llhtimlam/Probton/Media/Presentation/B18 Probton Proposal_1.pptx

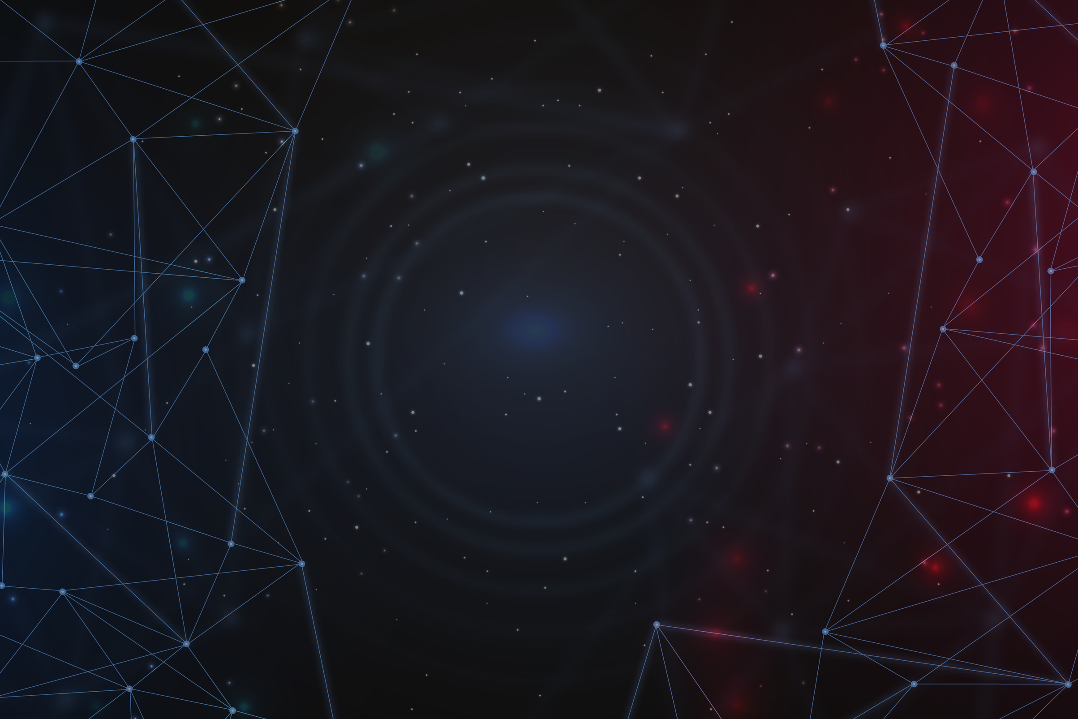
[picture p47: figure]

CHIPATON 2026 TRACK B : CIRCUITS FOR SENSOR

B18: PROBTON

ASIC Solution for Optical Probe Station for Photonic Integrated Circuits Packaging and Testing

- TEAM MEMBERS -

TIM LAM • VICTORIA TJHIN • ABRAAR ALAM
BELKACEM BENADDA • NITIN INDUKURI • REZA SETIABEKTI • ASHMITA SAHA

## Slide 2

INDUSTRY CHALLENGES

70-80% of photonics costs are from packaging, requiring costly proprietary alignment systems

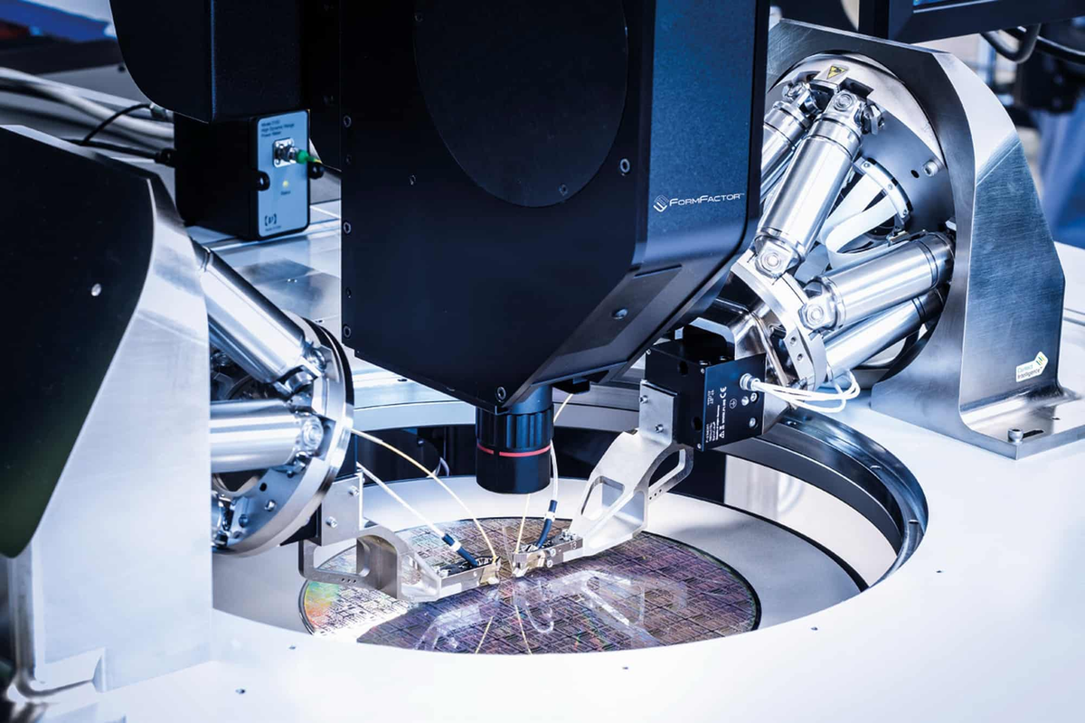
[picture p48: figure]
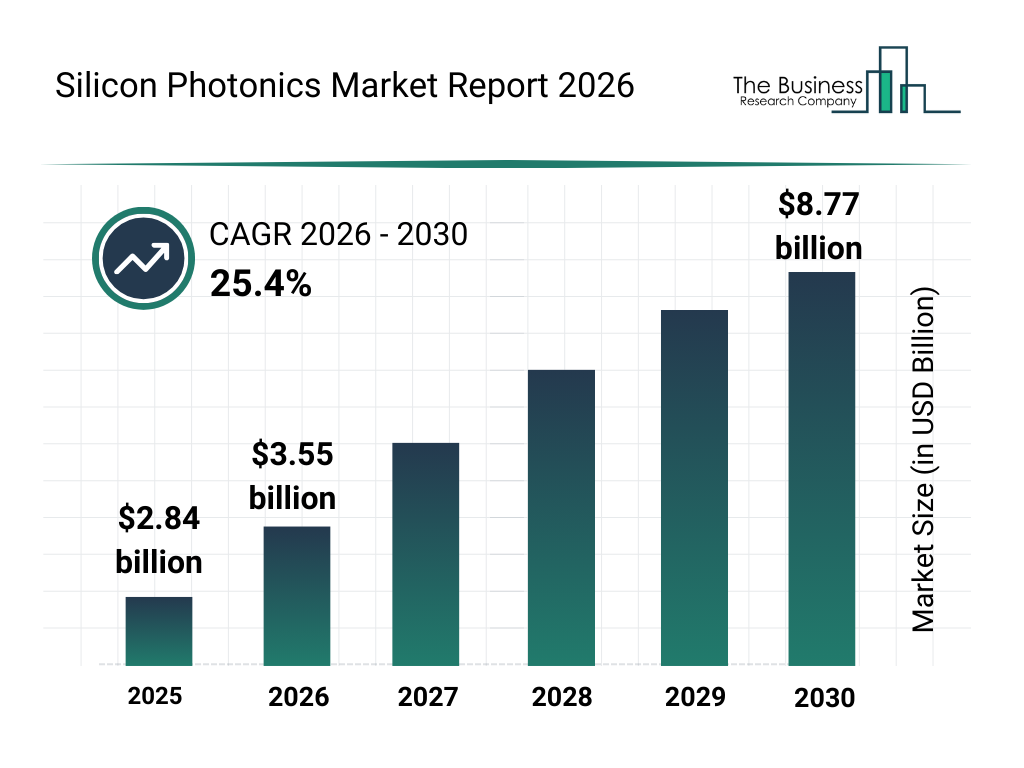
[picture p49: figure]

[2]

[1] L. Ranno et al., “Integrated Photonics Packaging: Challenges and Opportunities,” ACS photonics, vol. 9, no. 11, pp. 3467–3485, Oct. 2022, doi: https://doi.org/10.1021/acsphotonics.2c00891.
[2] The Business Research Company, “Silicon Photonics Market Report 2026,” Jan. 2026. Available: https://www.thebusinessresearchcompany.com/report/silicon-photonics-global-market-report

[1]

Page 2

## Slide 3

VALUE PROPOSITION

Budget build

<$5k

2

Open
source

Custom setup

4

Democratize
proprietary alignment
feedback
systems

1

5.7

<μm

steps to align

precision

3

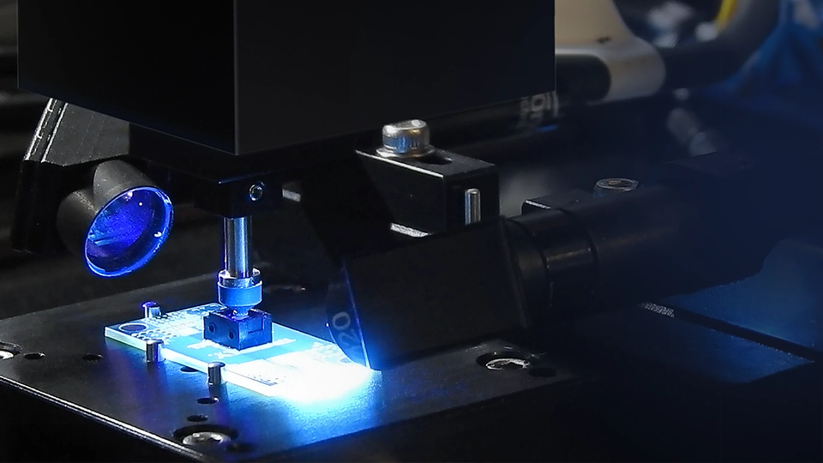
[picture p50: figure]
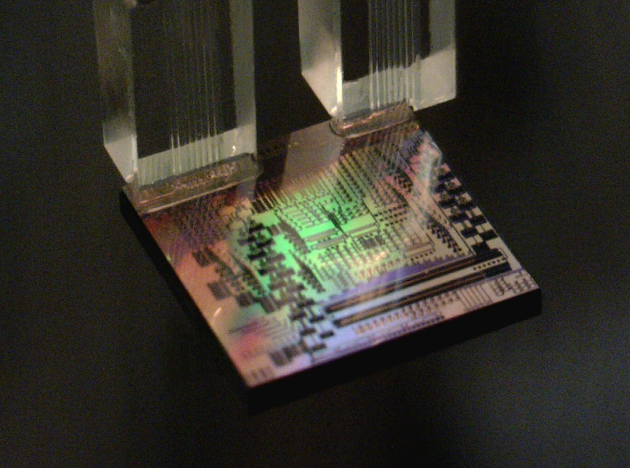
[picture p51: figure]

## Slide 4

SETUP

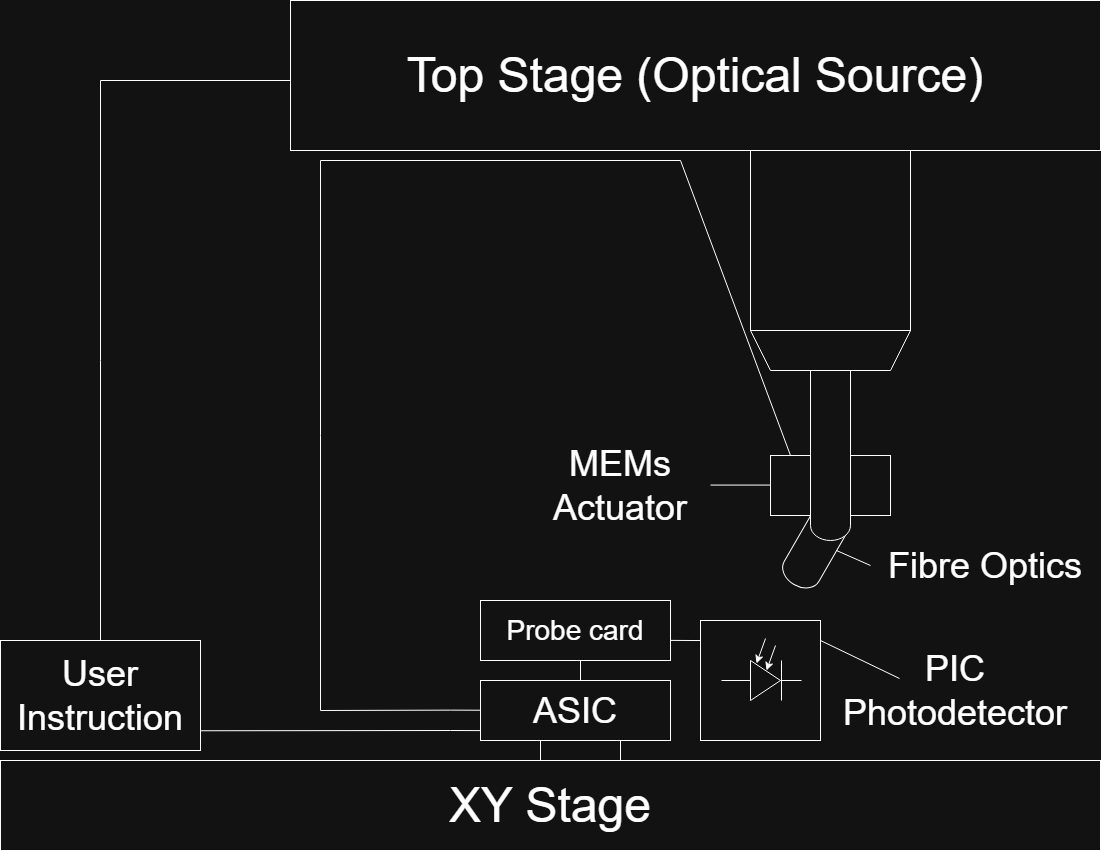
[picture p52: figure]

## Slide 5

TEST SETUP

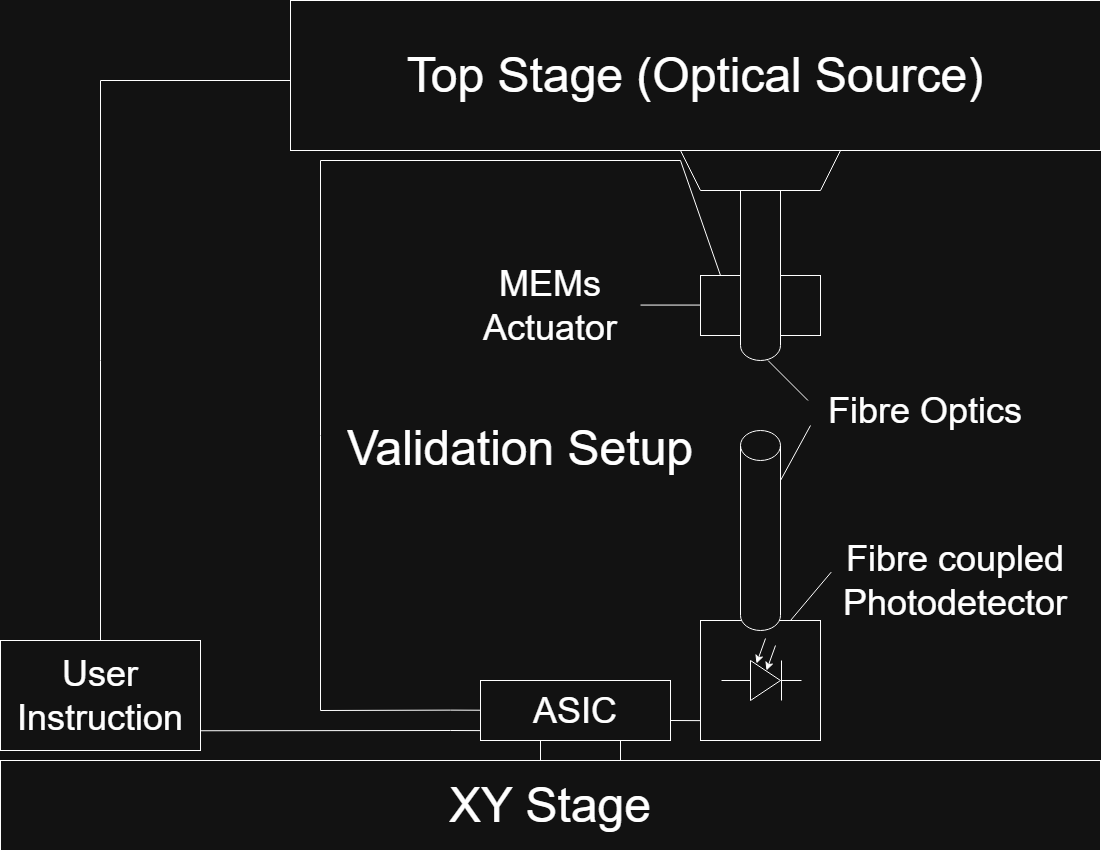
[picture p53: figure]

## Slide 6

INTERFACES

XY-Stage [1]


Link: https://doi.org/10.1016/j.ohx.2022.e00317
Estimated Price: less than $883
Key Specifications:
  - Sensitivity: 25.0 nm/V
  - Resolution:
  - Backlash: 160 – 195 nm
  - Step error: ~ 7%

[3] H.-S. Liao et al., HardwareX, vol. 11, p. e00317, 2022.
[4] W.-M. Wang et al., Nanotechnology, vol. 24, p. 455503, 2013.

Photodetector

Thorlabs FDSP625 Pigtailed Si Photodiode

MEMS
Actuator [2]

Buzzer-Scanner (Wang et al. 2013)


Link:
https://doi.org/10.1088/0957-4484/24/45/455503
Estimated Price: less than $125 (without DAQ)
Key Specifications:
  - XY Range: 5 µm
  - Nonlinearity: 2.11% X / 2.73% Y
  - Noise / Resolution: ~0.06 nm
  - Resonance: ~360 Hz (X/Y)


Link: https://www.thorlabs.com/thorproduct.cfm?partnumber=FDSP625
Estimated Price: $178.32
Key Specifications:
  - Spectral Band: 320 nm to 1000 nm
  - Response Speed: 700 ps rise/fall time
  - Noise: 0.01 nA dark current

## Slide 7

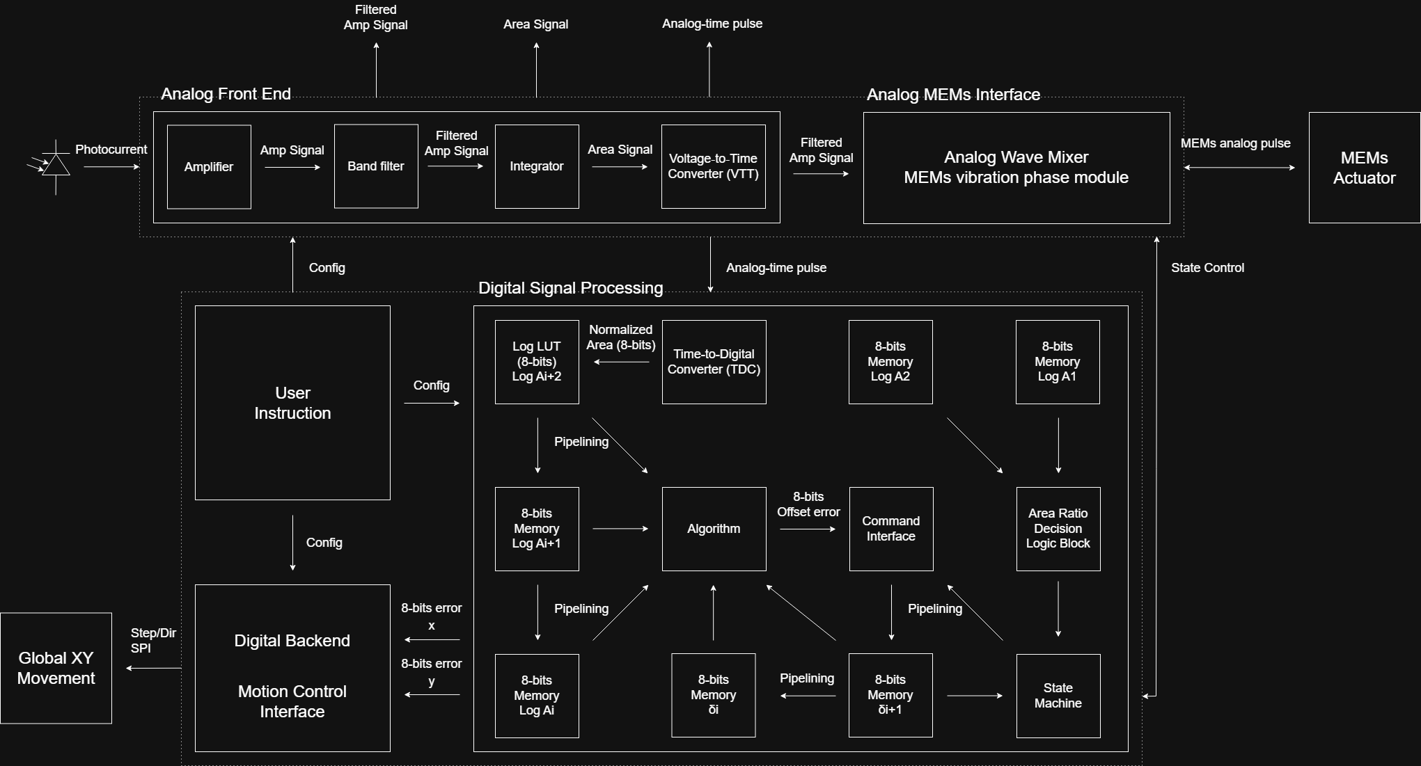
[picture p54: figure]

Pin allocation:
Power:
1. Analog
2. Digital
Input:
1. Photocurrent (analog)
2. User instruction config (digital)
Output:
1. Filtered Amp Signal (analog)
2. Area Signal (analog)
3. Analog-time pulse (analog)
4. Offset direction (digital)
5. Normalized Area (digital)
6. Error x (digital)
7. Error y (digital)
8. Global motion x control (digital)
9. Global motion y control (digital)
10. MEMs control (analog)
11. Analog Wave Mixer (analog)
Total pin count: 15

## Slide 8

ANALOG DOMAIN

AFE & MEMS WAVE MIXER

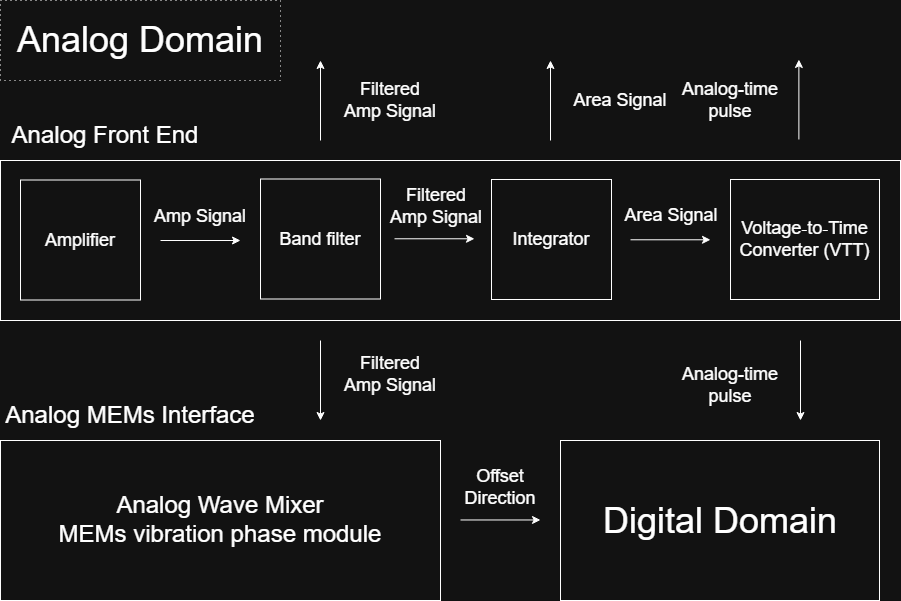
[picture p55: figure]

## Slide 9

DIGITAL
DOMAIN

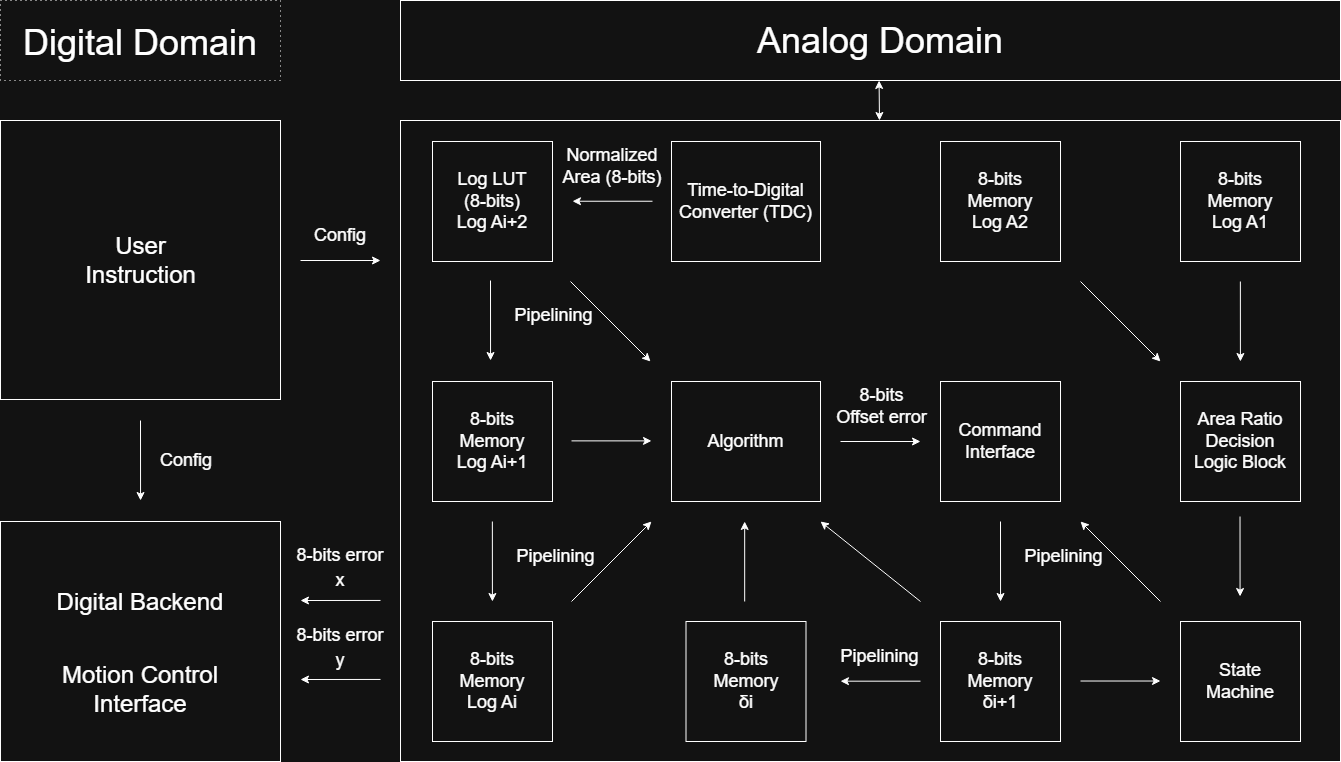
[picture p56: figure]

## Slide 10

SIGNAL PROCESSING ALGORITHM

Three-Point Gaussian Area Method

3-Point Sampling Workflow :
  1. Readout – Boot and sweep
  2. User config movement and sweep
  3. Smart movement and sweep
  4. Iterate until alignment and stop

[5] J. Li, J. D. Valentine, and A. E. Rana, Nucl. Instrum. Methods Phys. Res. A, vol. 422, no. 1–3, pp. 438–443, 1999.


## Slide 11

SIGNAL PROCESSING ALGORITHM

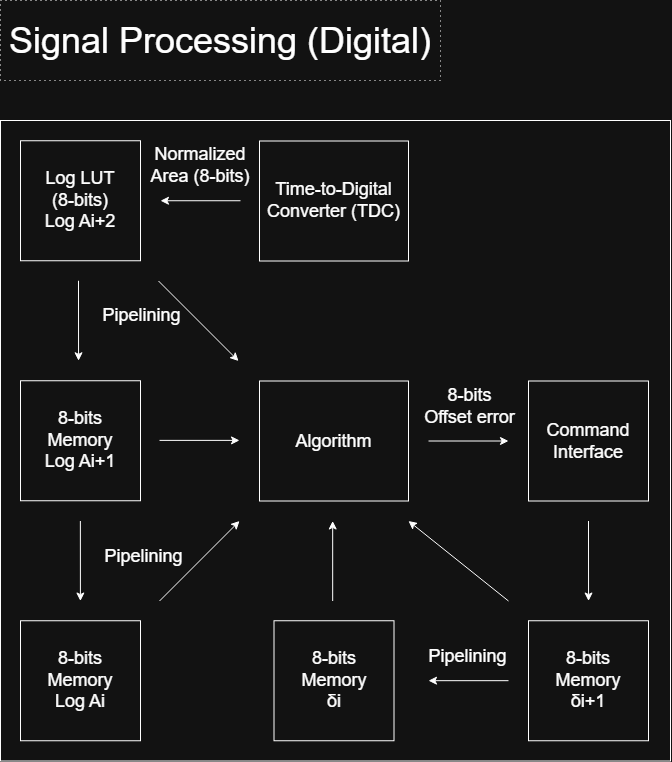
[picture p57: figure]

20K+

## Slide 12

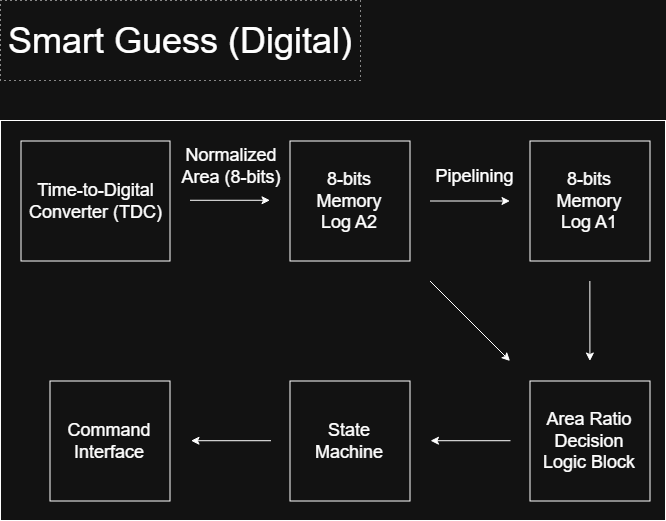
[picture p58: figure]

3-POINT SAMPLING WORKFLOW

  1. Readout – Boot and sweep
  2. User config movement and sweep
  3. Smart movement and sweep
  4. Iterate until alignment and stop

20K+

## Slide 13

SIMULATION RESULTS

Active alignment Tracking for Gaussian Peak. (WIth Errors)

Monte Carlo Simulation

Average Convergence Steps to 1% Transmission loss 5.7 ± 1.1

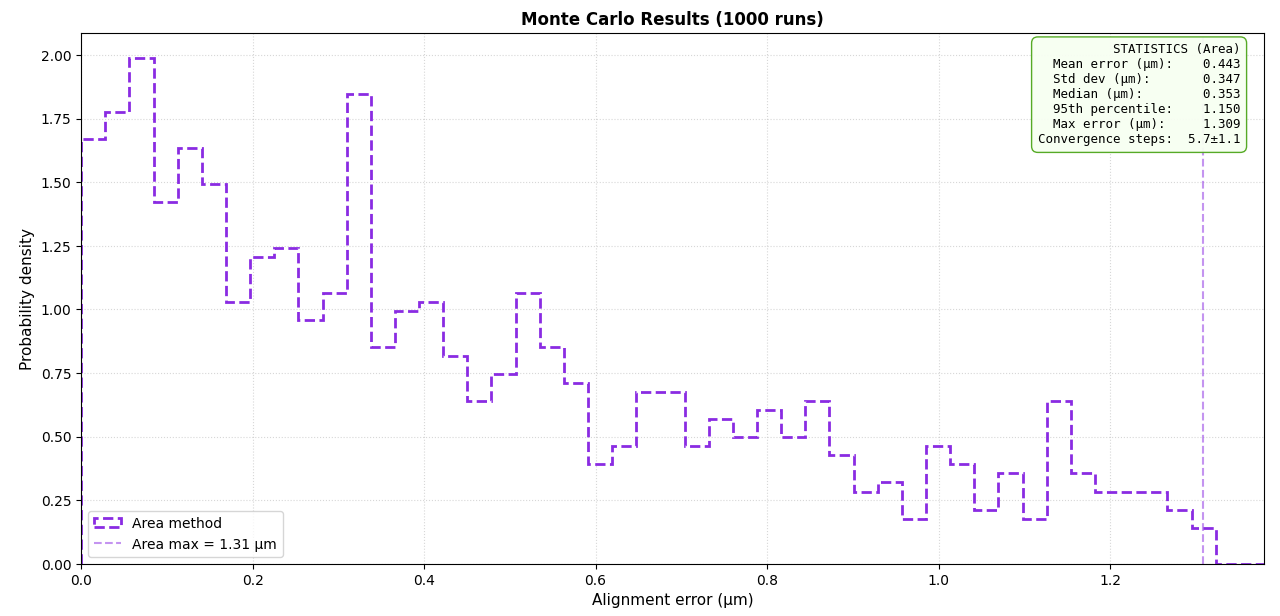
[picture p59: figure]

## Slide 14

OUR TEAM

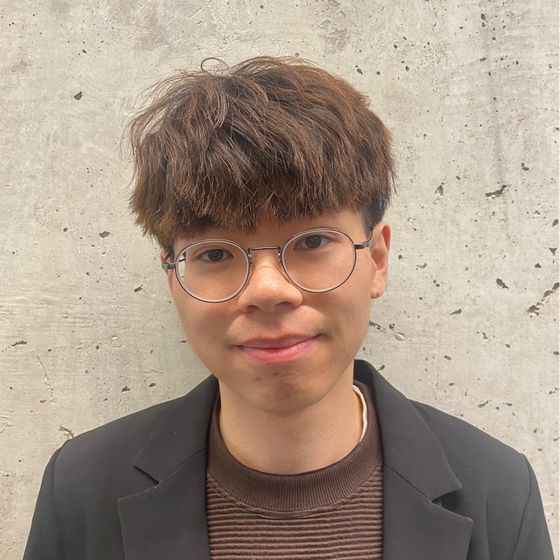
[picture p60: figure]

TIM (TEAM LEAD)
HKUST CHEM (UG)
UW HACKERFAB UWASIC

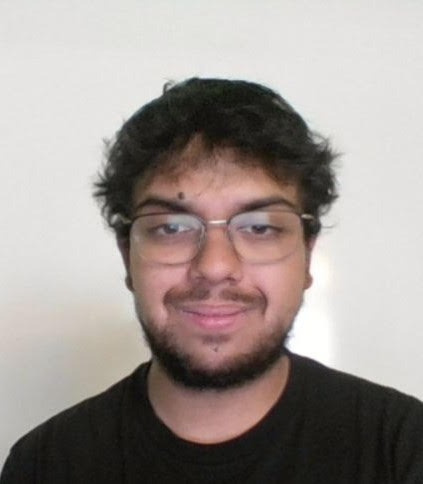
[picture p61: figure]

ABRAAR
TMU CE (UG)
LCRAIN

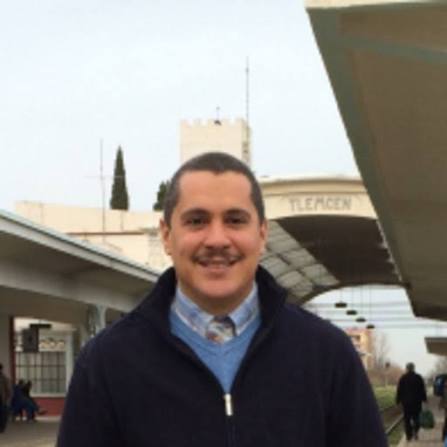
[picture p62: figure]

BELKACEM
UT EE (PHD)
AUTOMATION LAB

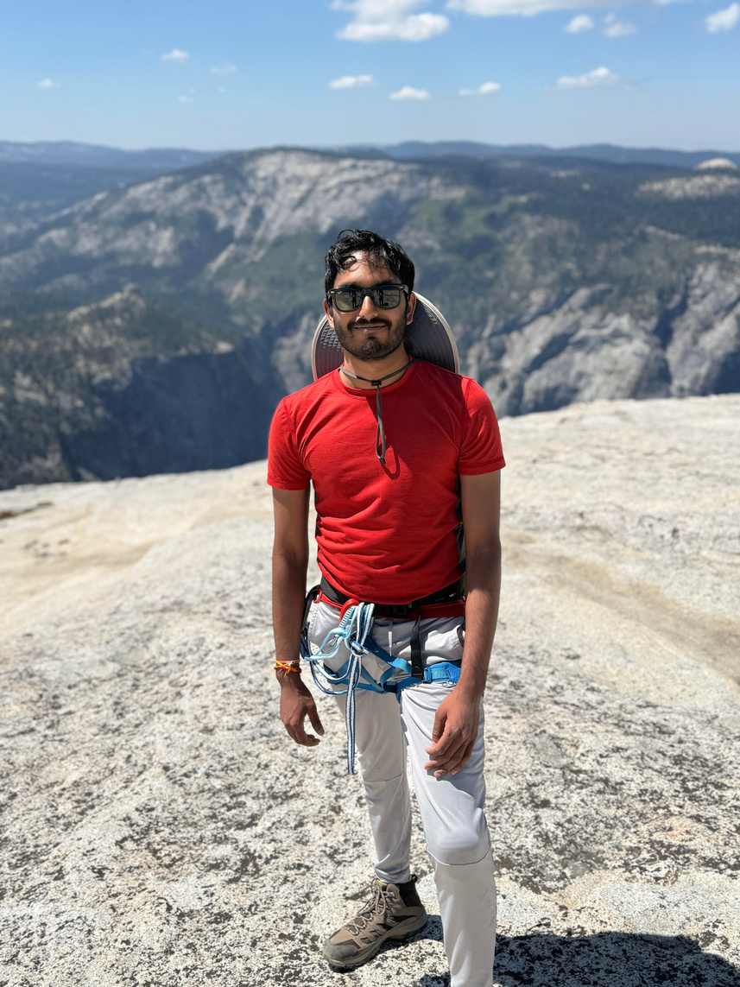
[picture p63: figure]

NITIN
UCSB EE (PG)
MEDIATEK
AMS DESIGN ENGINEER

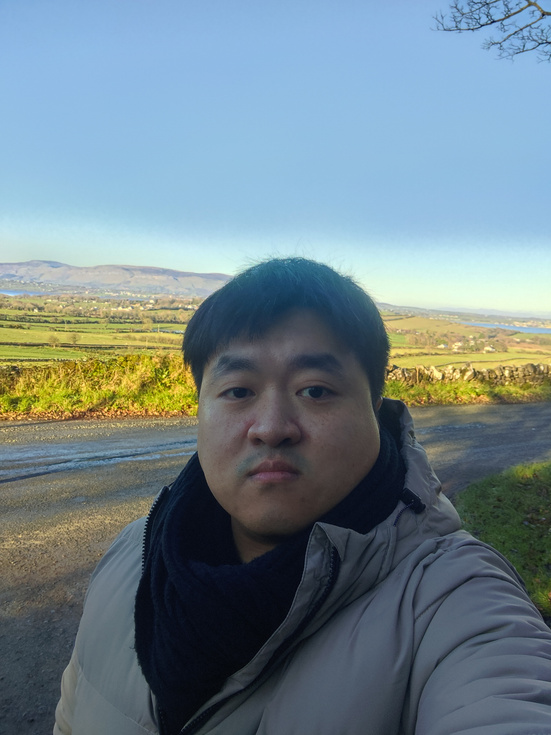
[picture p64: figure]

REZA
UCD ECE
(PG)

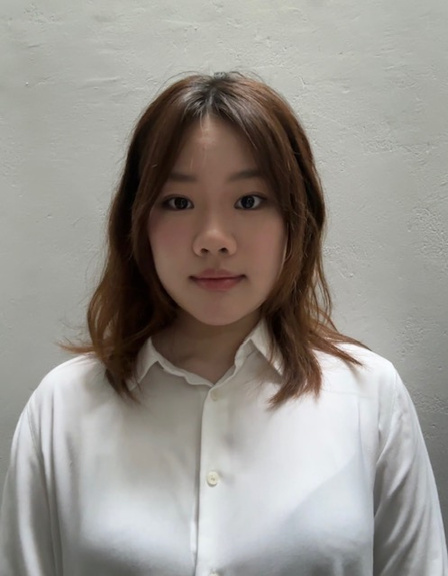
[picture p65: figure]

VICTORIA
UW NE (UG)
IQC URA
UWASIC

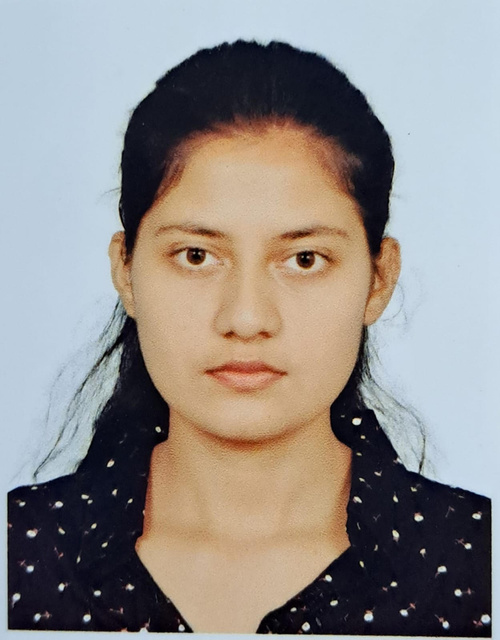
[picture p66: figure]

ASHMITA
UCD ECE
(PG)

PROJECT INFO

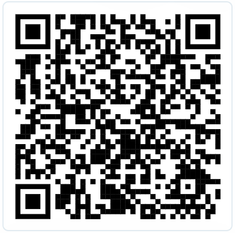
[picture p67: figure]

THANK
YOU
