llhtimlam/Probton/Media/Presentation/B18 Probton Simulation Review_3.pptx

## B18 Probton

Review Date:
July 4, 2024
Review Version:
Schematic Review
Video (not updated): https://youtu.be/nWU8KJn_Hf8

ASIC Solution for Optical Probe Station

Discord name | Affiliation | Experience | Role
timlam0531 | HKUST, Hong Kong | Hobbyist | Team lead
abraaaar | Toronto Metropolitan University, Toronto | Undergraduate student | Team member
belkacem | University of Tlemcen, Algeria | PhD | Team member
nitin_i | University of California, Santa Barbara | AMS Design Engineer | Team member
rezasetiabekti8375 | University College Dublin, Ireland | Master student | Team member
ashmita1509 | University College Dublin, Ireland | Master student | Team member
vik_lyn_ | University of Waterloo | Undergraduate student | Team member
anna_b75_06065 | None | Hobbyist | Team member
CadMiuM#9906 | HKUST, Hong Kong | Undergraduate student | Team member
Looking for members | | | Mixed Signal

## Slide 2

Design Objective:

Extract alignment direction using voting filter while automatically isolating and discarding corrupt signal data.

Intended use:
Deliver low-latency direction indicators and signal intensity data to drive motorized alignment hardware.

XY-Stage [1]


Photodetector

Thorlabs FDSP625 Pigtailed Si Photodiode

Photodetector

Thorlabs FDSP625 Pigtailed Si Photodiode

Link: https://www.thorlabs.com/thorproduct.cfm?partnumber=FDSP625
Key Specifications:
  - Spectral Band: 320 nm to 1000 nm
  - Response Speed: 700 ps rise/fall time
  - Noise: 0.01 nA dark current

MEMS
Actuator [2]

Buzzer-Scanner (Wang et al. 2013)


Link: https://doi.org/10.1016/j.ohx.2022.e00317
Key Specifications:
  - Sensitivity: 25.0 nm/V
  - Resolution:
  - Backlash: 160 – 195 nm
  - Step error: ~ 7%

Link:
https://doi.org/10.1088/0957-4484/24/45/455503
Key Specifications:
  - XY Range: 5 µm
  - Nonlinearity: 2.11% X / 2.73% Y
  - Noise / Resolution: ~0.06 nm
  - Resonance: ~360 Hz (X/Y)

## Slide 3

Design Specification

1. 5MHz clock speed
2. Raw readout: 700ps rise fall time, 1 μA - 40 μA, 3.5pF
3. Allowed MEMS frequency : 2.38 Hz ~ 156.24761 kHz 16 bit Frequency Control Word 21 bit Phase Accumulator
4. Low Frequency Filter ~160 kHz
5. Mems_drv compatible to control External MEMS DAC Driver (±10V Triangular Wave)
6. Wave mixer and comparator able to operate at 1.65V midrail to isolate sign of dc_offset for directional identification
7. System is able to identify real signal from noise and jittering is minimize during idle and calibration

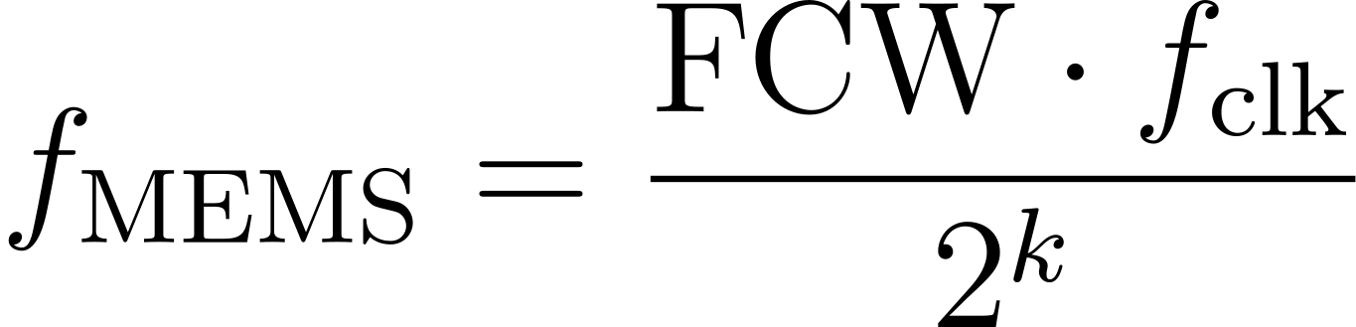
[picture p68: figure]
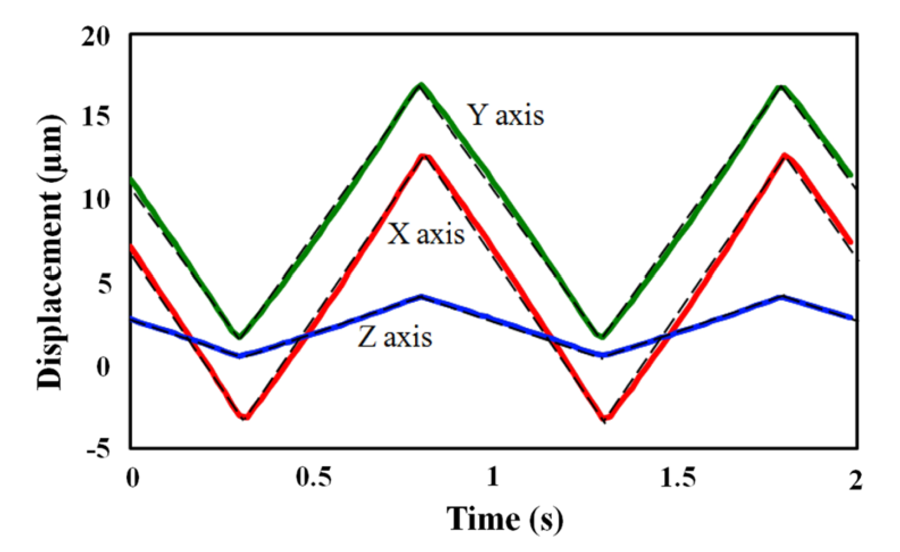
[picture p69: figure]

## Slide 4

Decision - Simplify and Reduce to core function

Based on Proposal Review Feedback
1. Skip unnecessary signal processing component that enhance accuracy of prediction Removed: Integrator, Voltage to Time Converter, Time to Digital Converter
2. Report Wave Mixer Error as raw analog output for user reading
3. Remove XY Motion Control Interface
4. Extract and report low latency direction information as compass to alignment center based on dither motion
5. Simplify Digital Signal Processing to simple voting filter to discard false signal and remove 3-point Gaussian Area Algorithm

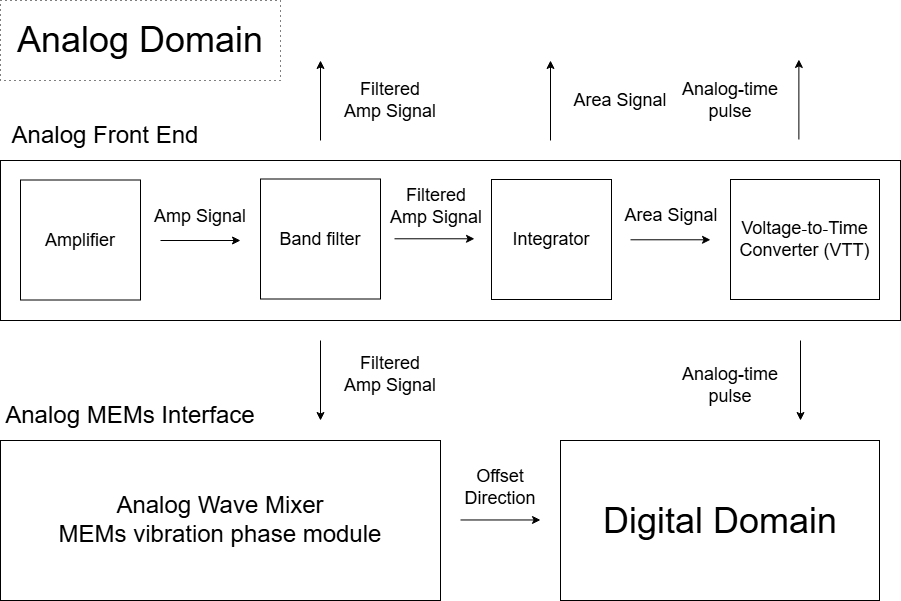
[picture p70: figure]
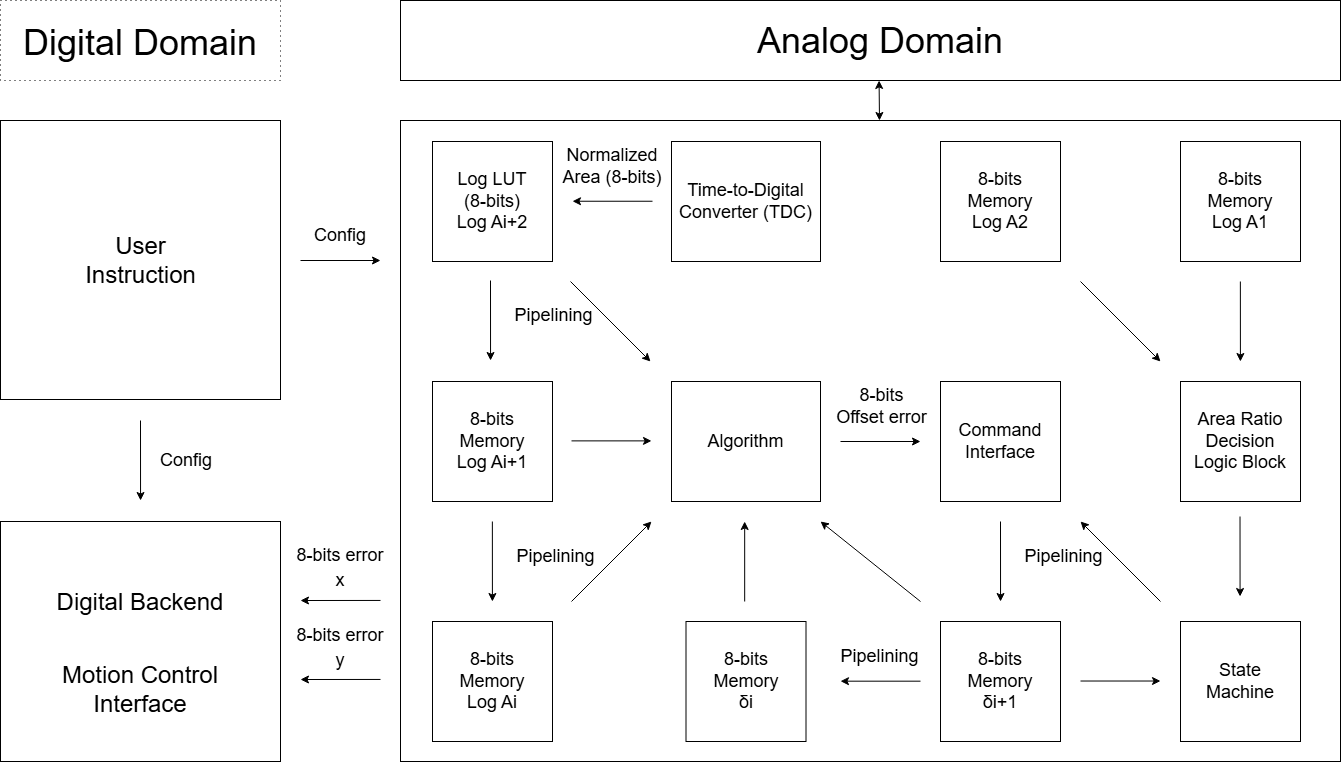
[picture p71: figure]

## Slide 5

System Overview - Block Diagram and Pin count

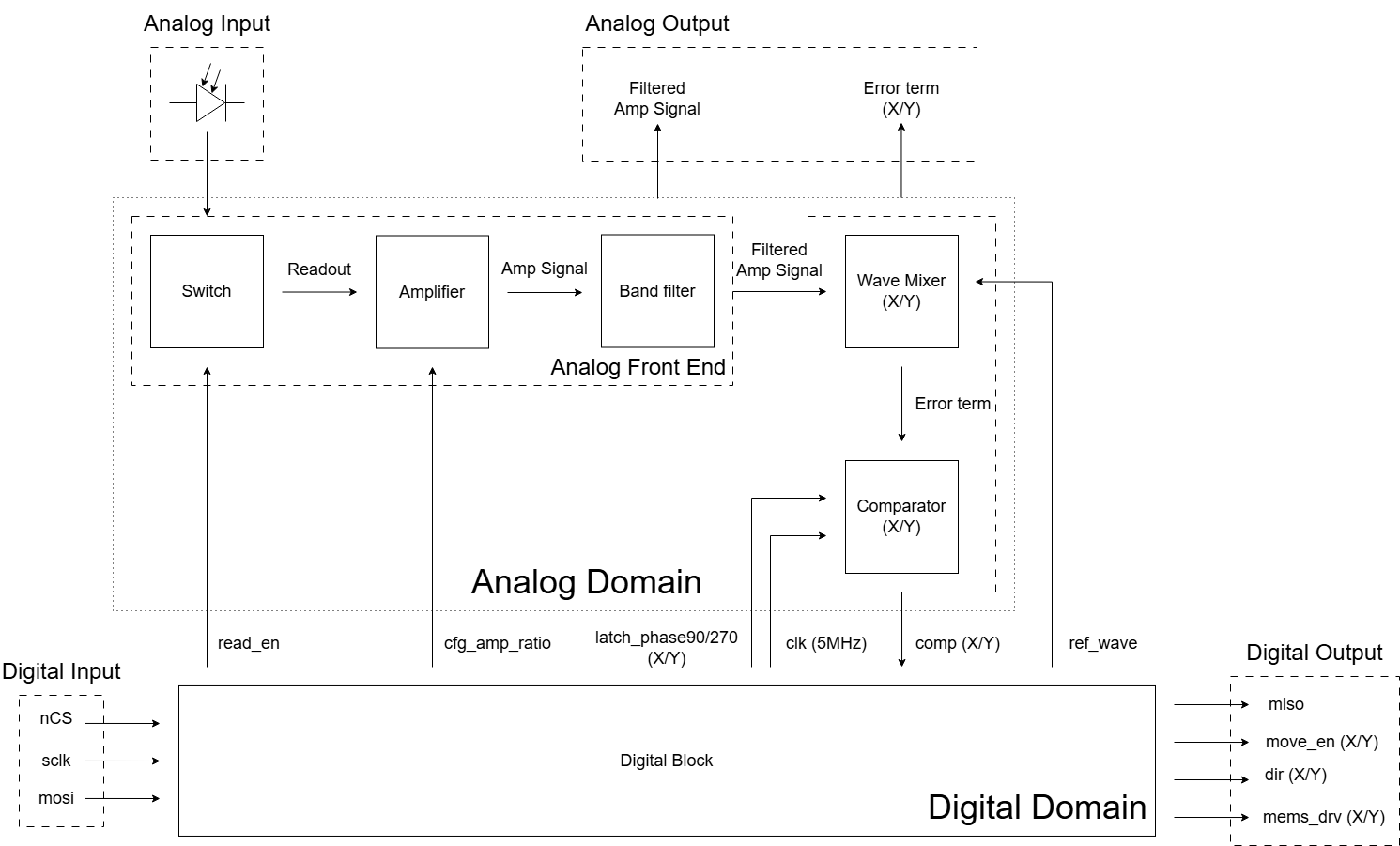
[picture p72: figure]

State Control Mixed Signal System
Pin count (14)
Analog pin for readout (4)

SPI (4)
Custom Config,
User Command,
Status Report

Low latency feedback (4)
move_en
dir

ΔΣ Modulated Digital Wave (2)
mems_drv

## Slide 6

System Overview - State Machine

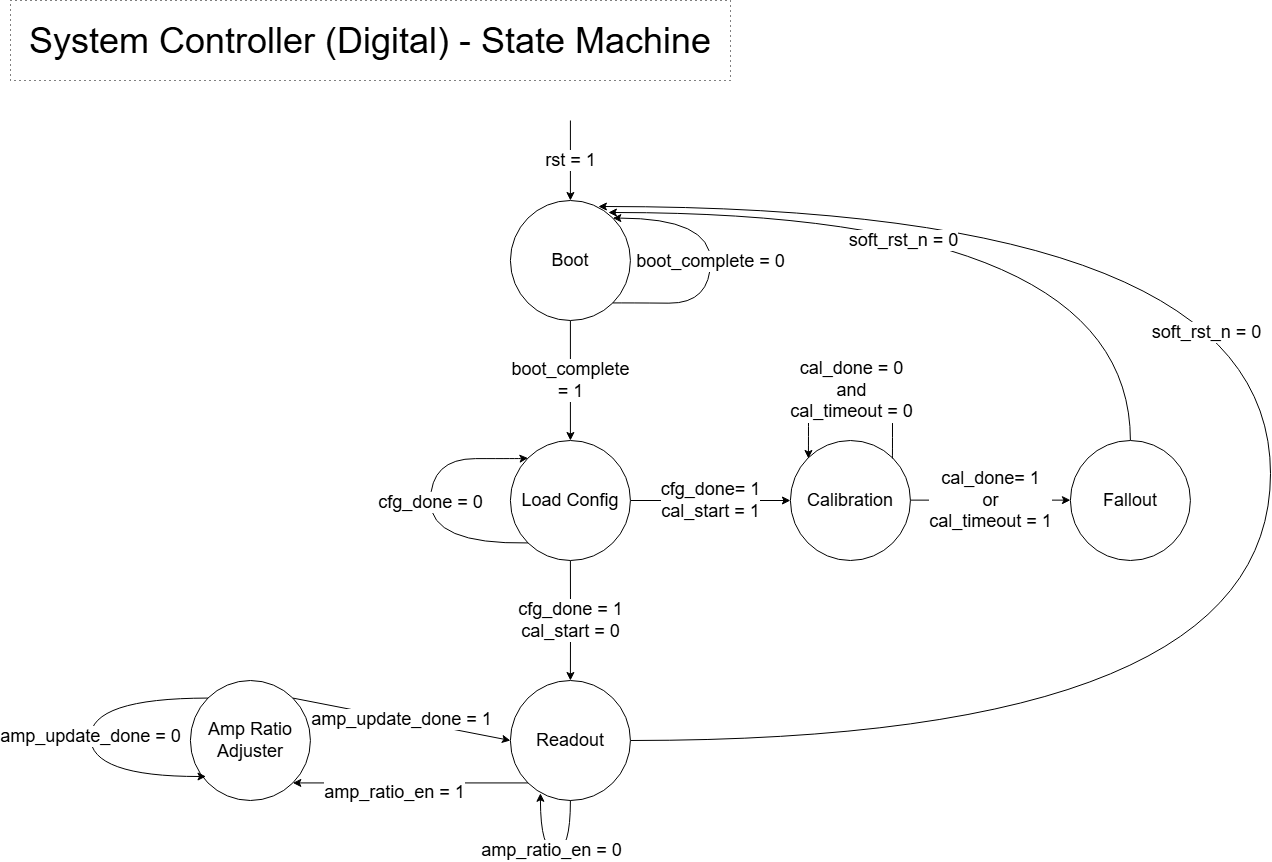
[picture p73: figure]

1. Boot
2. Load Config
3. Calibration (Optional)
4. Fallout (Optional)
5. Readout
6. Change Amp Ratio

After Load Config
Split to
1. Calibration
(missing phase_offset from SPI import)
Enter Fallout after calibration
Reboot system and load phase_offset data
2. Readout

## Slide 7

System Overview - RTL Traffic

1. Readout
2. Dynamic Comparator
3. Wave controller 1. Wave generation (Driver/Reference Wave) - Sigma Delta Modulated 2. Calibration (Optional) 3. Latch pulse (90°/270°)
4. Signal processor Output move_en, dir

Intermediate RTL for SPI and handshake
High: 3.3V Low: 0V
Minimize Digital-Analog Crossing to avoid switching noise and complexity

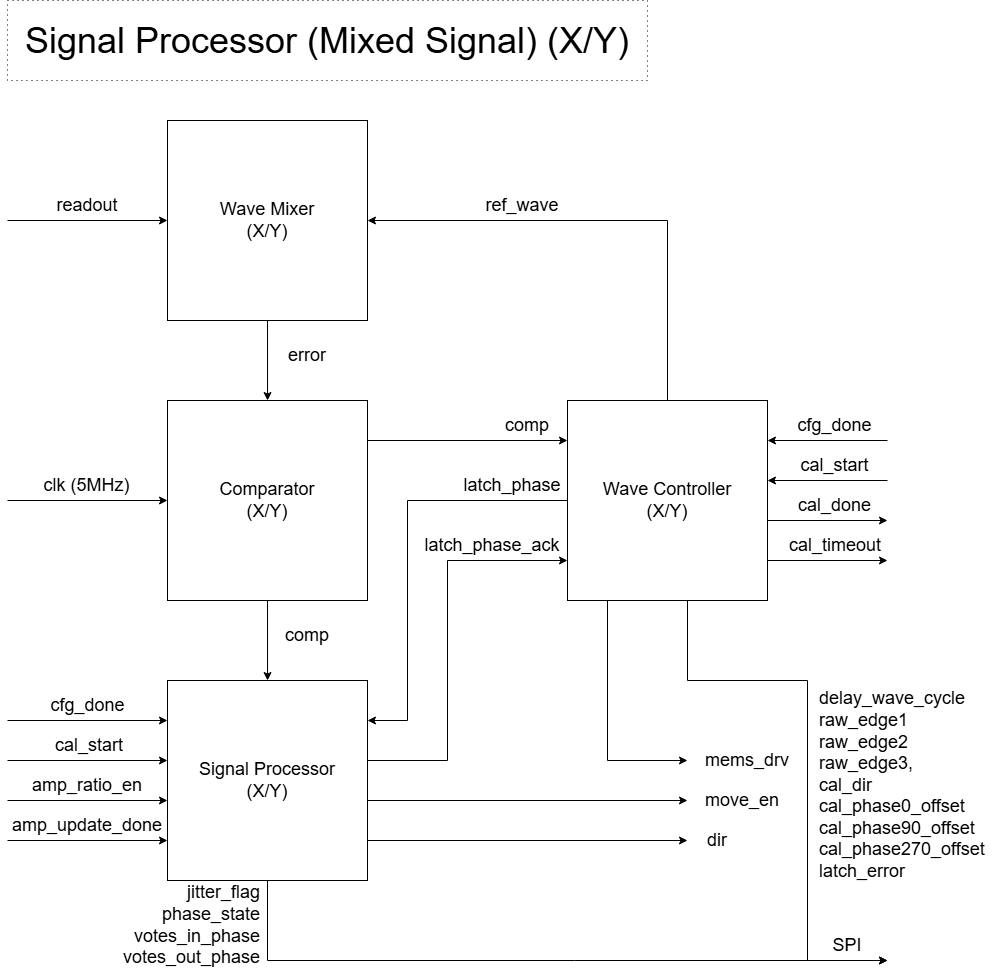
[picture p74: figure]

## Slide 8

System Overview - Signal Processor

1. Comparator set to baseline 1.65V midrail as dc_offset = 0 from wave mixer error output.
2. Comparator goes through rs latch and inverter to store its value, ready for digital domain to retrieve.
3. Data is accessed and latch every 90°/270° calibrated phase delay.
4. Data is filtered through 16 sample voting to reject noise and jitter, latch for low latency output

In-phase: High on 0° - 180°, Low on 180° - 360°
Out-of-phase: Low on 0° - 180°, High on 180° - 360°
90° and 270° are the most stable point for latching and parsing comparator output

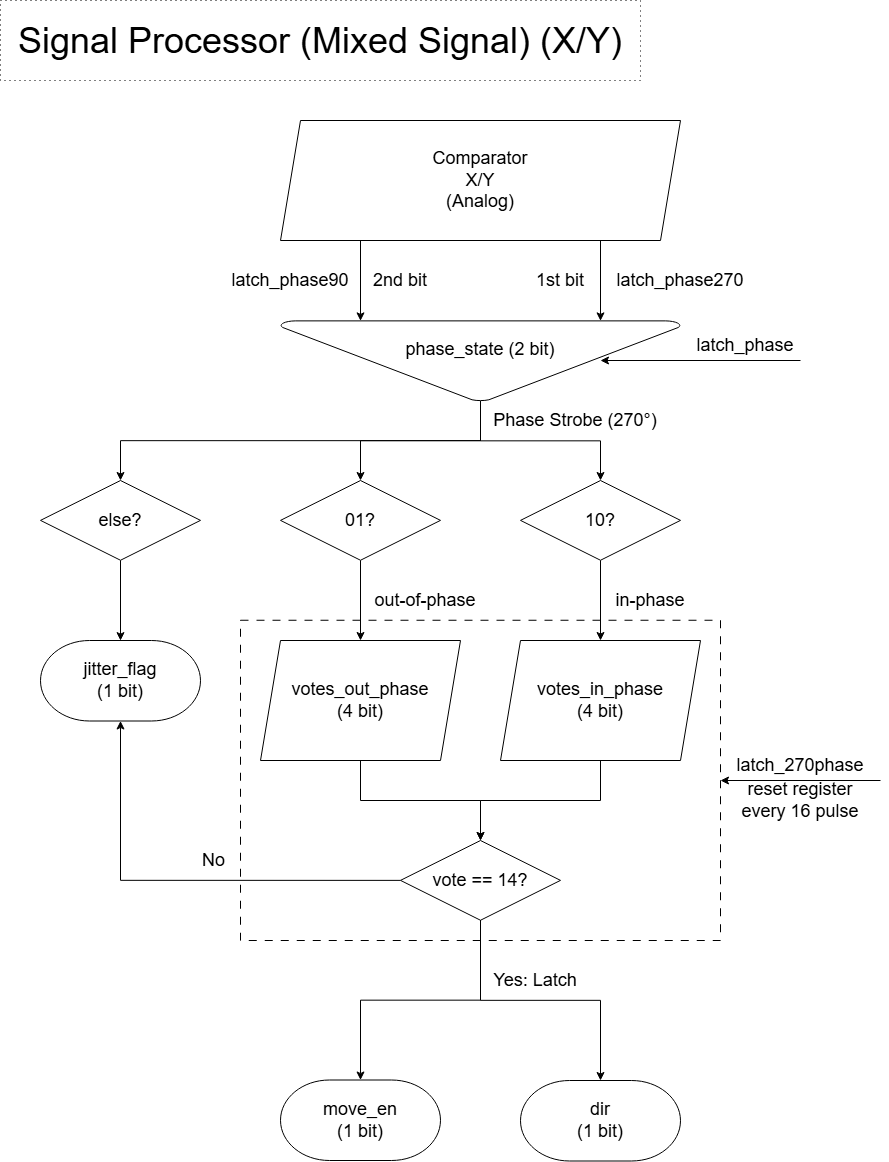
[picture p75: figure]

## Slide 9

RTL Traffic - Analog Domain

1. Readout
(180μm x 100μm)

2. Wave Mixer (X/Y)
(39.30μm x 55.99μm)

3. Comparator (X/Y)
(67.39μm x 53.38μm)

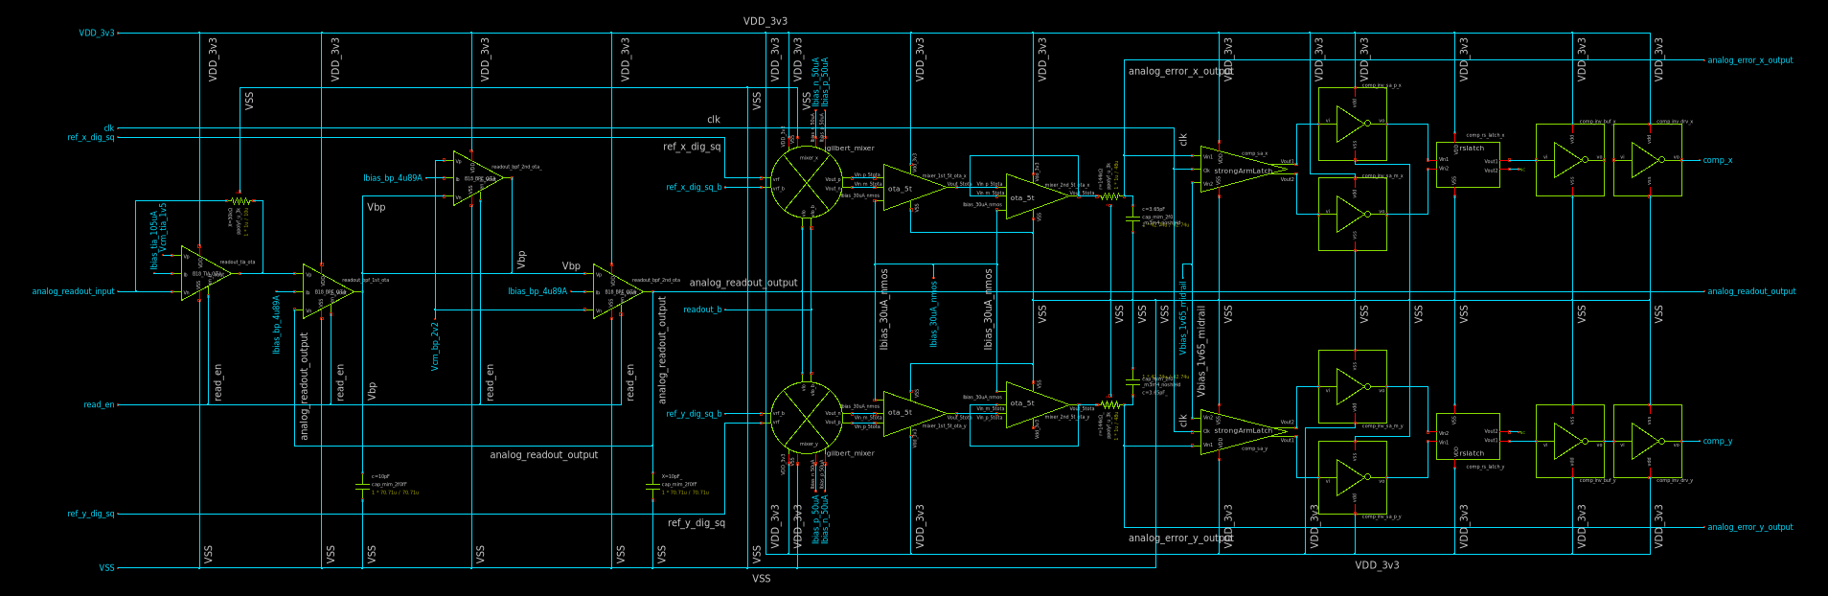
[picture p76: figure]

## Slide 10

RTL Traffic - Analog Front End

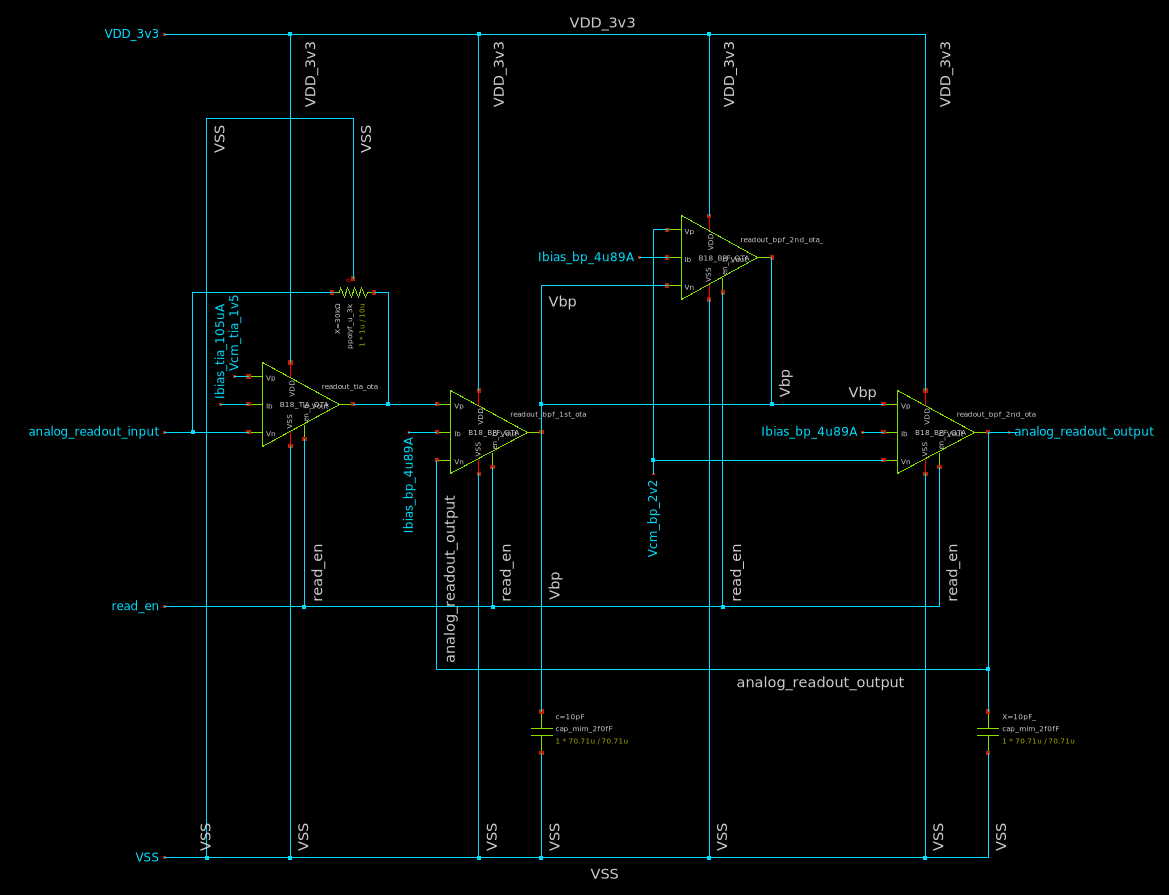
[picture p77: figure]

Schematic Completed
Layout still WiP
Reserved Area
(180μm x 100μm)
1. Readout input (South Center)
2. Transimpedance Amplifier
3. Band Pass Filter
4. Readout output (South Center)
Split to Wave Mixer (X/Y)
In symmetry

## Analog Front End - Transimpedance Amplifier

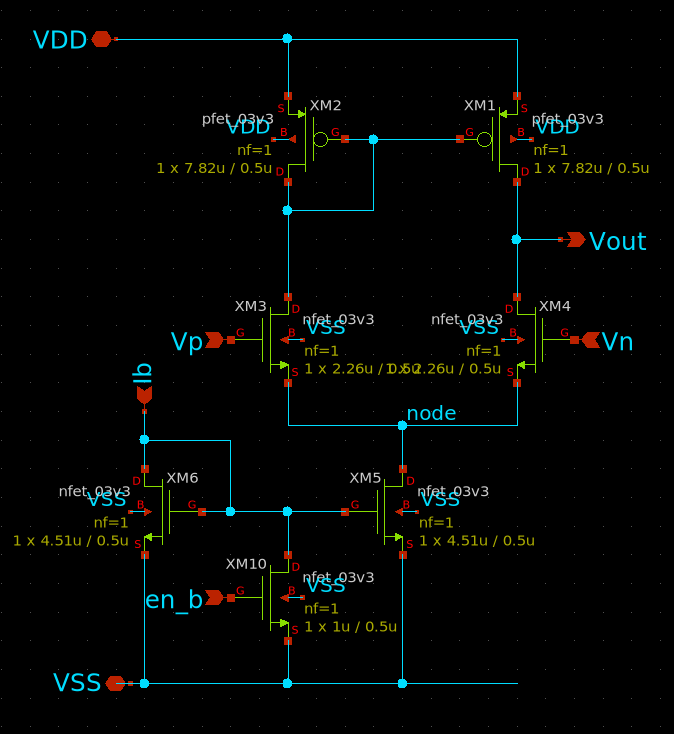
[picture p78: figure]

Active Low Enable signal disables current mirror and rest of amplifier, to be controlled by digital signal until config is complete,

## Analog Front End - Transimpedance Amplifier

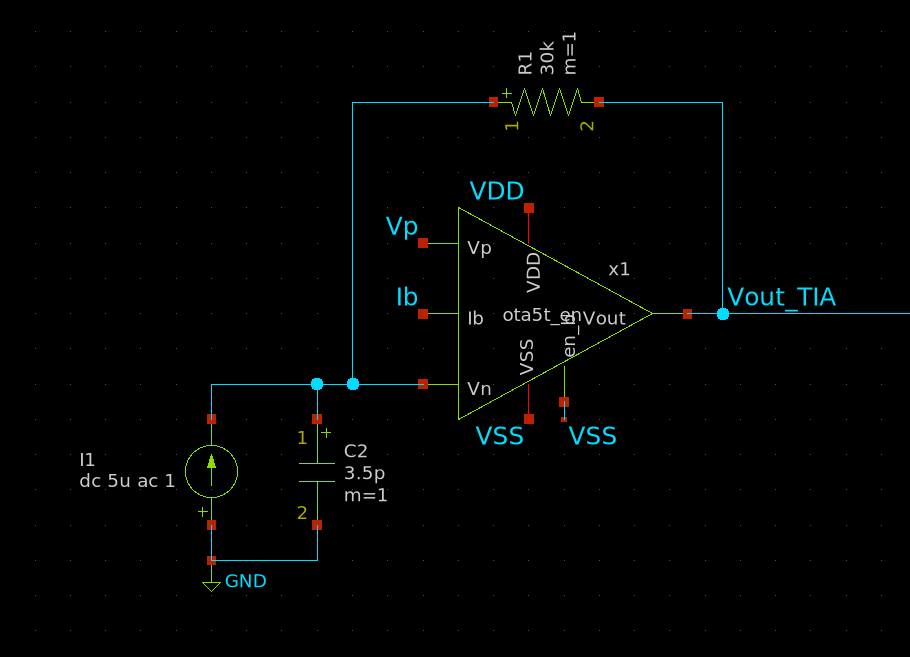
[picture p79: figure]

Transient Simulation @156kHz
IIN: 40uA DC, 4uA amplitude
VOUT = 1.47V DC, 0.11V Vpp

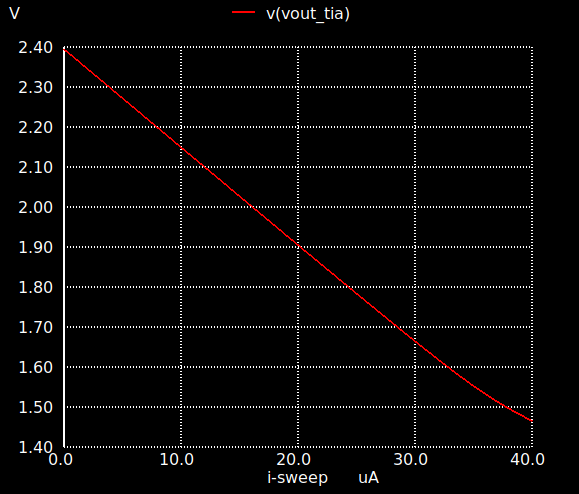
[picture p80: figure]

DC photodetector current sweep
1uA-40uA linear response

Gain

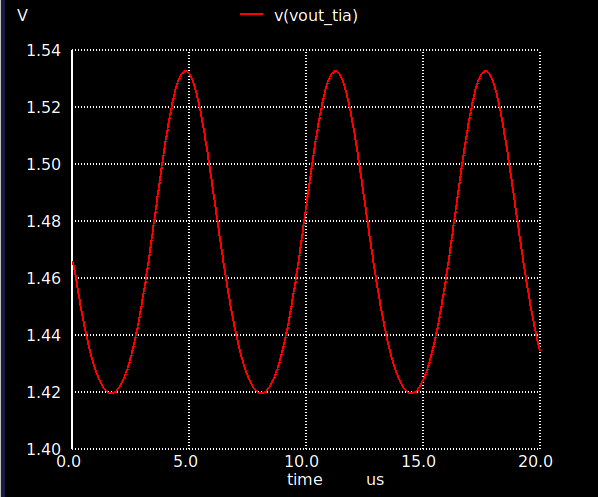
[picture p81: figure]
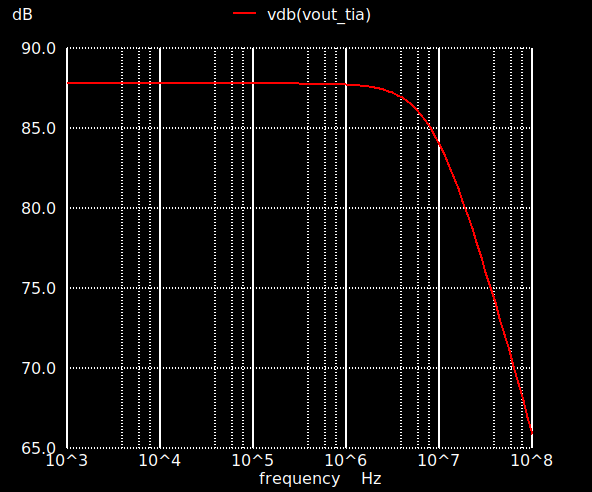
[picture p82: figure]

Open Loop
1 Hz ~ 10MHz
Well covering target specs

## Analog Front End - Two Integrator Loop Gm-C BP + LP Filter

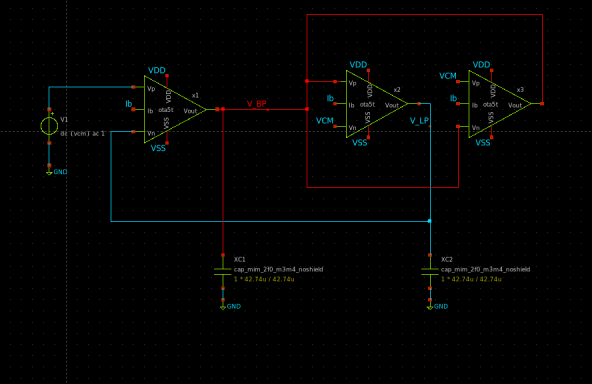
[picture p83: figure]
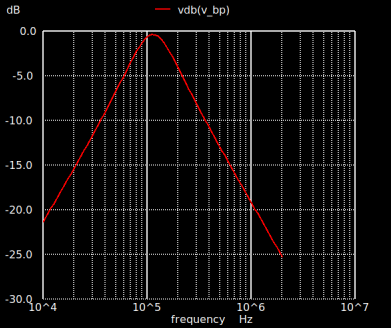
[picture p84: figure]

Designed for 156 kHz
Tunable for each allowed MEMS frequency
2 Hz ~ 156kHz

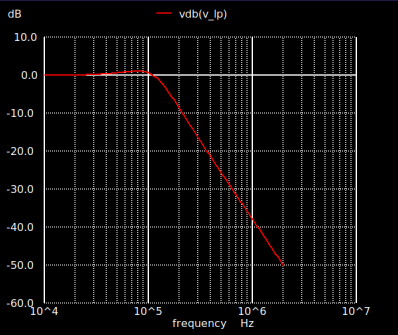
[picture p85: figure]

## Analog Front End - Testbench of TIA + Bandpass Filter

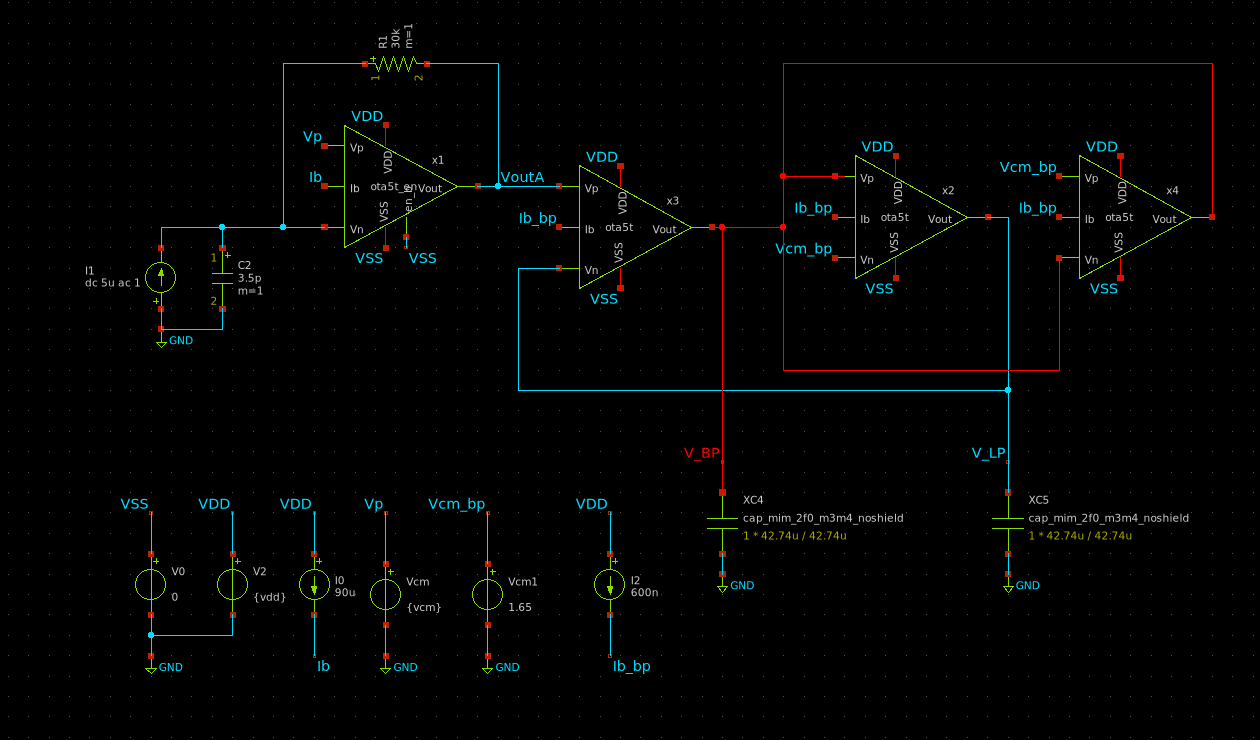
[picture p86: figure]

## Analog Front End - TIA + Bandpass Testbench

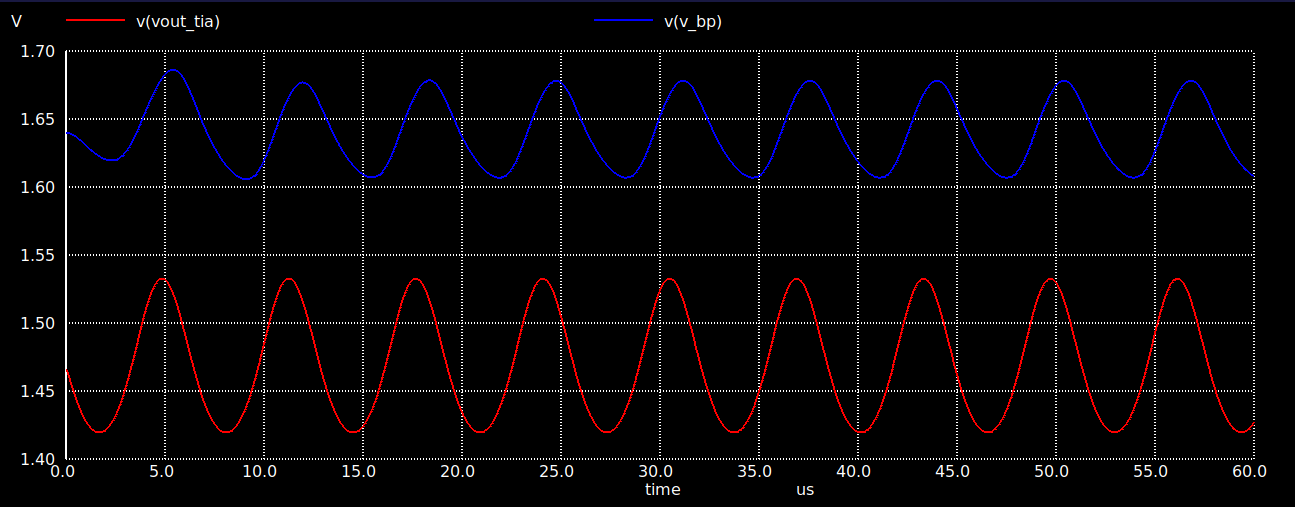
[picture p87: figure]

Photodetector Sample Input:
- 40uA DC
- 4u amplitude
156kHz frequency vs 1MHz shows filtering, though output swing could be improved

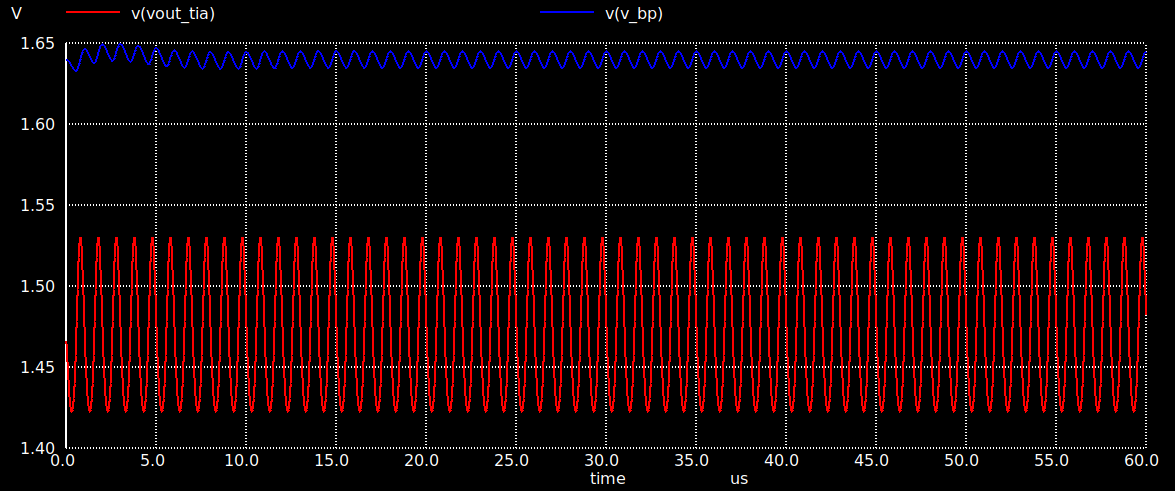
[picture p88: figure]

## Slide 16

Readout
Oscillation

X: 300Hz
Y: 400Hz

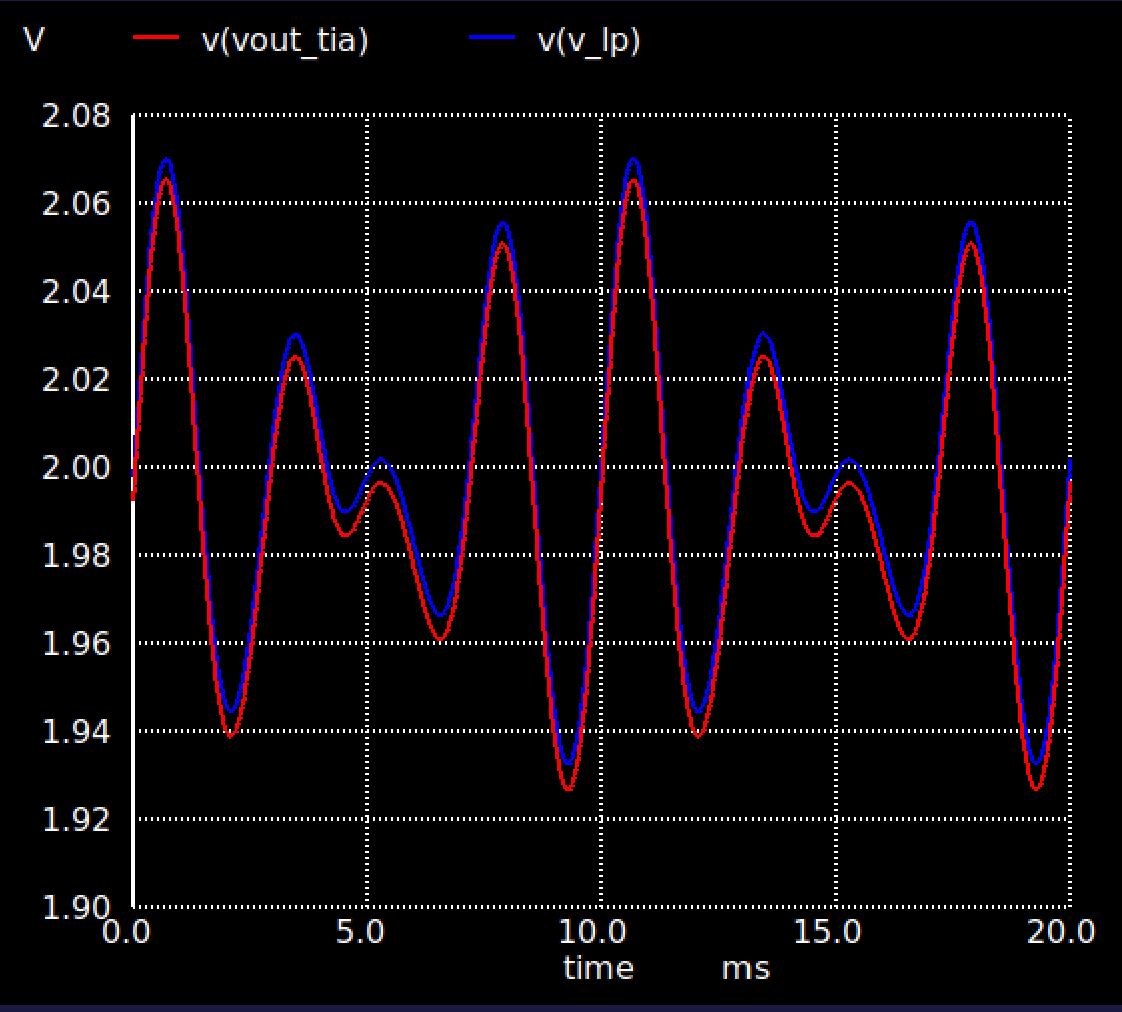
[picture p89: figure]

Analog Front End - Full Simulation

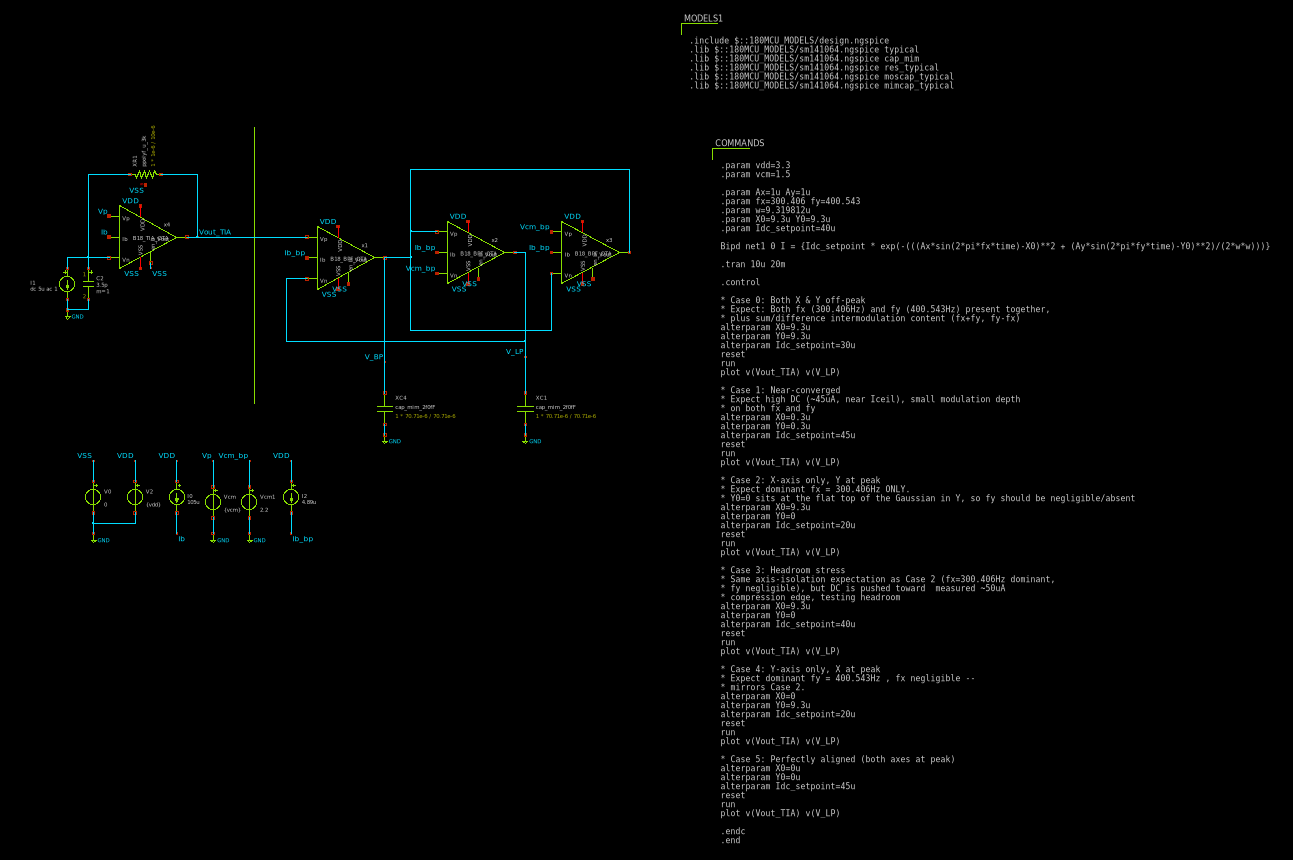
[picture p90: figure]

TIA

Band Pass Filter

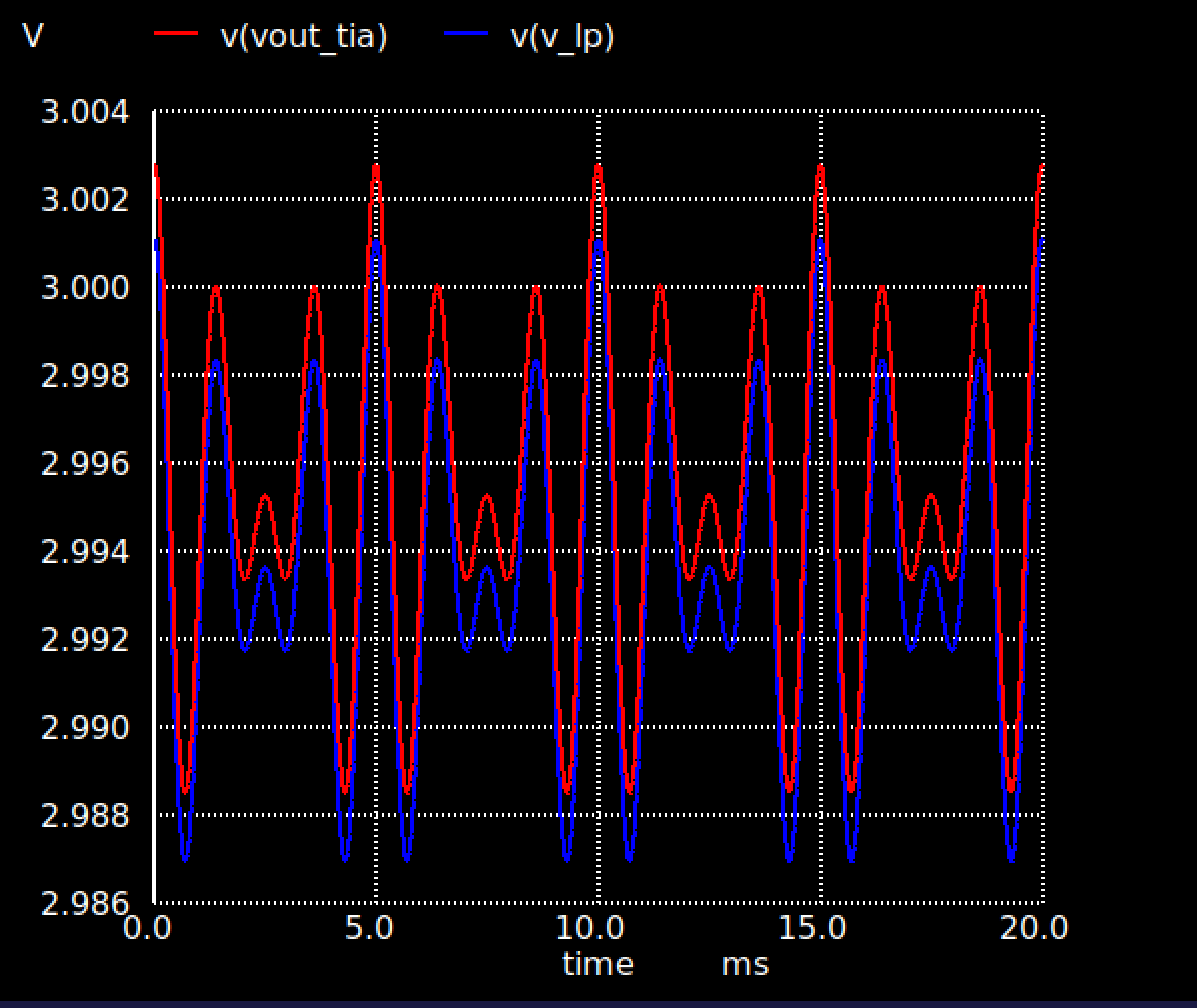
[picture p91: figure]

Band Pass
Filter

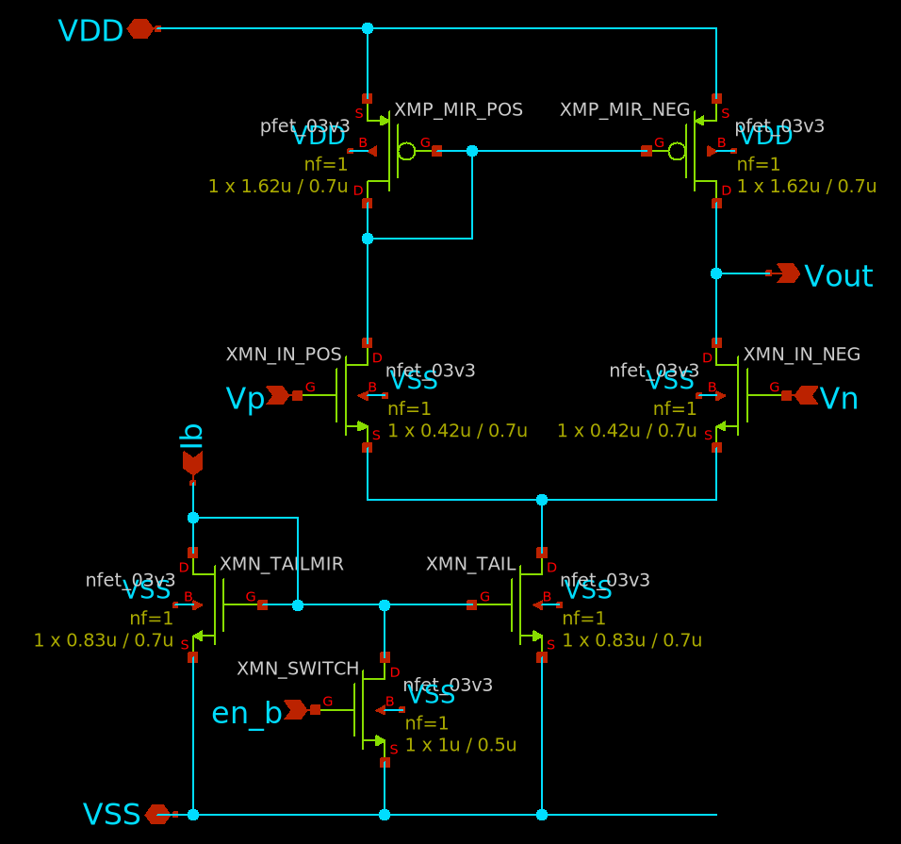
[picture p92: figure]
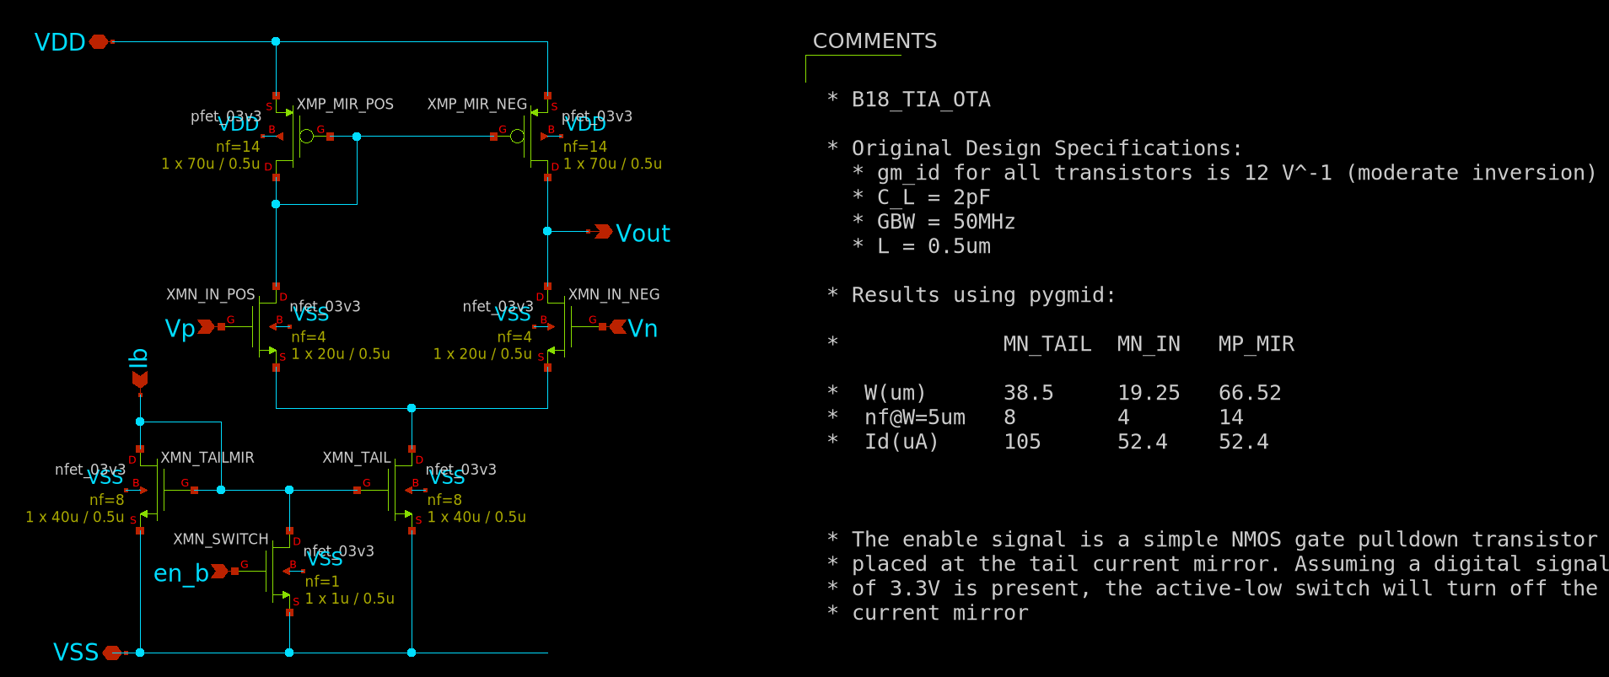
[picture p93: figure]
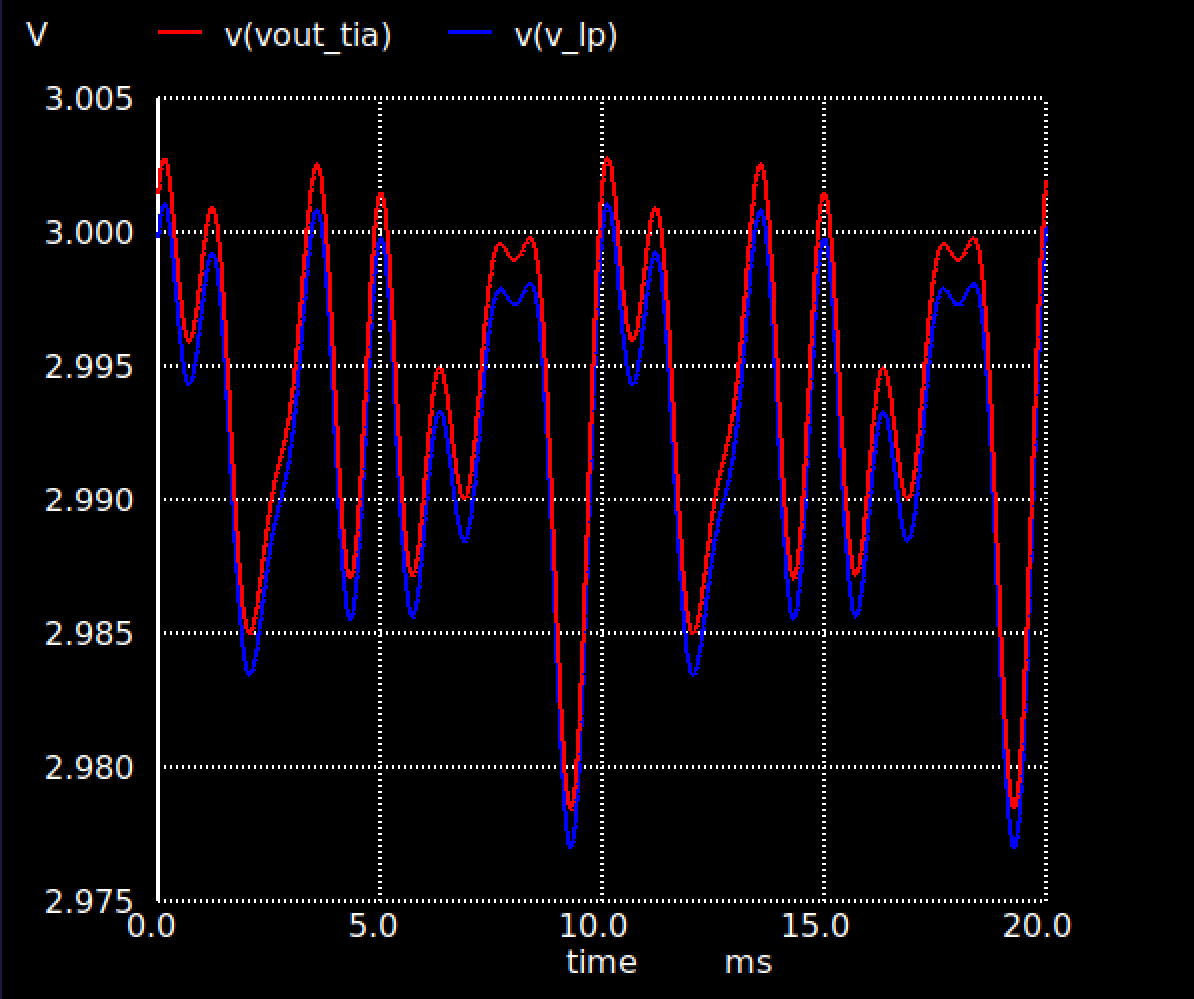
[picture p94: figure]

## Slide 17

RTL Traffic - Wave Mixer & Comparator

Gilbert Cell → 2x 5T OTA → RC Filter → StrongArm Comparator → Inverter x2 → RS Latch → 2x Inverter

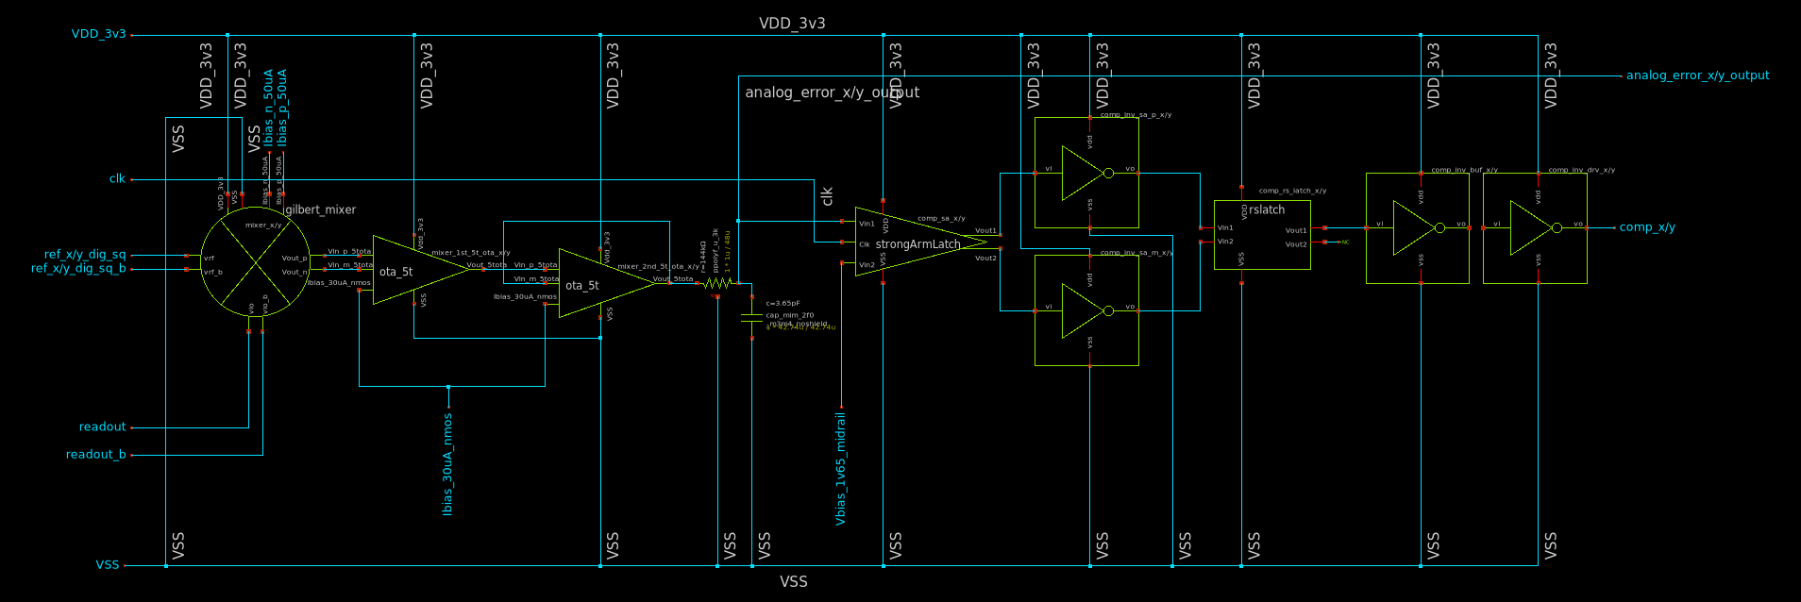
[picture p95: figure]

## Slide 18


## Mixer Schematic

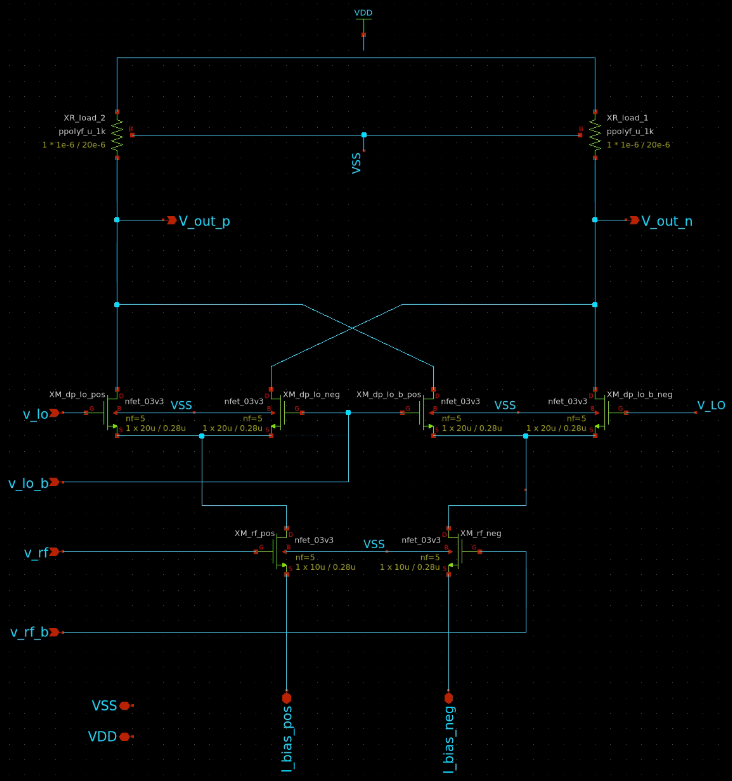
[picture p96: figure]

- Standard gilbert cell mixer to the left and 5t ota to the bottom
- 5t ota buffer is needed to convert to single ended and add some gain

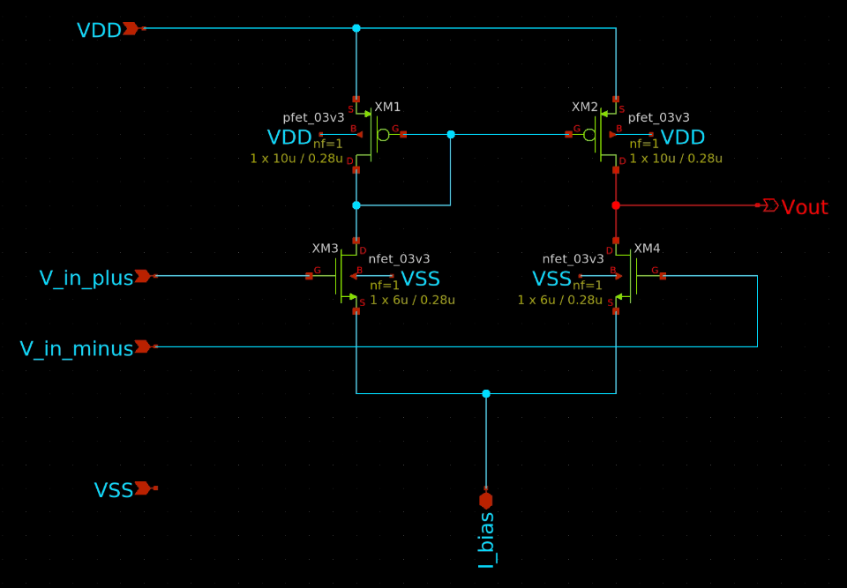
[picture p97: figure]

5t OTA, current mirror attached to i_bias

## Mixer Testbench

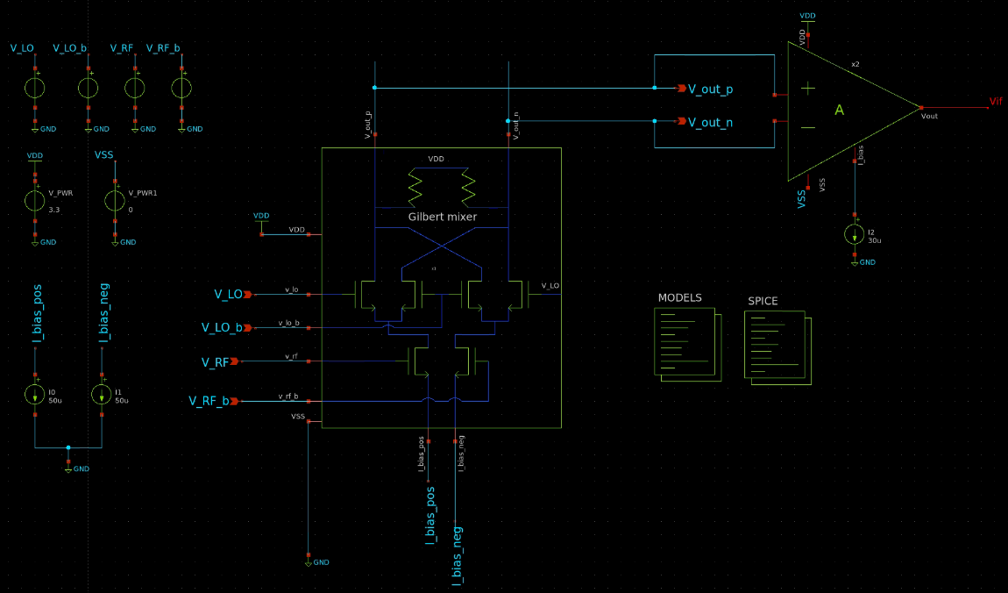
[picture p98: figure]

Resulting DC Output to Comparator for algorithm

DC

156kHz

312kHz

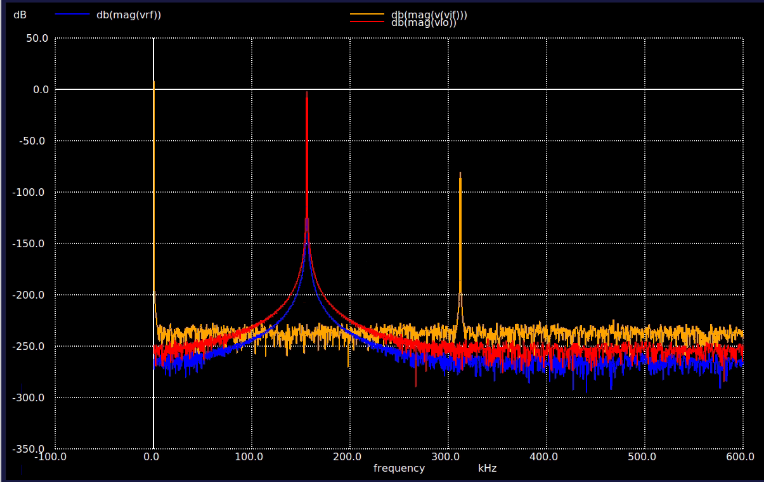
[picture p99: figure]

## Slide 21

Mixer Testbench with low pass filter (fc = 302.80kHz)

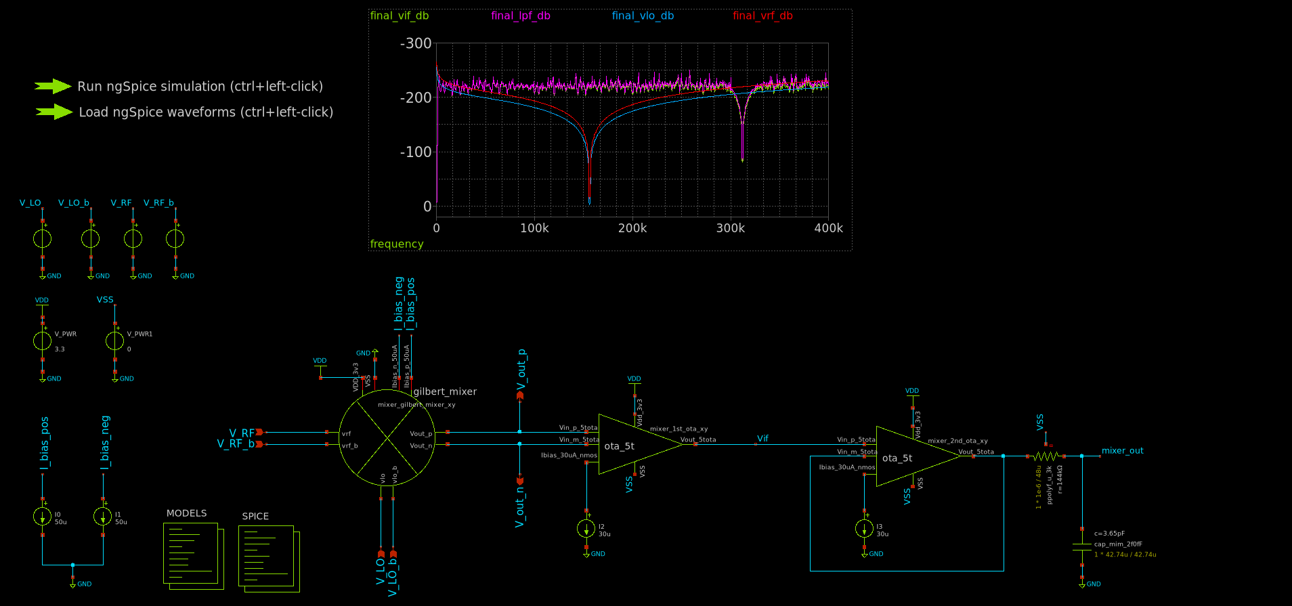
[picture p100: figure]

## Comparator Schematic

- Simple Strong Arm Latch Comparator

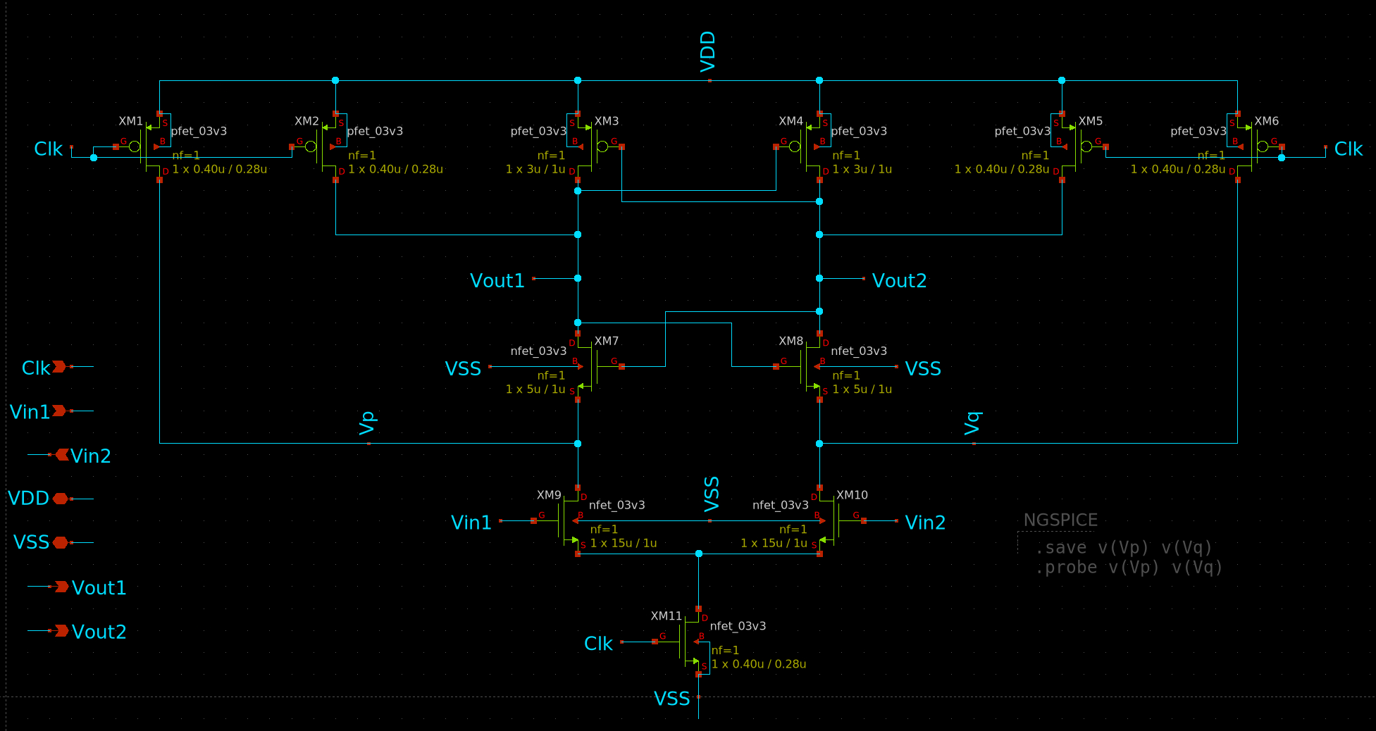
[picture p101: figure]

- Simple RS Latch for memory

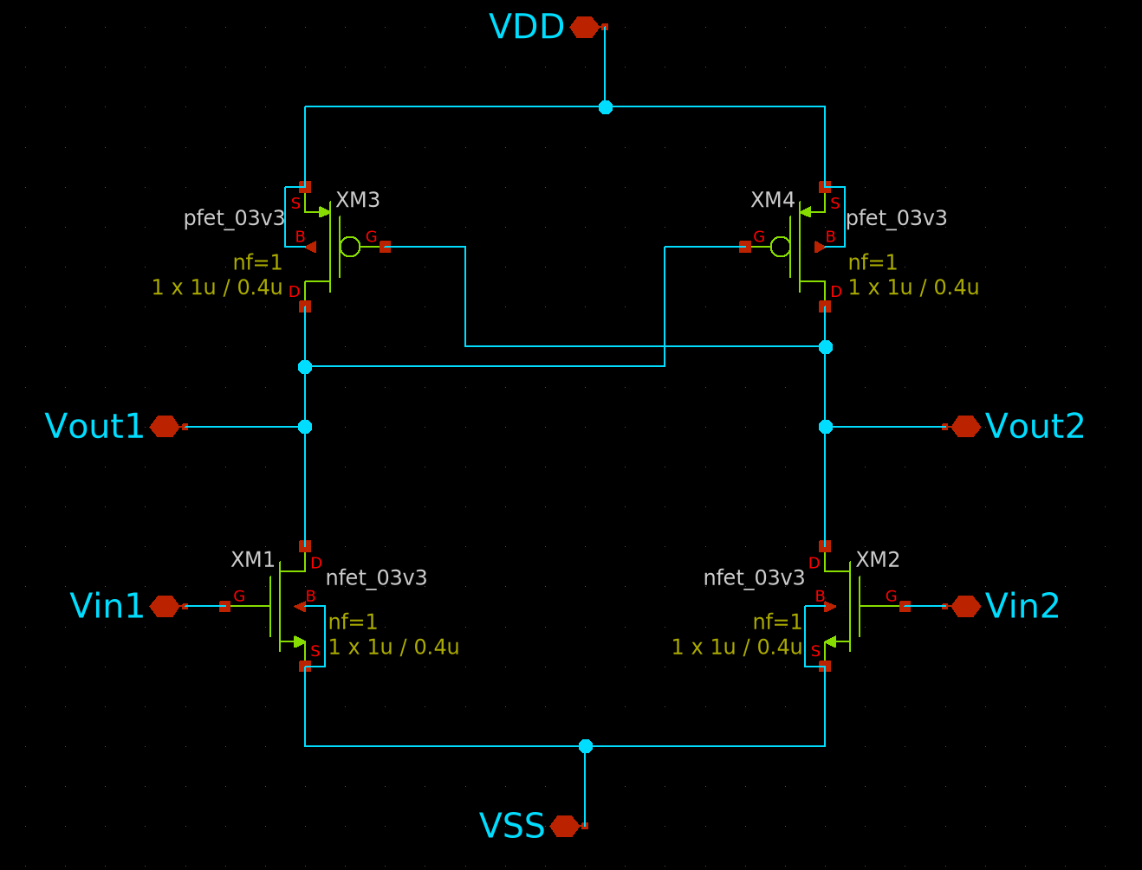
[picture p102: figure]

## Comparator Testbench

In_p: wave mixer output
In_n: dc offset (V mid rail)
Comp_out: digital interface

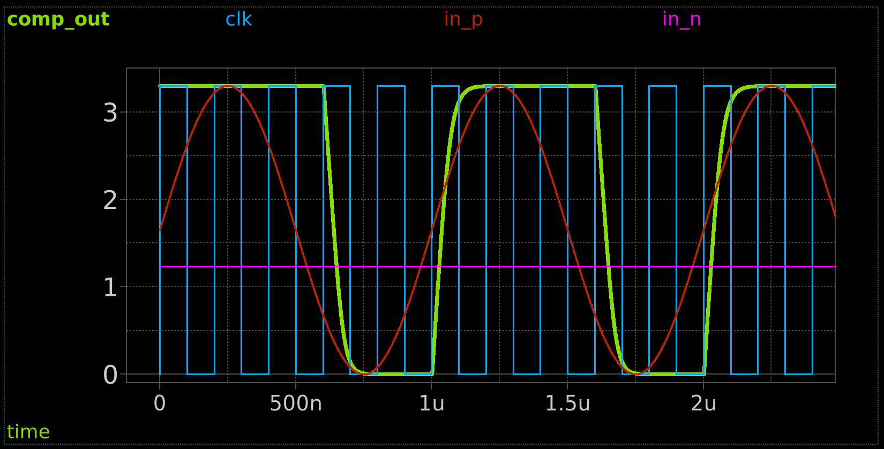
[picture p103: figure]
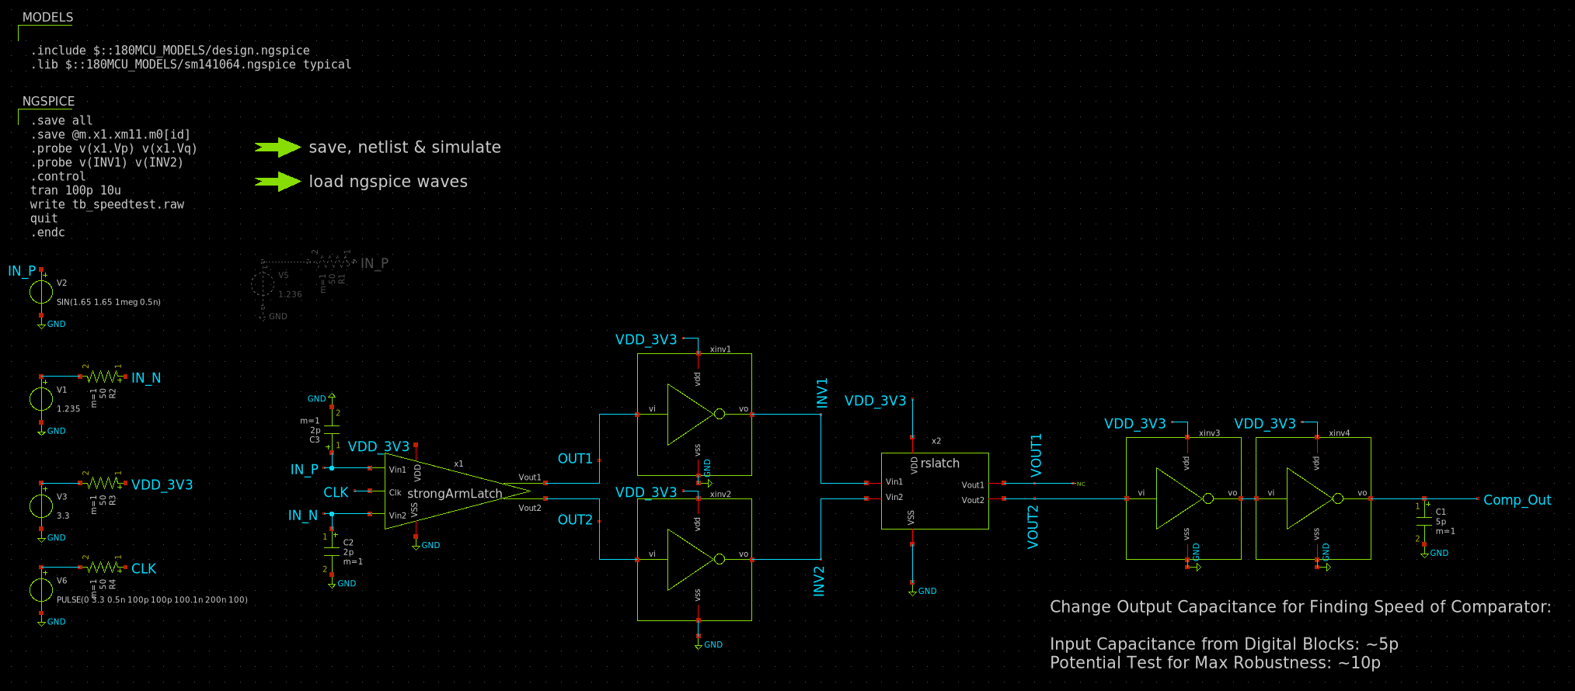
[picture p104: figure]

## Comparator Layout DRC

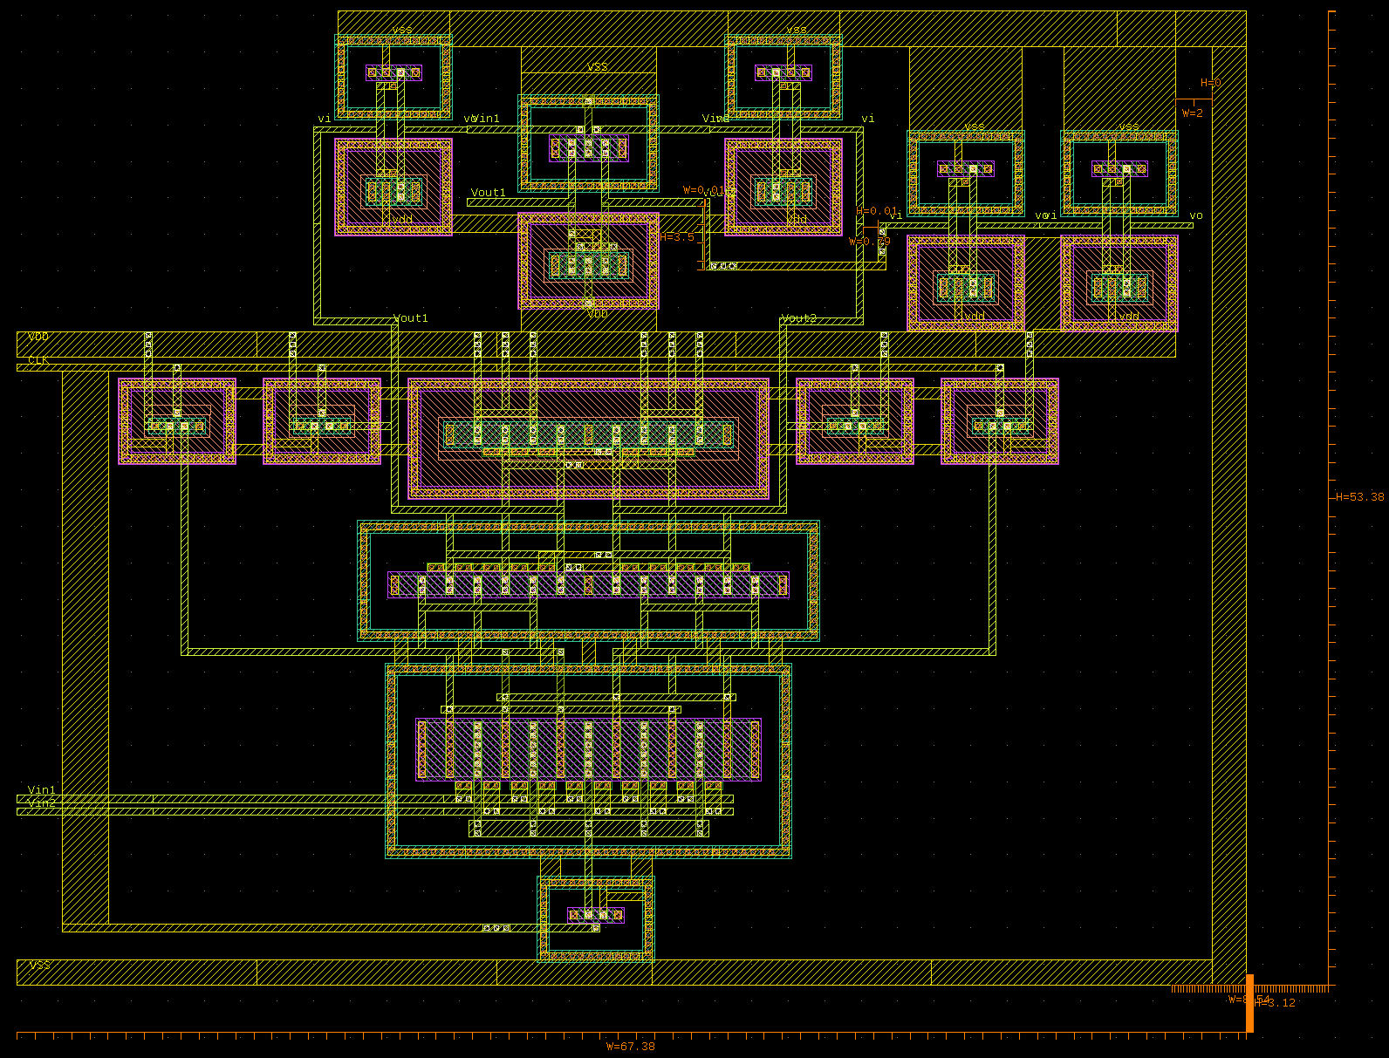
[picture p105: figure]

Can ignore density rules for all metals and poly and active layers for DRC

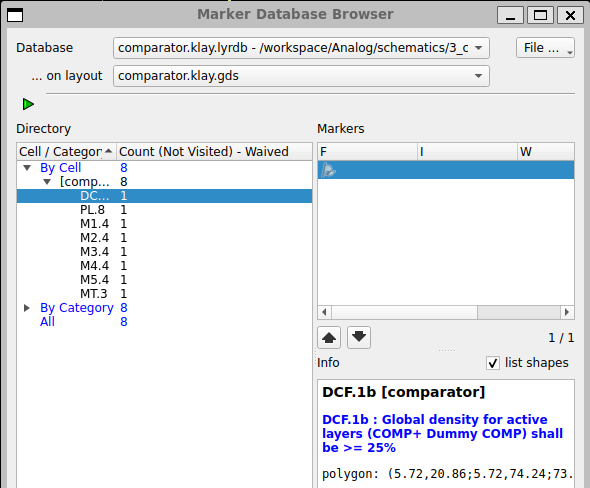
[picture p106: figure]

## Mixer Layout DRC

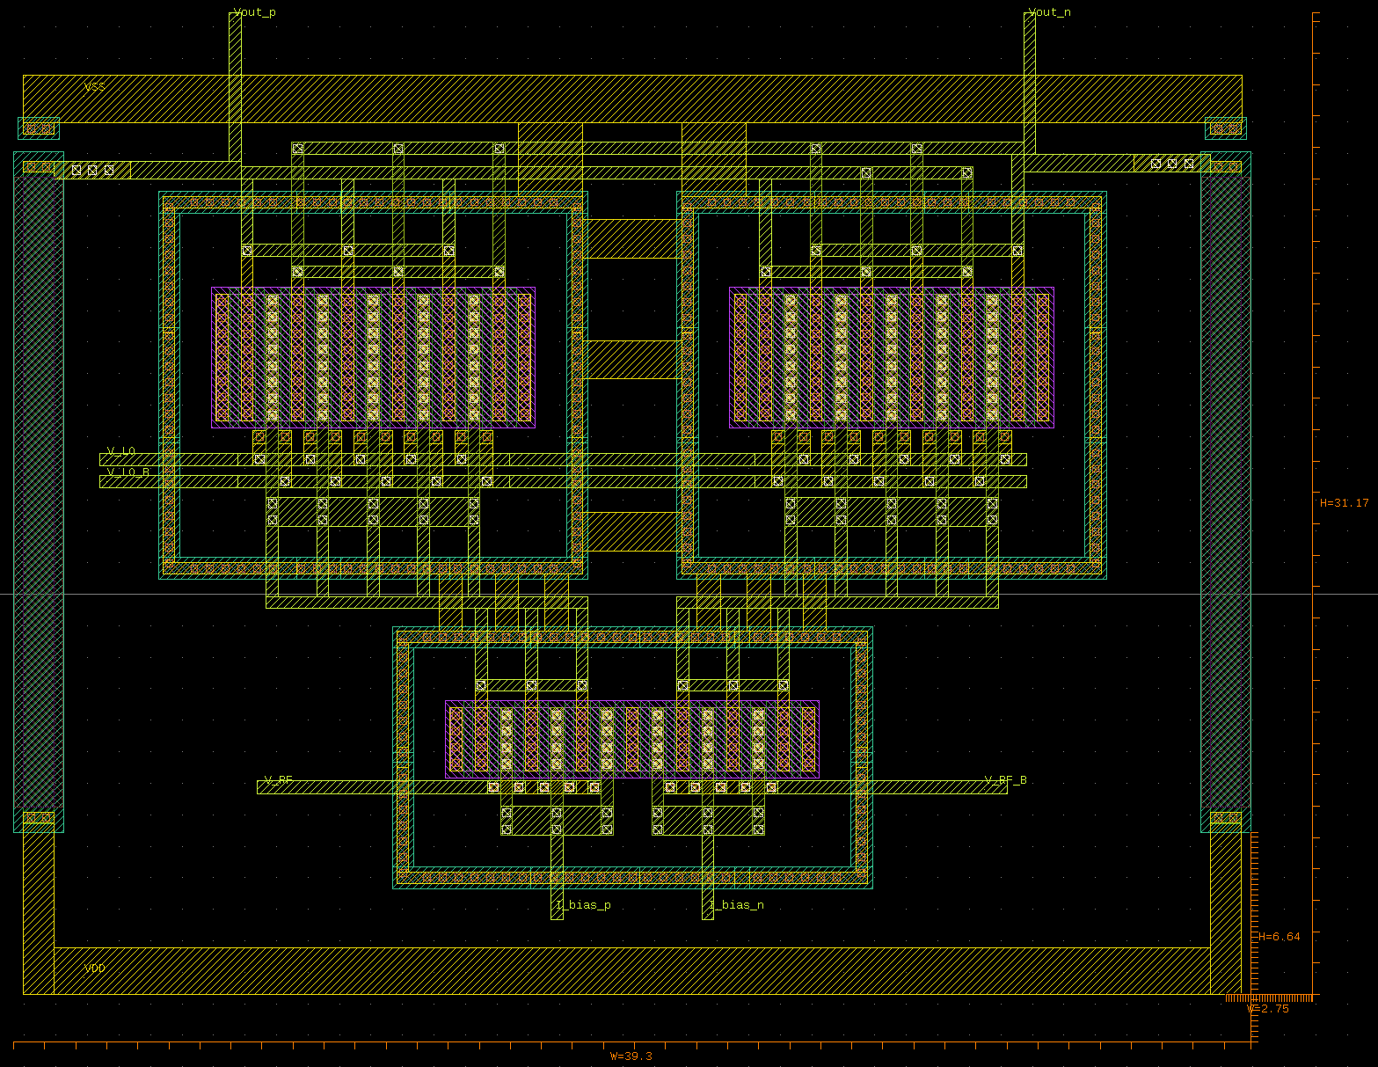
[picture p107: figure]

Can ignore density rules for all metals and poly and active layers for DRC

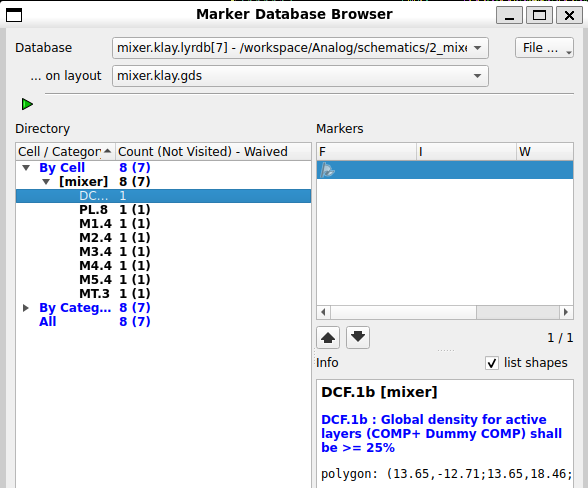
[picture p108: figure]

## Digital - Summary

1. System Verlog Completed: SPI (100%) State Machine (100%) Wave Controller (100%) Signal Processor (100%)
2. Cocotb Tested: SPI (90%) State Machine (100%) Wave Controller (100%) Signal Processor (100%)
3. Gtkwave Timing Visualization: SPI (100%) State Machine (100%) Wave Controller (100%) Signal Processor (100%)
4. Underdevelopment: Amp Ratio Adjuster

Links:
1. System Verilog HDL
Probton\src
https://github.com/llhtimlam/Probton/tree/main/src
2. Cocotb Simulation
Probton\cocotb
https://github.com/llhtimlam/Probton/tree/main/cocotb
3. Gtkwave
Probton\cocotb\sim_build
https://github.com/llhtimlam/Probton/tree/main/cocotb/sim_build

## Digital - State Machine Simulation

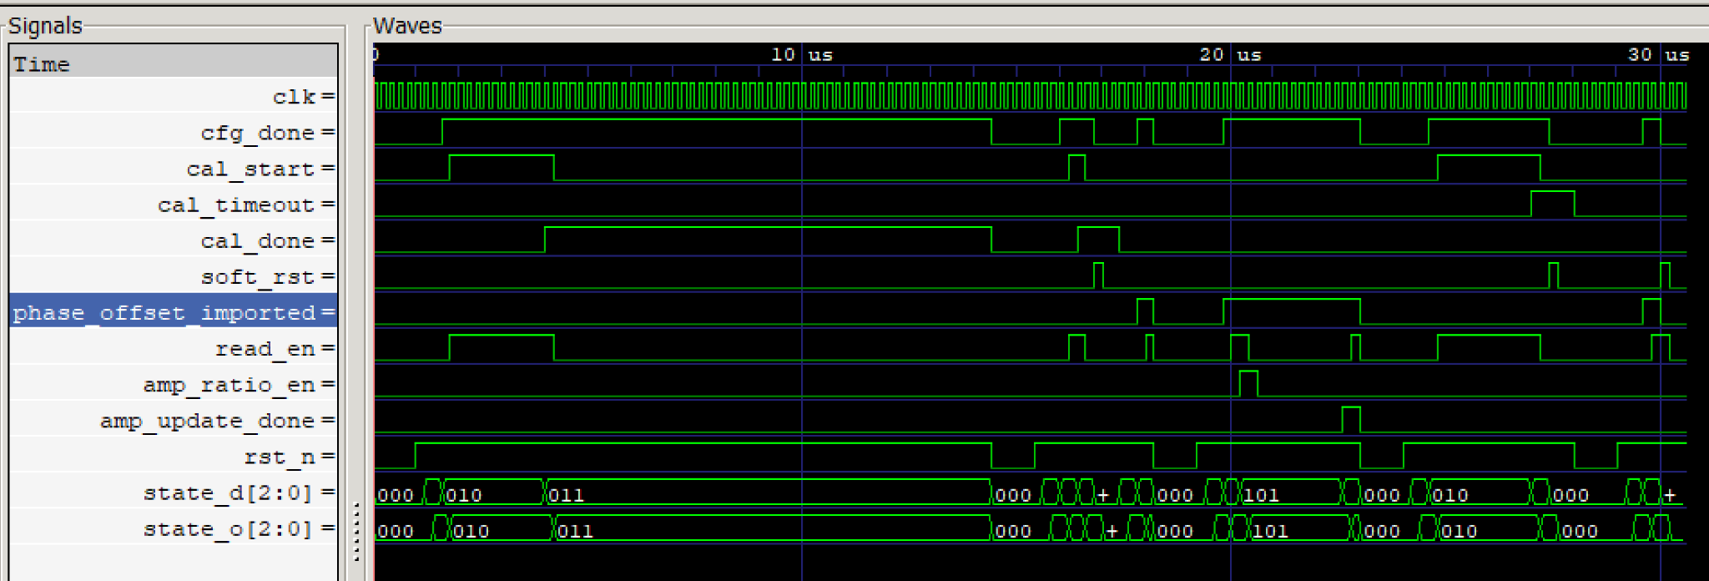
[picture p109: figure]

Boot -> Load Config -> Calibration -> Fallout (cal_done or cal_timeout)
Boot -> Load Config -> Readout -> Change Amp Ratio -> Readout
Passed test on all transition

## Digital - Wave Controller

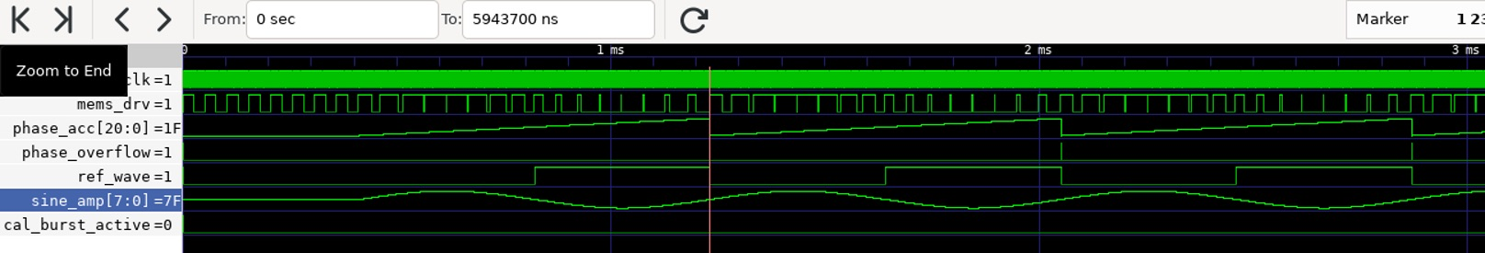
[picture p110: figure]

Sin wave is generated for memes driver (expecting triangular wave but use sin wave due to third odd harmonic)
Square wave is generated for wave mixer reference wave
Utilized Sigma Delta Modulator for pwm wave generation

## Slide 29

Calibration: Phase-Lag Capture with Jitter Rejection

Jitter guard active

- Early/invalid edges rejected (wave_is_valid=0)
- Capture re-arms, no offset committed

Valid Calibration

- All three edges captured (wave_is_valid=1)
- 90°/270° offsets computed: ~523k / ~1573k in phase-accumulator units

## Slide 30

Readout: Phase-Sampling Strobes with Ack Handshake

90° strobe

- Fires at phase_acc = 524288 (2²¹/4), held until ack, then cleared

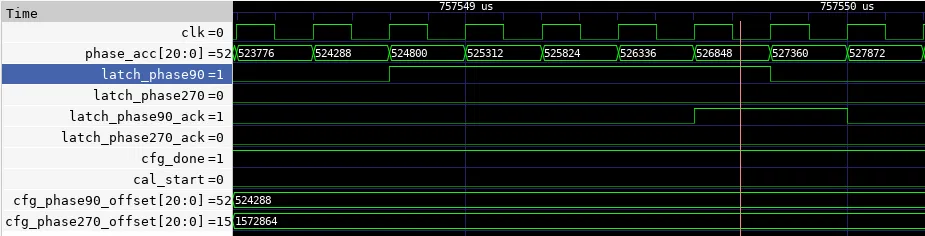
[picture p111: figure]

270° strobe

- Fires at phase_acc = 1572864 (3·2²¹/4), held until ack, then cleared

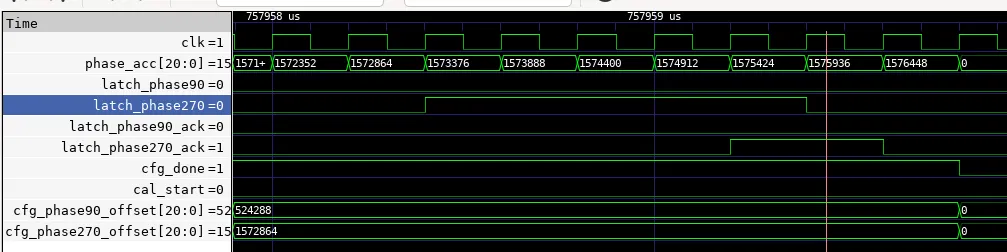
[picture p112: figure]

## Slide 31

Improvement could be made by voting filter and adjusting amp ratio for better resolution

Simulation Result


Just using the direction bit retrieved from the wave mixer, it is able to locate the center but converge too early.

## Slide 32

Improvement could be made by voting filter and adjusting amp ratio for better resolution

Simulation Result


Shows concentrated convergence result due to early converges and not able to identify the direction near peak

## Slide 33

Project Planning and Tracker

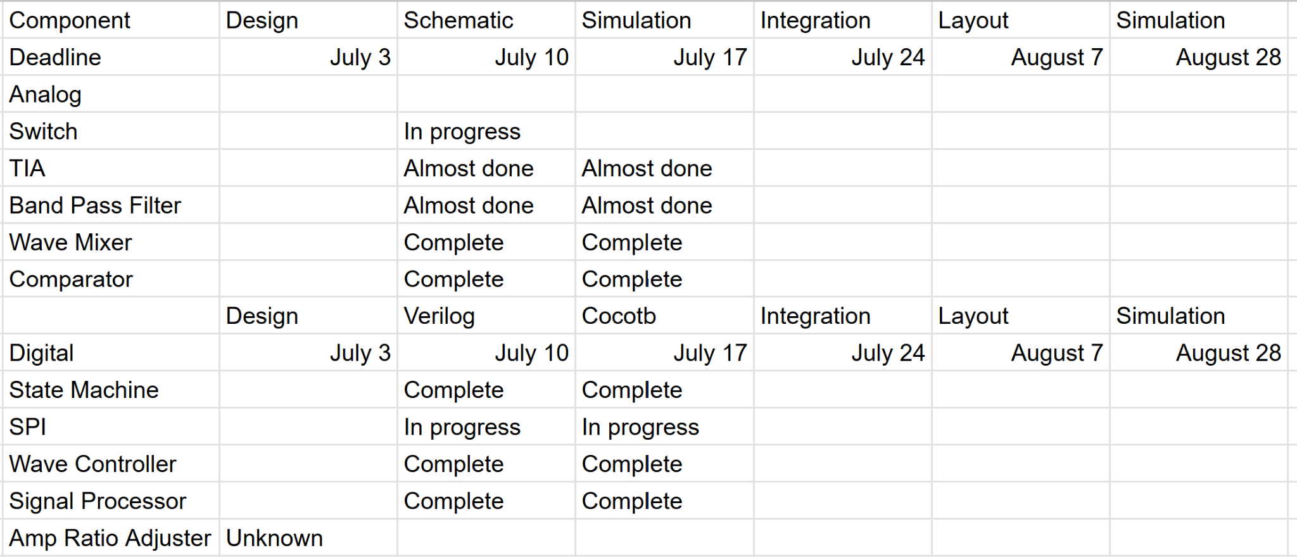
[picture p113: figure]

## Slide 34

Question

1. Should we bundle readout intensity with wave mixer error for synchronous digital reporting, or maintain isolated asynchronous paths in analog?
2. How should we change the amp ratio? Should we use a switch to disable the readout and then change the analog setting?
3. Feedback on the chip architect and whole system?

Risk (Looking for advice)

1. Since we decided to skip PLL and use sigma delta modulated for digital wave generation using 8-bit sin LUT, there will be some issue with harmonic. Design solution with eternal RC or alternative wave mixer component that compatible with digital reference wave are considering.
2. Amp Ratio Adjuster might be tricky as it need a lot of wires from digital side for switching resistor feedback.
2. Since we only consider 1 comparator park at 1.65V midrail, it might suffer jittering during idle at 0 offset, which might skew the result from calibration. Hystereis design might be required.

## Slide 35

References

[1]. H.-S. Liao *et al.*, "Low-cost, open-source XYZ nanopositioner for high-precision analytical applications," *HardwareX*, vol. 11, p. e00317, 2022. doi: [10.1016/j.ohx.2022.e00317](https://doi.org/10.1016/j.ohx.2022.e00317)
[2]. W.-M. Wang *et al.*, "Low-voltage and high-performance buzzer-scanner based streamlined atomic force microscope system," *Nanotechnology*, vol. 24, no. 45, p. 455503, Nov. 2013. doi: [10.1088/0957-4484/24/45/455503](https://doi.org/10.1088/0957-4484/24/45/455503)
[3]. Rout, Shasanka Sekhar, et al. "Design of 2.4 GHz Improved Current Reuse Gilbert Mixer with Source Degeneration Technique." Wireless Personal Communications, vol. 122, 2022, pp. 3875–3887, https://doi.org/10.1007/s11277-021-09115-6.
[4]. Altuner, Emre, et al. "High-Linearity Gilbert-Cell Mixer Design for Cryogenic Applications." Analog Integrated Circuits and Signal Processing, vol. 113, 2022, pp. 249–256, https://doi.org/10.1007/s10470-022-02098-9.

## Team

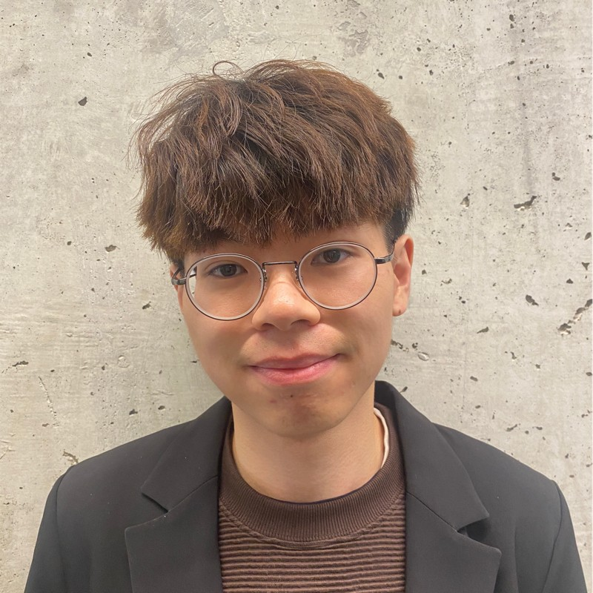
[picture p114: figure]

Tim (Team Lead)
HKUST Chem (UG)
UW HackerFab UWASIC

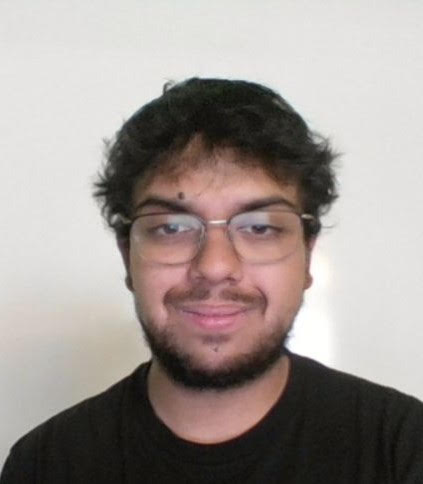
[picture p115: figure]

Abraar
TMU CE (UG)
LCRAIN

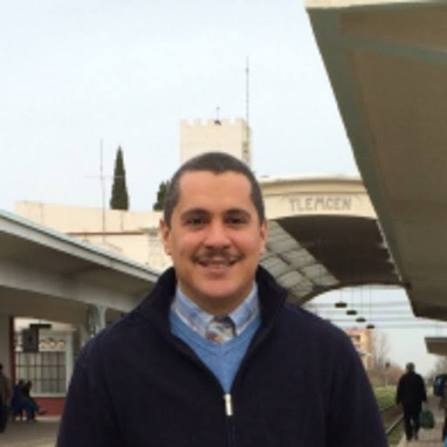
[picture p116: figure]

Belkacem
UT EE (PhD)
Automation Lab

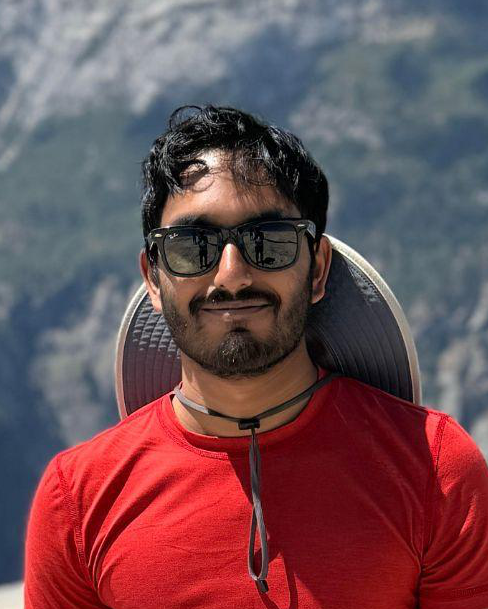
[picture p117: figure]

Nitin
UCSB EE (PG)
Mediatek
AMS Design engineer

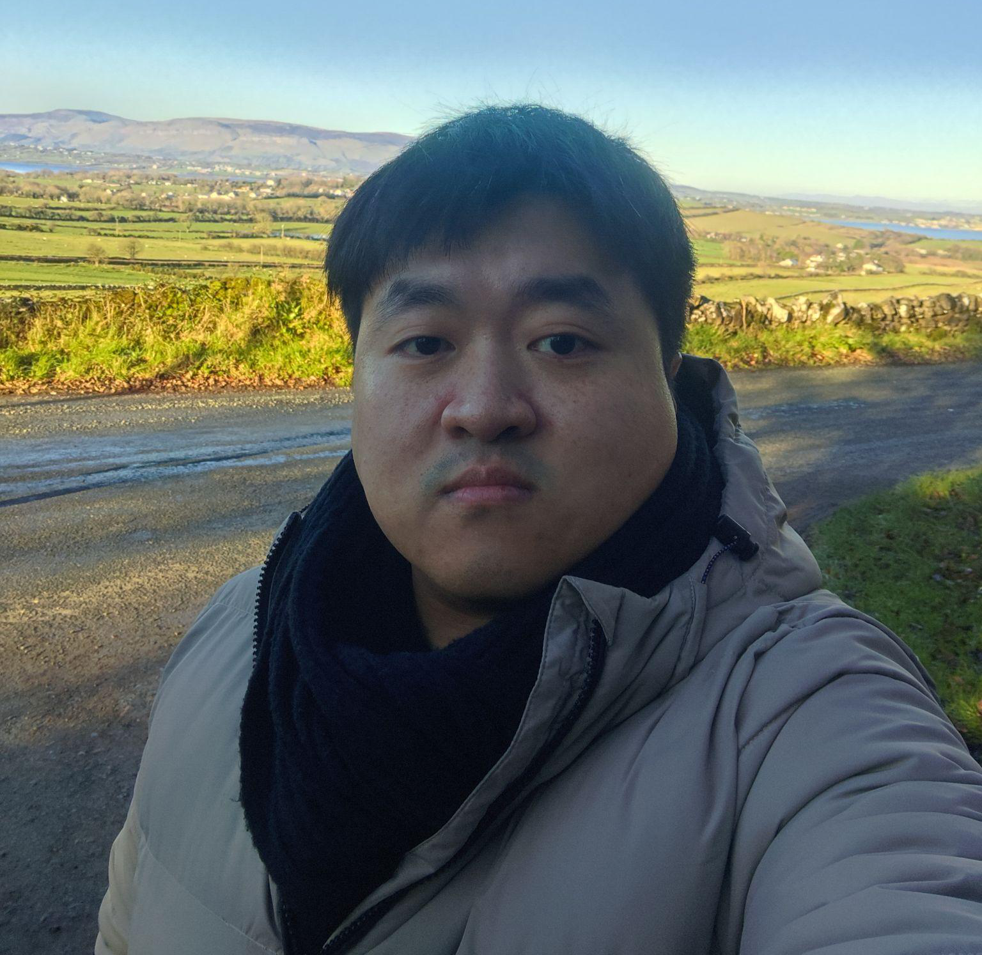
[picture p118: figure]

Reza
UCD ECE
(PG)

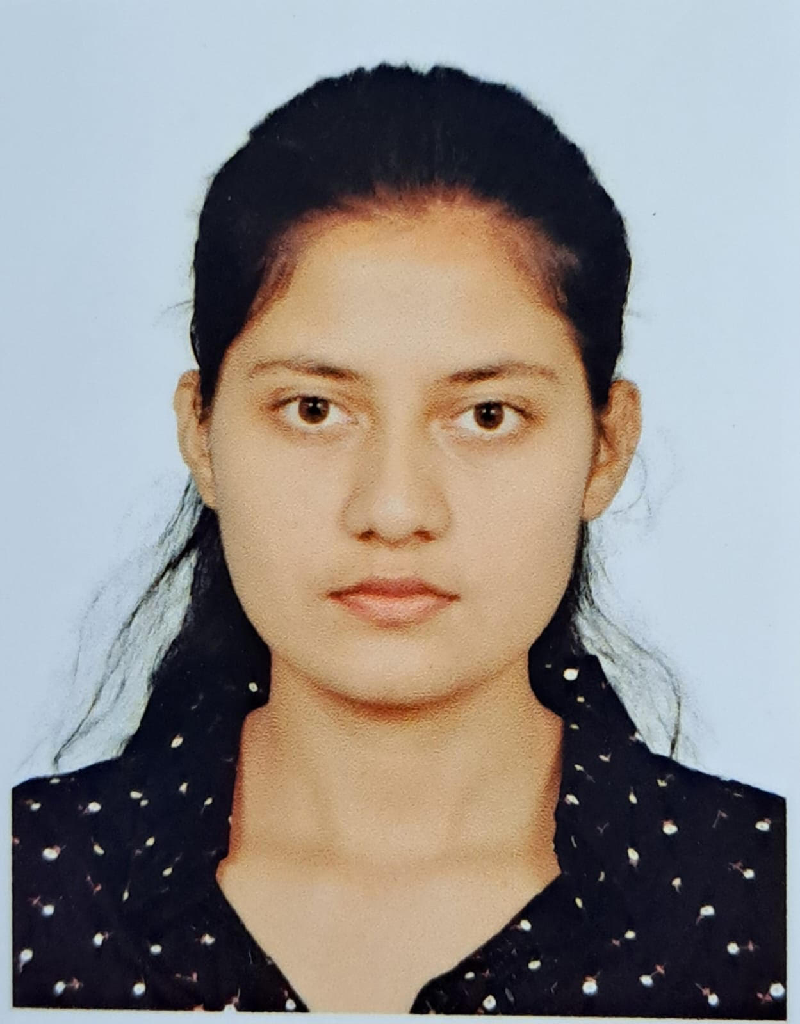
[picture p119: figure]

Ashmita
UCD ECE
(PG)

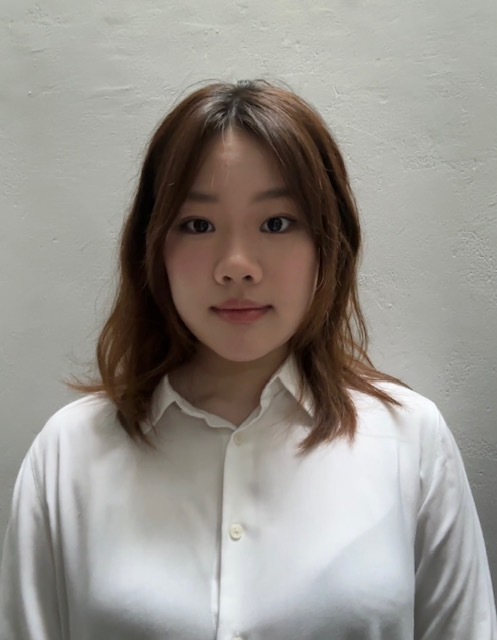
[picture p120: figure]

Victoria
UW NE (UG)
UWASIC
IQC UG RA

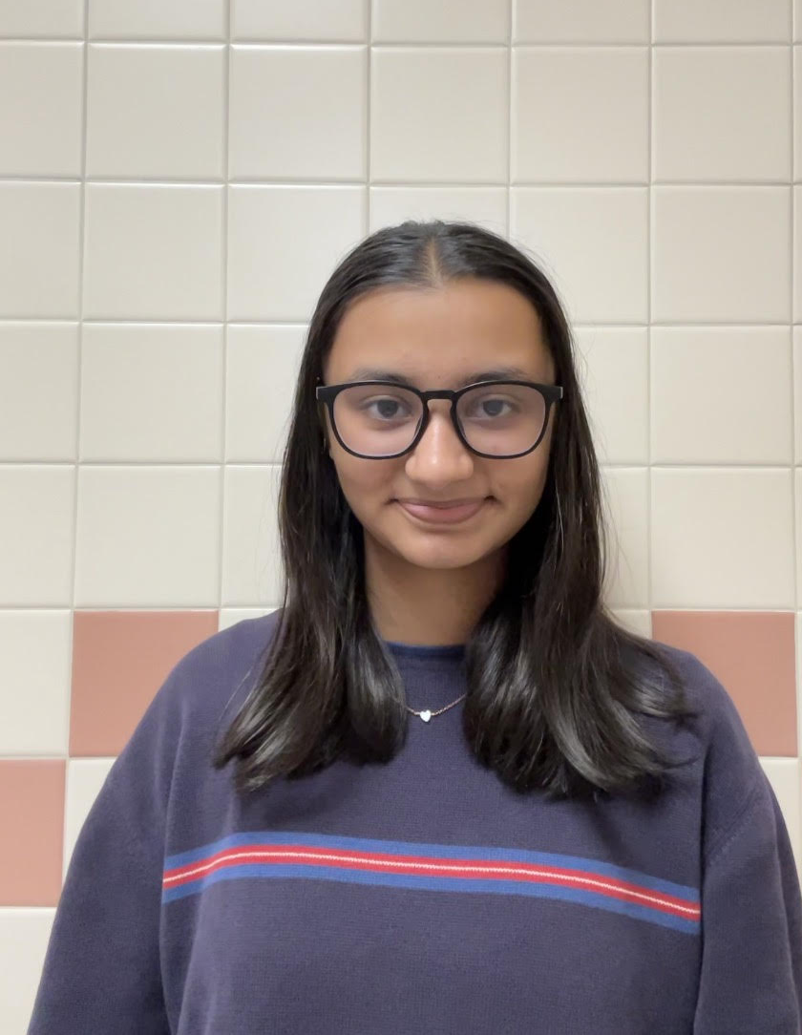
[picture p121: figure]

Annika

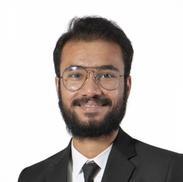
[picture p122: figure]

Kalam
HKUST EE (PG)
