llhtimlam/Probton/librelane/Digital_Domain_Padframe/49-odb-reportdisconnectedpins/full_disconnected_pins_table.txt

┏━━━━━━━━━━━━━━━━┳━━━━━━━━━━━━┳━━━━━━━━━━━━━━┳━━━━━━━━━━━━━━━━━━┳━━━━━━━━━━━━━━━┓
┃ Macro/Instance ┃ Power Pins ┃ Disconnected ┃ Signal Pins      ┃ Disconnected  ┃
┡━━━━━━━━━━━━━━━━╇━━━━━━━━━━━━╇━━━━━━━━━━━━━━╇━━━━━━━━━━━━━━━━━━╇━━━━━━━━━━━━━━━┩
│ B18_Probton    │ VDD        │              │ clk              │ dir_x_IN      │
│                │ VSS        │              │ clk_PD           │ dir_y_IN      │
│                │            │              │ clk_PU           │ mems_drv_x_IN │
│                │            │              │ comp_x           │ mems_drv_y_IN │
│                │            │              │ comp_x_PD        │ move_en_x_IN  │
│                │            │              │ comp_x_PU        │ move_en_y_IN  │
│                │            │              │ comp_y           │ read_en_IN    │
│                │            │              │ comp_y_PD        │ ref_wave_x_IN │
│                │            │              │ comp_y_PU        │ ref_wave_y_IN │
│                │            │              │ dir_x_CS         │ spi_miso_IN   │
│                │            │              │ dir_x_IE         │               │
│                │            │              │ dir_x_OE         │               │
│                │            │              │ dir_x_OUT        │               │
│                │            │              │ dir_x_PD         │               │
│                │            │              │ dir_x_PDRV0      │               │
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
│                │            │              │ spi_miso_PU      │               │
│                │            │              │ spi_miso_SL      │               │
│                │            │              │ spi_miso_oe      │               │
│                │            │              │ spi_mosi         │               │
│                │            │              │ spi_mosi_PD      │               │
│                │            │              │ spi_mosi_PU      │               │
│                │            │              │ spi_sclk         │               │
│                │            │              │ spi_sclk_PD      │               │
│                │            │              │ spi_sclk_PU      │               │
└────────────────┴────────────┴──────────────┴──────────────────┴───────────────┘
