llhtimlam/Probton/librelane/MACRO_disable_IO_PIN_ORDER_CFG/48-odb-reportdisconnectedpins/full_disconnected_pins_table.txt

┏━━━━━━━━━━━━━━━━┳━━━━━━━━━━━━┳━━━━━━━━━━━━━━┳━━━━━━━━━━━━━━┳━━━━━━━━━━━━━━┓
┃ Macro/Instance ┃ Power Pins ┃ Disconnected ┃ Signal Pins  ┃ Disconnected ┃
┡━━━━━━━━━━━━━━━━╇━━━━━━━━━━━━╇━━━━━━━━━━━━━━╇━━━━━━━━━━━━━━╇━━━━━━━━━━━━━━┩
│ chip_core      │ VDD        │              │ analog[0]    │ bidir_in[3]  │
│                │ VSS        │              │ analog[1]    │ bidir_in[4]  │
│                │            │              │ analog[2]    │ bidir_in[5]  │
│                │            │              │ analog[3]    │ bidir_in[6]  │
│                │            │              │ bidir_cs[0]  │ bidir_in[7]  │
│                │            │              │ bidir_cs[1]  │ bidir_in[8]  │
│                │            │              │ bidir_cs[2]  │ bidir_in[9]  │
│                │            │              │ bidir_cs[3]  │              │
│                │            │              │ bidir_cs[4]  │              │
│                │            │              │ bidir_cs[5]  │              │
│                │            │              │ bidir_cs[6]  │              │
│                │            │              │ bidir_cs[7]  │              │
│                │            │              │ bidir_cs[8]  │              │
│                │            │              │ bidir_cs[9]  │              │
│                │            │              │ bidir_ie[0]  │              │
│                │            │              │ bidir_ie[1]  │              │
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
│                │            │              │ bidir_sl[3]  │              │
│                │            │              │ bidir_sl[4]  │              │
│                │            │              │ bidir_sl[5]  │              │
│                │            │              │ bidir_sl[6]  │              │
│                │            │              │ bidir_sl[7]  │              │
│                │            │              │ bidir_sl[8]  │              │
│                │            │              │ bidir_sl[9]  │              │
│                │            │              │ clk          │              │
│                │            │              │ input_in     │              │
│                │            │              │ input_pd     │              │
│                │            │              │ input_pu     │              │
│                │            │              │ rst_n        │              │
└────────────────┴────────────┴──────────────┴──────────────┴──────────────┘
