llhtimlam/Probton/Media/Presentation/Proposal Script.docx

Hi everyone, we are Probton. We are leading a revolution for photonic packaging with an open-source ASIC.

Photonics is high-margin, but 80% of costs are trapped in expensive, proprietary alignment machinery. This massive barrier makes scaling difficult.

Probton breaks this bottleneck. We are delivering a transparent, customizable auto-aligner for under $5,000 by moving high-precision, closed-loop control onto open silicon.

Here is our setup. In real active alignment, it looks like this where light got injected into a PIC.

In chipathon, we are going to build a proof-of-concept prototype, where we use two optical fibre to mimic the tight tolerance of optical coupling during the alignment process.

Here is the exact hardware we have sourced for this project.

For our mixed signal architect, it pairs an AFE DAQ with an 8 bit digital processing, parsing data directly to the feedback control module.

Here is the detail of the analog domain. We use a TIA for amplification, filters high-frequency noise, tags direction with a wave mixer, and integrates the signal based on the vibration profile, digitalize the readout through VTT and TDC for further processing.

The digital domain processes the normalized 8-bit readout through log lookup tables, pipelining data into the algorithm to output an offset error to the control unit.

Our algorithm executes a three-point Gaussian area method, calculating the log area of three sweeping points across a known offset distance, delta, normalized in an 8-bit register.

Here is our simulation result, showing an average of 5.7 steps to converge.

This is our team profile, thank you!
