llhtimlam/Probton/Media/Schematic/analog_schematic_readout.pdf

# Analog/schematics/B18_Probton_readout.sch

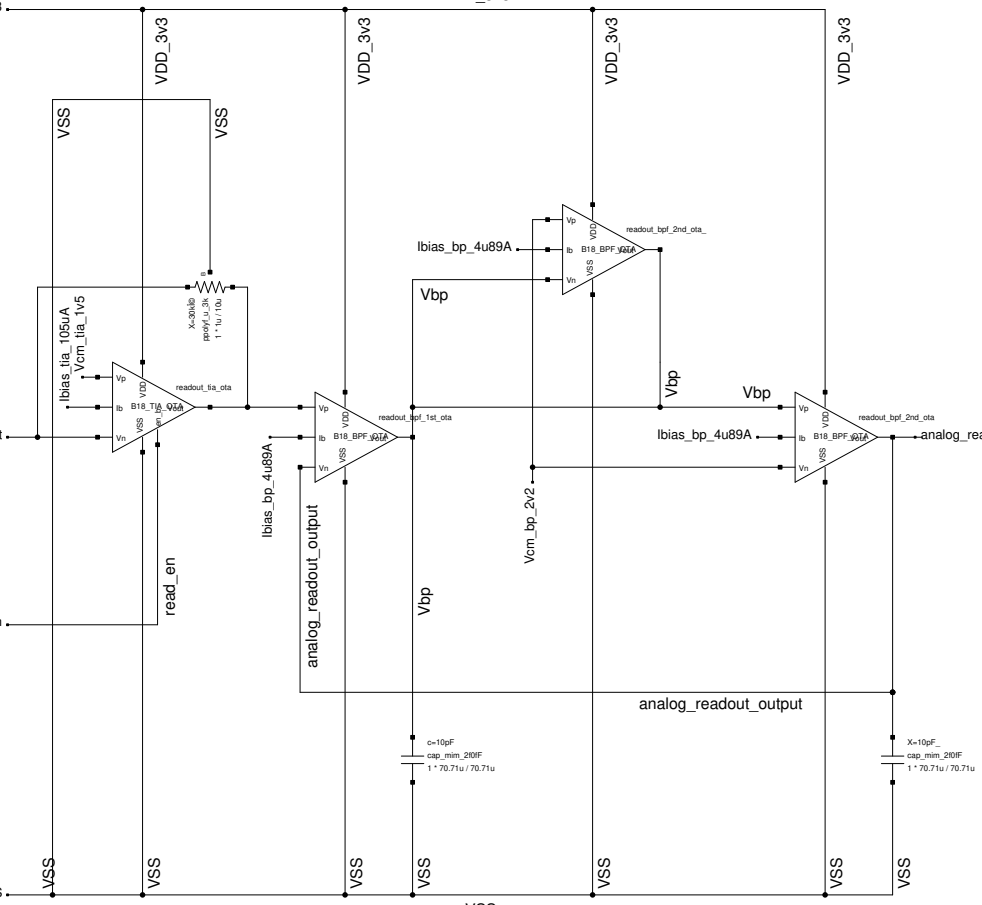
[picture p123: figure]
B18_TIA_OTA; readout_tia_ota; VDD; Vout; VSS; B18_BPF_OTA; readout_bpf_1st_ota; readout_bpf_2nd_ota; cap_mim_2f0fF; ppolyf_u_3k; Ibias_bp_4u89A; Vcm_bp_2v2; Vcm_tia_1v5 Ibias_tia_105uA; readout_bpf_2nd_ota_; VDD_3v3; Vbp; read_en; analog_readout_output

# VSS

# analog_readout_input

# VDD_3v3

# analog_readout_output

# read_en

# VSS

# VDD_3v3
