llhtimlam/Probton/Media/Layout/B18_Probton_integration.pdf

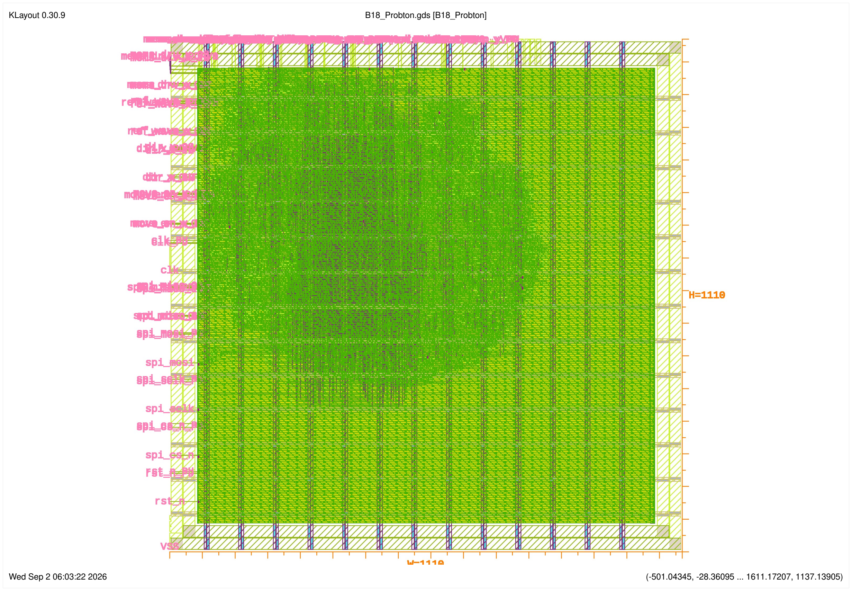
[picture p124: page 1]

KLayout 0.30.9 | B18_Probton.gds [B18_Probton]
Wed Sep 2 06:03:22 2026 | (-501.04345, -28.36095 ... 1611.17207, 1137.13905)
