llhtimlam/Probton/Media/Layout/B18_Probton_MPW_no_label.pdf

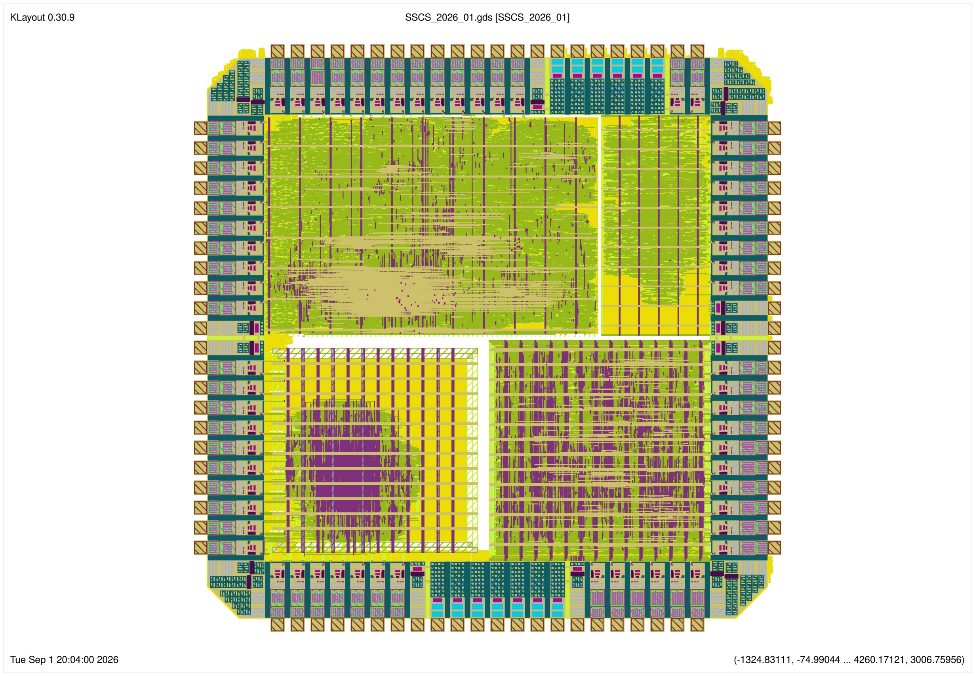
[picture p125: page 1]

KLayout 0.30.9 | SSCS_2026_01.gds [SSCS_2026_01]
Tue Sep 1 20:04:00 2026 | (-1324.83111, -74.99044 ... 4260.17121, 3006.75956)
