llhtimlam/Probton/Media/Layout/B18_Probton_integration_no_label.pdf

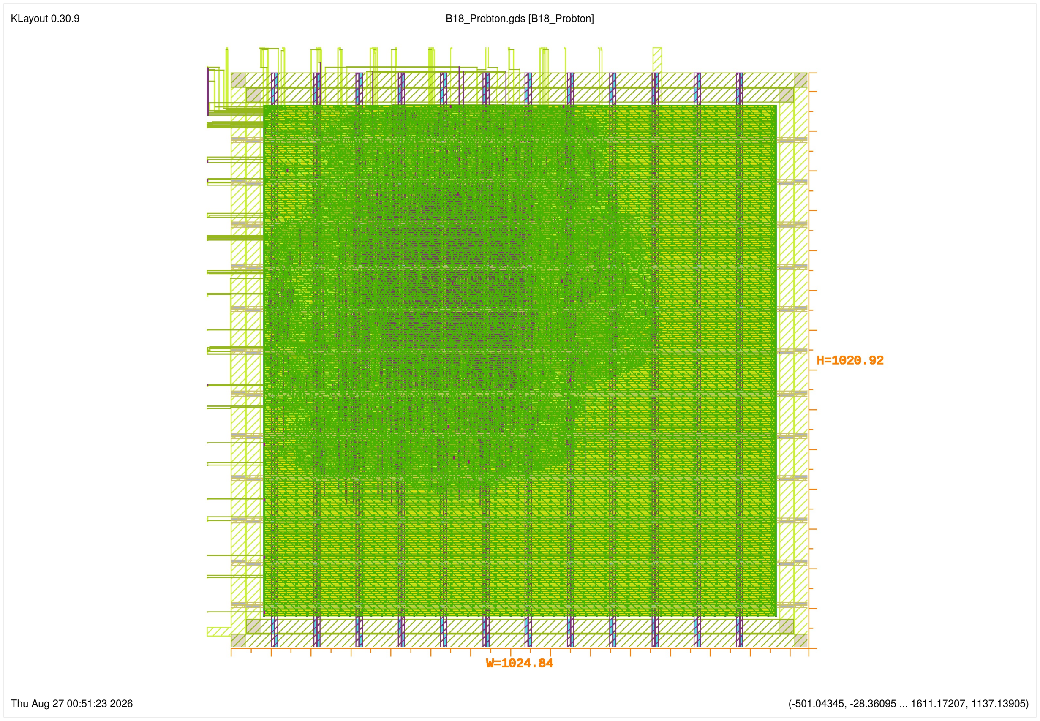
[picture p126: page 1]

KLayout 0.30.9 | B18_Probton.gds [B18_Probton]
Thu Aug 27 00:51:23 2026 | (-501.04345, -28.36095 ... 1611.17207, 1137.13905)
