llhtimlam/Probton/Media/Layout/digital_domain.pdf

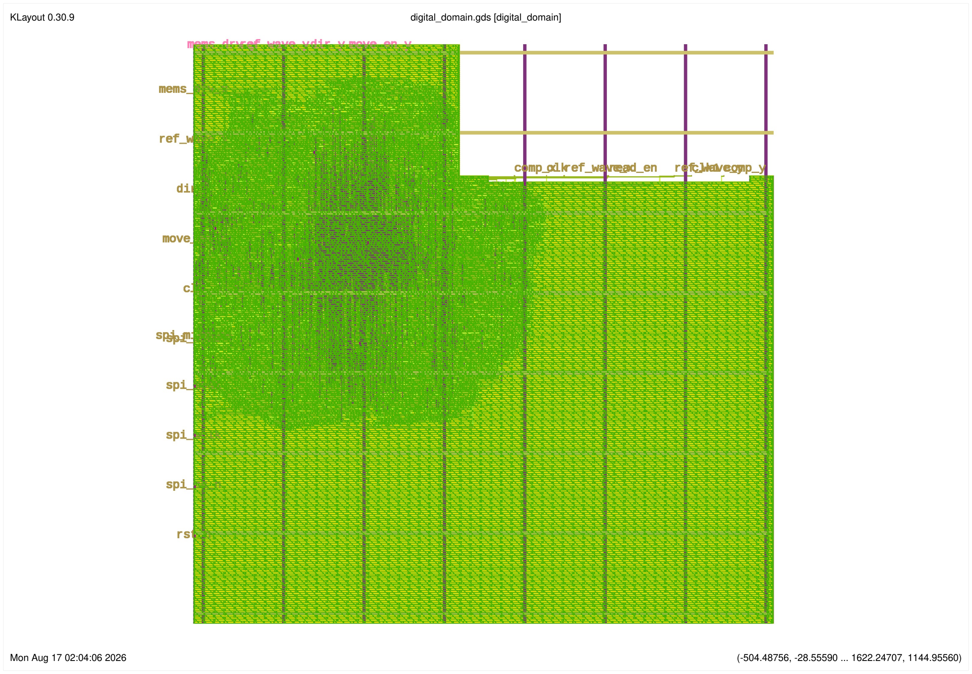
[picture p127: page 1]

KLayout 0.30.9 | digital_domain.gds [digital_domain]
Mon Aug 17 02:04:06 2026 | (-504.48756, -28.55590 ... 1622.24707, 1144.95560)
