llhtimlam/Probton/Media/Layout/pre-integration.pdf

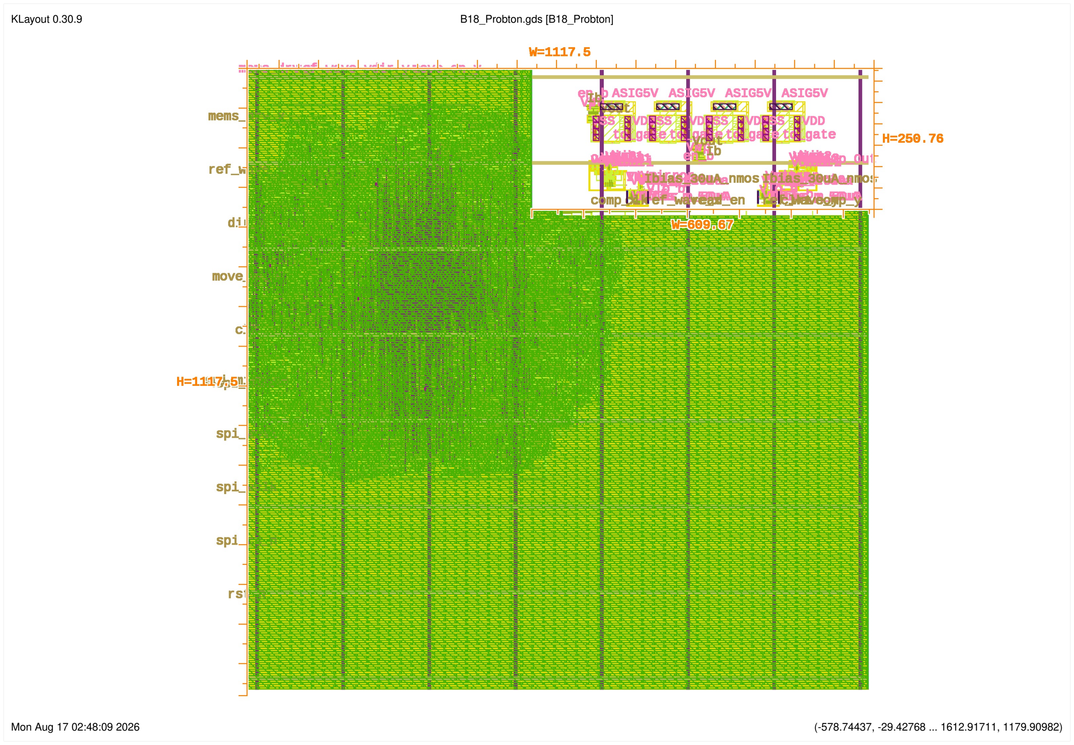
[picture p128: page 1]

KLayout 0.30.9 | B18_Probton.gds [B18_Probton]
Mon Aug 17 02:48:09 2026 | (-578.74437, -29.42768 ... 1612.91711, 1179.90982)
