llhtimlam/Probton/Media/Layout/analog_domain_esd_protection.pdf

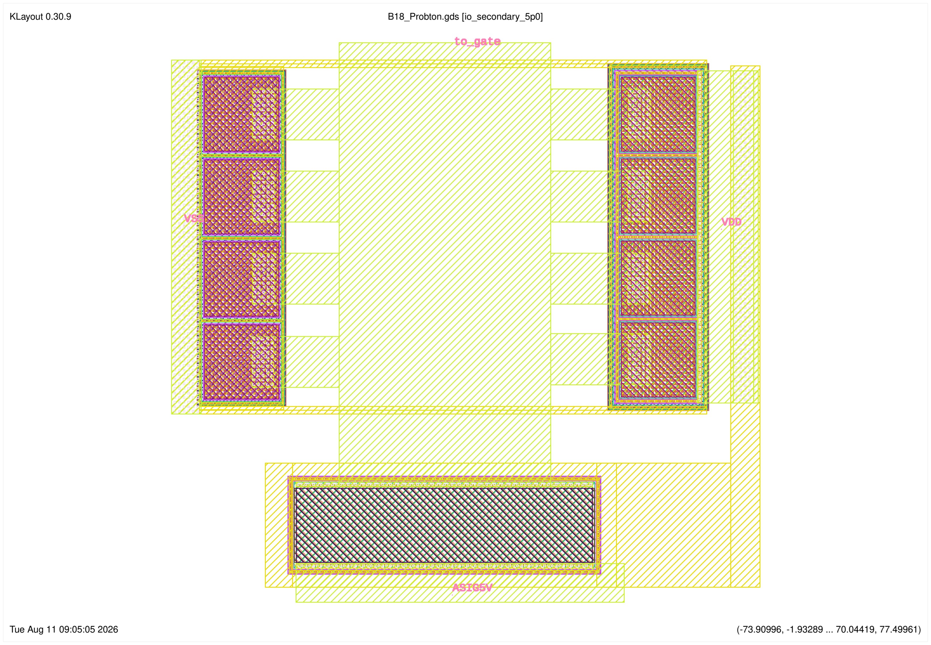
[picture p133: page 1]

KLayout 0.30.9 | B18_Probton.gds [io_secondary_5p0]
Tue Aug 11 09:05:05 2026 | (-73.90996, -1.93289 ... 70.04419, 77.49961)
