llhtimlam/Probton/Media/Layout/digital_domain_sub_module/digital_domain_signal_processor.pdf

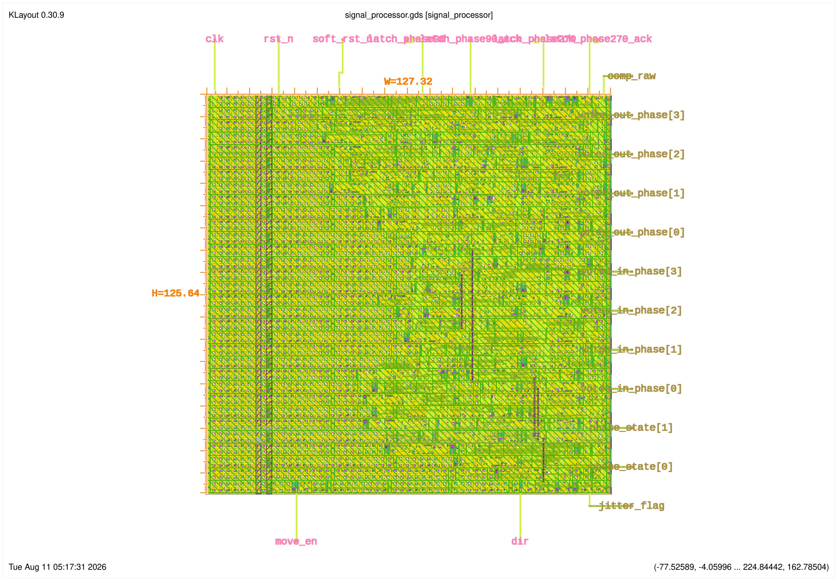
[picture p134: page 1]

KLayout 0.30.9 | signal_processor.gds [signal_processor]
Tue Aug 11 05:17:31 2026 | (-77.52589, -4.05996 ... 224.84442, 162.78504)
