llhtimlam/Probton/Media/Layout/digital_domain_sub_module/digital_domain_spi.pdf

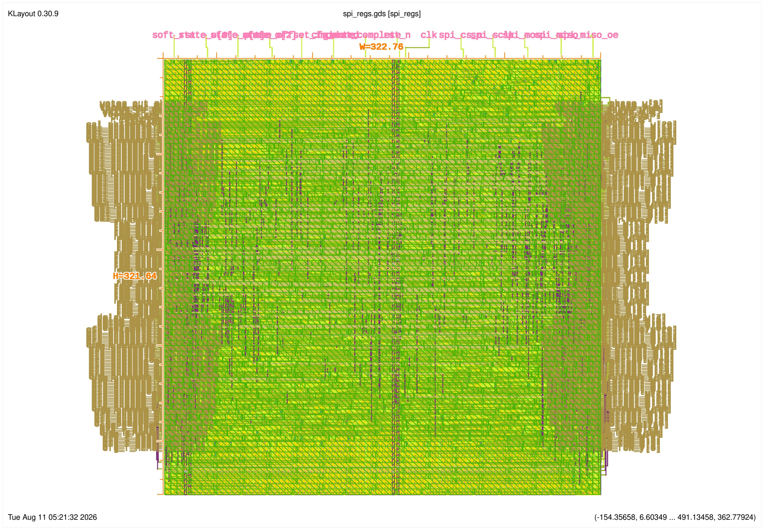
[picture p135: page 1]

KLayout 0.30.9 | spi_regs.gds [spi_regs]
Tue Aug 11 05:21:32 2026 | (-154.35658, 6.60349 ... 491.13458, 362.77924)
