llhtimlam/Probton/Media/Layout/digital_domain_sub_module/digital_domain_state_machine.pdf

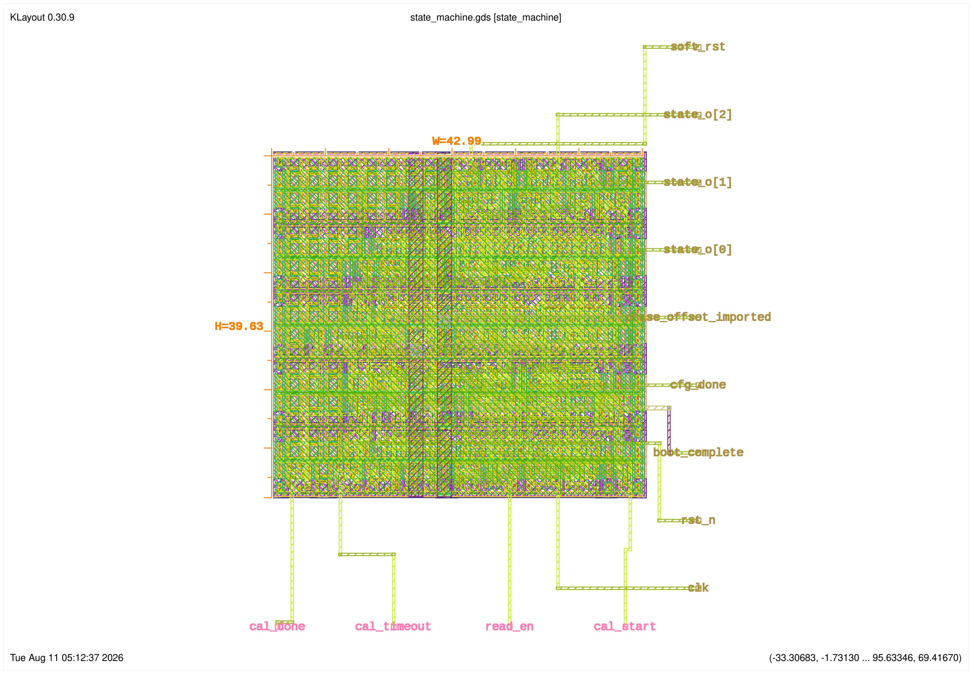
[picture p136: page 1]

KLayout 0.30.9 | state_machine.gds [state_machine]
Tue Aug 11 05:12:37 2026 | (-33.30683, -1.73130 ... 95.63346, 69.41670)
