llhtimlam/Probton/Media/Layout/digital_domain_sub_module/digital_domain_wave_controller.pdf

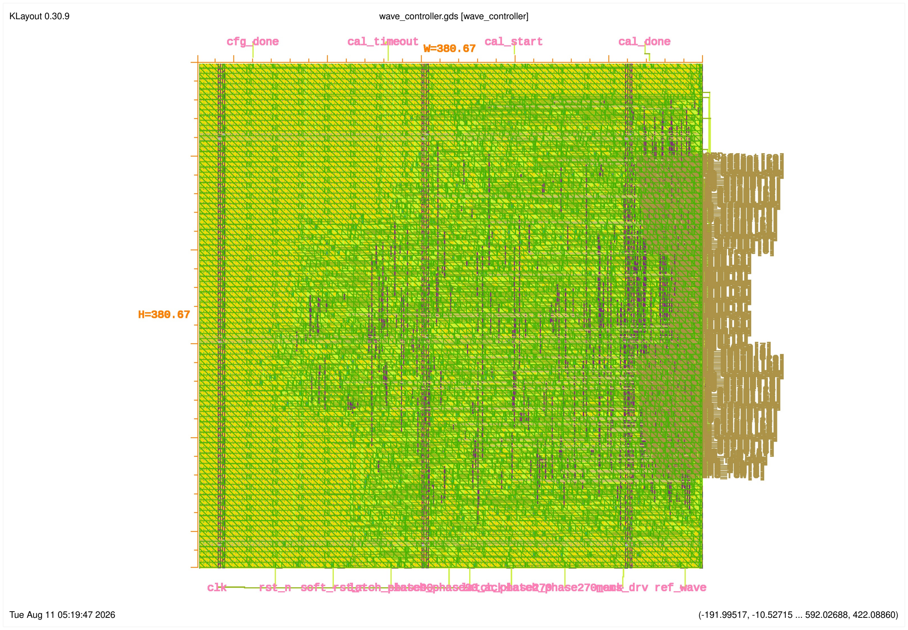
[picture p137: page 1]

KLayout 0.30.9 | wave_controller.gds [wave_controller]
Tue Aug 11 05:19:47 2026 | (-191.99517, -10.52715 ... 592.02688, 422.08860)
