llhtimlam/Probton/librelane/Digital_Domain_Padframe/51-odb-reportwirelength/wire_lengths.csv

net | length_um
clknet_0_clk | 1.67556mm
net982 | 1.17661mm
wrapper_inst.digital_domain_inst.raw_edge3_y\[12\] | 1.14845mm
wrapper_inst.digital_domain_inst.signal_processor_x_inst.votes_out_phase\[1\] | 1.13247mm
net1793 | 1.08446mm
net1314 | 1.05183mm
_04127_ | 977.35µm
_00604_ | 971.8µm
net1712 | 919.67µm
net1818 | 915.19µm
clk | 909.3µm
net2233 | 909.13µm
net1608 | 908.93µm
_01854_ | 908.32µm
wrapper_inst.digital_domain_inst.cfg_phase270_offset_y\[14\] | 847.94µm
wrapper_inst.digital_domain_inst.phase_state_x\[1\] | 841.73µm
net2211 | 840.1µm
net1734 | 820.04µm
net1616 | 795.3µm
_05329_ | 794.79µm
_03566_ | 790.87µm
net1037 | 790.31µm
net2317 | 781.35µm
net1716 | 780.28µm
_00917_ | 778.65µm
net2683 | 770.76µm
net1590 | 766.69µm
_05925_ | 763.43µm
net1316 | 755.59µm
wrapper_inst.digital_domain_inst.signal_processor_x_inst.votes_in_phase\[3\] | 753.3µm
wrapper_inst.digital_domain_inst.signal_processor_x_inst.votes_out_phase\[3\] | 749.43µm
net1279 | 739.21µm
net528 | 737.06µm
wrapper_inst.digital_domain_inst.phase_state_x\[0\] | 729.78µm
_05034_ | 722.55µm
net1147 | 719.75µm
net1612 | 718.02µm
net765 | 717.61µm
net2813 | 715.27µm
net1744 | 715.17µm
wrapper_inst.digital_domain_inst.cfg_phase270_offset_y\[11\] | 699.13µm
net1024 | 699.08µm
_04101_ | 697.96µm
_05315_ | 696.08µm
net2278 | 690.17µm
_03202_ | 688.9µm
_02771_ | 688.39µm
_05890_ | 683.91µm
_05877_ | 682.79µm
net2263 | 680.04µm
net1554 | 674.85µm
net1904 | 672µm
net1468 | 670.47µm
net1223 | 666.6µm
_05033_ | 660.9µm
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
_05586_ | 52.79µm
_02067_ | 52.74µm
_03991_ | 52.74µm
_05105_ | 52.74µm
_05437_ | 52.74µm
wrapper_inst.digital_domain_inst.signal_processor_y_inst.cnt_out\[0\] | 52.74µm
net788 | 52.74µm
_00164_ | 52.69µm
_01563_ | 52.69µm
_03986_ | 52.69µm
net1244 | 52.69µm
net1489 | 52.69µm
net2107 | 52.69µm
net2282 | 52.69µm
net2538 | 52.69µm
net2648 | 52.69µm
net2801 | 52.69µm
_04832_ | 52.64µm
net532 | 52.64µm
net1036 | 52.64µm
net1230 | 52.64µm
net1998 | 52.64µm
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
