llhtimlam/Probton/librelane/Digital_Domain_Padframe/57-openroad-irdropreport/net-VDD.csv

Instance | Terminal | Layer | X location | Y location | Voltage
FILLER_250_1764 | VDD | Metal1 | 1048.6000 | 1046.6400 | 3.300000
FILLER_250_1760 | VDD | Metal1 | 1047.5800 | 1046.2075 | 3.300000
FILLER_250_1752 | VDD | Metal1 | 1044.3465 | 1046.0630 | 3.300000
FILLER_250_1736 | VDD | Metal1 | 1037.7280 | 1045.9480 | 3.300000
FILLER_250_1702 | VDD | Metal1 | 1023.2355 | 1045.8710 | 3.300000
FILLER_250_1668 | VDD | Metal1 | 1004.1955 | 1045.8710 | 3.300000
FILLER_250_1634 | VDD | Metal1 | 985.1555 | 1045.8710 | 3.300000
FILLER_250_1600 | VDD | Metal1 | 966.1155 | 1045.8710 | 3.300000
FILLER_250_1566 | VDD | Metal1 | 947.0755 | 1045.8710 | 3.300000
FILLER_250_1532 | VDD | Metal1 | 928.0355 | 1045.8710 | 3.300000
FILLER_250_1498 | VDD | Metal1 | 908.9955 | 1045.8710 | 3.300000
FILLER_250_1464 | VDD | Metal1 | 889.9555 | 1045.8710 | 3.300000
FILLER_250_1430 | VDD | Metal1 | 870.9155 | 1045.8710 | 3.300000
FILLER_250_1396 | VDD | Metal1 | 851.8755 | 1045.8710 | 3.300000
FILLER_250_1362 | VDD | Metal1 | 832.8355 | 1045.8710 | 3.300000
FILLER_250_1328 | VDD | Metal1 | 813.7955 | 1045.8710 | 3.300000
FILLER_250_1294 | VDD | Metal1 | 794.7555 | 1045.8710 | 3.300000
FILLER_250_1260 | VDD | Metal1 | 775.7155 | 1045.8710 | 3.300000
FILLER_250_1226 | VDD | Metal1 | 756.6755 | 1045.8710 | 3.300000
FILLER_250_1192 | VDD | Metal1 | 737.6355 | 1045.8710 | 3.300000
FILLER_250_1158 | VDD | Metal1 | 718.5955 | 1045.8710 | 3.300000
FILLER_250_1152 | VDD | Metal1 | 707.1000 | 1046.2075 | 3.300000
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
FILLER_232_247 | VDD | Metal1 | 200.3000 | 975.6475 | 3.299999
FILLER_232_244 | VDD | Metal1 | 197.4000 | 976.0800 | 3.299999
FILLER_232_242 | VDD | Metal1 | 196.5600 | 976.0800 | 3.299999
FILLER_232_238 | VDD | Metal1 | 195.2600 | 975.6475 | 3.299999
FILLER_232_206 | VDD | Metal1 | 185.4755 | 975.3110 | 3.299999
FILLER_232_197 | VDD | Metal1 | 171.0800 | 976.0800 | 3.299999
FILLER_232_193 | VDD | Metal1 | 170.0600 | 975.6475 | 3.299999
FILLER_232_177 | VDD | Metal1 | 164.6880 | 975.3880 | 3.299999
FILLER_232_171 | VDD | Metal1 | 157.7400 | 975.6475 | 3.299999
FILLER_232_163 | VDD | Metal1 | 154.5065 | 975.5030 | 3.299999
FILLER_232_154 | VDD | Metal1 | 147.0000 | 976.0800 | 3.299999
FILLER_232_152 | VDD | Metal1 | 146.1600 | 976.0800 | 3.299999
FILLER_232_148 | VDD | Metal1 | 144.8600 | 975.6475 | 3.299999
FILLER_232_140 | VDD | Metal1 | 141.6265 | 975.5030 | 3.299999
FILLER_232_133 | VDD | Metal1 | 135.5200 | 976.0800 | 3.299999
FILLER_232_124 | VDD | Metal1 | 130.2000 | 976.0800 | 3.299999
FILLER_232_122 | VDD | Metal1 | 129.3600 | 976.0800 | 3.299999
FILLER_232_113 | VDD | Metal1 | 124.0400 | 976.0800 | 3.299999
FILLER_232_111 | VDD | Metal1 | 123.2000 | 976.0800 | 3.299999
FILLER_232_107 | VDD | Metal1 | 121.9000 | 975.6475 | 3.299999
FILLER_232_101 | VDD | Metal1 | 118.5400 | 975.6475 | 3.299999
FILLER_232_37 | VDD | Metal1 | 99.8350 | 975.2655 | 3.299999
FILLER_232_34 | VDD | Metal1 | 79.8000 | 976.0800 | 3.299999
FILLER_232_32 | VDD | Metal1 | 78.9600 | 976.0800 | 3.299999
FILLER_232_28 | VDD | Metal1 | 77.6600 | 975.6475 | 3.299999
FILLER_232_12 | VDD | Metal1 | 72.2880 | 975.3880 | 3.299999
FILLER_232_6 | VDD | Metal1 | 64.4000 | 976.0800 | 3.299999
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
