llhtimlam/Probton/librelane/Digital_Domain_Padframe/57-openroad-irdropreport/net-VSS.csv

Instance | Terminal | Layer | X location | Y location | Voltage
FILLER_250_1764 | VSS | Metal1 | 1048.6000 | 1042.7200 | 0.000000
FILLER_250_1760 | VSS | Metal1 | 1046.8200 | 1043.0685 | 0.000000
FILLER_250_1752 | VSS | Metal1 | 1043.3330 | 1043.1815 | 0.000000
FILLER_250_1736 | VSS | Metal1 | 1036.5120 | 1043.2680 | 0.000000
FILLER_250_1702 | VSS | Metal1 | 1021.8840 | 1043.3175 | 0.000000
FILLER_250_1668 | VSS | Metal1 | 1002.8440 | 1043.3175 | 0.000000
FILLER_250_1634 | VSS | Metal1 | 983.8040 | 1043.3175 | 0.000000
FILLER_250_1600 | VSS | Metal1 | 964.7640 | 1043.3175 | 0.000000
FILLER_250_1566 | VSS | Metal1 | 945.7240 | 1043.3175 | 0.000000
FILLER_250_1532 | VSS | Metal1 | 926.6840 | 1043.3175 | 0.000000
FILLER_250_1498 | VSS | Metal1 | 907.6440 | 1043.3175 | 0.000000
FILLER_250_1464 | VSS | Metal1 | 888.6040 | 1043.3175 | 0.000000
FILLER_250_1430 | VSS | Metal1 | 869.5640 | 1043.3175 | 0.000000
FILLER_250_1396 | VSS | Metal1 | 850.5240 | 1043.3175 | 0.000000
FILLER_250_1362 | VSS | Metal1 | 831.4840 | 1043.3175 | 0.000000
FILLER_250_1328 | VSS | Metal1 | 812.4440 | 1043.3175 | 0.000000
FILLER_250_1294 | VSS | Metal1 | 793.4040 | 1043.3175 | 0.000000
FILLER_250_1260 | VSS | Metal1 | 774.3640 | 1043.3175 | 0.000000
FILLER_250_1226 | VSS | Metal1 | 755.3240 | 1043.3175 | 0.000000
FILLER_250_1192 | VSS | Metal1 | 736.2840 | 1043.3175 | 0.000000
FILLER_250_1158 | VSS | Metal1 | 717.2440 | 1043.3175 | 0.000000
FILLER_250_1152 | VSS | Metal1 | 706.3400 | 1043.0685 | 0.000000
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
FILLER_232_259 | VSS | Metal1 | 206.0800 | 972.1600 | 0.000001
FILLER_232_247 | VSS | Metal1 | 199.5400 | 972.5085 | 0.000001
FILLER_232_244 | VSS | Metal1 | 197.4000 | 972.1600 | 0.000001
FILLER_232_242 | VSS | Metal1 | 196.5600 | 972.1600 | 0.000001
FILLER_232_238 | VSS | Metal1 | 194.5000 | 972.5085 | 0.000001
FILLER_232_206 | VSS | Metal1 | 184.1240 | 972.7575 | 0.000001
FILLER_232_197 | VSS | Metal1 | 171.0800 | 972.1600 | 0.000001
FILLER_232_193 | VSS | Metal1 | 169.3000 | 972.5085 | 0.000001
FILLER_232_177 | VSS | Metal1 | 163.4720 | 972.7080 | 0.000000
FILLER_232_171 | VSS | Metal1 | 156.9800 | 972.5085 | 0.000000
FILLER_232_163 | VSS | Metal1 | 153.4930 | 972.6215 | 0.000000
FILLER_232_154 | VSS | Metal1 | 147.0000 | 972.1600 | 0.000000
FILLER_232_152 | VSS | Metal1 | 146.1600 | 972.1600 | 0.000000
FILLER_232_148 | VSS | Metal1 | 144.1000 | 972.5085 | 0.000001
FILLER_232_140 | VSS | Metal1 | 140.6130 | 972.6215 | 0.000001
FILLER_232_133 | VSS | Metal1 | 135.5200 | 972.1600 | 0.000001
FILLER_232_124 | VSS | Metal1 | 130.2000 | 972.1600 | 0.000001
FILLER_232_122 | VSS | Metal1 | 129.3600 | 972.1600 | 0.000001
FILLER_232_113 | VSS | Metal1 | 124.0400 | 972.1600 | 0.000001
FILLER_232_111 | VSS | Metal1 | 123.2000 | 972.1600 | 0.000000
FILLER_232_107 | VSS | Metal1 | 121.1400 | 972.5085 | 0.000000
FILLER_232_101 | VSS | Metal1 | 117.7800 | 972.5085 | 0.000000
FILLER_232_37 | VSS | Metal1 | 98.4045 | 972.7975 | 0.000000
FILLER_232_34 | VSS | Metal1 | 79.8000 | 972.1600 | 0.000000
FILLER_232_32 | VSS | Metal1 | 78.9600 | 972.1600 | 0.000000
FILLER_232_28 | VSS | Metal1 | 76.9000 | 972.5085 | 0.000000
FILLER_232_12 | VSS | Metal1 | 71.0720 | 972.7080 | 0.000000
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
