llhtimlam/Probton/librelane/Digital_Domain/50-odb-reportwirelength/wire_lengths.csv

net | length_um
clknet_0_clk | 1.68019mm
net2685 | 1.13583mm
net1762 | 703.92µm
_03527_ | 702.44µm
digital_domain_inst.cfg_phase270_offset_x\[15\] | 694.6µm
net1177 | 681.75µm
net13 | 681.52µm
net1933 | 680.75µm
net1897 | 670.52µm
digital_domain_inst.cfg_f_MEMS_fcw_y\[10\] | 667.01µm
net1697 | 666.04µm
net1768 | 636.31µm
net1211 | 632.95µm
net2684 | 629.49µm
net1901 | 626.18µm
net993 | 617.83µm
net19 | 617.12µm
net796 | 606.63µm
net2236 | 590.95µm
digital_domain_inst.raw_edge3_y\[17\] | 589.17µm
digital_domain_inst.cfg_phase0_offset_x\[10\] | 583.21µm
net2219 | 579.98µm
digital_domain_inst.raw_edge2_y\[17\] | 579.29µm
net1066 | 578.17µm
digital_domain_inst.raw_edge3_y\[19\] | 574.15µm
_05282_ | 574.1µm
_05562_ | 573.64µm
digital_domain_inst.raw_edge1_y\[19\] | 571.77µm
net587 | 562.9µm
digital_domain_inst.latch_error_x | 549.46µm
net2298 | 542.69µm
net1785 | 539.84µm
digital_domain_inst.raw_edge1_y\[13\] | 537.7µm
net21 | 534.39µm
net1086 | 530.01µm
digital_domain_inst.jitter_flag_x | 529.86µm
digital_domain_inst.raw_edge2_y\[16\] | 529.4µm
net1541 | 527.57µm
_03589_ | 522.68µm
digital_domain_inst.raw_edge1_x\[17\] | 520.34µm
net1393 | 508.97µm
net1120 | 508.68µm
_05671_ | 506.39µm
net1531 | 505.88µm
net1568 | 504.71µm
digital_domain_inst.cfg_phase90_offset_x\[20\] | 503.03µm
net1765 | 502.52µm
net166 | 500.69µm
net772 | 479.92µm
net2045 | 474.88µm
net1972 | 471.01µm
net1122 | 468.51µm
digital_domain_inst.raw_edge3_x\[19\] | 460.47µm
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
_04656_ | 46.63µm
_05654_ | 46.63µm
net664 | 46.63µm
_00869_ | 46.58µm
_02256_ | 46.58µm
_02338_ | 46.58µm
_03345_ | 46.58µm
_04572_ | 46.58µm
net298 | 46.58µm
net625 | 46.58µm
net1676 | 46.58µm
_01609_ | 46.53µm
_04155_ | 46.53µm
_05268_ | 46.53µm
net72 | 46.53µm
net217 | 46.53µm
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
