llhtimlam/Probton/librelane/Digital_Domain/56-openroad-irdropreport/net-VDD.csv

Instance | Terminal | Layer | X location | Y location | Voltage
FILLER_279_1960 | VDD | Metal1 | 1098.1600 | 1105.4400 | 3.299997
FILLER_279_1956 | VDD | Metal1 | 1096.8600 | 1105.8725 | 3.299997
FILLER_279_1940 | VDD | Metal1 | 1091.4880 | 1106.1320 | 3.299997
FILLER_279_1906 | VDD | Metal1 | 1076.9955 | 1106.2085 | 3.299997
FILLER_279_1872 | VDD | Metal1 | 1057.9555 | 1106.2085 | 3.299997
FILLER_279_1838 | VDD | Metal1 | 1038.9155 | 1106.2085 | 3.299997
FILLER_279_1804 | VDD | Metal1 | 1019.8755 | 1106.2085 | 3.299997
FILLER_279_1770 | VDD | Metal1 | 1000.8355 | 1106.2085 | 3.299997
FILLER_279_1736 | VDD | Metal1 | 981.7955 | 1106.2085 | 3.299997
FILLER_279_1733 | VDD | Metal1 | 970.7600 | 1105.4400 | 3.299997
FILLER_279_1731 | VDD | Metal1 | 969.9200 | 1105.4400 | 3.299997
FILLER_279_1727 | VDD | Metal1 | 968.6200 | 1105.8725 | 3.299997
FILLER_279_1719 | VDD | Metal1 | 965.3865 | 1106.0165 | 3.299997
FILLER_279_1709 | VDD | Metal1 | 957.6000 | 1105.4400 | 3.299997
FILLER_279_1706 | VDD | Metal1 | 955.6400 | 1105.4400 | 3.299997
FILLER_279_1702 | VDD | Metal1 | 954.6200 | 1105.8725 | 3.299997
FILLER_279_1668 | VDD | Metal1 | 943.7155 | 1106.2085 | 3.299997
FILLER_279_1634 | VDD | Metal1 | 924.6755 | 1106.2085 | 3.299997
FILLER_279_1600 | VDD | Metal1 | 905.6355 | 1106.2085 | 3.299997
FILLER_279_1597 | VDD | Metal1 | 894.6000 | 1105.4400 | 3.299997
FILLER_279_1593 | VDD | Metal1 | 893.5800 | 1105.8725 | 3.299997
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
FILLER_262_859 | VDD | Metal1 | 482.5400 | 1042.2875 | 3.299994
FILLER_262_849 | VDD | Metal1 | 476.0000 | 1042.7200 | 3.299994
FILLER_262_834 | VDD | Metal1 | 467.6000 | 1042.7200 | 3.299994
FILLER_262_825 | VDD | Metal1 | 462.2800 | 1042.7200 | 3.299994
FILLER_262_823 | VDD | Metal1 | 461.4400 | 1042.7200 | 3.299994
FILLER_262_814 | VDD | Metal1 | 456.4000 | 1042.7200 | 3.299993
FILLER_262_807 | VDD | Metal1 | 452.2000 | 1042.7200 | 3.299993
FILLER_262_804 | VDD | Metal1 | 450.5200 | 1042.7200 | 3.299993
FILLER_262_800 | VDD | Metal1 | 449.5000 | 1042.2875 | 3.299993
FILLER_262_791 | VDD | Metal1 | 443.2400 | 1042.7200 | 3.299993
FILLER_262_783 | VDD | Metal1 | 441.2265 | 1042.1430 | 3.299993
FILLER_262_773 | VDD | Metal1 | 433.4400 | 1042.7200 | 3.299993
FILLER_262_762 | VDD | Metal1 | 427.2800 | 1042.7200 | 3.299993
FILLER_262_754 | VDD | Metal1 | 422.8000 | 1042.7200 | 3.299993
FILLER_262_737 | VDD | Metal1 | 413.0000 | 1042.7200 | 3.299993
FILLER_262_734 | VDD | Metal1 | 411.3200 | 1042.7200 | 3.299993
FILLER_262_732 | VDD | Metal1 | 410.4800 | 1042.7200 | 3.299993
FILLER_262_728 | VDD | Metal1 | 409.1800 | 1042.2875 | 3.299993
FILLER_262_717 | VDD | Metal1 | 402.0800 | 1042.7200 | 3.299993
FILLER_262_699 | VDD | Metal1 | 392.0000 | 1042.7200 | 3.299992
FILLER_262_675 | VDD | Metal1 | 378.2800 | 1042.7200 | 3.299992
FILLER_262_667 | VDD | Metal1 | 376.2665 | 1042.1430 | 3.299992
FILLER_262_664 | VDD | Metal1 | 372.1200 | 1042.7200 | 3.299992
FILLER_262_628 | VDD | Metal1 | 352.2400 | 1042.7200 | 3.299992
FILLER_262_616 | VDD | Metal1 | 345.5200 | 1042.7200 | 3.299992
FILLER_262_606 | VDD | Metal1 | 339.9200 | 1042.7200 | 3.299993
FILLER_262_597 | VDD | Metal1 | 334.6000 | 1042.7200 | 3.299993
FILLER_262_594 | VDD | Metal1 | 332.9200 | 1042.7200 | 3.299993
FILLER_262_581 | VDD | Metal1 | 325.6400 | 1042.7200 | 3.299993
FILLER_262_579 | VDD | Metal1 | 324.8000 | 1042.7200 | 3.299993
FILLER_262_561 | VDD | Metal1 | 314.7200 | 1042.7200 | 3.299993
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
