llhtimlam/Probton/librelane/Digital_Domain/56-openroad-irdropreport/net-VSS.csv

Instance | Terminal | Layer | X location | Y location | Voltage
FILLER_279_1960 | VSS | Metal1 | 1098.1600 | 1109.3600 | 0.000000
FILLER_279_1956 | VSS | Metal1 | 1096.1000 | 1109.0110 | 0.000000
FILLER_279_1940 | VSS | Metal1 | 1090.2720 | 1108.8120 | 0.000000
FILLER_279_1906 | VSS | Metal1 | 1075.6440 | 1108.7620 | 0.000000
FILLER_279_1872 | VSS | Metal1 | 1056.6040 | 1108.7620 | 0.000000
FILLER_279_1838 | VSS | Metal1 | 1037.5640 | 1108.7620 | 0.000000
FILLER_279_1804 | VSS | Metal1 | 1018.5240 | 1108.7620 | 0.000000
FILLER_279_1770 | VSS | Metal1 | 999.4840 | 1108.7620 | 0.000000
FILLER_279_1736 | VSS | Metal1 | 980.4440 | 1108.7620 | 0.000000
FILLER_279_1733 | VSS | Metal1 | 970.7600 | 1109.3600 | 0.000000
FILLER_279_1731 | VSS | Metal1 | 969.9200 | 1109.3600 | 0.000001
FILLER_279_1727 | VSS | Metal1 | 967.8600 | 1109.0110 | 0.000001
FILLER_279_1719 | VSS | Metal1 | 964.3730 | 1108.8980 | 0.000001
FILLER_279_1709 | VSS | Metal1 | 957.6000 | 1109.3600 | 0.000001
FILLER_279_1706 | VSS | Metal1 | 955.6400 | 1109.3600 | 0.000001
FILLER_279_1702 | VSS | Metal1 | 953.8600 | 1109.0110 | 0.000001
FILLER_279_1668 | VSS | Metal1 | 942.3640 | 1108.7620 | 0.000001
FILLER_279_1634 | VSS | Metal1 | 923.3240 | 1108.7620 | 0.000001
FILLER_279_1600 | VSS | Metal1 | 904.2840 | 1108.7620 | 0.000001
FILLER_279_1597 | VSS | Metal1 | 894.6000 | 1109.3600 | 0.000001
FILLER_279_1593 | VSS | Metal1 | 892.8200 | 1109.0110 | 0.000001
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
FILLER_277_346 | VSS | Metal1 | 194.5000 | 1101.1710 | 0.000013
FILLER_277_282 | VSS | Metal1 | 175.1245 | 1100.8820 | 0.000013
FILLER_277_276 | VSS | Metal1 | 155.3000 | 1101.1710 | 0.000013
FILLER_277_212 | VSS | Metal1 | 135.9245 | 1100.8820 | 0.000013
FILLER_277_206 | VSS | Metal1 | 116.1000 | 1101.1710 | 0.000013
FILLER_277_142 | VSS | Metal1 | 96.7245 | 1100.8820 | 0.000013
FILLER_277_139 | VSS | Metal1 | 78.1200 | 1101.5200 | 0.000013
FILLER_277_107 | VSS | Metal1 | 68.2040 | 1100.9220 | 0.000013
FILLER_277_72 | VSS | Metal1 | 40.6000 | 1101.5200 | 0.000013
FILLER_277_66 | VSS | Metal1 | 37.7000 | 1101.1710 | 0.000013
FILLER_277_2 | VSS | Metal1 | 18.3245 | 1100.8820 | 0.000013
FILLER_276_1961 | VSS | Metal1 | 1098.4400 | 1093.6800 | 0.000001
FILLER_276_1959 | VSS | Metal1 | 1097.6000 | 1093.6800 | 0.000001
FILLER_276_1927 | VSS | Metal1 | 1087.4040 | 1094.2775 | 0.000001
FILLER_276_1921 | VSS | Metal1 | 1076.5000 | 1094.0285 | 0.000001
FILLER_276_1857 | VSS | Metal1 | 1057.1245 | 1094.3175 | 0.000001
FILLER_276_1851 | VSS | Metal1 | 1037.3000 | 1094.0285 | 0.000001
FILLER_276_1787 | VSS | Metal1 | 1017.9245 | 1094.3175 | 0.000001
FILLER_276_1781 | VSS | Metal1 | 998.1000 | 1094.0285 | 0.000001
FILLER_276_1717 | VSS | Metal1 | 978.7245 | 1094.3175 | 0.000001
FILLER_276_1711 | VSS | Metal1 | 958.9000 | 1094.0285 | 0.000001
FILLER_276_1647 | VSS | Metal1 | 939.5245 | 1094.3175 | 0.000001
FILLER_276_1641 | VSS | Metal1 | 919.7000 | 1094.0285 | 0.000001
FILLER_276_1577 | VSS | Metal1 | 900.3245 | 1094.3175 | 0.000001
FILLER_276_1571 | VSS | Metal1 | 880.5000 | 1094.0285 | 0.000001
FILLER_276_1507 | VSS | Metal1 | 861.1245 | 1094.3175 | 0.000001
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
