llhtimlam/Probton/librelane/backup_with_analog/Digital_Domain/59-klayout-render/wrapper.png

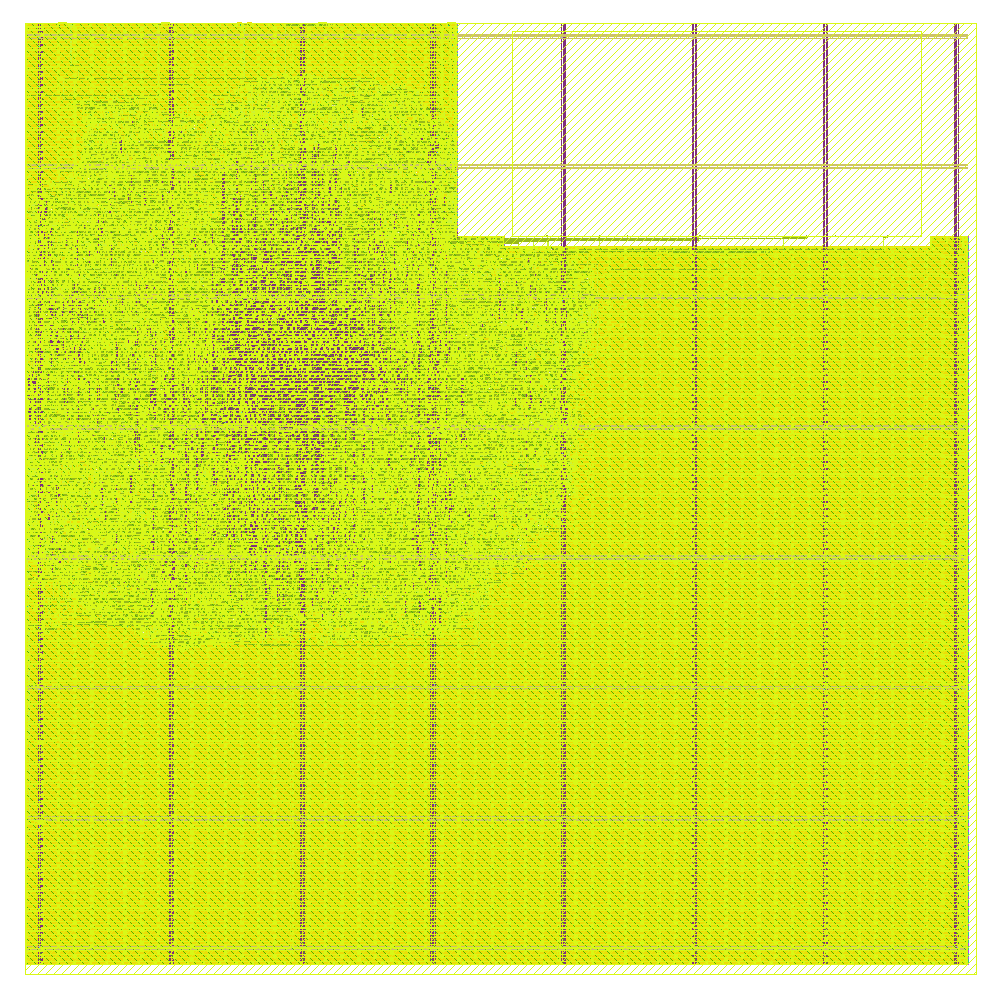
librelane/backup_with_analog/Digital_Domain/59-klayout-render/wrapper.png
