llhtimlam/Probton/librelane/Digital_Domain/59-klayout-render/wrapper.png

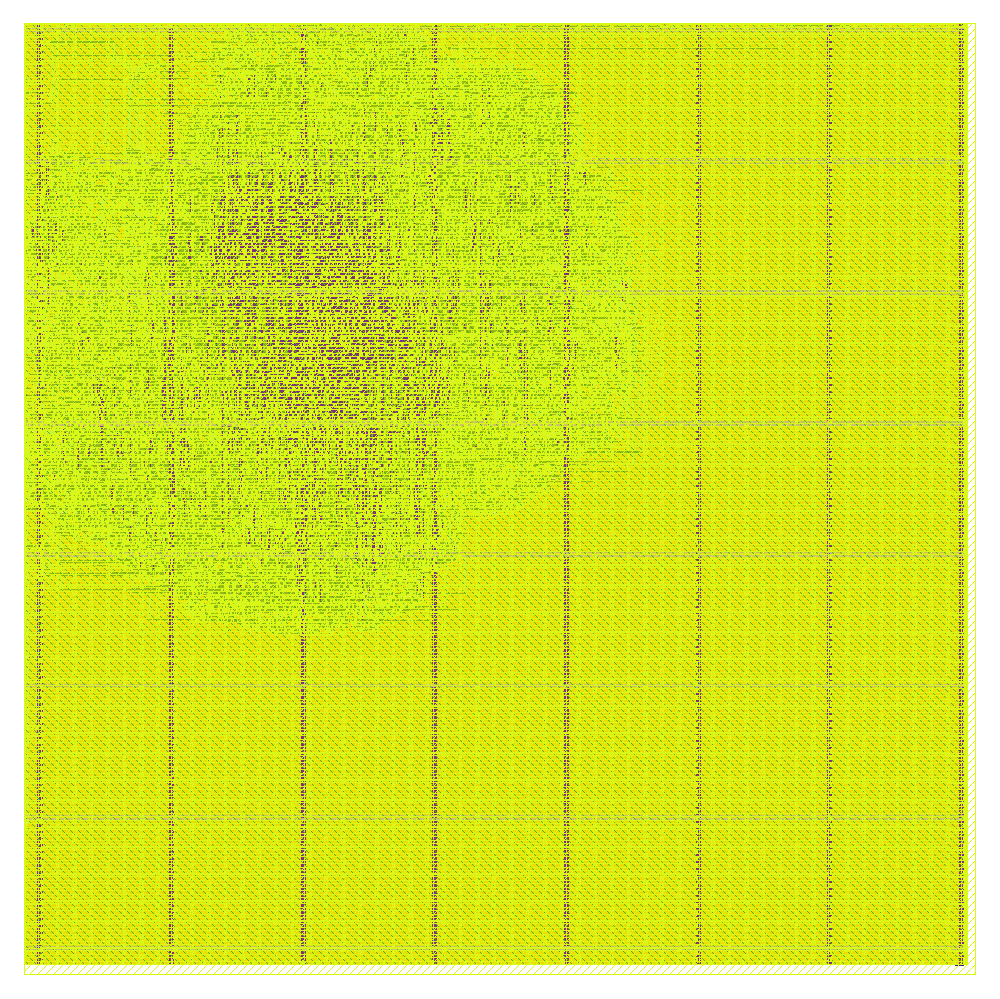
librelane/Digital_Domain/59-klayout-render/wrapper.png
