llhtimlam/Probton/librelane/Digital_Domain_Padframe/60-klayout-render/B18_Probton.png

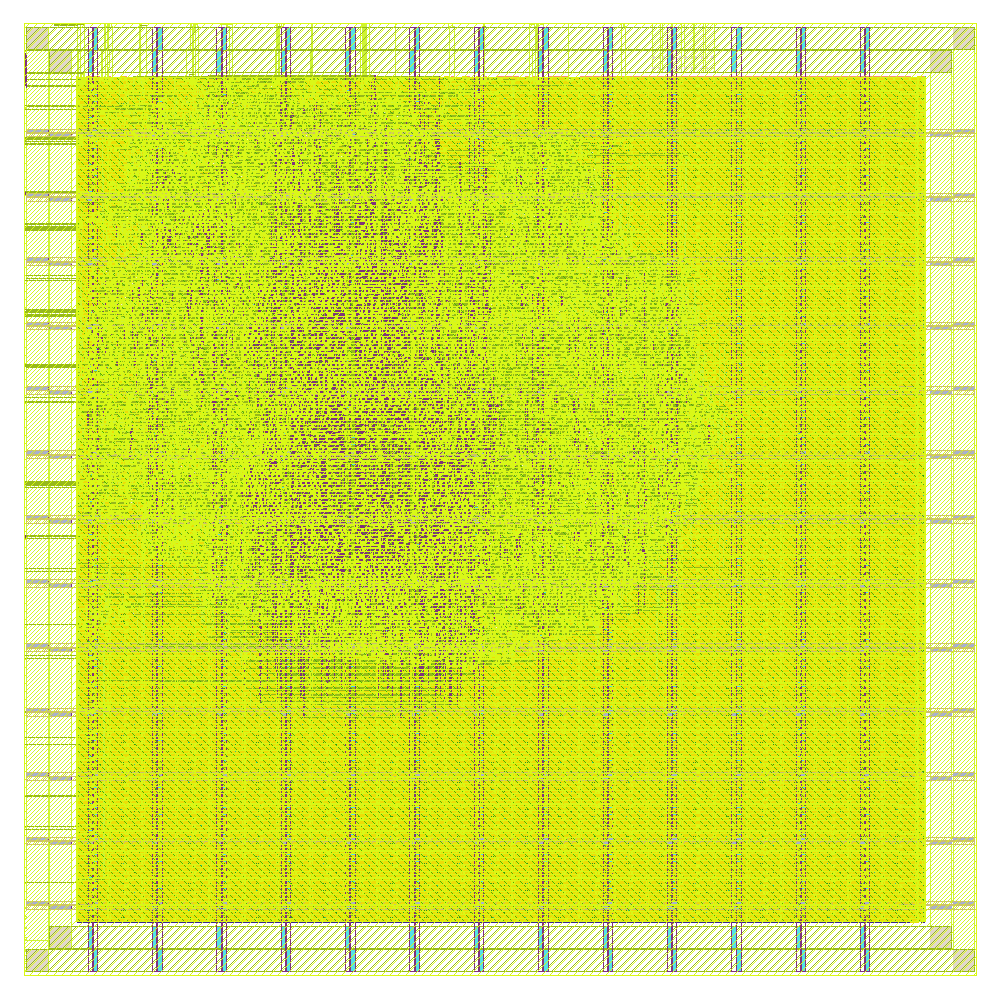
librelane/Digital_Domain_Padframe/60-klayout-render/B18_Probton.png
