llhtimlam/Probton/librelane/Digital_RTL_GDS/59-klayout-render/digital_domain.png

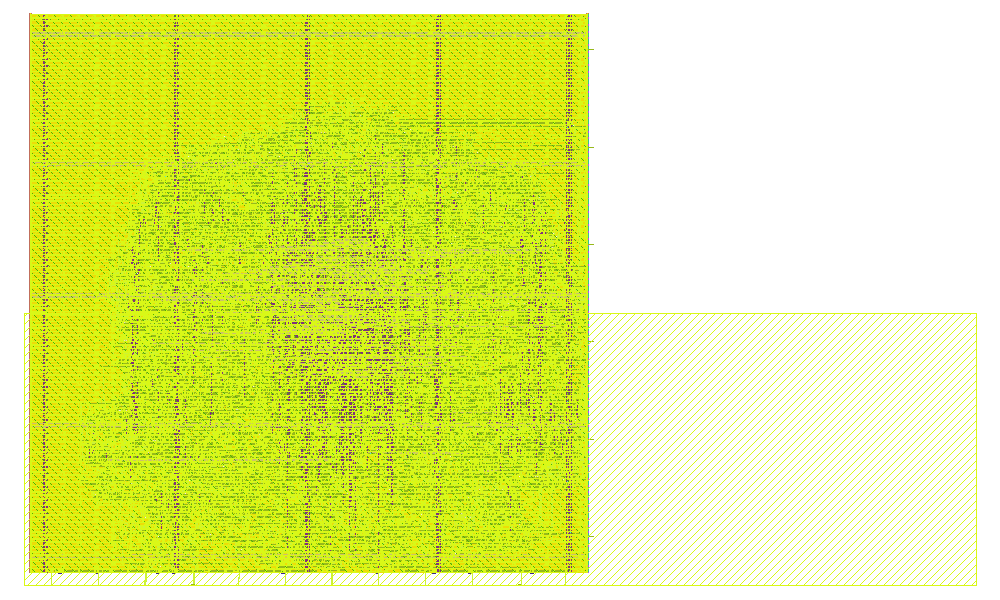
librelane/Digital_RTL_GDS/59-klayout-render/digital_domain.png
