llhtimlam/Probton/librelane/Digital_RTL_GDS_Block_B_failed_carved/59-klayout-render/chip_core.png

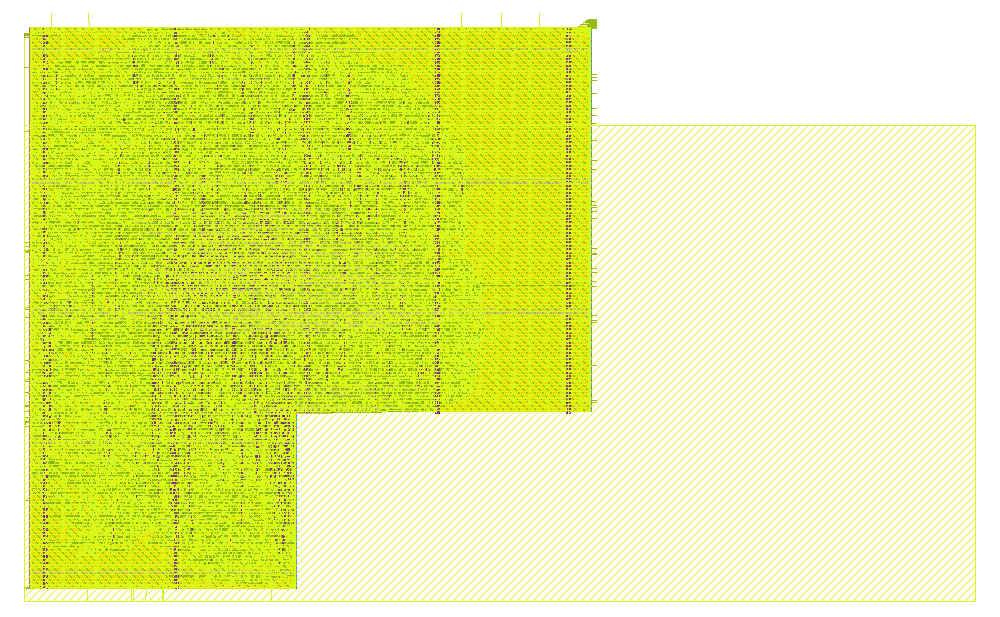
librelane/Digital_RTL_GDS_Block_B_failed_carved/59-klayout-render/chip_core.png
