llhtimlam/Probton/librelane/Submodule/Digital_RTL_GDS_signal_processor/59-klayout-render/signal_processor.png

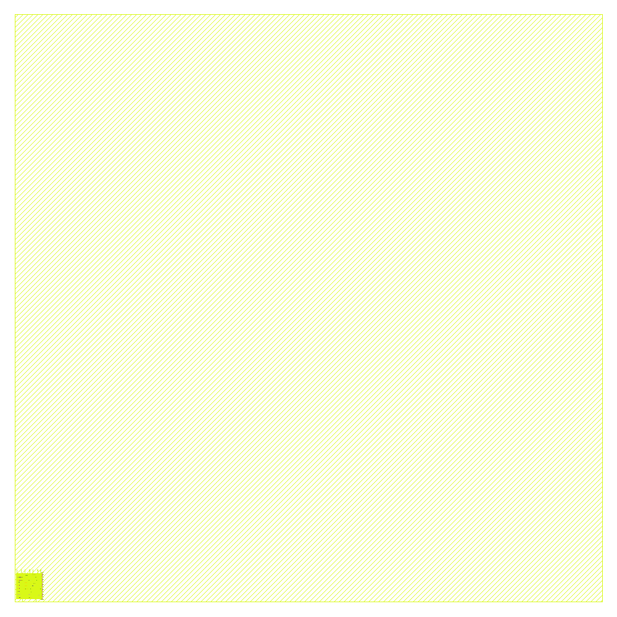
librelane/Submodule/Digital_RTL_GDS_signal_processor/59-klayout-render/signal_processor.png
