llhtimlam/Probton/librelane/Submodule/Digital_RTL_GDS_spi/59-klayout-render/spi_regs.png

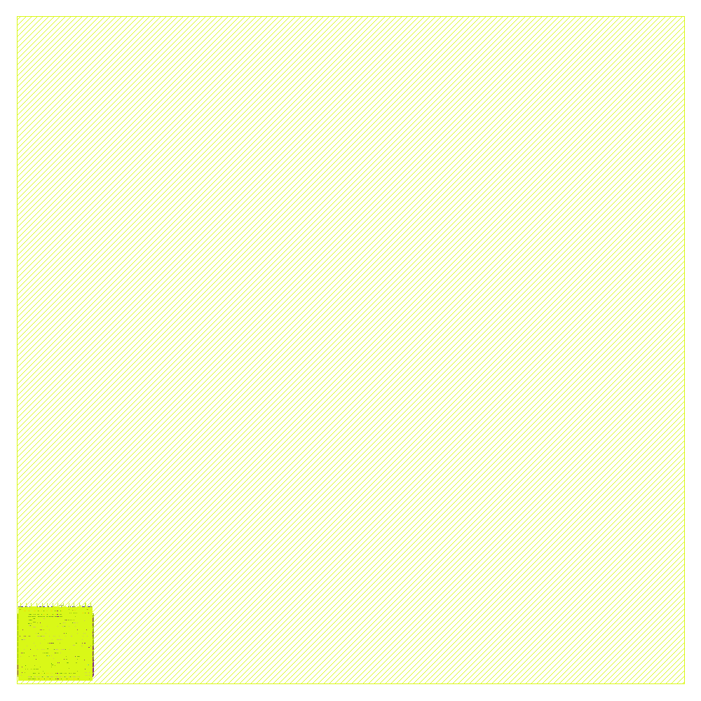
librelane/Submodule/Digital_RTL_GDS_spi/59-klayout-render/spi_regs.png
