llhtimlam/Probton/librelane/Submodule/Digital_RTL_GDS_wave_controller/59-klayout-render/wave_controller.png

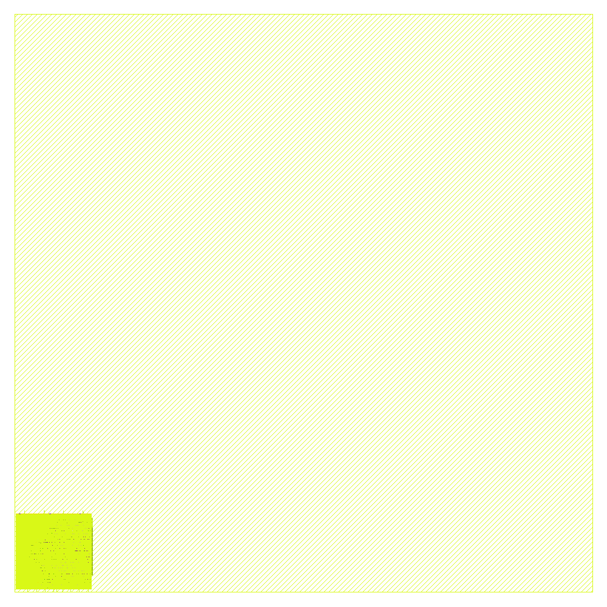
librelane/Submodule/Digital_RTL_GDS_wave_controller/59-klayout-render/wave_controller.png
