llhtimlam/Probton/Media/ChipArchitect/Optical Probe Station Dark Chip Architect.png

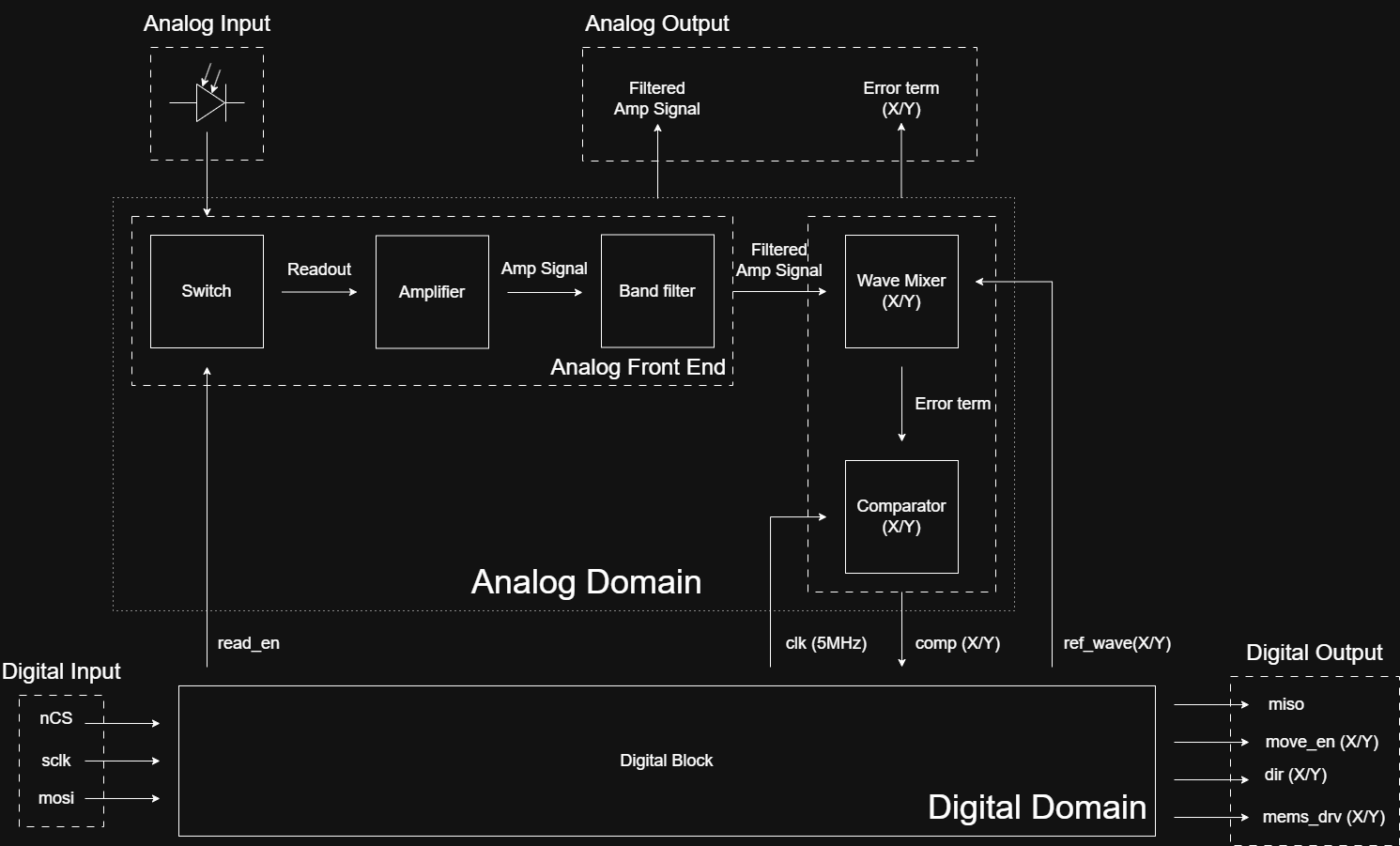
Media/ChipArchitect/Optical Probe Station Dark Chip Architect.png
