llhtimlam/Probton/Media/ChipArchitect/Optical Probe Station Dark RTL Traffic.png

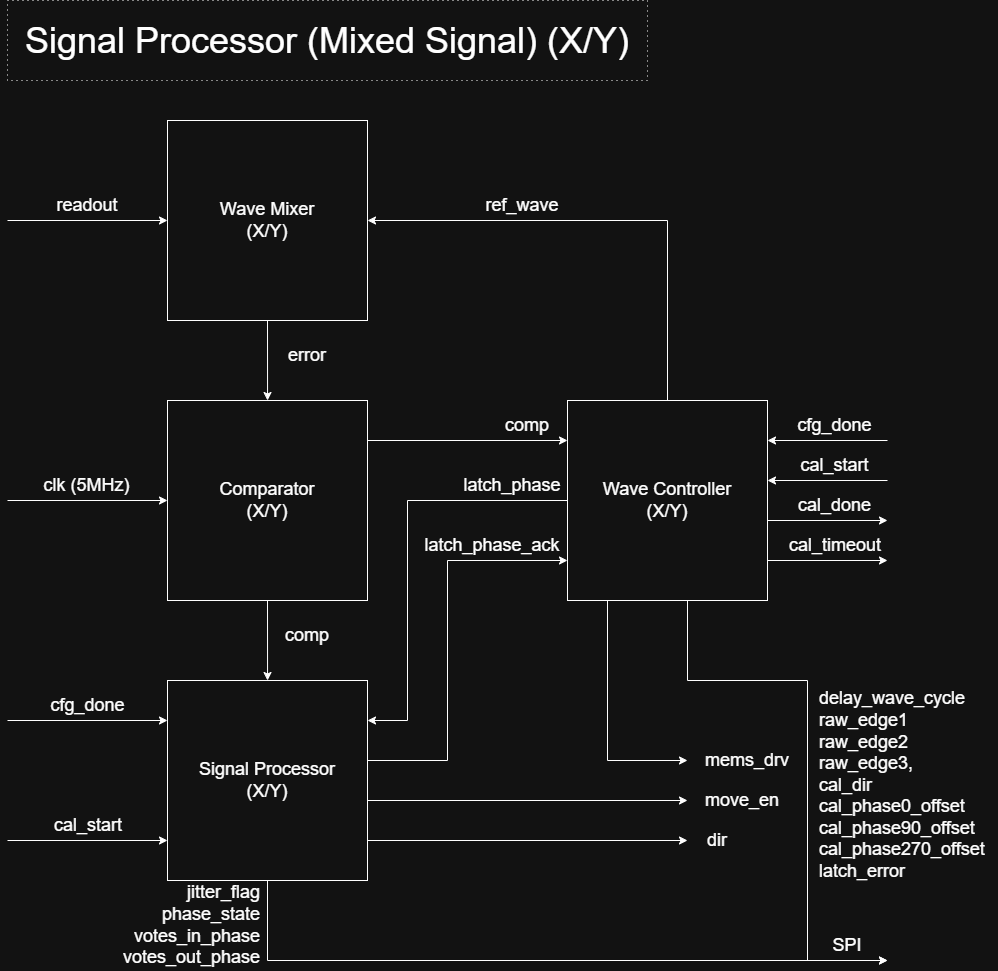
Media/ChipArchitect/Optical Probe Station Dark RTL Traffic.png
