llhtimlam/Probton/Media/ChipArchitect/Optical Probe Station Dark Signal Processor.png

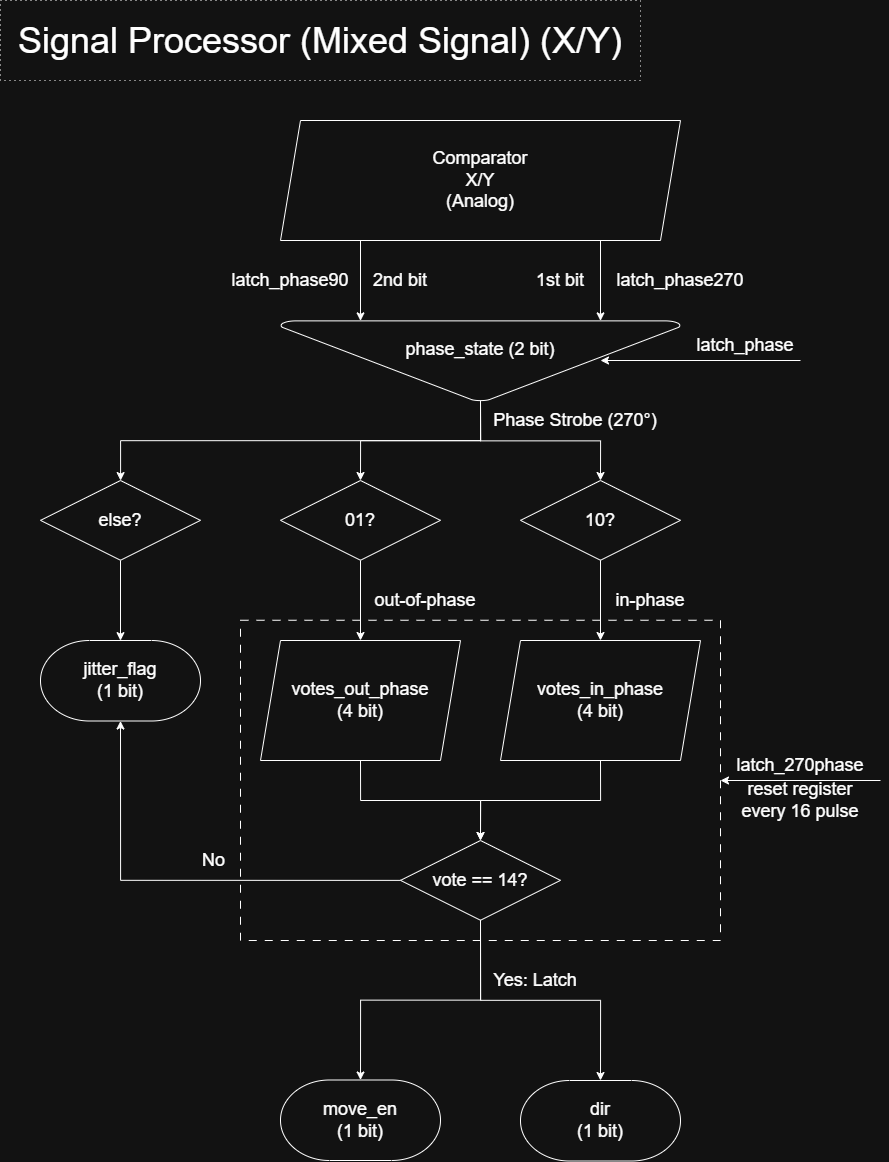
Media/ChipArchitect/Optical Probe Station Dark Signal Processor.png
