llhtimlam/Probton/Media/ChipArchitect/Optical Probe Station Dark State Machine.png

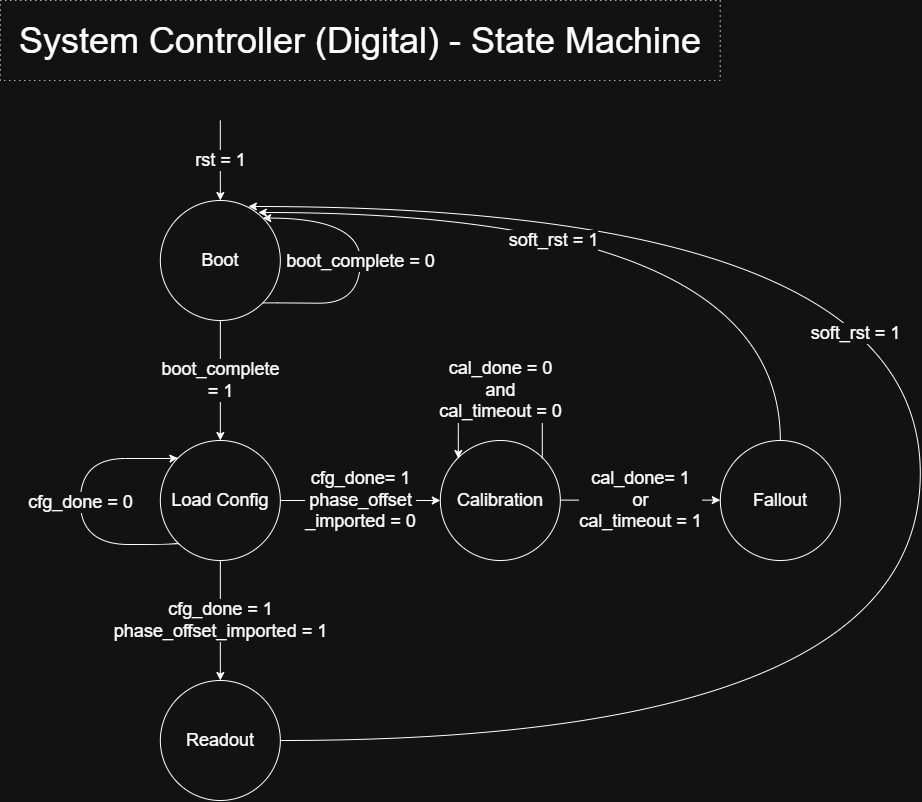
Media/ChipArchitect/Optical Probe Station Dark State Machine.png
