llhtimlam/Probton/Media/ChipArchitect/Optical Probe Station State Machine.png

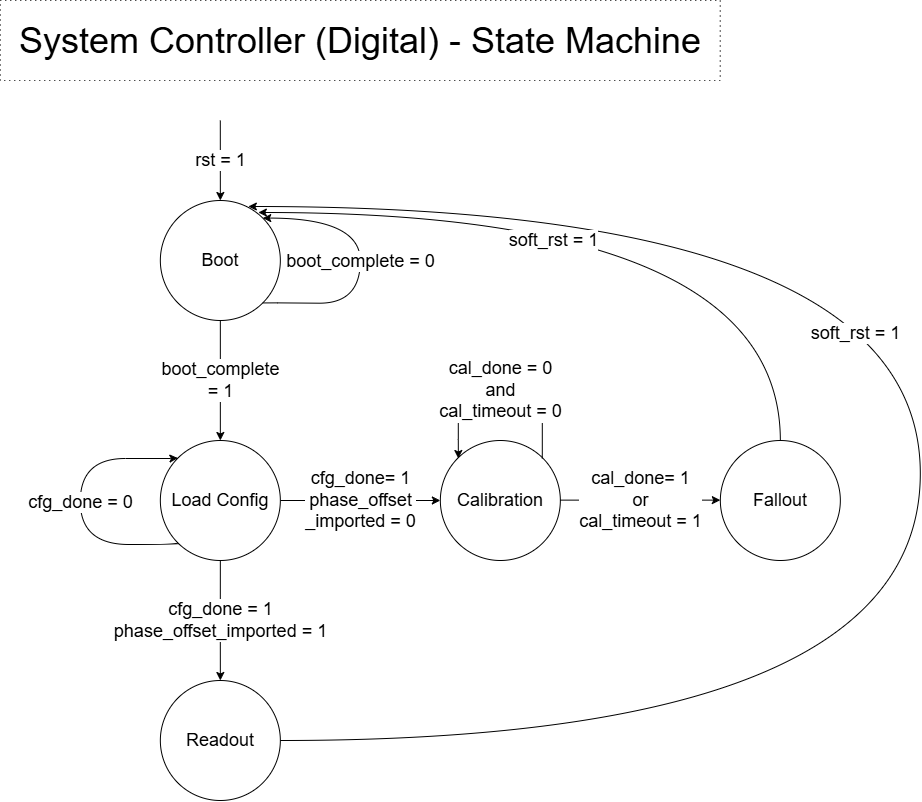
Media/ChipArchitect/Optical Probe Station State Machine.png
