llhtimlam/Probton/Media/ChipArchitect/Version Schematic/Optical Probe Station Dark Chip Architect.png

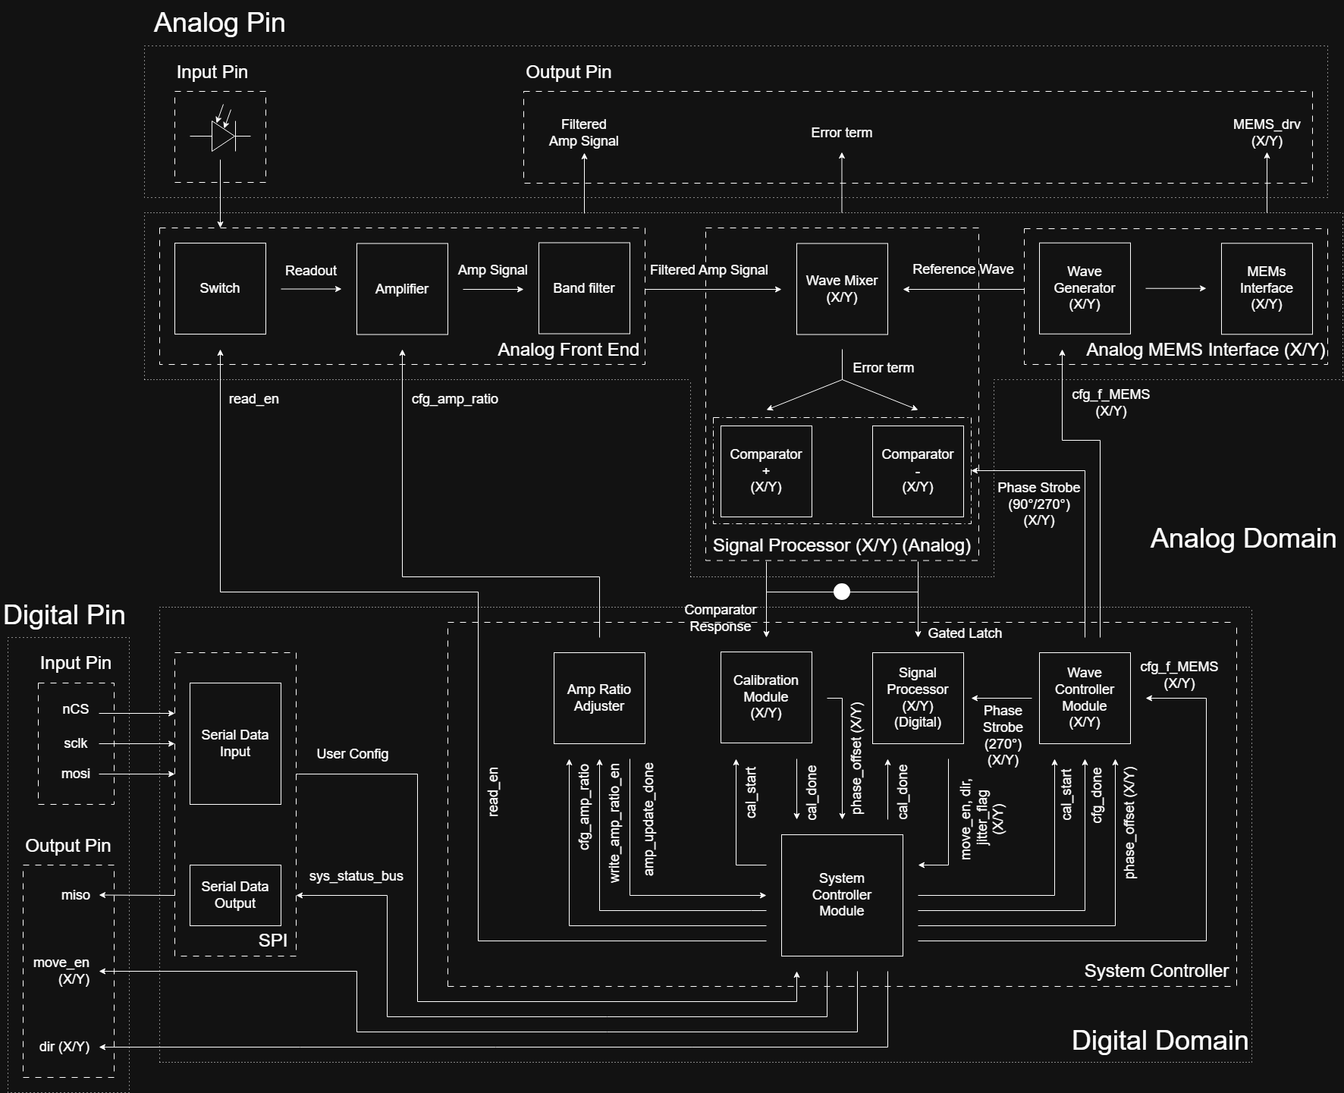
Media/ChipArchitect/Version Schematic/Optical Probe Station Dark Chip Architect.png
