llhtimlam/Probton/Media/ChipArchitect/Version Schematic/Optical Probe Station Dark Full Design.png

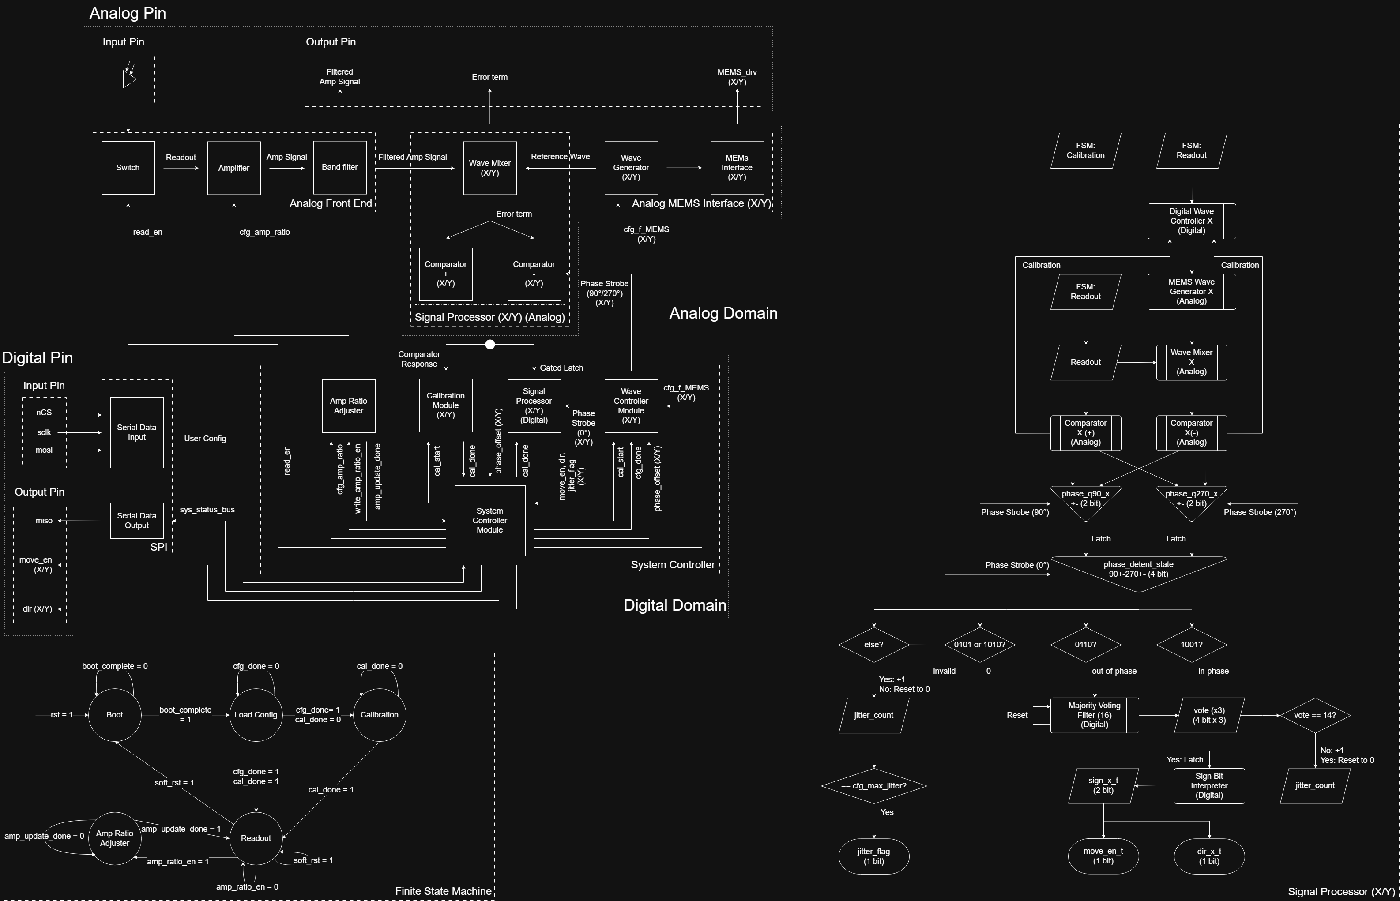
Media/ChipArchitect/Version Schematic/Optical Probe Station Dark Full Design.png
