llhtimlam/Probton/Media/ChipArchitect/Version Schematic/Optical Probe Station Dark Signal Processor.png

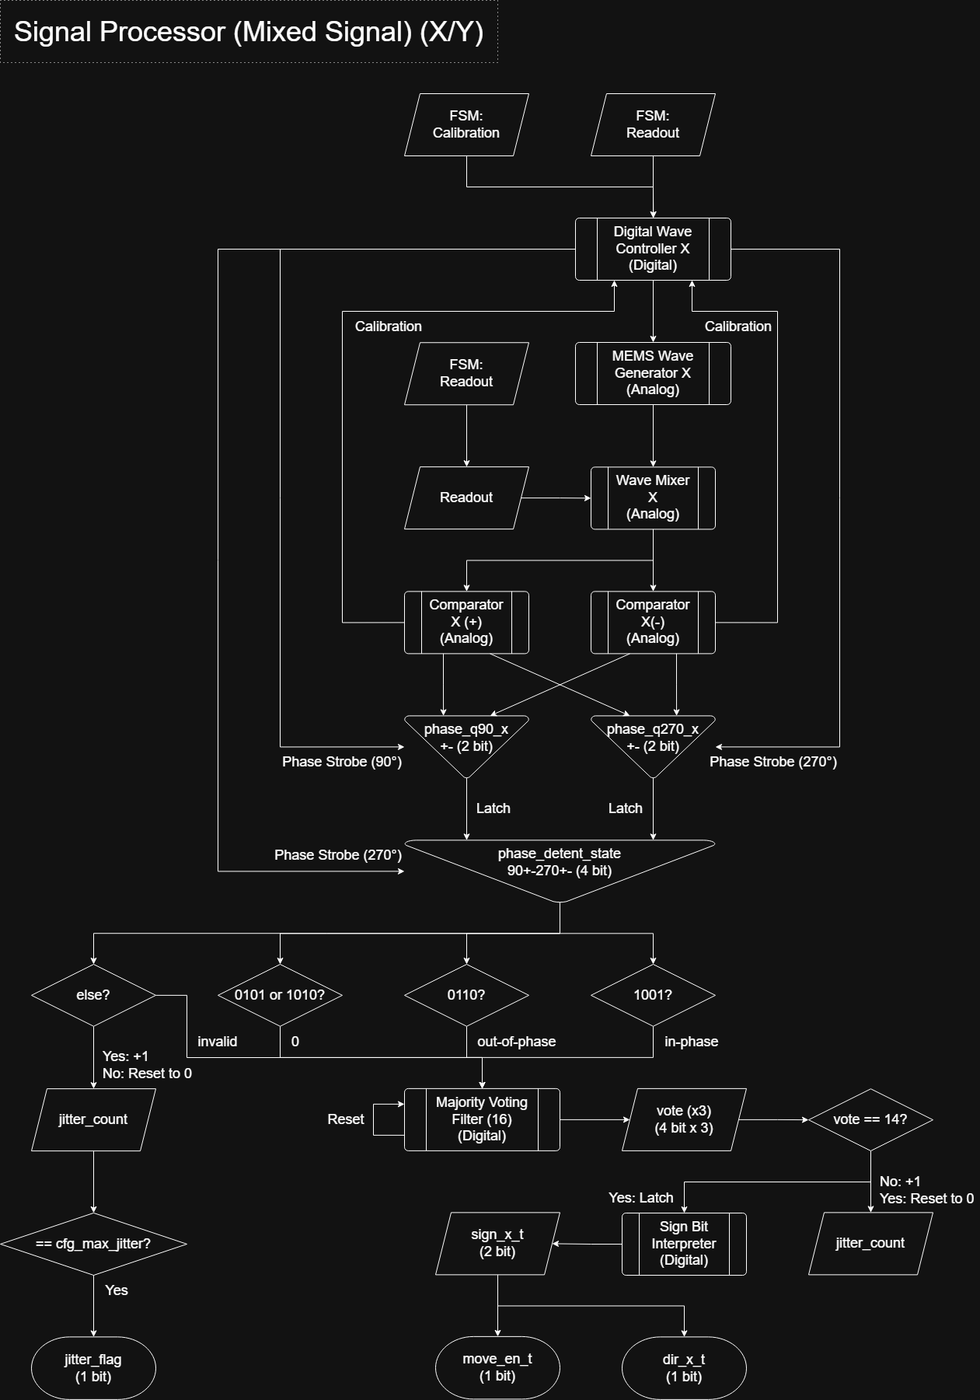
Media/ChipArchitect/Version Schematic/Optical Probe Station Dark Signal Processor.png
