llhtimlam/Probton/Media/ChipArchitect/Version Schematic/Optical Probe Station Dark State Machine.png

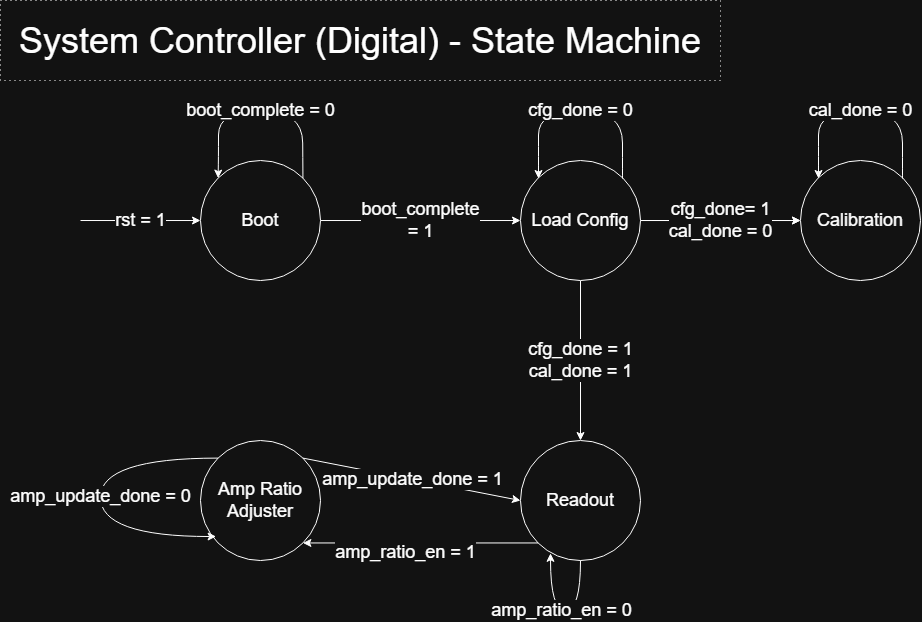
Media/ChipArchitect/Version Schematic/Optical Probe Station Dark State Machine.png
