llhtimlam/Probton/Media/ChipArchitect/Version Schematic/Optical Probe Station Full Design.png

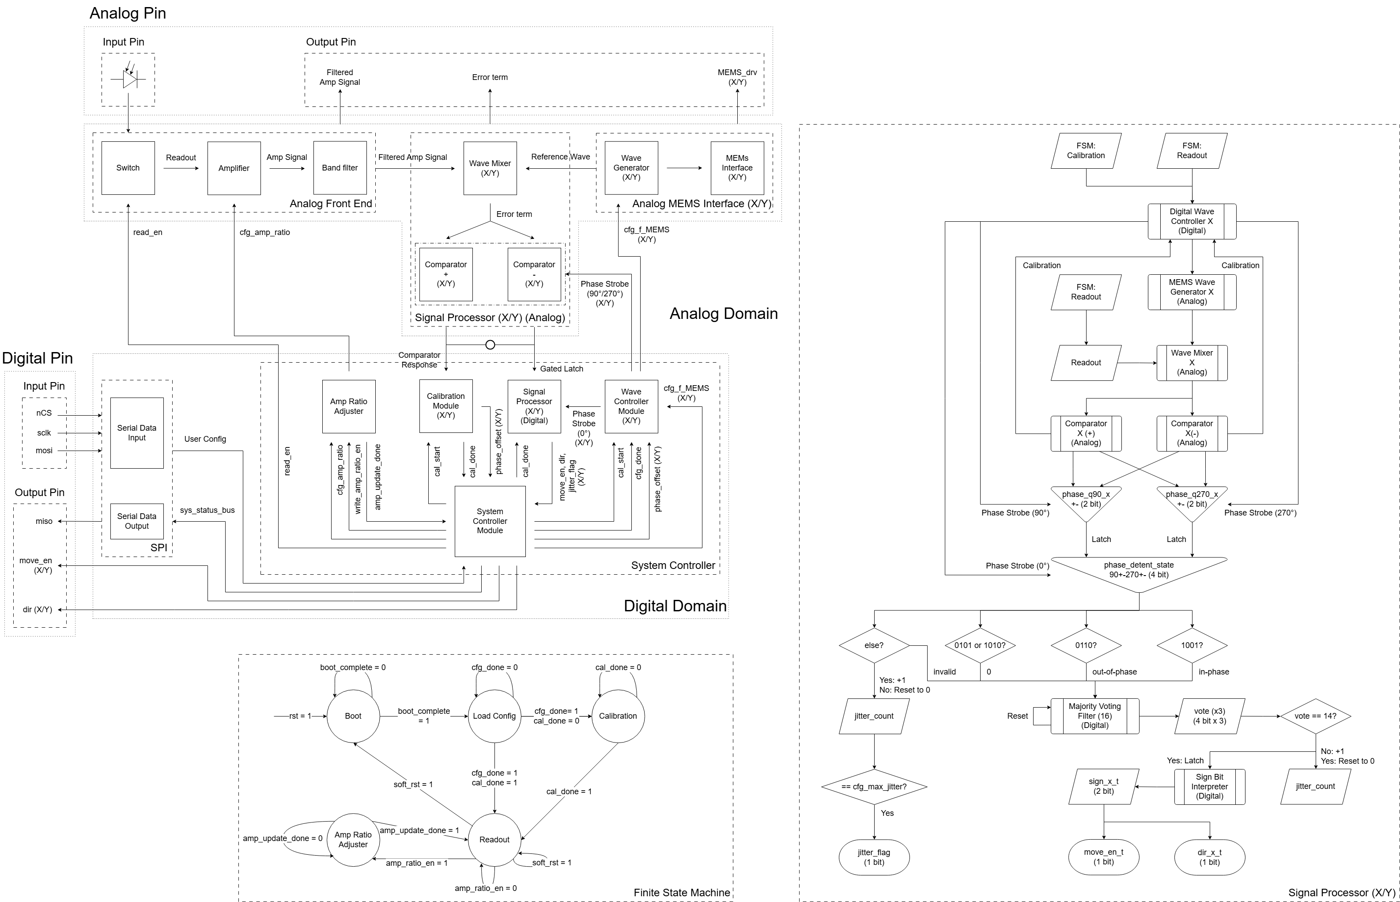
Media/ChipArchitect/Version Schematic/Optical Probe Station Full Design.png
