llhtimlam/Probton/Media/ChipArchitect/Version Schematic/Optical Probe Station State Machine.png

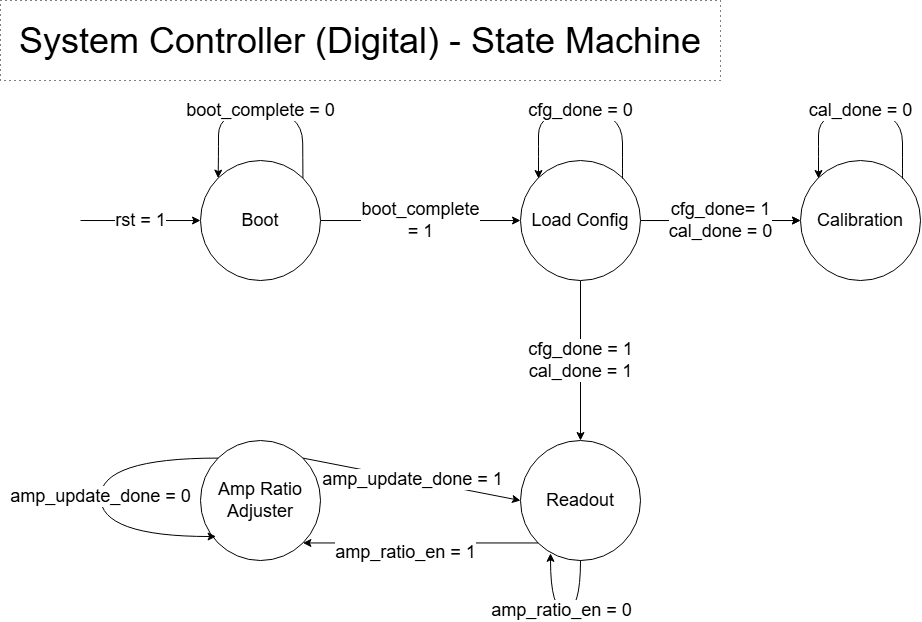
Media/ChipArchitect/Version Schematic/Optical Probe Station State Machine.png
