llhtimlam/Probton/Media/ChipArchitect/Version Simulation/Optical Probe Station Dark State Machine.png

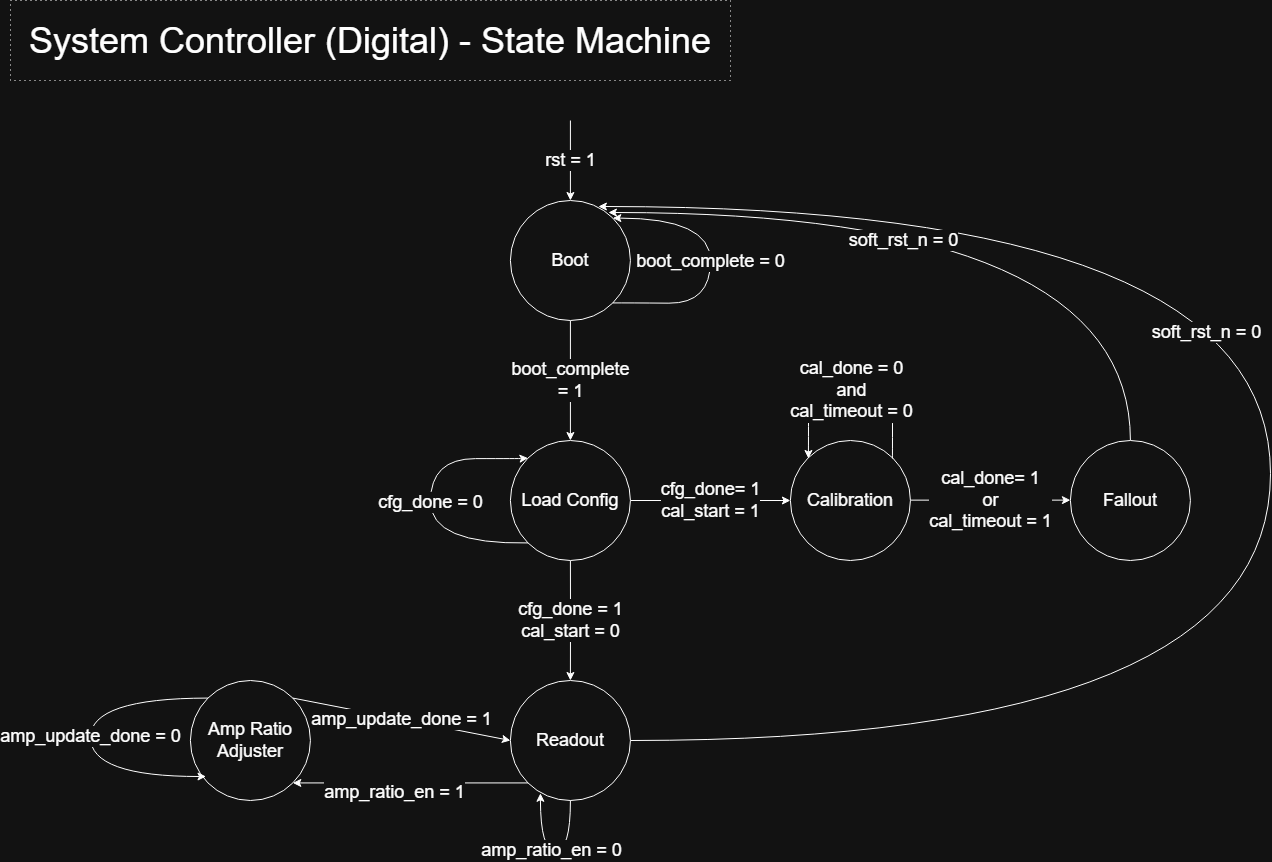
Media/ChipArchitect/Version Simulation/Optical Probe Station Dark State Machine.png
