llhtimlam/Probton/Media/ChipArchitect/VersionProposal/Optical Probe Station Digital Algorithm.png

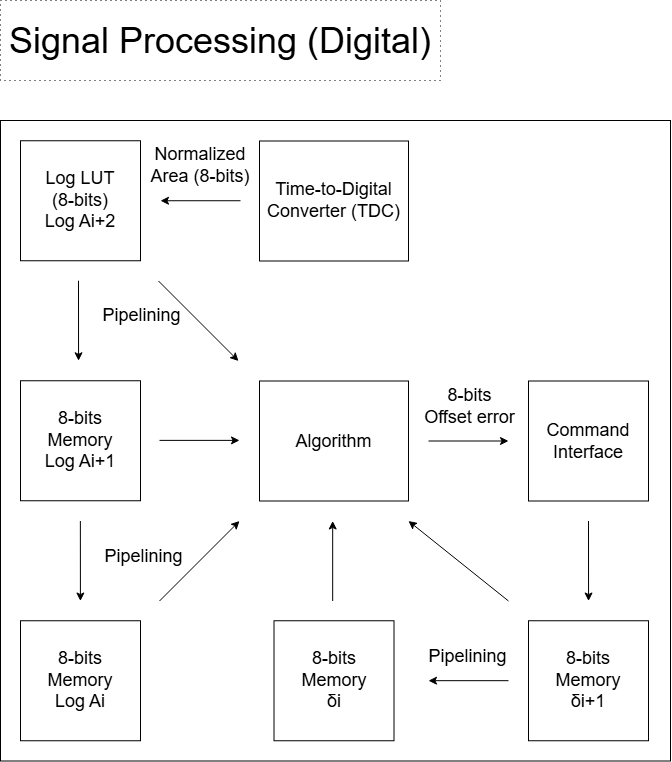
Media/ChipArchitect/VersionProposal/Optical Probe Station Digital Algorithm.png
