llhtimlam/Probton/Media/ChipArchitect/VersionProposal/Optical Probe Station Digital Smart Guess.png

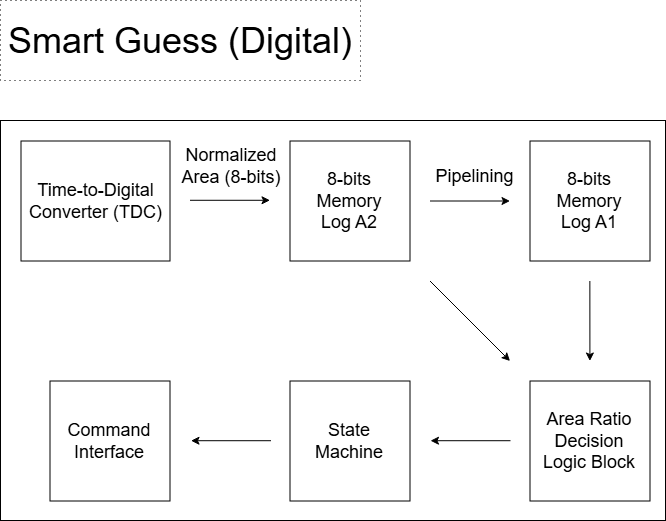
Media/ChipArchitect/VersionProposal/Optical Probe Station Digital Smart Guess.png
