llhtimlam/Probton/Media/ChipArchitect/VersionProposal/Optical Probe Station Full Design.png

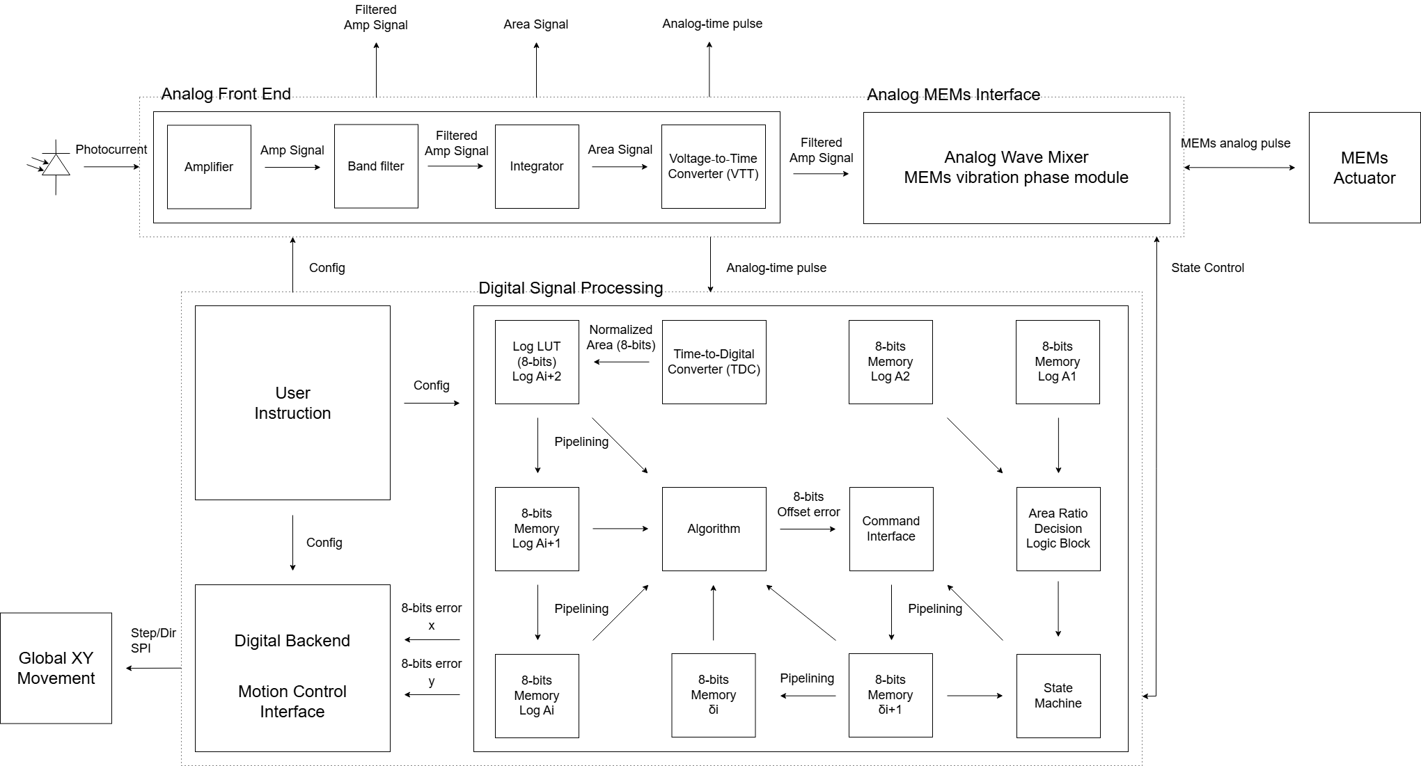
Media/ChipArchitect/VersionProposal/Optical Probe Station Full Design.png
