llhtimlam/Probton/Media/Layout/analog_domain.png

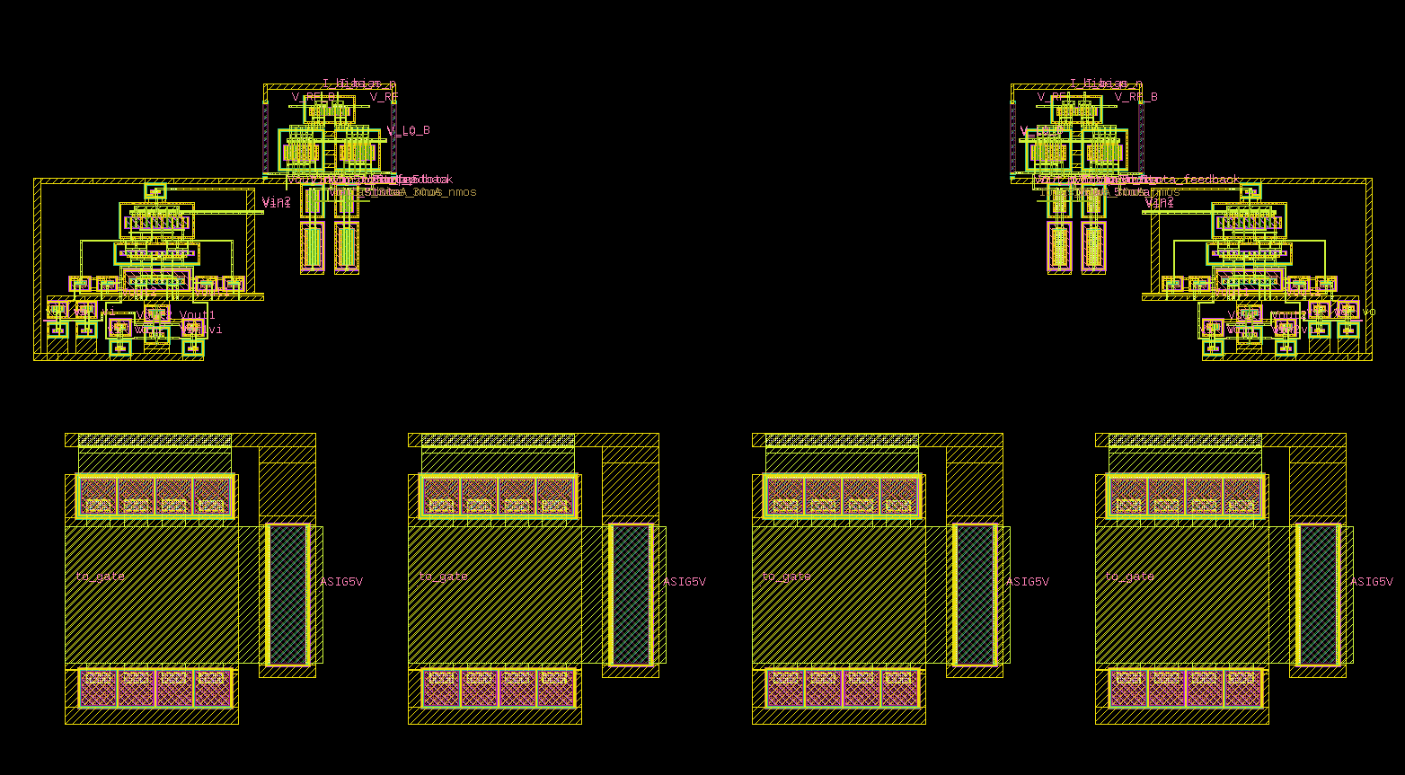
Media/Layout/analog_domain.png
