llhtimlam/Probton/Media/Layout/analog_domain_esd_protection.png

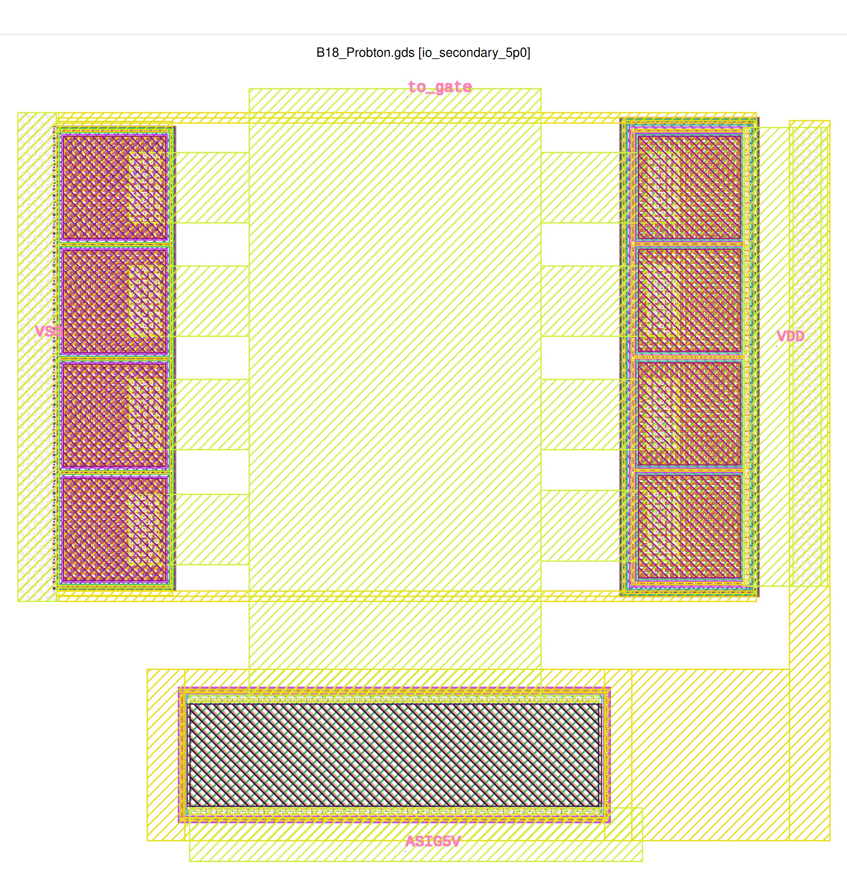
Media/Layout/analog_domain_esd_protection.png
