llhtimlam/Probton/Media/Layout/analog_domain_floorplan.png

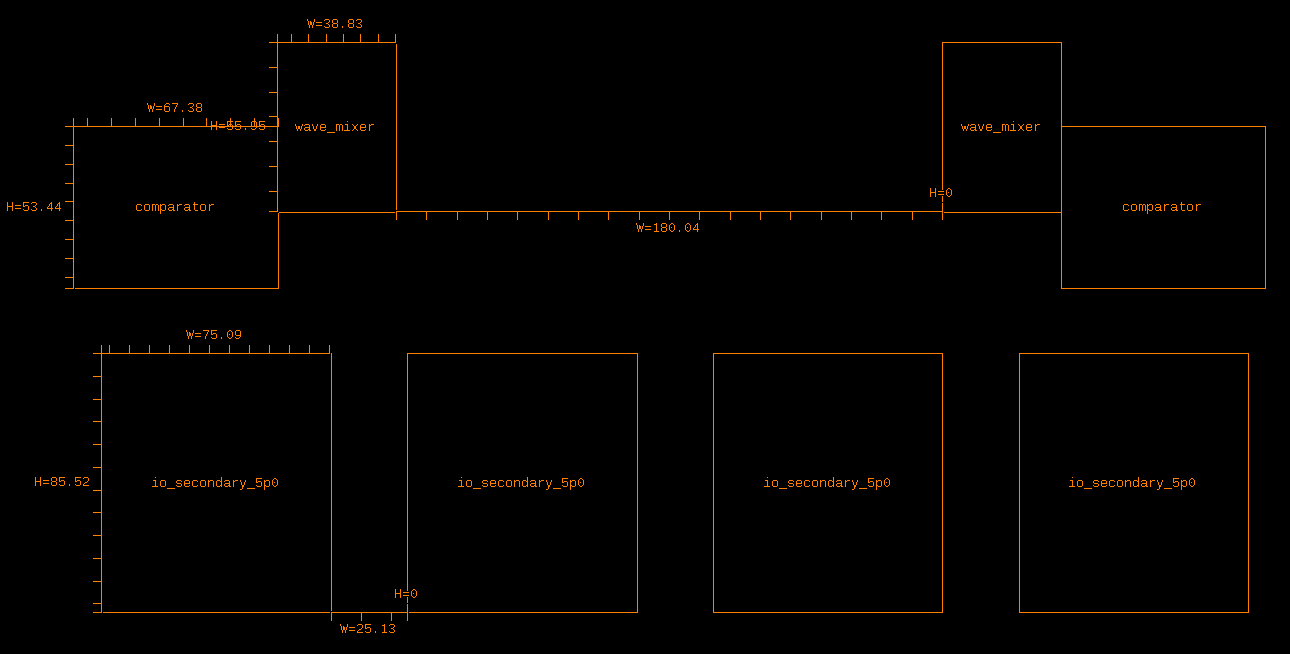
Media/Layout/analog_domain_floorplan.png
