llhtimlam/Probton/Media/Layout/B18_Probton_integration_dark.png

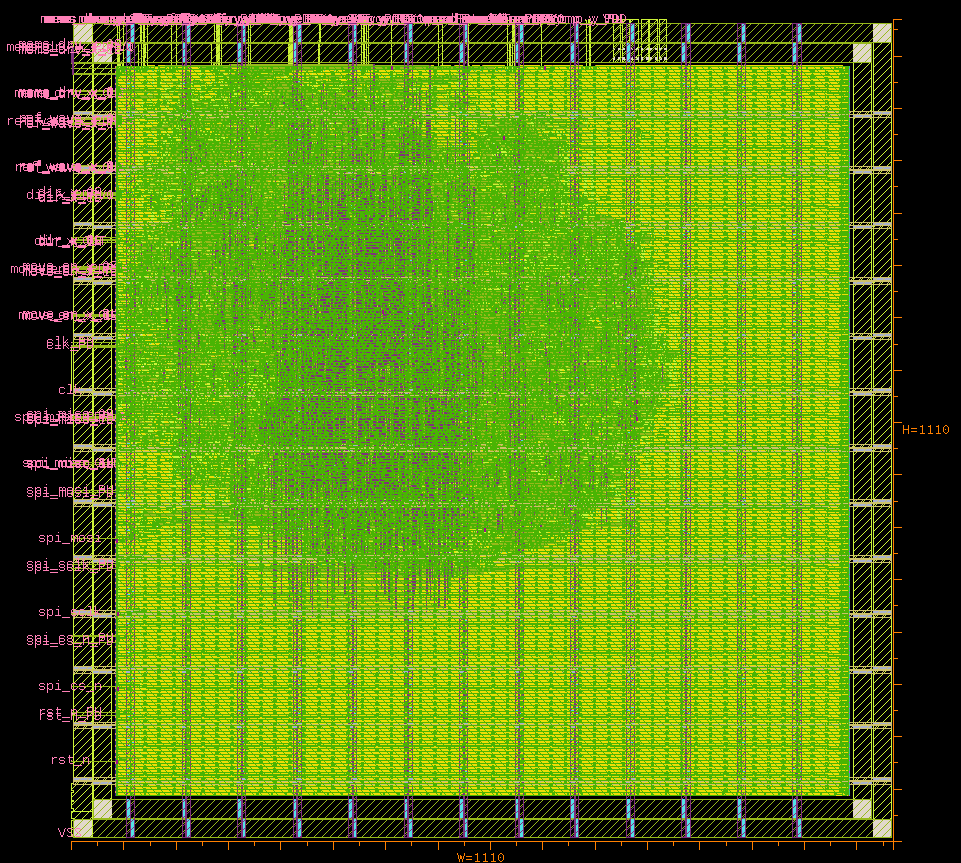
Media/Layout/B18_Probton_integration_dark.png
