llhtimlam/Probton/Media/Layout/B18_Probton_integration_no_label.png

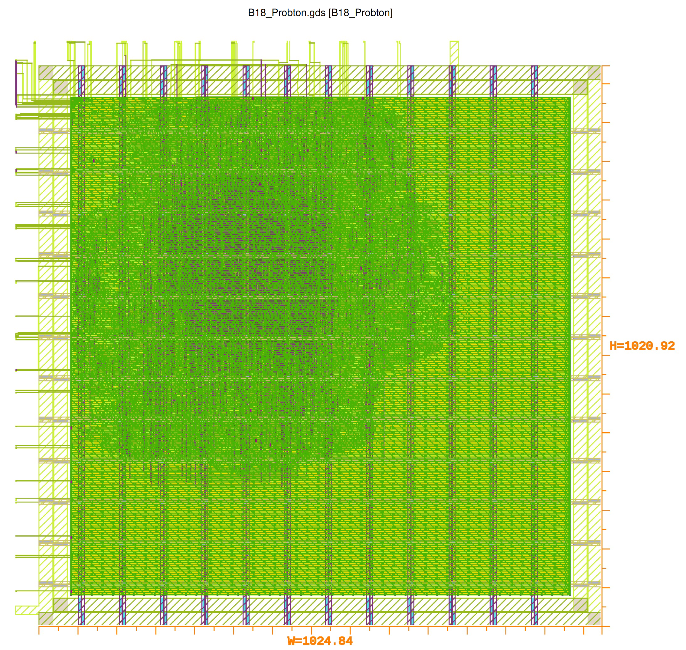
Media/Layout/B18_Probton_integration_no_label.png
