llhtimlam/Probton/Media/Layout/B18_Probton_integration_no_label_dark.png

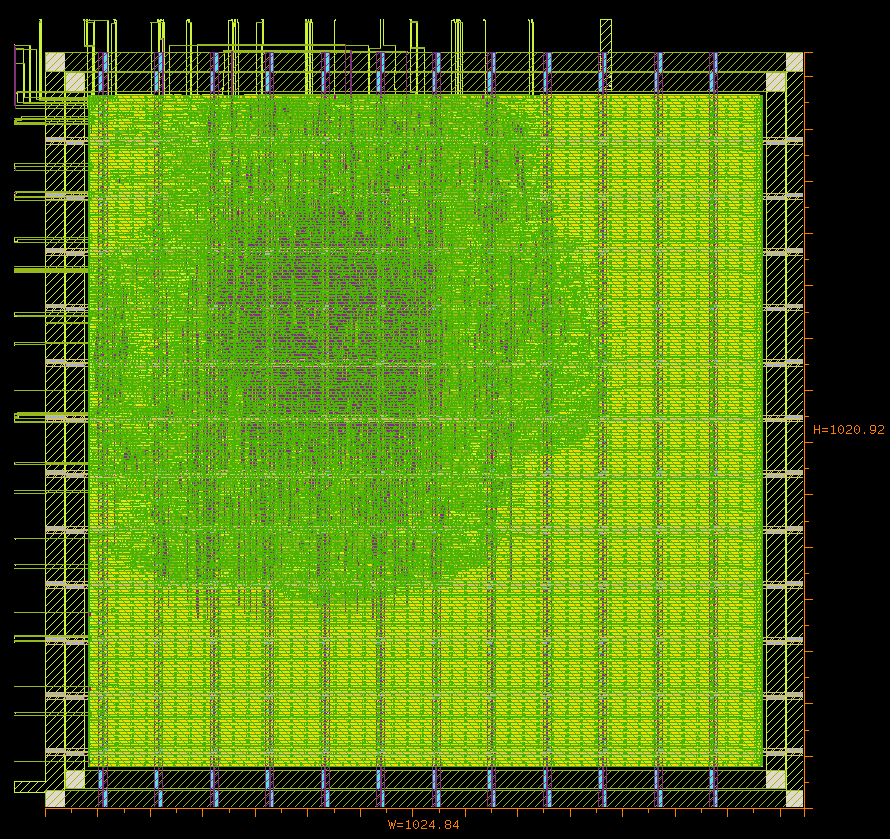
Media/Layout/B18_Probton_integration_no_label_dark.png
