llhtimlam/Probton/Media/Layout/B18_Probton_MPW_no_label.png

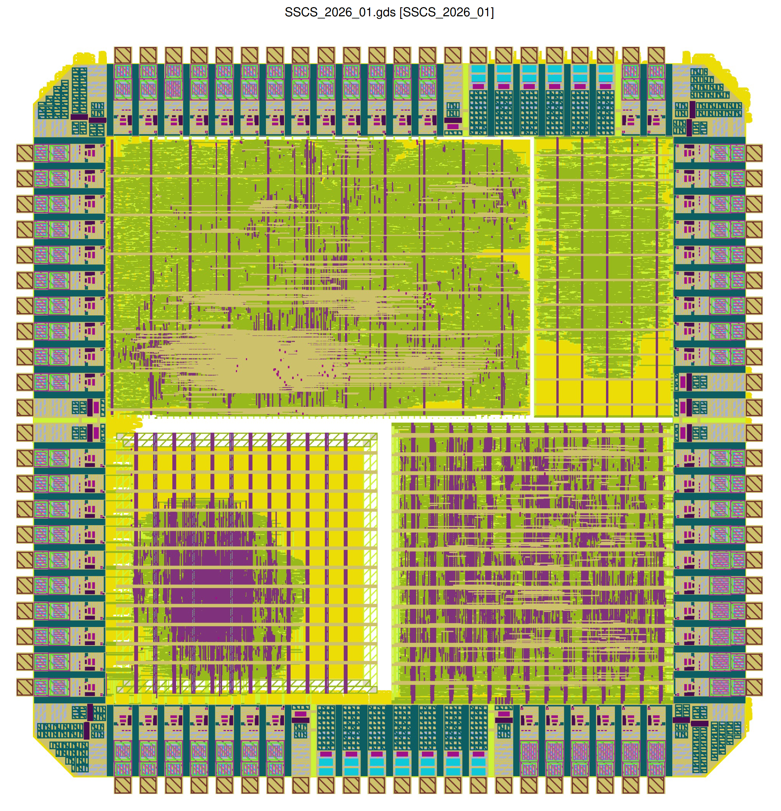
Media/Layout/B18_Probton_MPW_no_label.png
