llhtimlam/Probton/Media/Layout/B18_Probton_MPW_no_label_dark.png

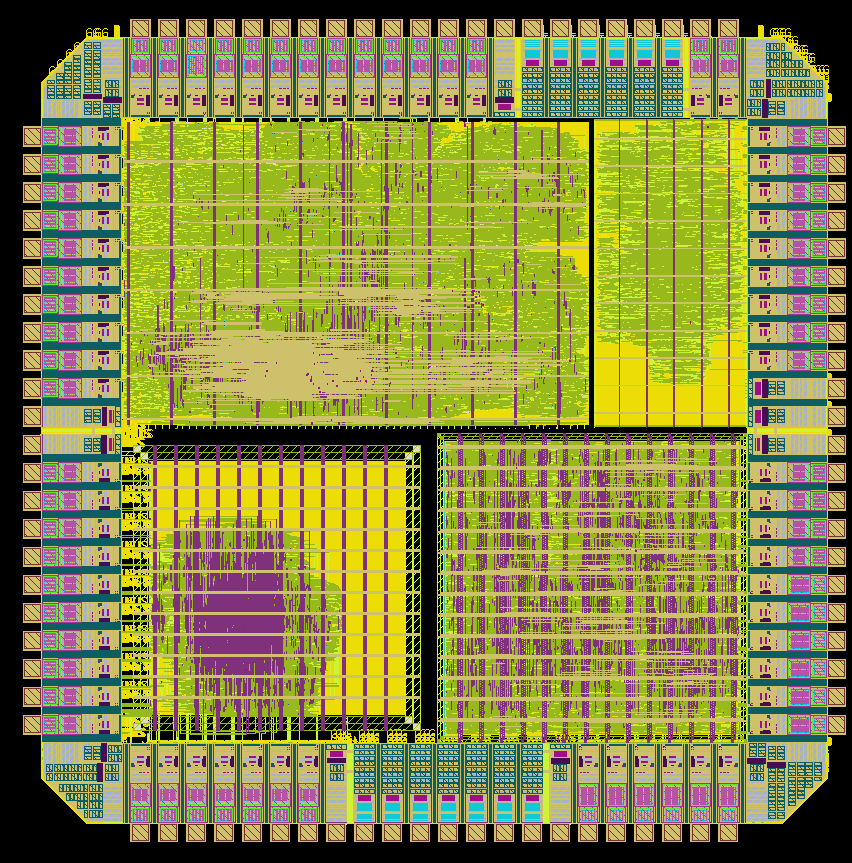
Media/Layout/B18_Probton_MPW_no_label_dark.png
