llhtimlam/Probton/Media/Layout/comparator.png

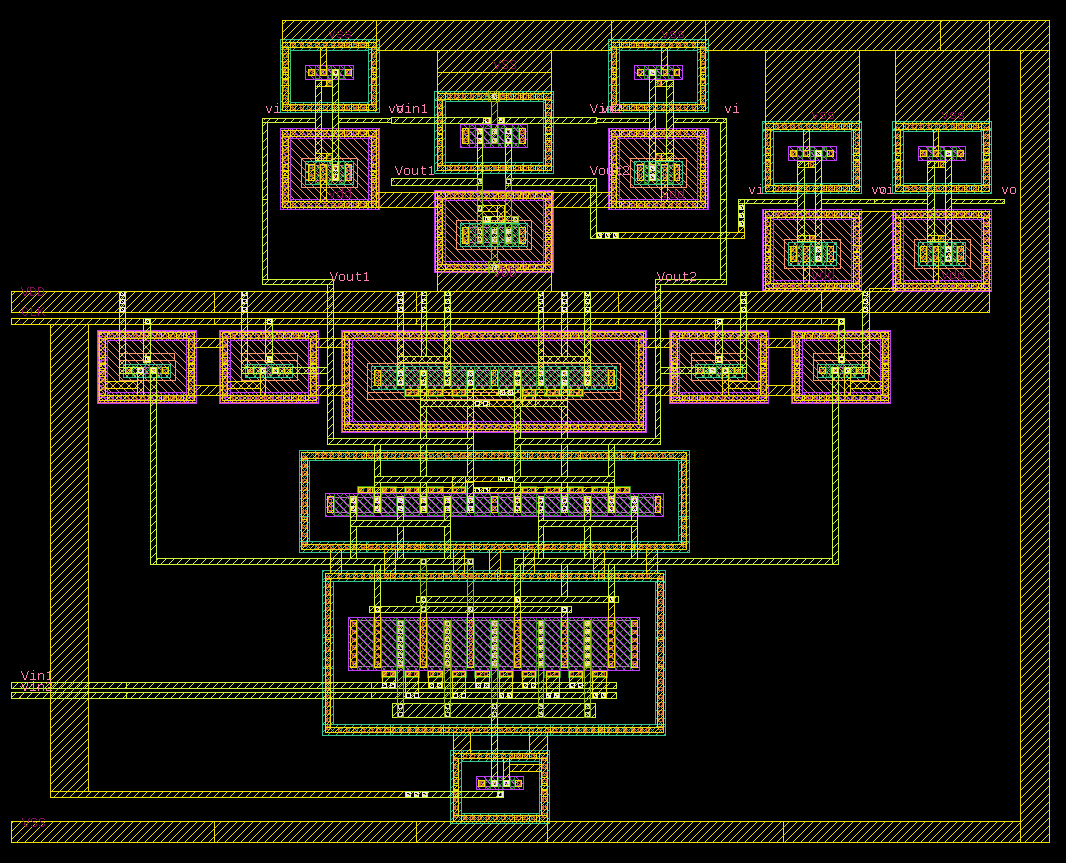
Media/Layout/comparator.png
