llhtimlam/Probton/Media/Layout/comparator_floorplan.png

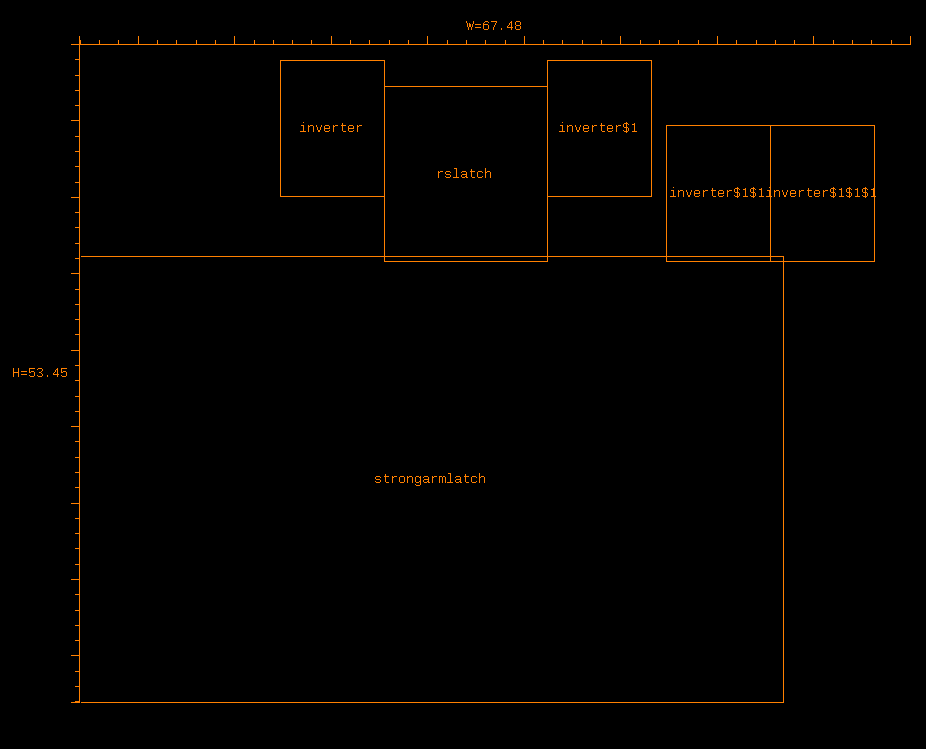
Media/Layout/comparator_floorplan.png
