llhtimlam/Probton/Media/Layout/digital_domain.png

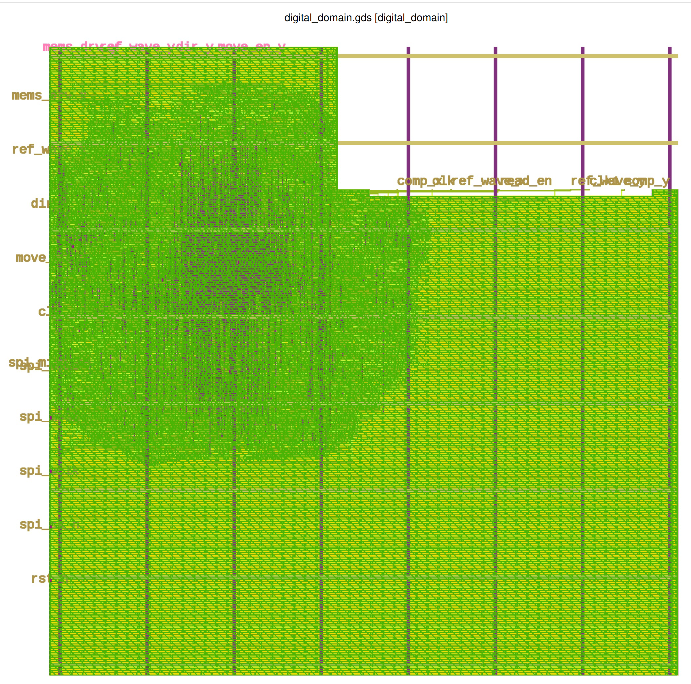
Media/Layout/digital_domain.png
