llhtimlam/Probton/Media/Layout/digital_domain_cell_type_report.png

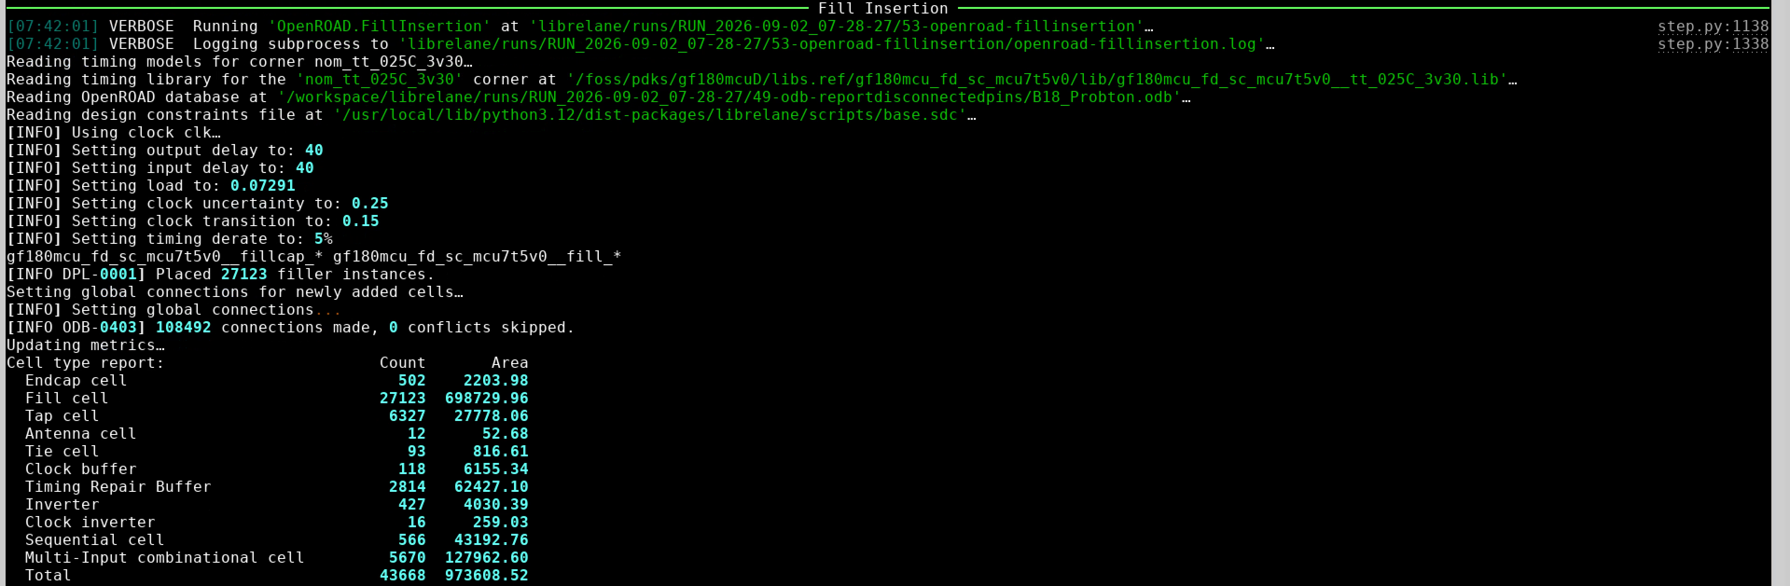
Media/Layout/digital_domain_cell_type_report.png
