llhtimlam/Probton/Media/Layout/digital_domain_dark.png

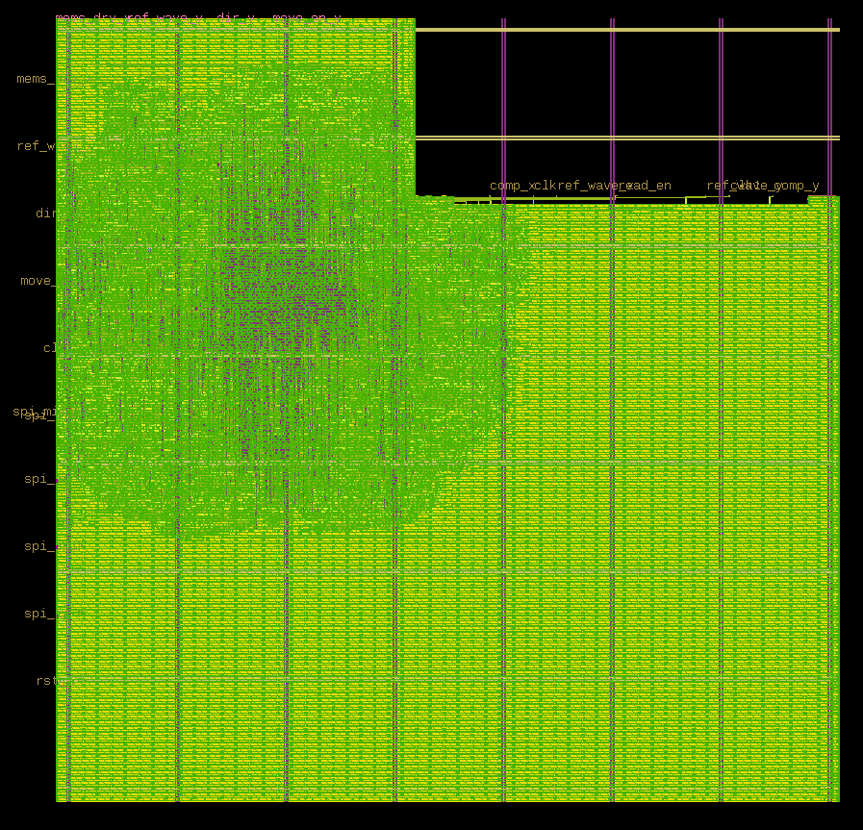
Media/Layout/digital_domain_dark.png
