llhtimlam/Probton/Media/Layout/digital_domain_final_report.png

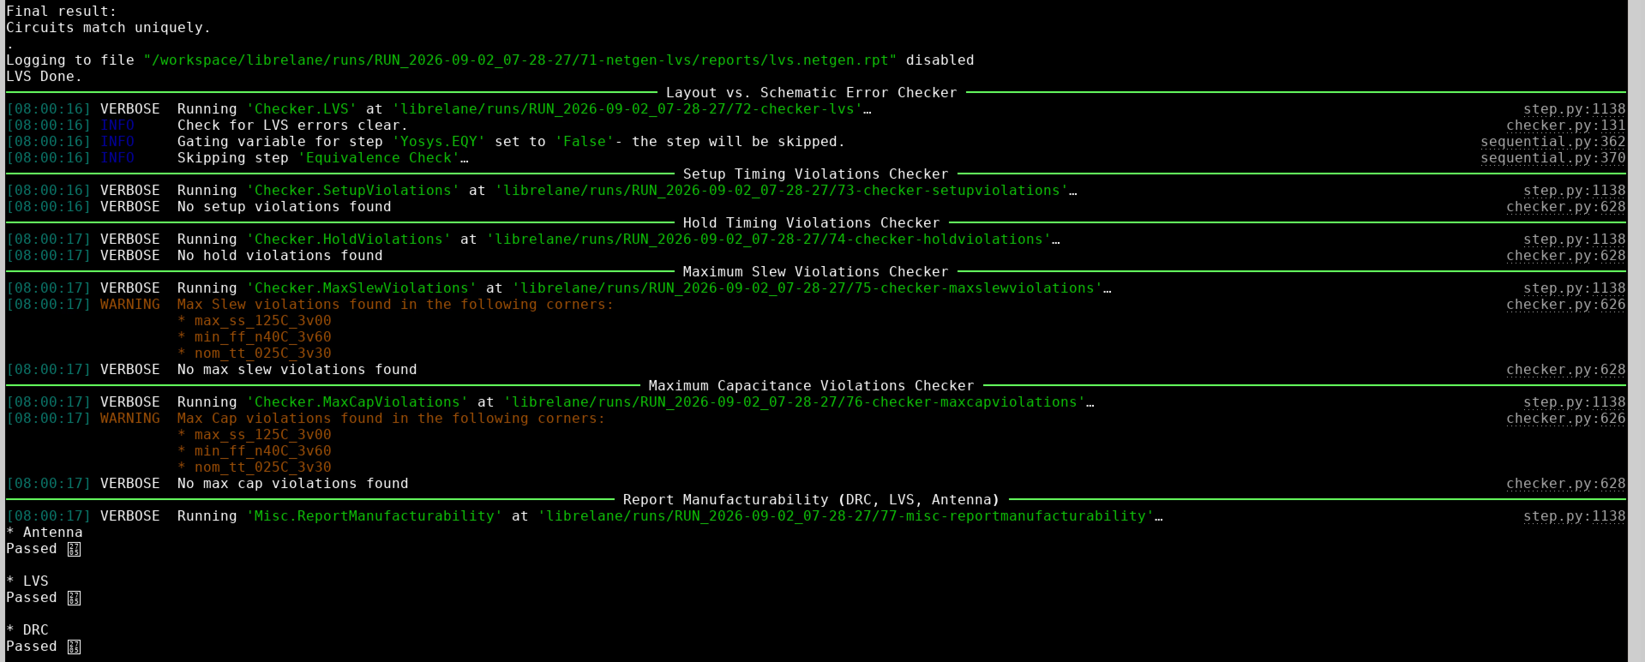
Media/Layout/digital_domain_final_report.png
