llhtimlam/Probton/Media/Layout/digital_domain_ir_drop_report.png

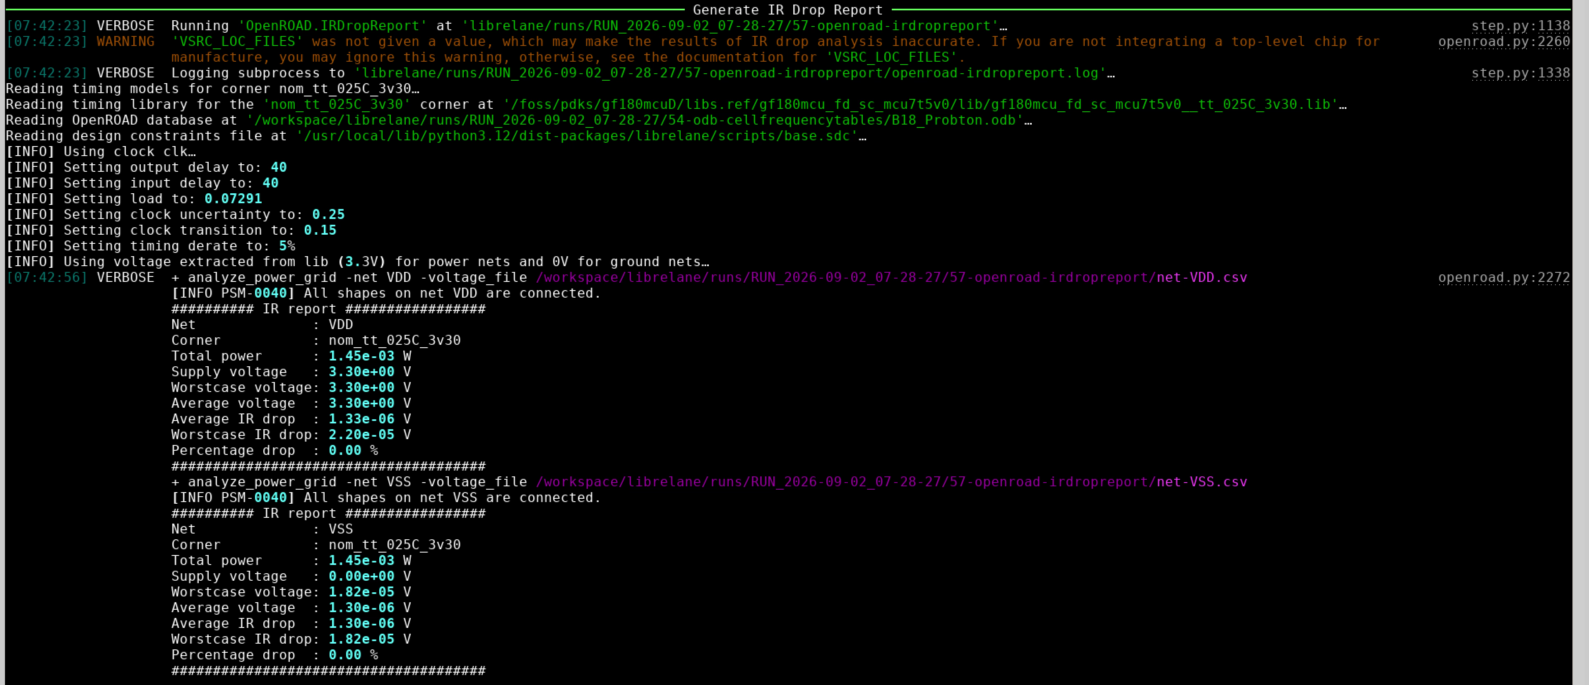
Media/Layout/digital_domain_ir_drop_report.png
