llhtimlam/Probton/Media/Layout/digital_domain_no_label.png

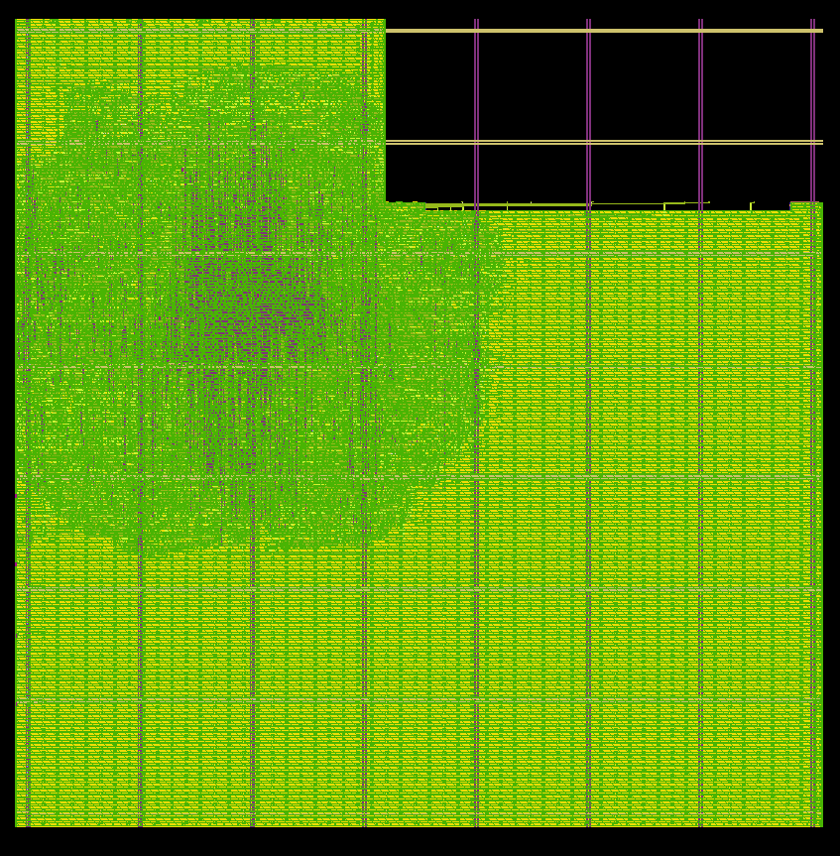
Media/Layout/digital_domain_no_label.png
