llhtimlam/Probton/Media/Layout/digital_domain_sta_report.png

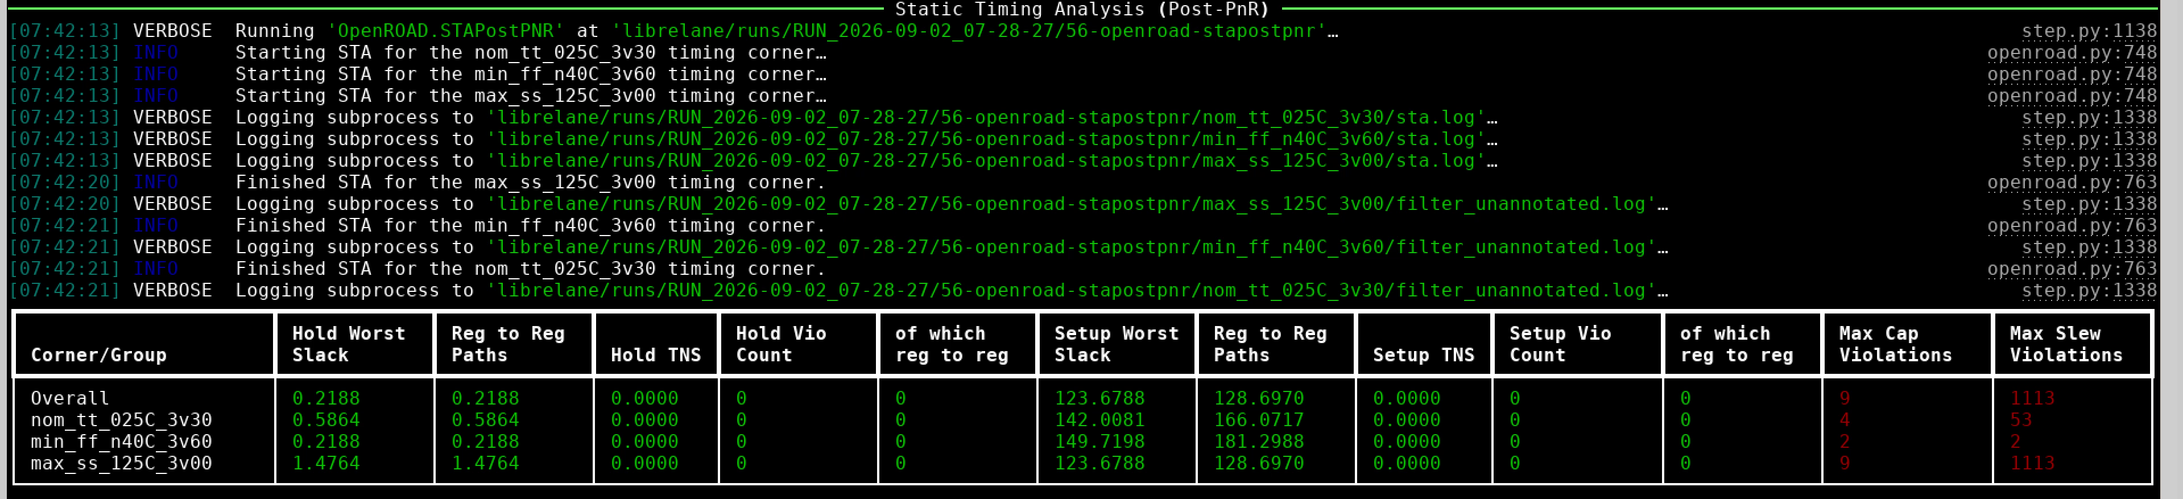
Media/Layout/digital_domain_sta_report.png
