llhtimlam/Probton/Media/Layout/digital_domain_sub_module/digital_domain_signal_processor.png

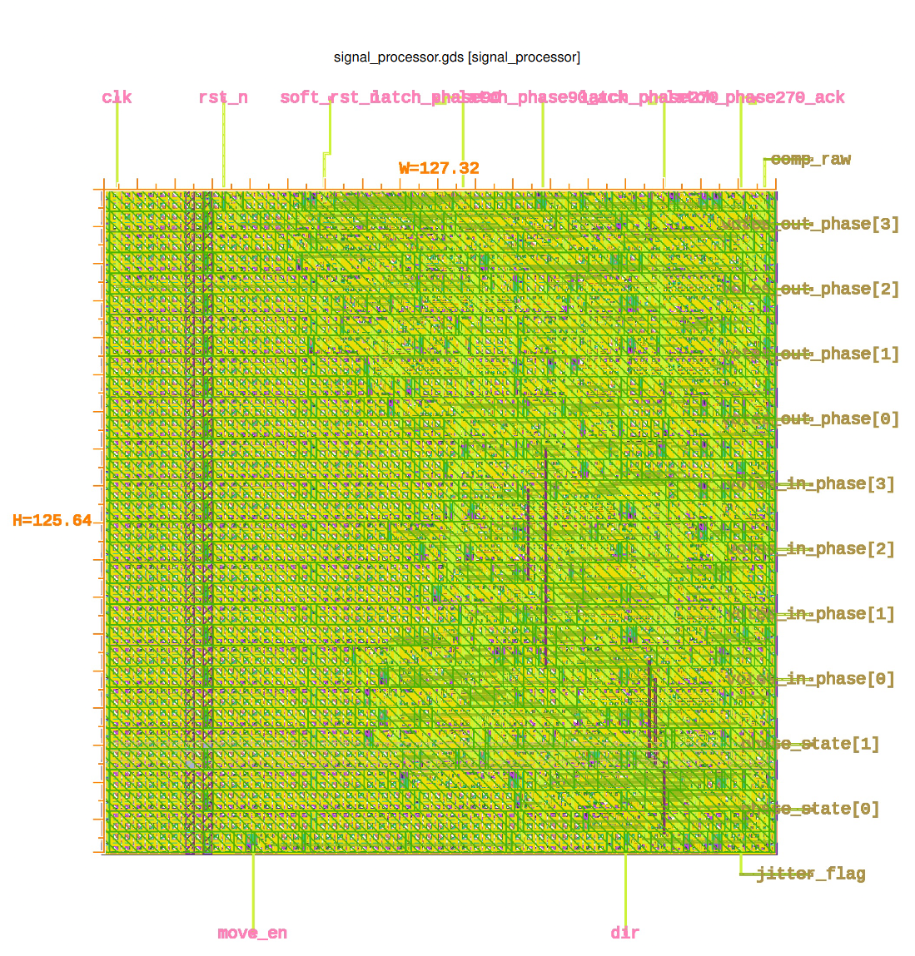
Media/Layout/digital_domain_sub_module/digital_domain_signal_processor.png
