llhtimlam/Probton/Media/Layout/digital_domain_sub_module/digital_domain_spi.png

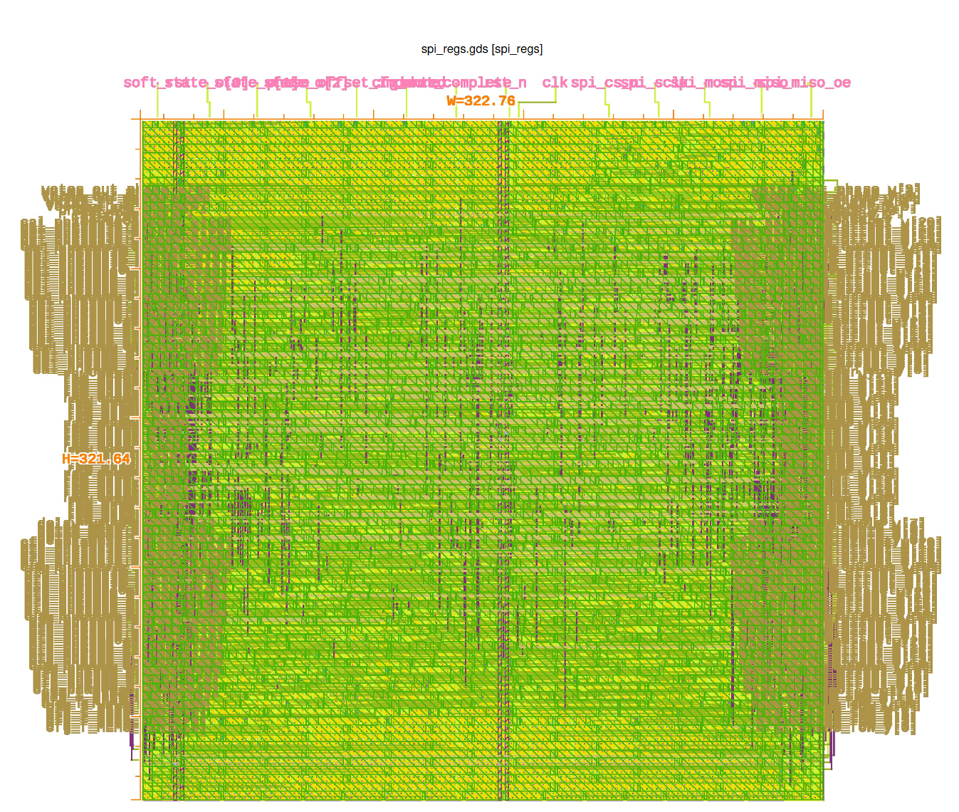
Media/Layout/digital_domain_sub_module/digital_domain_spi.png
