llhtimlam/Probton/Media/Layout/digital_domain_sub_module/digital_domain_spi_dark.png

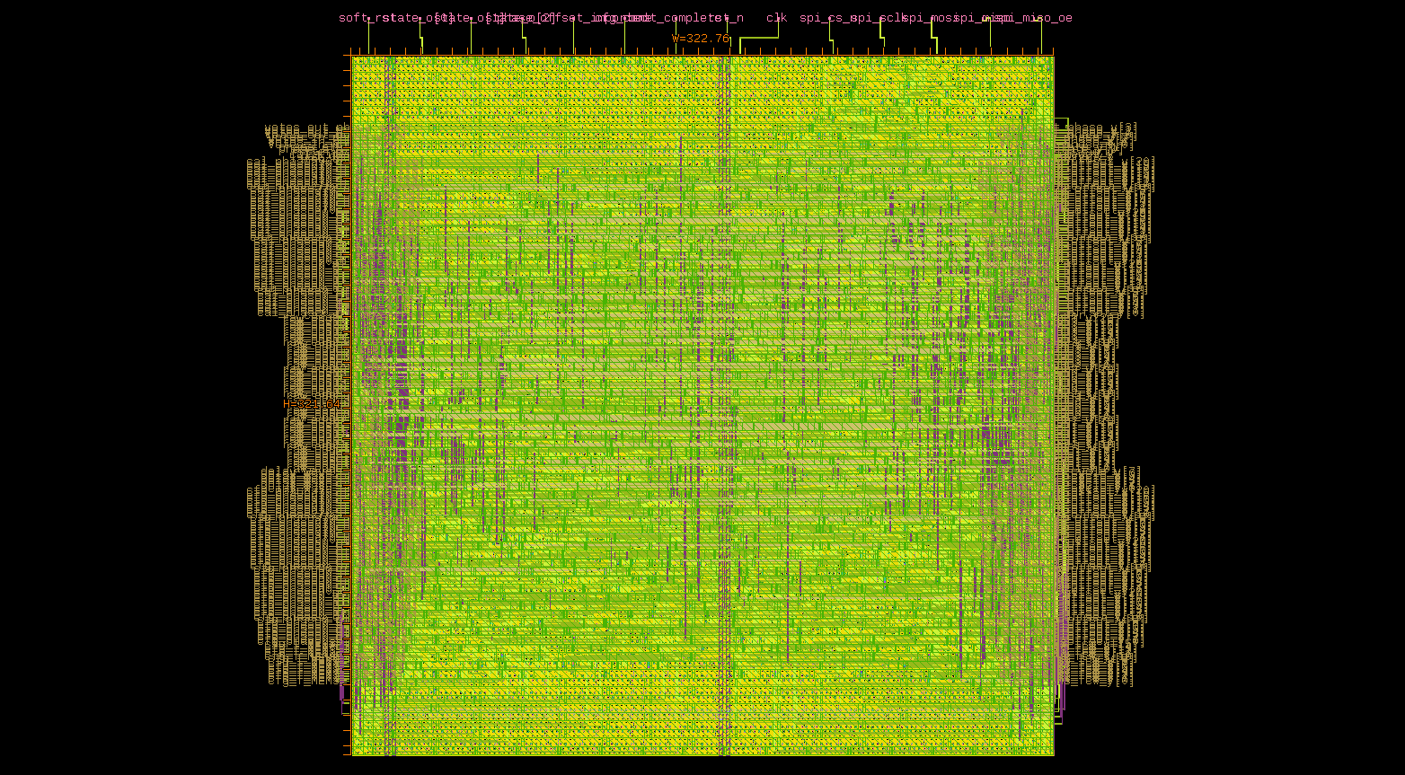
Media/Layout/digital_domain_sub_module/digital_domain_spi_dark.png
