llhtimlam/Probton/Media/Layout/digital_domain_sub_module/digital_domain_state_machine.png

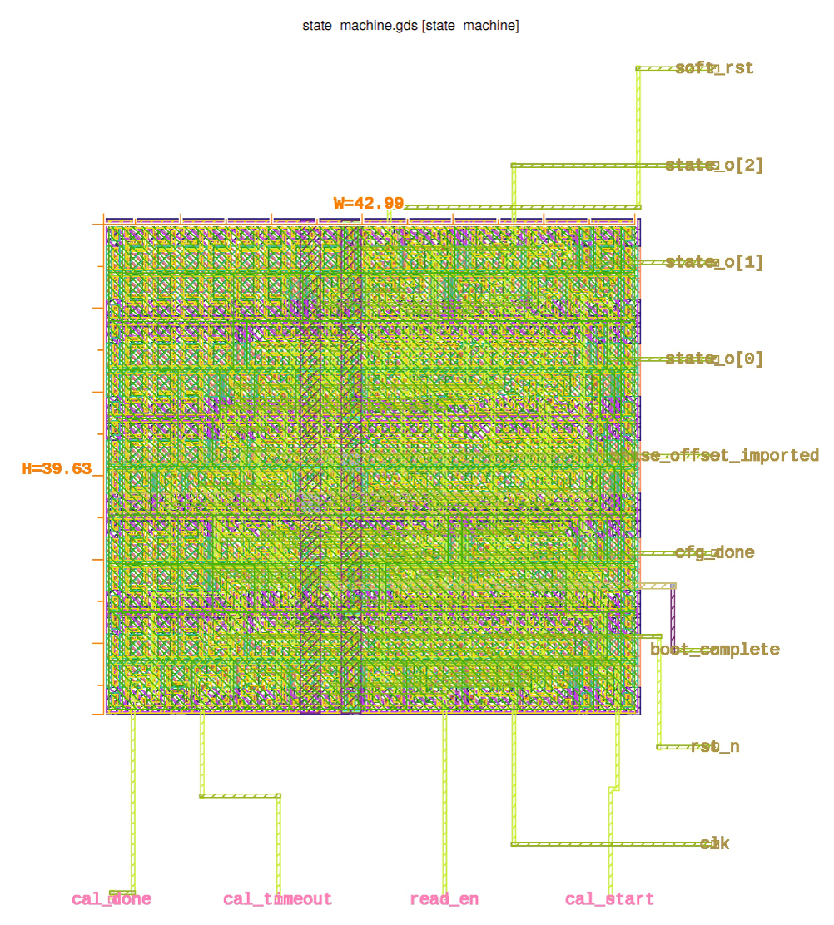
Media/Layout/digital_domain_sub_module/digital_domain_state_machine.png
