llhtimlam/Probton/Media/Layout/digital_domain_sub_module/digital_domain_state_machine_dark.png

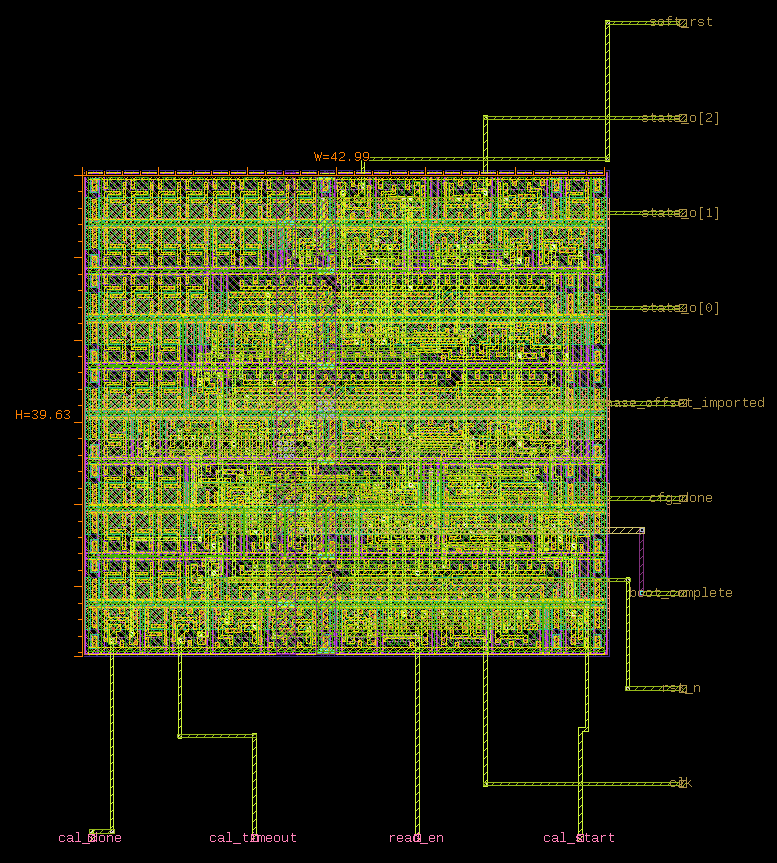
Media/Layout/digital_domain_sub_module/digital_domain_state_machine_dark.png
