llhtimlam/Probton/Media/Layout/digital_domain_sub_module/digital_domain_wave_controller.png

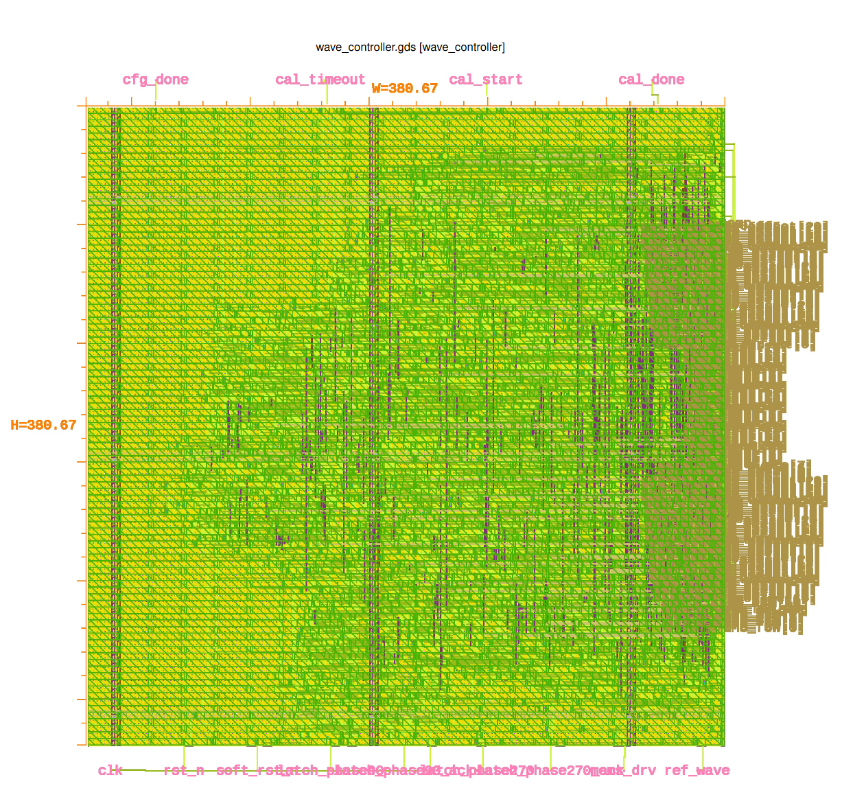
Media/Layout/digital_domain_sub_module/digital_domain_wave_controller.png
