llhtimlam/Probton/Media/Layout/floorplanning.png

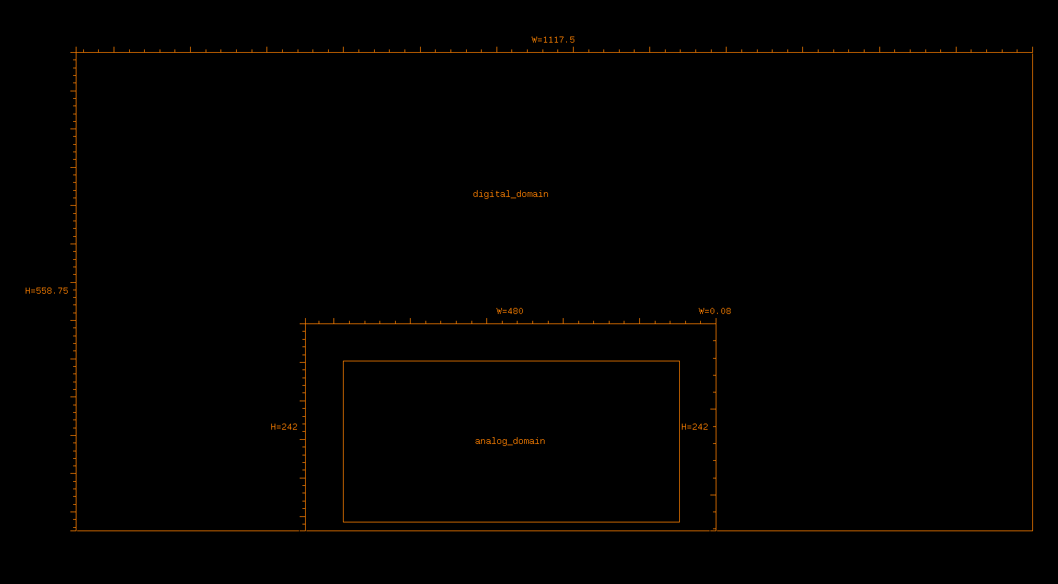
Media/Layout/floorplanning.png
