llhtimlam/Probton/Media/Layout/pre-integration.png

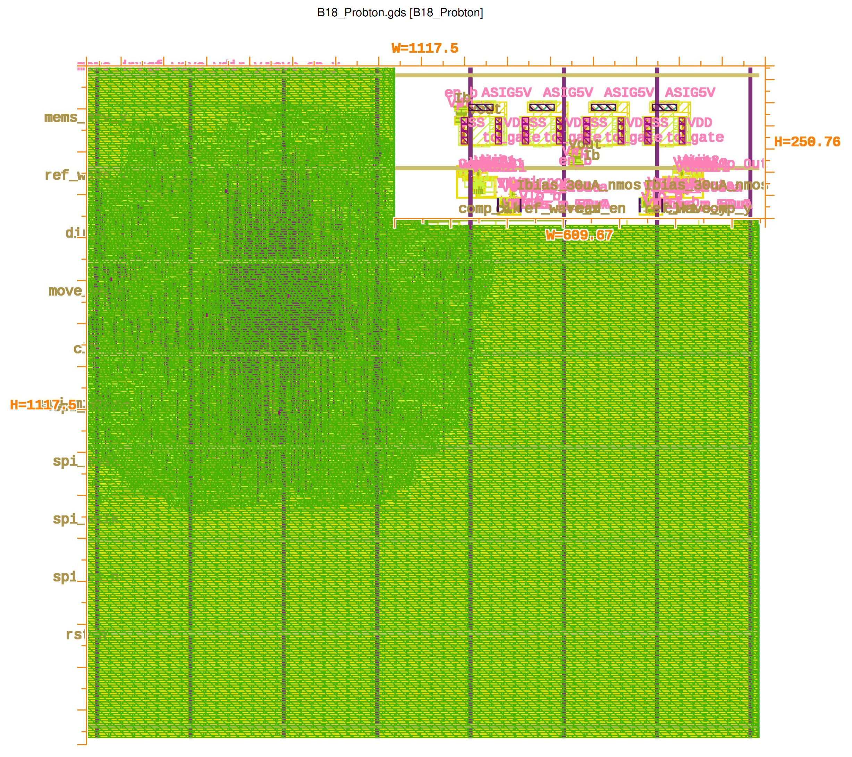
Media/Layout/pre-integration.png
