llhtimlam/Probton/Media/Layout/pre-integration_analog_domain.png

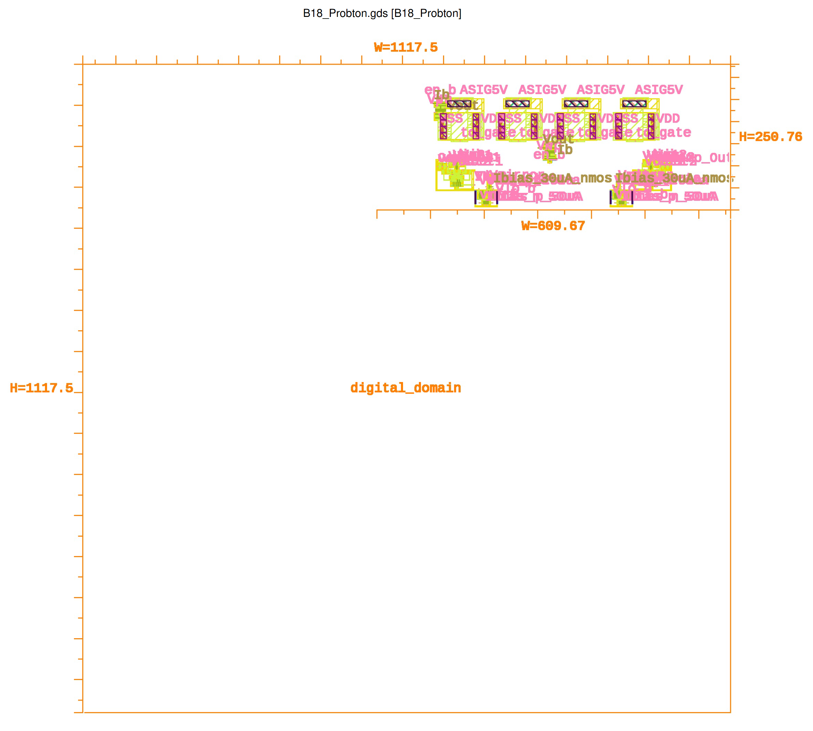
Media/Layout/pre-integration_analog_domain.png
