llhtimlam/Probton/Media/Layout/pre-integration_analog_domain_dark.png

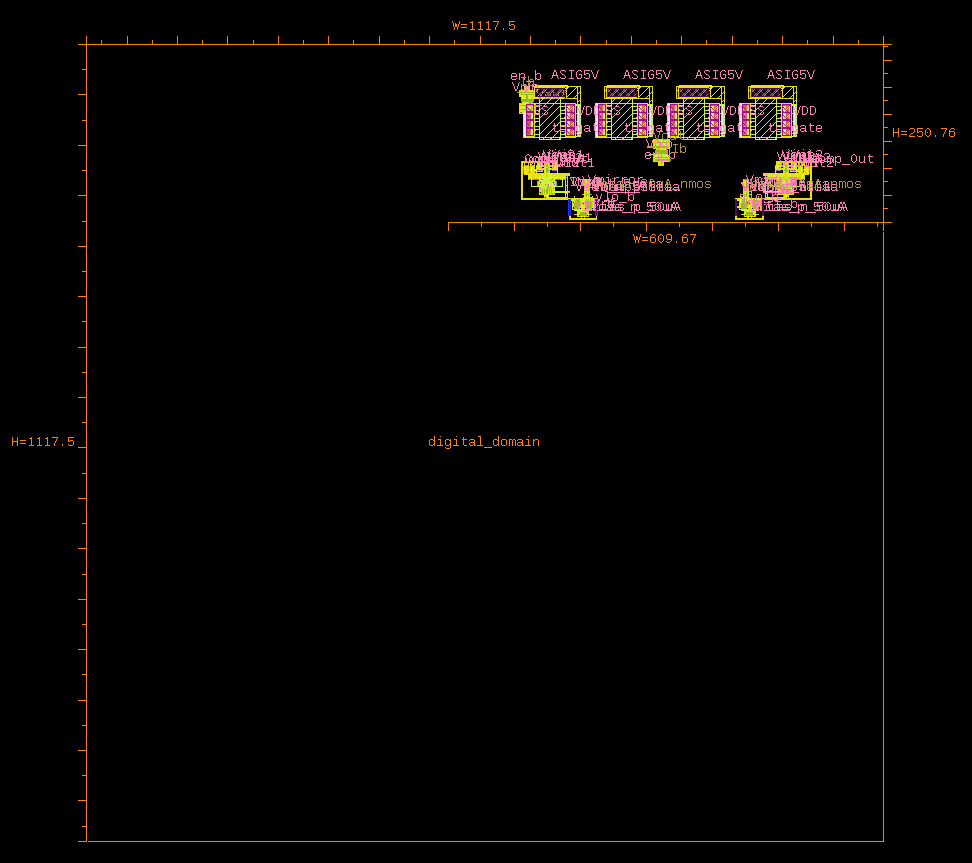
Media/Layout/pre-integration_analog_domain_dark.png
