llhtimlam/Probton/Media/Layout/pre-integration_dark.png

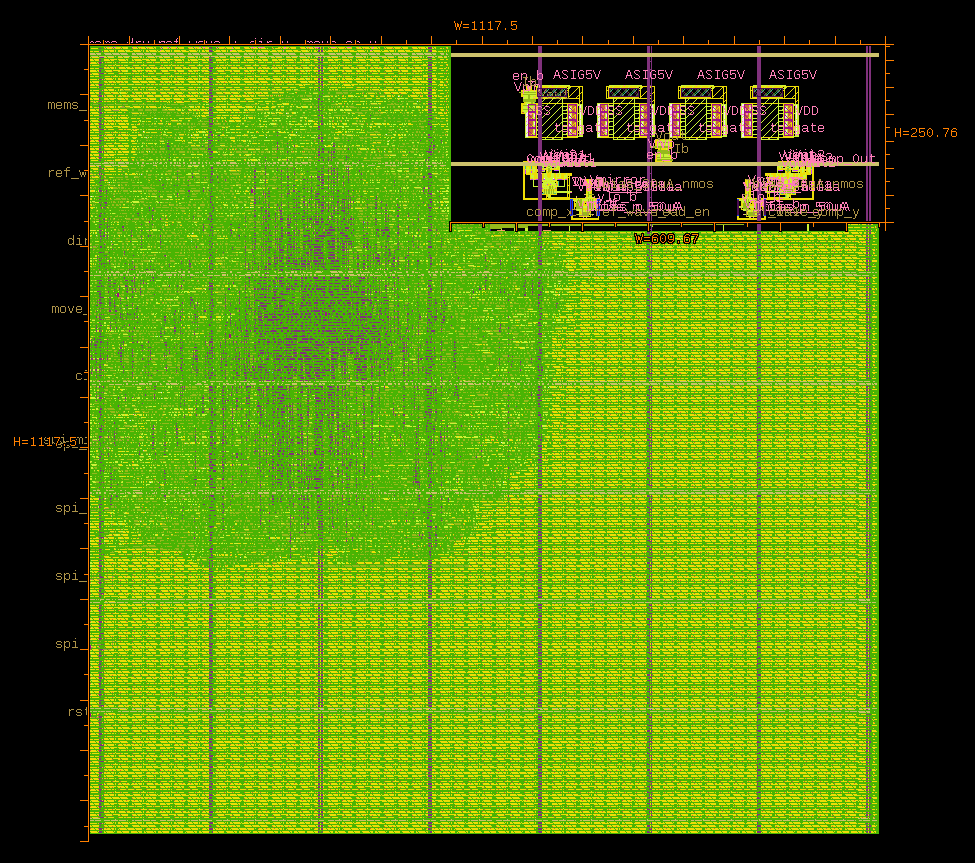
Media/Layout/pre-integration_dark.png
