llhtimlam/Probton/Media/Layout/pre-integration_digital_domain.png

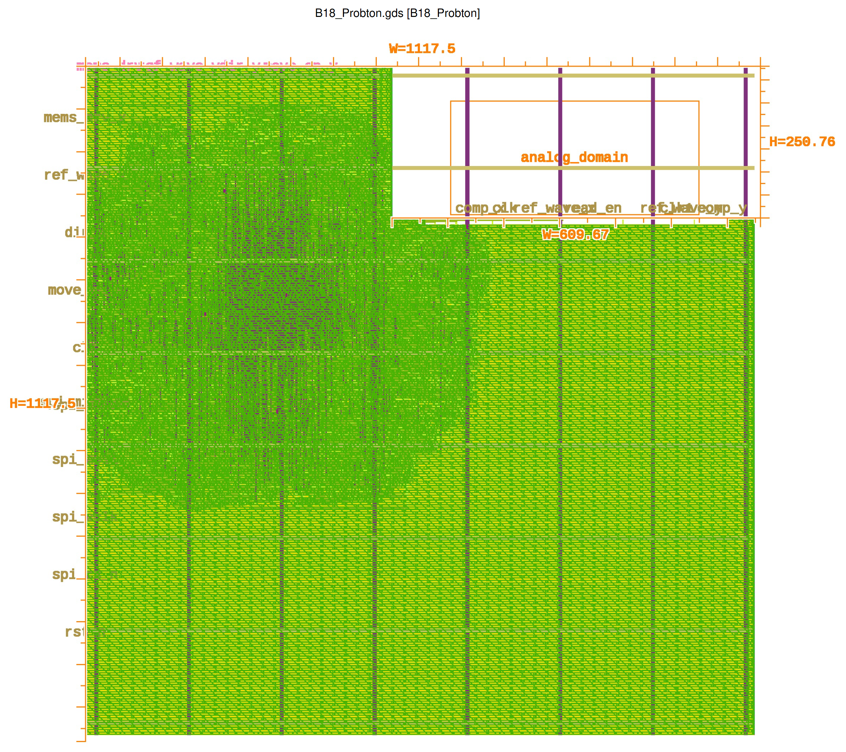
Media/Layout/pre-integration_digital_domain.png
