llhtimlam/Probton/Media/Layout/pre-integration_digital_domain_dark.png

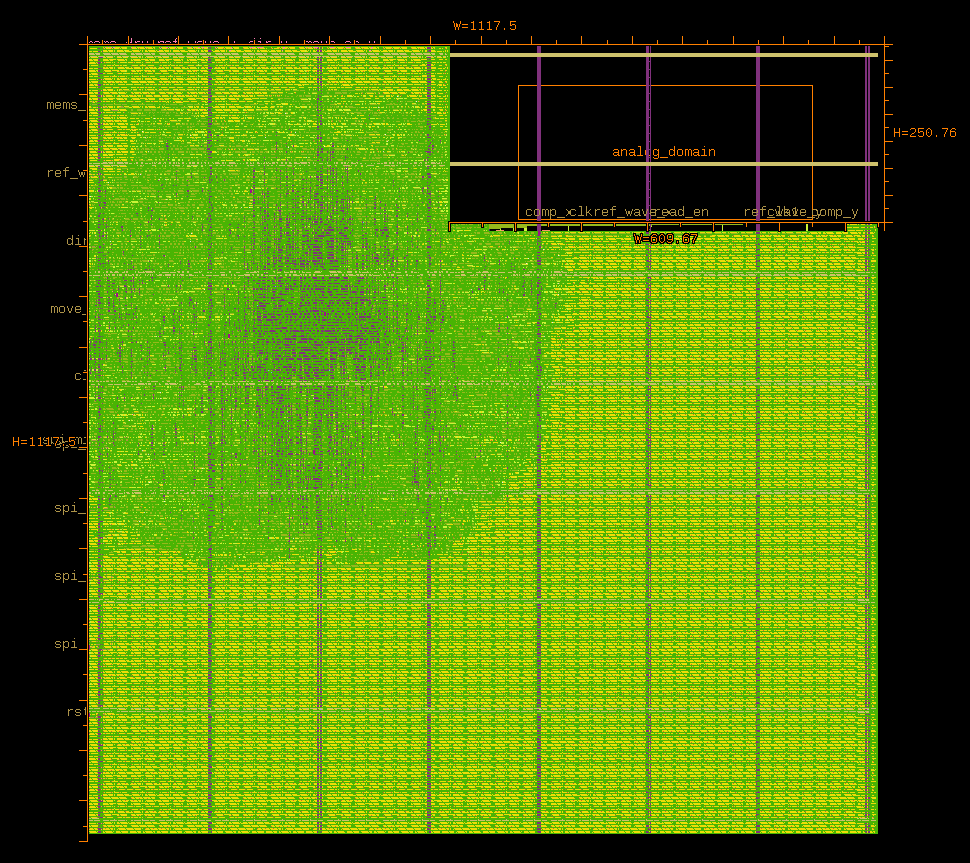
Media/Layout/pre-integration_digital_domain_dark.png
