llhtimlam/Probton/Media/Layout/pre-integration_mixer_comparator.png

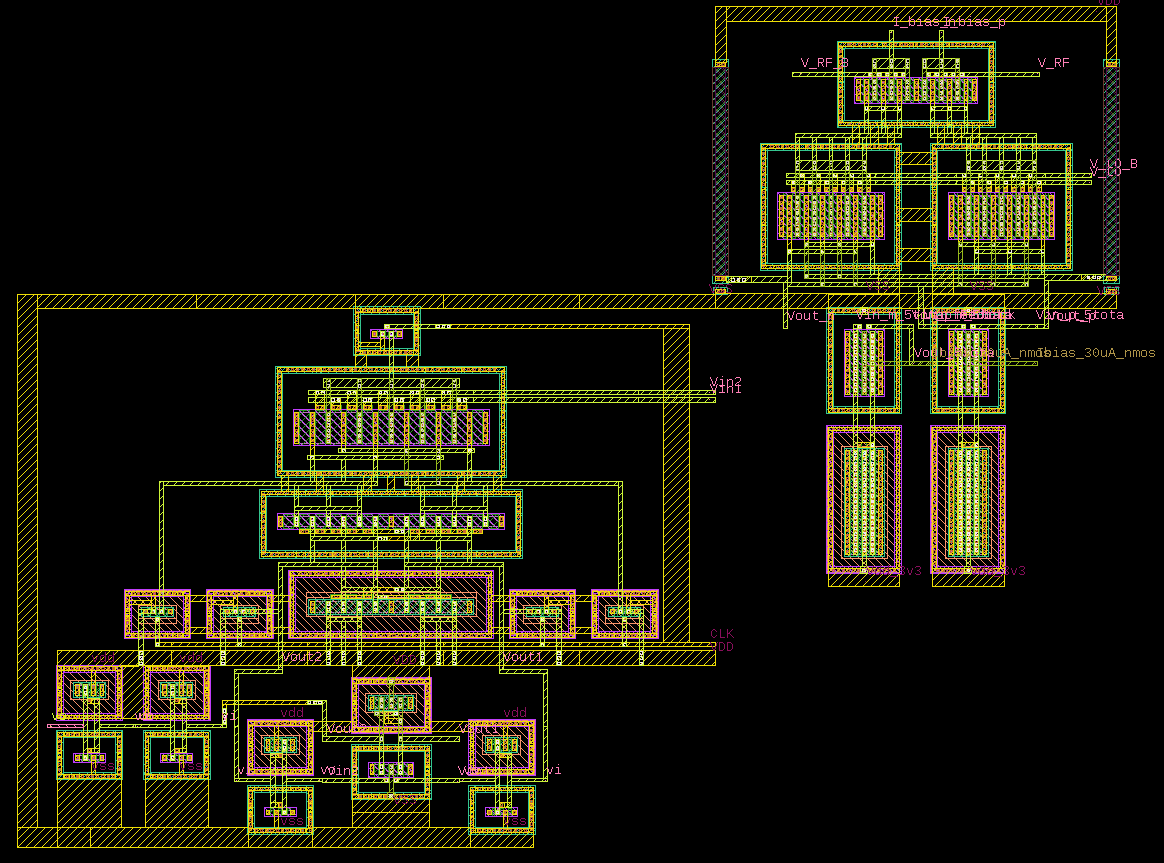
Media/Layout/pre-integration_mixer_comparator.png
