llhtimlam/Probton/Media/Layout/pre-integration_no_label.png

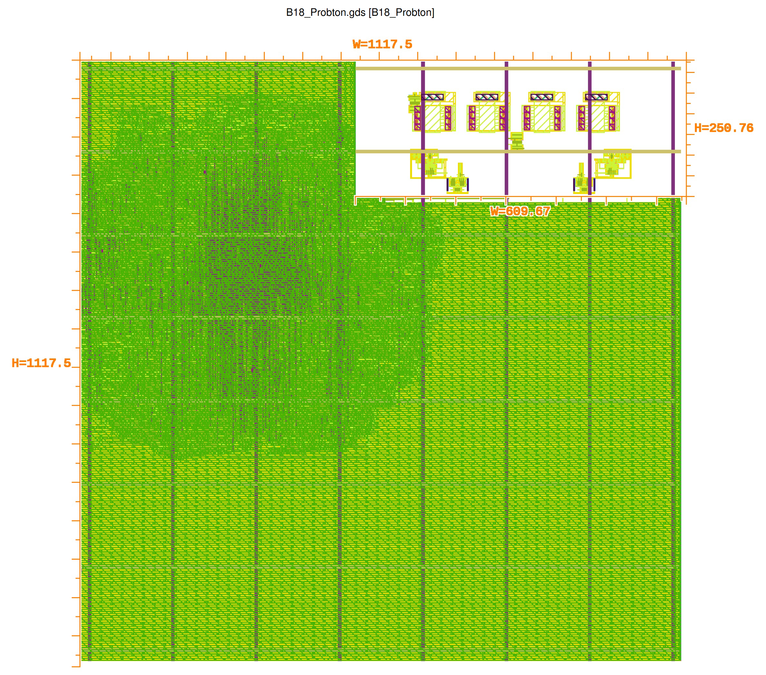
Media/Layout/pre-integration_no_label.png
