llhtimlam/Probton/Media/Layout/wave_mixer.png

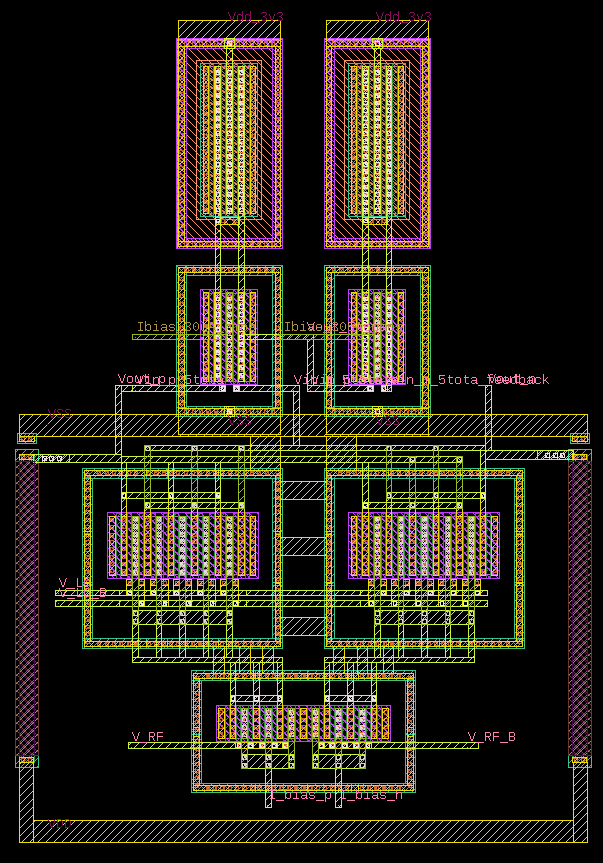
Media/Layout/wave_mixer.png
