llhtimlam/Probton/Media/Layout/wave_mixer_floorplan.png

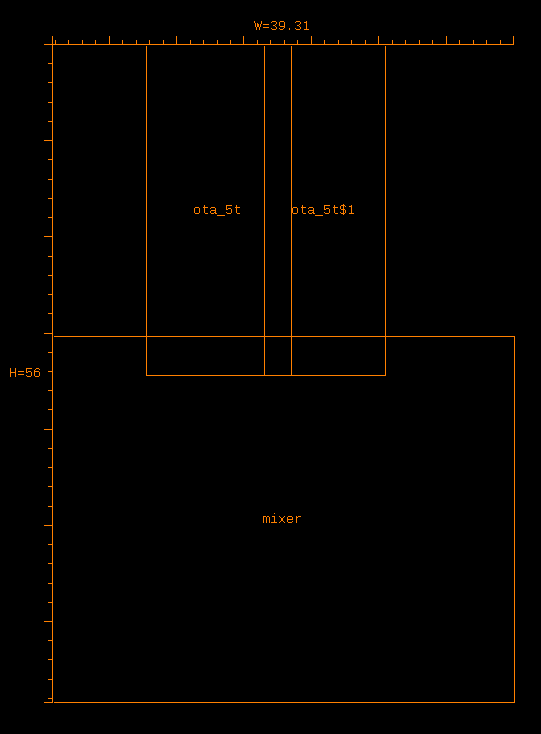
Media/Layout/wave_mixer_floorplan.png
