llhtimlam/Probton/Media/Schematic/analog_schematic_mixer&comp.png

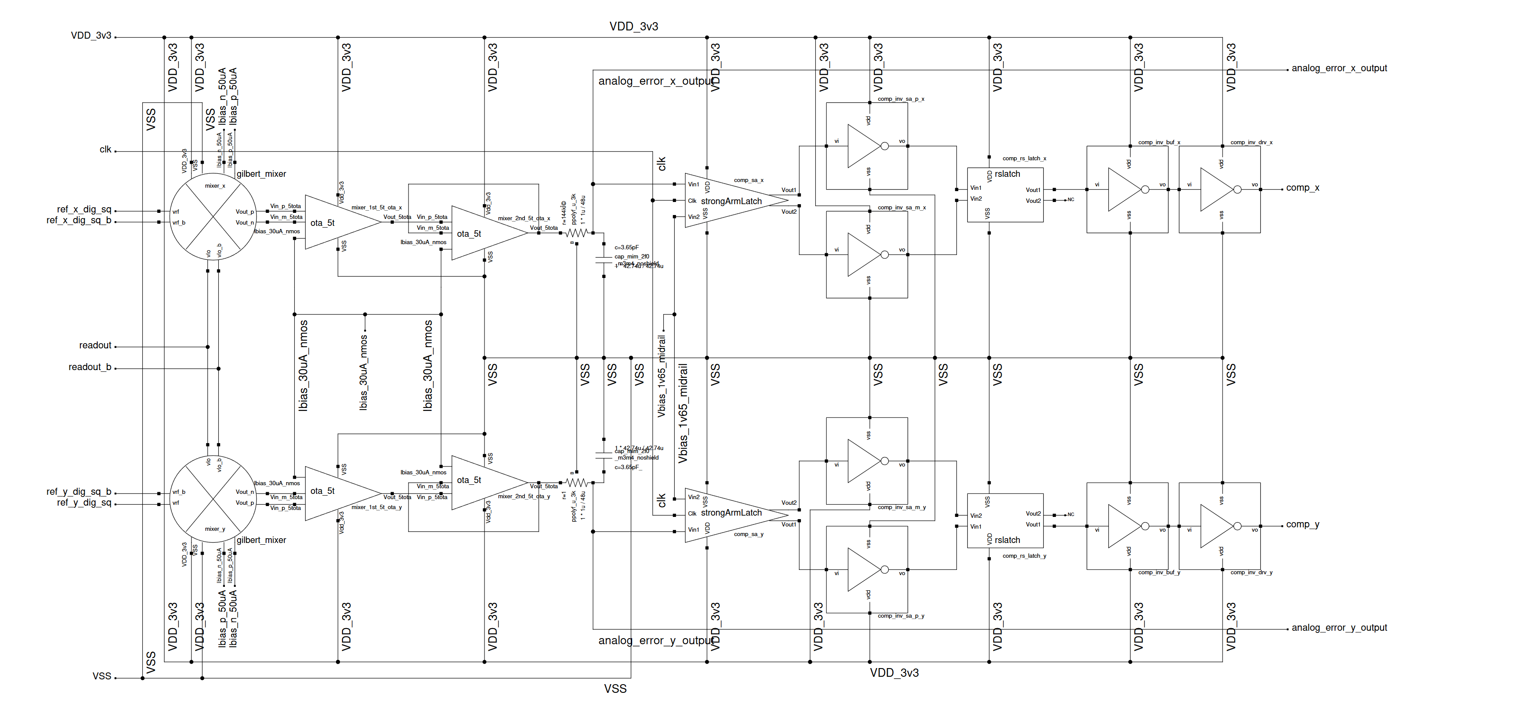
Media/Schematic/analog_schematic_mixer&comp.png
