llhtimlam/Probton/Media/Schematic/analog_schematic_mixer&comp_dark.png

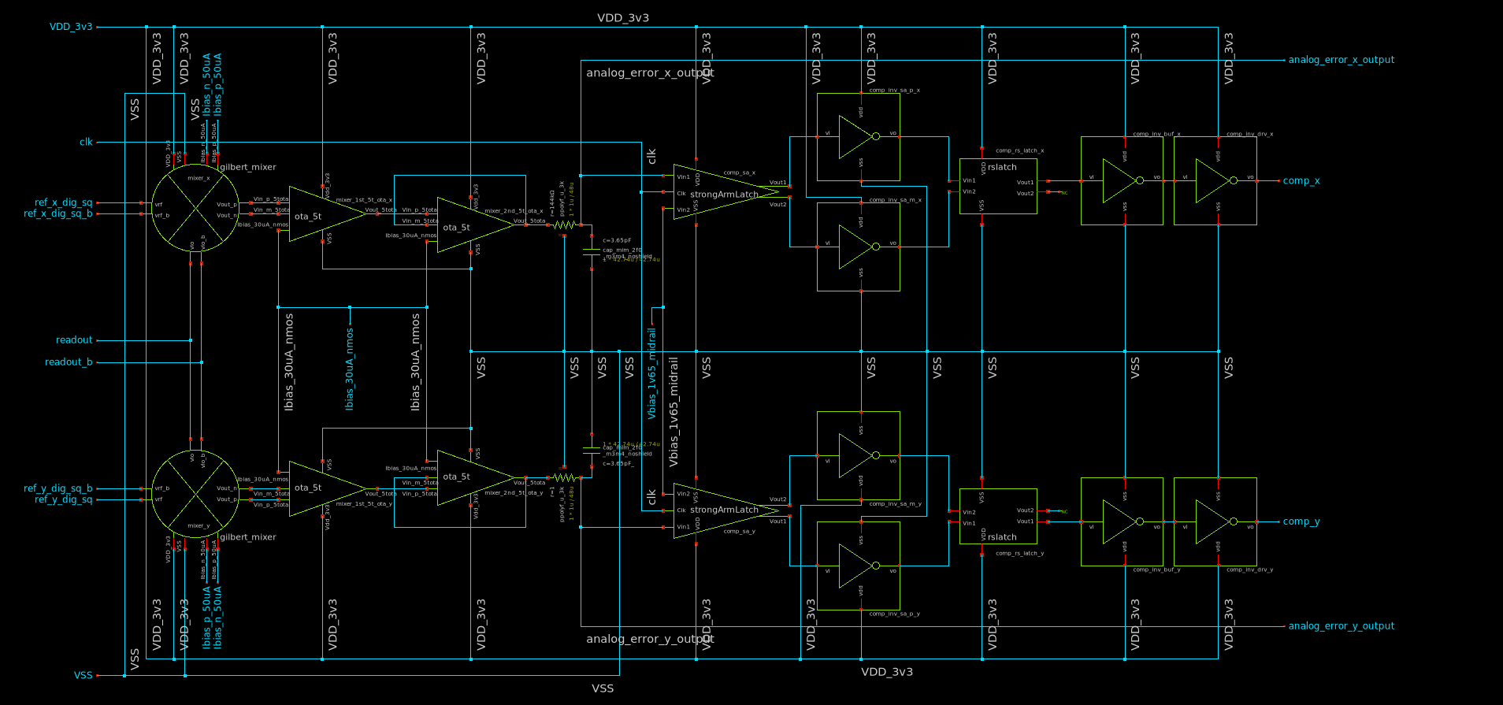
Media/Schematic/analog_schematic_mixer&comp_dark.png
