llhtimlam/Probton/Media/Schematic/analog_schematic_mixer&comp_xy.png

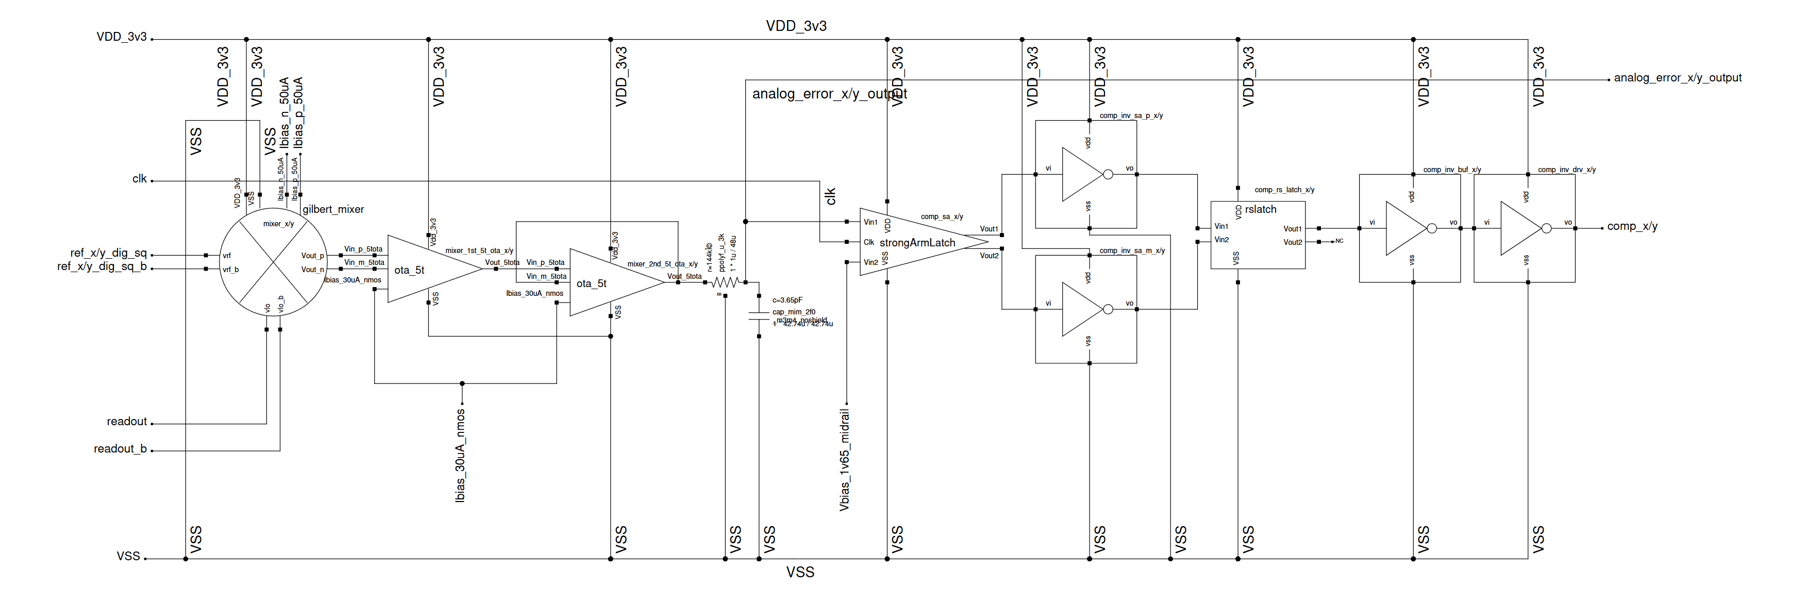
Media/Schematic/analog_schematic_mixer&comp_xy.png
