llhtimlam/Probton/Media/Schematic/analog_schematic_readout.png

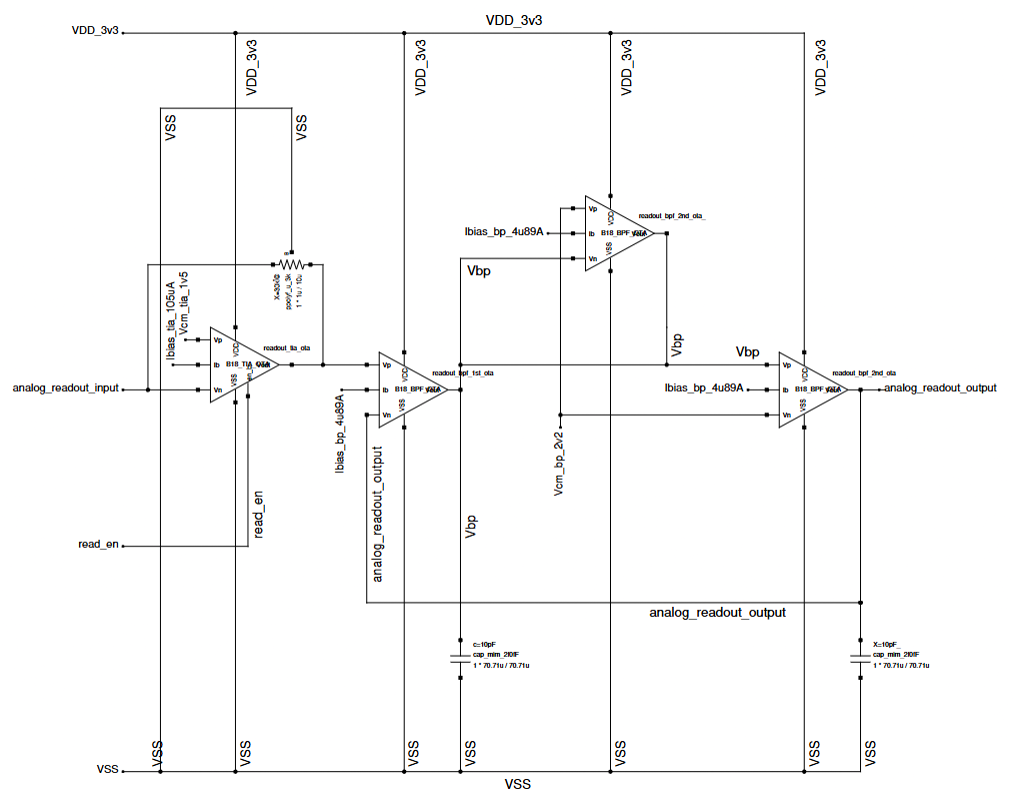
Media/Schematic/analog_schematic_readout.png
