llhtimlam/Probton/Media/Schematic/analog_schematic_readout_dark.png

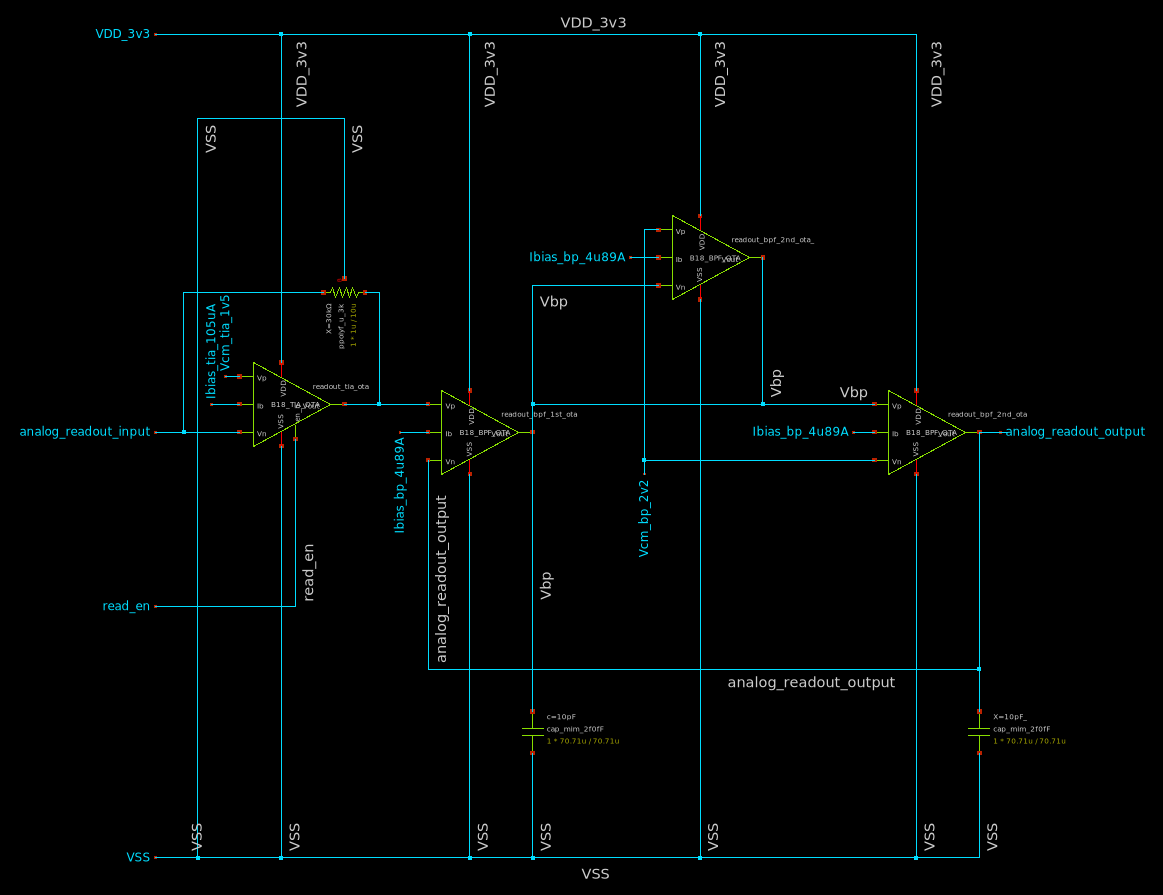
Media/Schematic/analog_schematic_readout_dark.png
