llhtimlam/Probton/Media/Schematic/mixer_tb.png

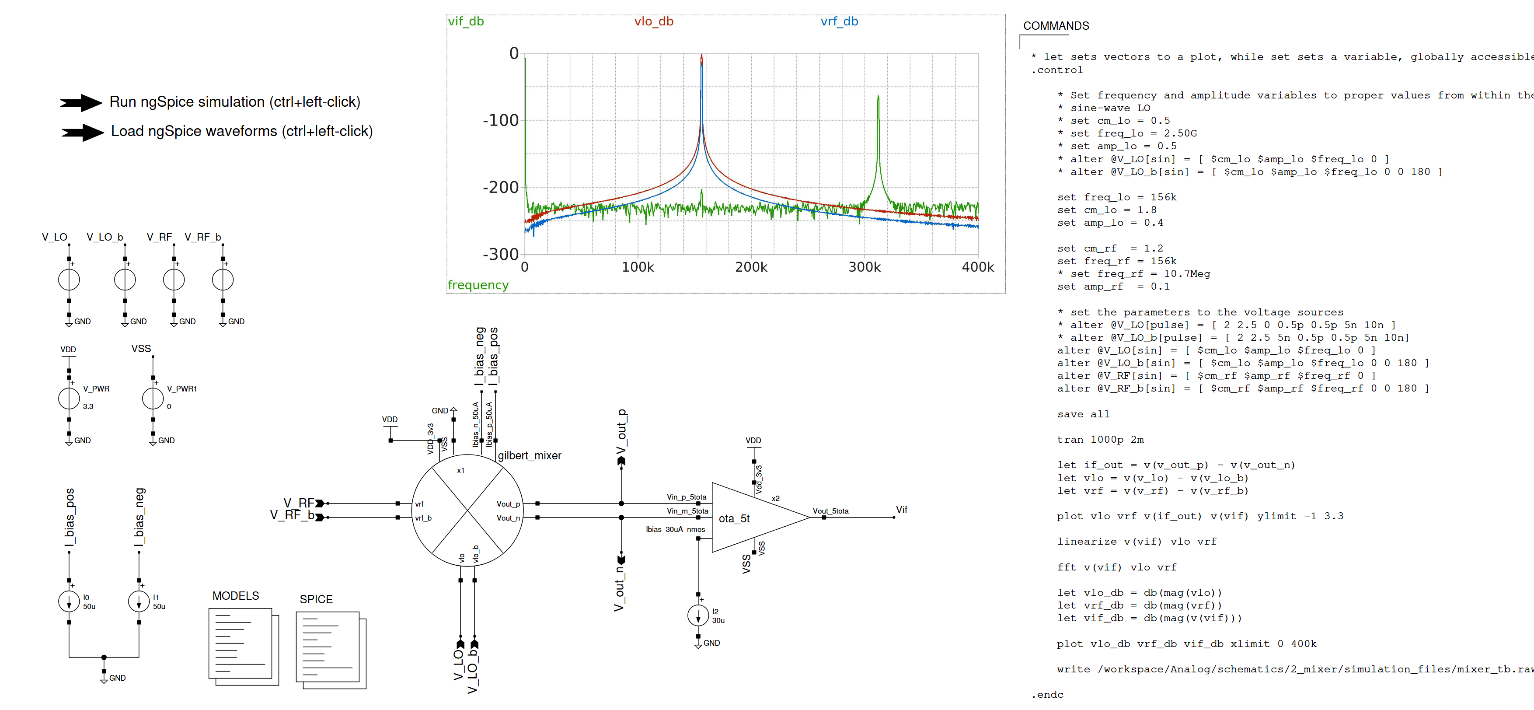
Media/Schematic/mixer_tb.png
