llhtimlam/Probton/Media/Schematic/mixer_tb_dark.png

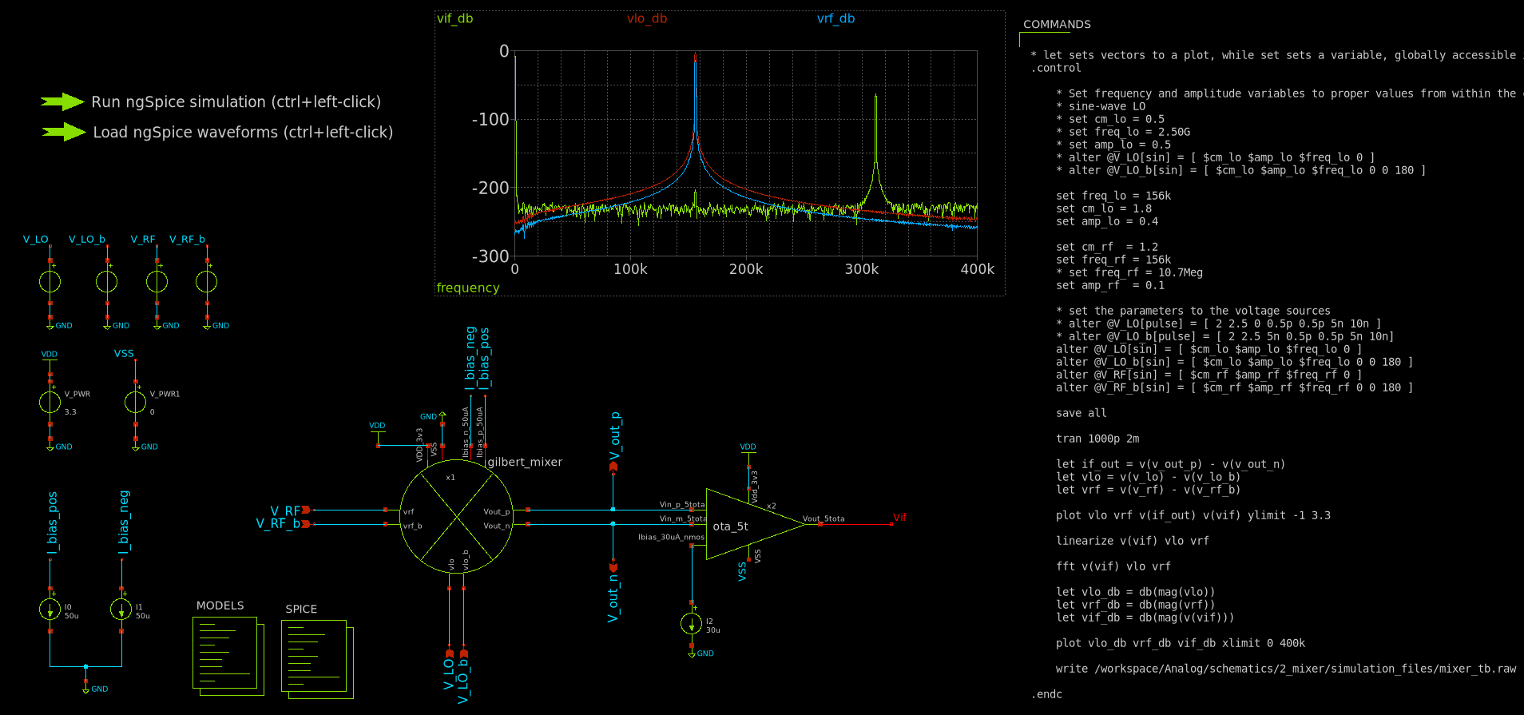
Media/Schematic/mixer_tb_dark.png
