llhtimlam/Probton/Media/Sourcing/Photodetector_Sourcing_Options.xlsx

Sheet: Photodetector Options
Photodetector Sourcing Options — Optical Probe Station Validation Rig
Target: 850 nm | Project AFE expects PHOTOCURRENT input (Photocurrent -> on-chip TIA) | Low-cost path
Option | Role | Candidate Part | Type / Output | Wavelength | Fiber | Resp. @850nm | Bandwidth | Est. Price (USD) | Verdict | Link
A — Primary (recommended) | In-loop sensor (feeds on-chip TIA) | Thorlabs FDSP780 | Bare Si PIN photodiode — CURRENT out | 780–970 nm | Single-mode | ~0.55 A/W | High (irrelevant here) | 150–250 | RECOMMENDED — current output matches block diagram; SM fiber clean for alignment | Product page (https://www.thorlabs.com/newgrouppage9.cfm?objectgroup_id=3157&pn=FDSP780)
B — Budget alternative | In-loop sensor (feeds on-chip TIA) | Thorlabs FDSP625 | Bare Si PIN photodiode — CURRENT out | 320–1000 nm | Multimode (graded-index) | ~0.55 A/W | High (irrelevant here) | 150–250 | Cheaper; MM easier to align; fine at 850 nm | Product page (https://www.thorlabs.com/newgrouppage9.cfm?objectgroup_id=3157)
C — Lowest cost / DIY couple | In-loop sensor (feeds on-chip TIA) | Thorlabs FDS-series bare PD | Bare Si PIN photodiode — CURRENT out | ~340–1100 nm | None (free-space; manual couple) | ~0.55 A/W | Varies by part | 20–80 | Cheapest, but adds manual fiber-coupling/mounting burden | Product page (https://www.thorlabs.com/photodiodes)
D — Optional bench reference | Reference instrument ONLY (NOT in loop) | Thorlabs PDA8A2 (or used PDA100A) | Amplified Si — VOLTAGE out (has own TIA) | 320–1000 nm | FC input | n/a (V/W gain) | 50 MHz | 300–500 (used ~300) | Bench reference pre-silicon; bypasses your TIA so NOT the in-loop sensor | Product page (https://www.thorlabs.com/thorproduct.cfm?partnumber=PDA8A2)

Sheet: Rationale & Sources
Why these options — decision rationale
The core decision: bare vs amplified
Your block diagram shows 'Photocurrent -> TIA' inside the Analog Front End. The project intends the sensor to output RAW PHOTOCURRENT; your ASIC's first stage does the amplification.
• BARE photodiode (A/B/C) outputs current -> feeds your on-chip TIA as designed. Validates the real signal chain. PRIMARY CHOICE.
• AMPLIFIED detector (D) outputs pre-amplified voltage -> bypasses your TIA. Bench reference only, NOT the in-loop sensor.
Bandwidth is NOT a selection criterion
Every candidate is 50 MHz–1 GHz — far faster than your kHz dither loop. Do not pay for bandwidth. Real spec axes: responsivity at 850 nm and low dark current / noise (alignment resolution is SNR-limited at the sensor, not ADC-limited).
Single-mode vs multimode fiber
SM (A) gives a clean mode, suppresses multipath interference — best for alignment-peak fidelity. MM (B) is cheaper, more forgiving to align. Both fine at 850 nm.
Sourcing notes
• Thorlabs list prices shift; treat prices as ranges and request a formal quote.
• Ask about academic / research discounts (often 10–30%).
• Option D used units appear second-hand (~$300).
Open item to confirm with the team
Confirm the 'photodetector input' pin is CURRENT (bare PD), not voltage (amplified). Block diagram says current — ratify so Team 1 (AFE/TIA) builds to the right interface.
Source links
Thorlabs Pigtailed Photodiodes (FDSP780 / FDSP625) | Open (https://www.thorlabs.com/newgrouppage9.cfm?objectgroup_id=3157)
Thorlabs Photodiodes overview (FDS-series bare) | Open (https://www.thorlabs.com/photodiodes)
Thorlabs PDA8A2 amplified detector | Open (https://www.thorlabs.com/thorproduct.cfm?partnumber=PDA8A2)
Thorlabs Si Fiber-Coupled Amplified Photodetectors | Open (https://www.thorlabs.com/newgrouppage9.cfm?objectgroup_ID=6685)
