llhtimlam/Probton/Media/Sourcing/XY_Stage_Sourcing_Options.xlsx

Sheet: XY Stage Options
Coarse XY Stage Sourcing Options — Optical Probe Station Validation Rig
Role: COARSE positioning (mm travel, µm-class). Motorized w/ PC control. Fine nm/µm alignment = separate piezo task. URLs verified live (site migrated to /product/ structure).
Option | Candidate Part | Drive / Type | Travel (X,Y) | Resolution (microstep) | Repeatability / Backlash | Control | Open command set? | Est. Price (USD) | Verdict | Link
A — Thorlabs M30XY | Thorlabs M30XY (integrated controller) | Brushed DC servo + optical encoder (closed-loop), monolithic XY | 30 x 30 mm | Encoder closed-loop | ±1.0 µm bidirectional repeatability | USB (Kinesis) + 2x 5V TTL trigger I/O | Documented (Kinesis/APT; .NET/Python) |  | True 1µm-class (closed-loop encoder). Single integrated purchase (no separate controller). USB Kinesis + 5V TTL triggers. Needs Kinesis SW + host/MCU to command. Price by quote. | Product page (https://www.thorlabs.com/newgrouppage9.cfm?objectgroup_id=14597&partnumber=M30XY)
B — Agiltron ILSM | Agiltron ILSM series | Stepper + lead screw, optical encoder | Per-axis; stack 2 for XY | 0.5 µm | Vendor-spec; verify | USB/RS232, integrated controller | Yes — vendor command list | ~1,000–2,000 (confirm) | Open/documented command set (script from own code). Stack 2 axes for XY. Confirm price/per-axis by quote. | Product page (https://agiltron.com/product/usb-motorized-linear-stages/)
C — OpticsFocus (budget) | OpticsFocus Motorized XY Stage (MOXY-02) | NEMA17 stepper, lead screw, crossed-roller | 30x30 mm (up to ~100) | ~0.625 µm (1/8 microstep) | <5 µm repeatability; <20 µm backlash | DB9 -> RS232/USB via MOC-01 controller (separate buy) | No — via vendor PC software | $696–$1,108 (stage); +controller | Cheapest true XY. Honest accuracy = repeatability <5µm / backlash <20µm (coarse only). Controller is a separate line item. | Product page (https://optics-focus.com/product/motorized-xy-stage/)
D — OpticsFocus (large travel) | OpticsFocus Motorized XY Translation Stage (MOXY-06) | NEMA17/23 stepper, precision ball screw (5mm pitch), recirc. ball bearing | 150x150 to 600x600 mm | 1.5625 µm (150mm, 1/8 microstep) | <5 µm repeatability; <30 µm backlash | DB9 -> RS232/USB via MOC-01/02 controller (separate buy) | No — via vendor PC software | $1,996–$3,546 | Large travel, heavy (12–25 kg). More travel than a fibre rig needs. | Product page (https://optics-focus.com/product/motorized-xy-translation-stage/)
E — OpenStage (DIY) | OpenStage (PLOS One, 2014) | Hobby steppers + open controller | Microscope-scale | — | Sub-µm repeatability (reported) | PC serial | Yes — fully open design/firmware | around $1000 | Lowest cost if built in-house; adds mechanical/firmware effort. Fully open design. | GitHub repo (https://github.com/raacampbell/openstage)

Sheet: Rationale & Sources
Coarse XY stage — decision rationale
This is the COARSE stage — don't over-buy
The XY stage carries the PIC/detector platform and does coarse positioning into capture range. µm precision over mm–cm travel is enough; the fine nm/µm alignment is the piezo actuator's job (separate task). Paying for nm resolution here is wasted budget.
Why motorized (team decision)
Team chose motorized so software/ASIC can command it. Any stepper stage with a documented PC/serial interface satisfies this. Bias toward stages with an OPEN command set so you can script motion and, if needed, integrate with the ASIC.
FLAG — undecided architecture question
Do the 'observer x/y' outputs DRIVE the coarse stage (coarse/fine dual-loop), or just REPORT offset (telemetry)?
• If DRIVE: stage needs a real-time-writable command interface; its latency/update rate becomes part of the control story. Open command set (Option A or D) matters.
• If TELEMETRY only: any motorized stage with PC control is fine; timing relaxed.
Either way, a stage with an open/documented command set keeps the decision reversible (e.g. if the ASIC later drives coarse moves).
Sourcing notes
• Two single-axis stages stacked = XY; confirm whether price is per-axis or per-XY-assembly, and whether a controller is included or extra.
• Verify the actual resolution/repeatability spec on each datasheet — 'µm-class' for steppers depends on microstepping and screw pitch.
• Ask about academic/research discounts.
How the XY stage interfaces (control signal)
• The ASIC PID does NOT connect directly to the XY stage. The PID drives the FINE piezo (analog). The coarse XY stage takes digital motion commands.
• Host-mediated option: host PC drives the M30XY over USB/Kinesis for coarse capture; ASIC observer x/y outputs report offset to host; host nudges stage. PID never emits stage commands.
• Optional hardware handshake: M30XY 5V TTL trigger I/O lets the ASIC assert a simple digital line (e.g. "locked"/"move") without speaking the full Kinesis protocol.
• If ASIC must directly command coarse moves: need a digital bridge (ASIC digital word -> MCU/host -> USB/serial -> stage). Favours an OPEN command set (Agiltron).
Source links (verified live; XY-only)
Thorlabs M30XY — 30mm XY, integrated controller, ±1µm, USB+TTL | Open (https://www.thorlabs.com/newgrouppage9.cfm?objectgroup_id=14597&partnumber=M30XY)
Agiltron ILSM USB stages (open command list) — alt | Open (https://agiltron.com/product/usb-motorized-linear-stages/)
OpticsFocus Motorized XY Stage (MOXY-02; $696–$1,108) — budget | Open (https://optics-focus.com/product/motorized-xy-stage/)
OpticsFocus Motorized XY Translation Stage (MOXY-06; large travel) | Open (https://optics-focus.com/product/motorized-xy-translation-stage/)
OpenStage open design — GitHub repo (firmware + wiki, GPLv3); PLOS One paper | Open (https://github.com/raacampbell/openstage)
MPI TS3000 probe system (full probe-station benchmark) | Open (https://www.mpi-corporation.com/ast/engineering-probe-systems/mpi-automated-systems/ts3000-ds-probe-systems/)
EverBeing C-series photonics probe station (benchmark) | Open (https://everbeingprober.com/products/probe-stations-manual/c-series-photonics-photonics-probe-station/)
