llhtimlam/Probton/librelane/MACRO_disable_IO_PIN_ORDER_CFG/59-klayout-render/chip_core.png

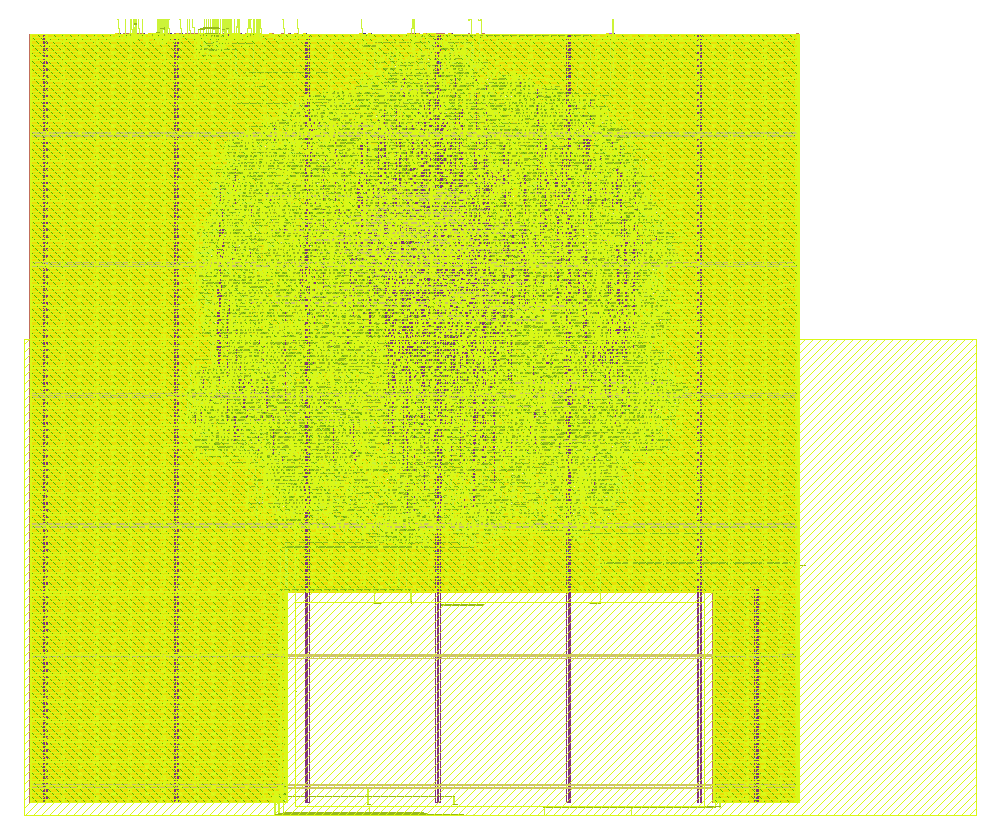
librelane/MACRO_disable_IO_PIN_ORDER_CFG/59-klayout-render/chip_core.png
