llhtimlam/Probton/gds/klayout_printout.pdf

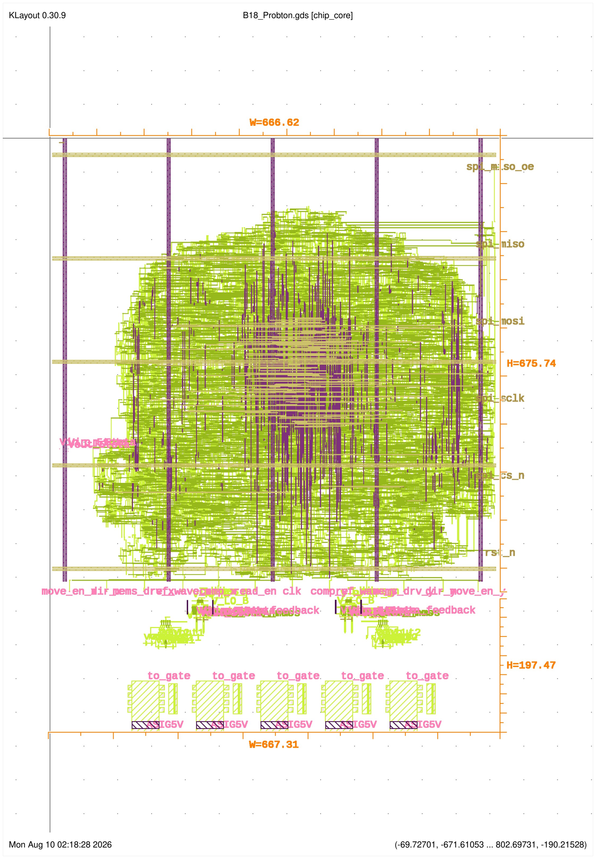
[picture p206: page 1]

KLayout 0.30.9 | B18_Probton.gds [chip_core]
Mon Aug 10 02:18:28 2026 | (-69.72701, -671.61053 ... 802.69731, -190.21528)
