llhtimlam/Probton/Media/Schematic/mixer_tb.pdf

# Analog/schematics/2_mixer/mixer_tb.sch

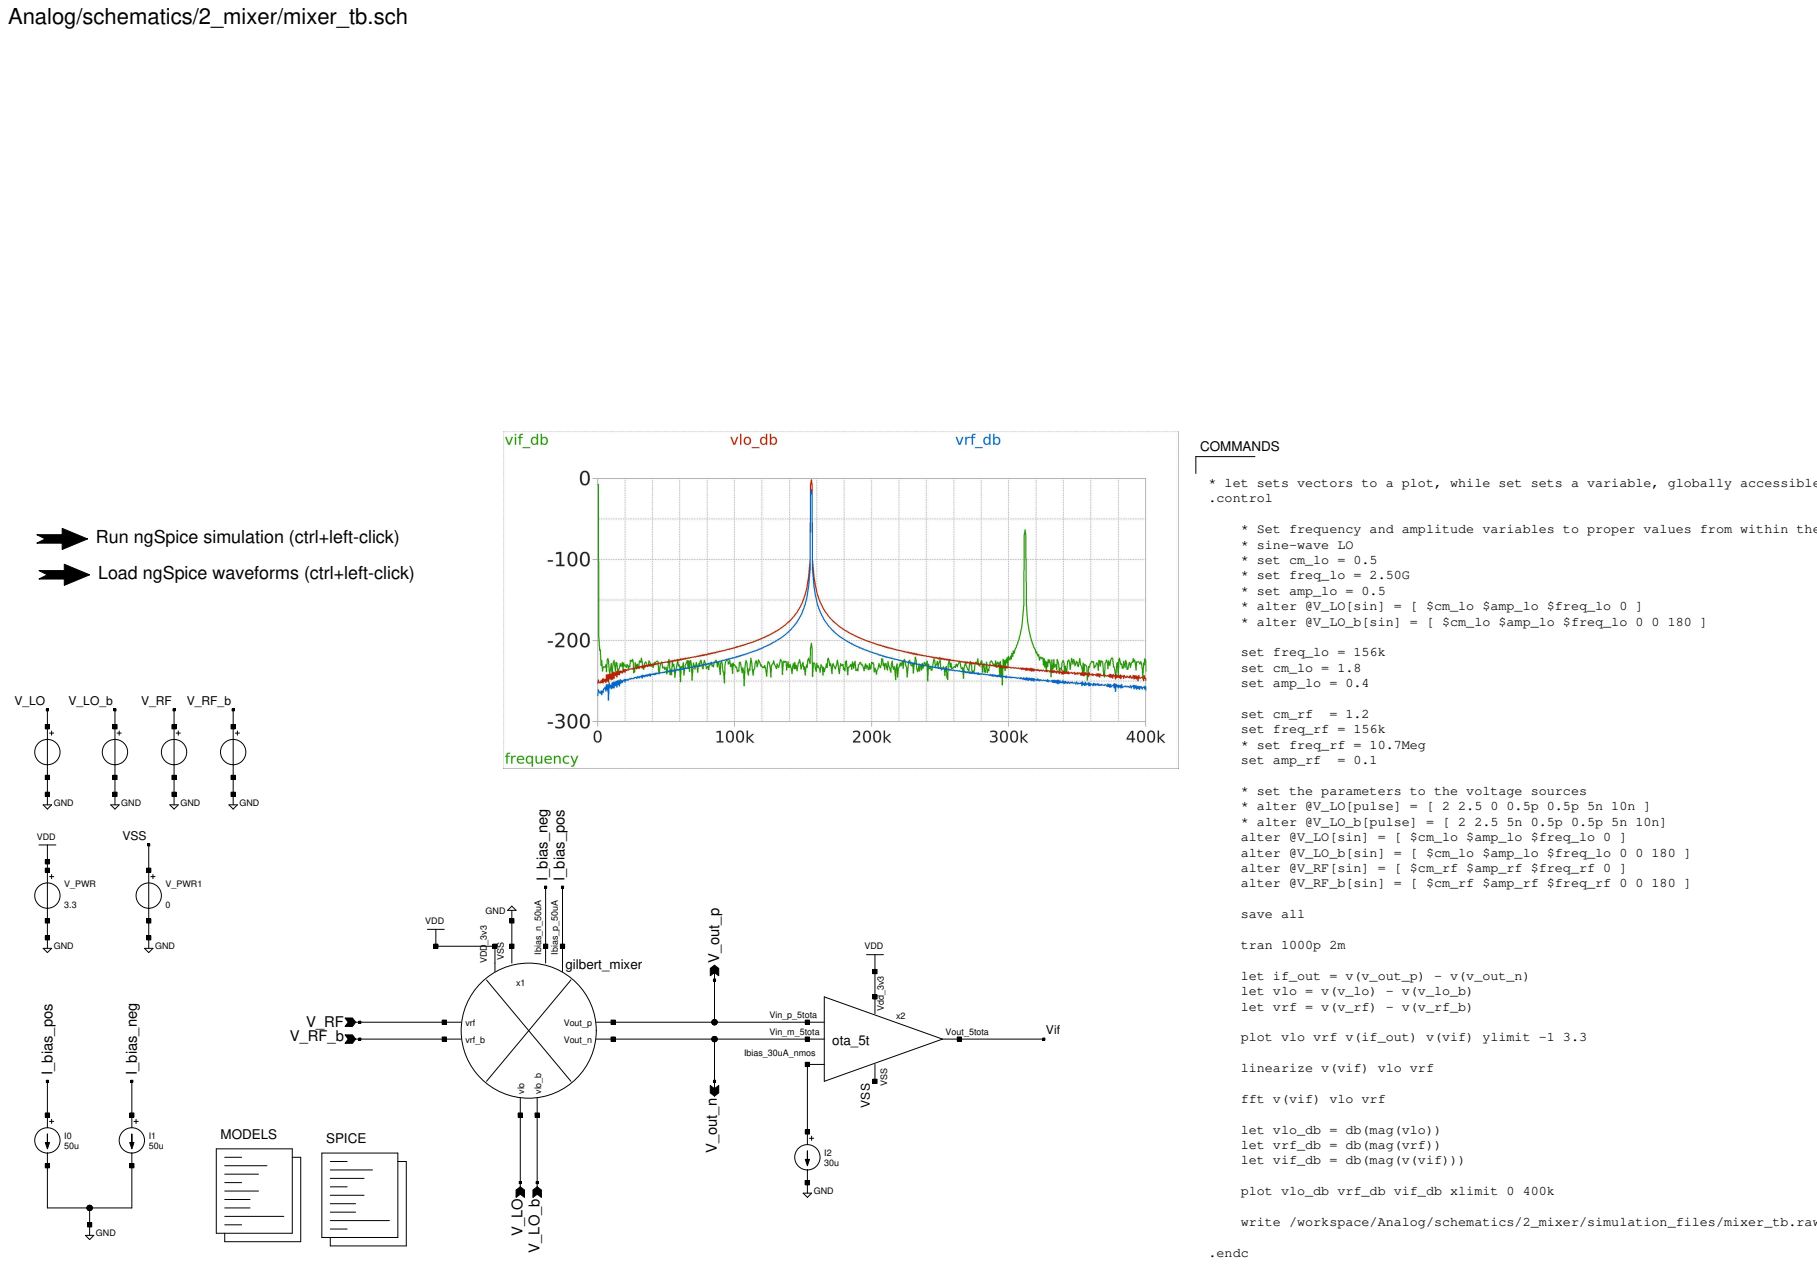
[picture p207: page 1]
MODELS; V_out_p V_out_n; GND; I_bias_neg; I_bias_pos; VDD; VDDVSS; Vif; V_PWR; V_PWR1; VSS; SPICE; gilbert_mixer; Vout_n; Vout_p; vlo; vlo_b; vrf; vrf_b; Ibias_n_50uA; Ibias_p_50uA; VDD_3v3; ota_5t; Vdd_3v3; Vout_5tota; Vin_p_5tota; Vin_m_5tota; Ibias_30uA_nmos; COMMANDS; set freq_lo = 156k set cm_lo = 1.8 set amp_lo = 0.4; set cm_rf; set freq_rf = 156k * set freq_rf = 10.7Meg; set amp_rf; save all; tran 1000p 2m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

* let sets vectors to a plot, while set sets a variable, globally accessible in .control
.control

Run ngSpice simulation (ctrl+left-click)

* Set frequency and amplitude variables to proper values from within the control sequence
* sine-wave LO
* set cm_lo = 0.5
* set freq_lo = 2.50G
* set amp_lo = 0.5
* alter @V_LO[sin] = [ $cm_lo $amp_lo $freq_lo 0 ]
* alter @V_LO_b[sin] = [ $cm_lo $amp_lo $freq_lo 0 0 180 ]

Load ngSpice waveforms (ctrl+left-click)

* set the parameters to the voltage sources
* alter @V_LO[pulse] = [ 2 2.5 0 0.5p 0.5p 5n 10n ]
* alter @V_LO_b[pulse] = [ 2 2.5 5n 0.5p 0.5p 5n 10n]
alter @V_LO[sin] = [ $cm_lo $amp_lo $freq_lo 0 ]
alter @V_LO_b[sin] = [ $cm_lo $amp_lo $freq_lo 0 0 180 ]
alter @V_RF[sin] = [ $cm_rf $amp_rf $freq_rf 0 ]
alter @V_RF_b[sin] = [ $cm_rf $amp_rf $freq_rf 0 0 180 ]

plot vlo vrf v(if_out) v(vif) ylimit -1 3.3

linearize v(vif) vlo vrf

fft v(vif) vlo vrf

let vlo_db = db(mag(vlo))
let vrf_db = db(mag(vrf))
let vif_db = db(mag(v(vif)))

write /workspace/Analog/schematics/2_mixer/simulation_files/mixer_tb.raw
