llhtimlam/Probton/Media/Schematic/analog_schematic.pdf

# Analog/schematics/B18_Probton.sch

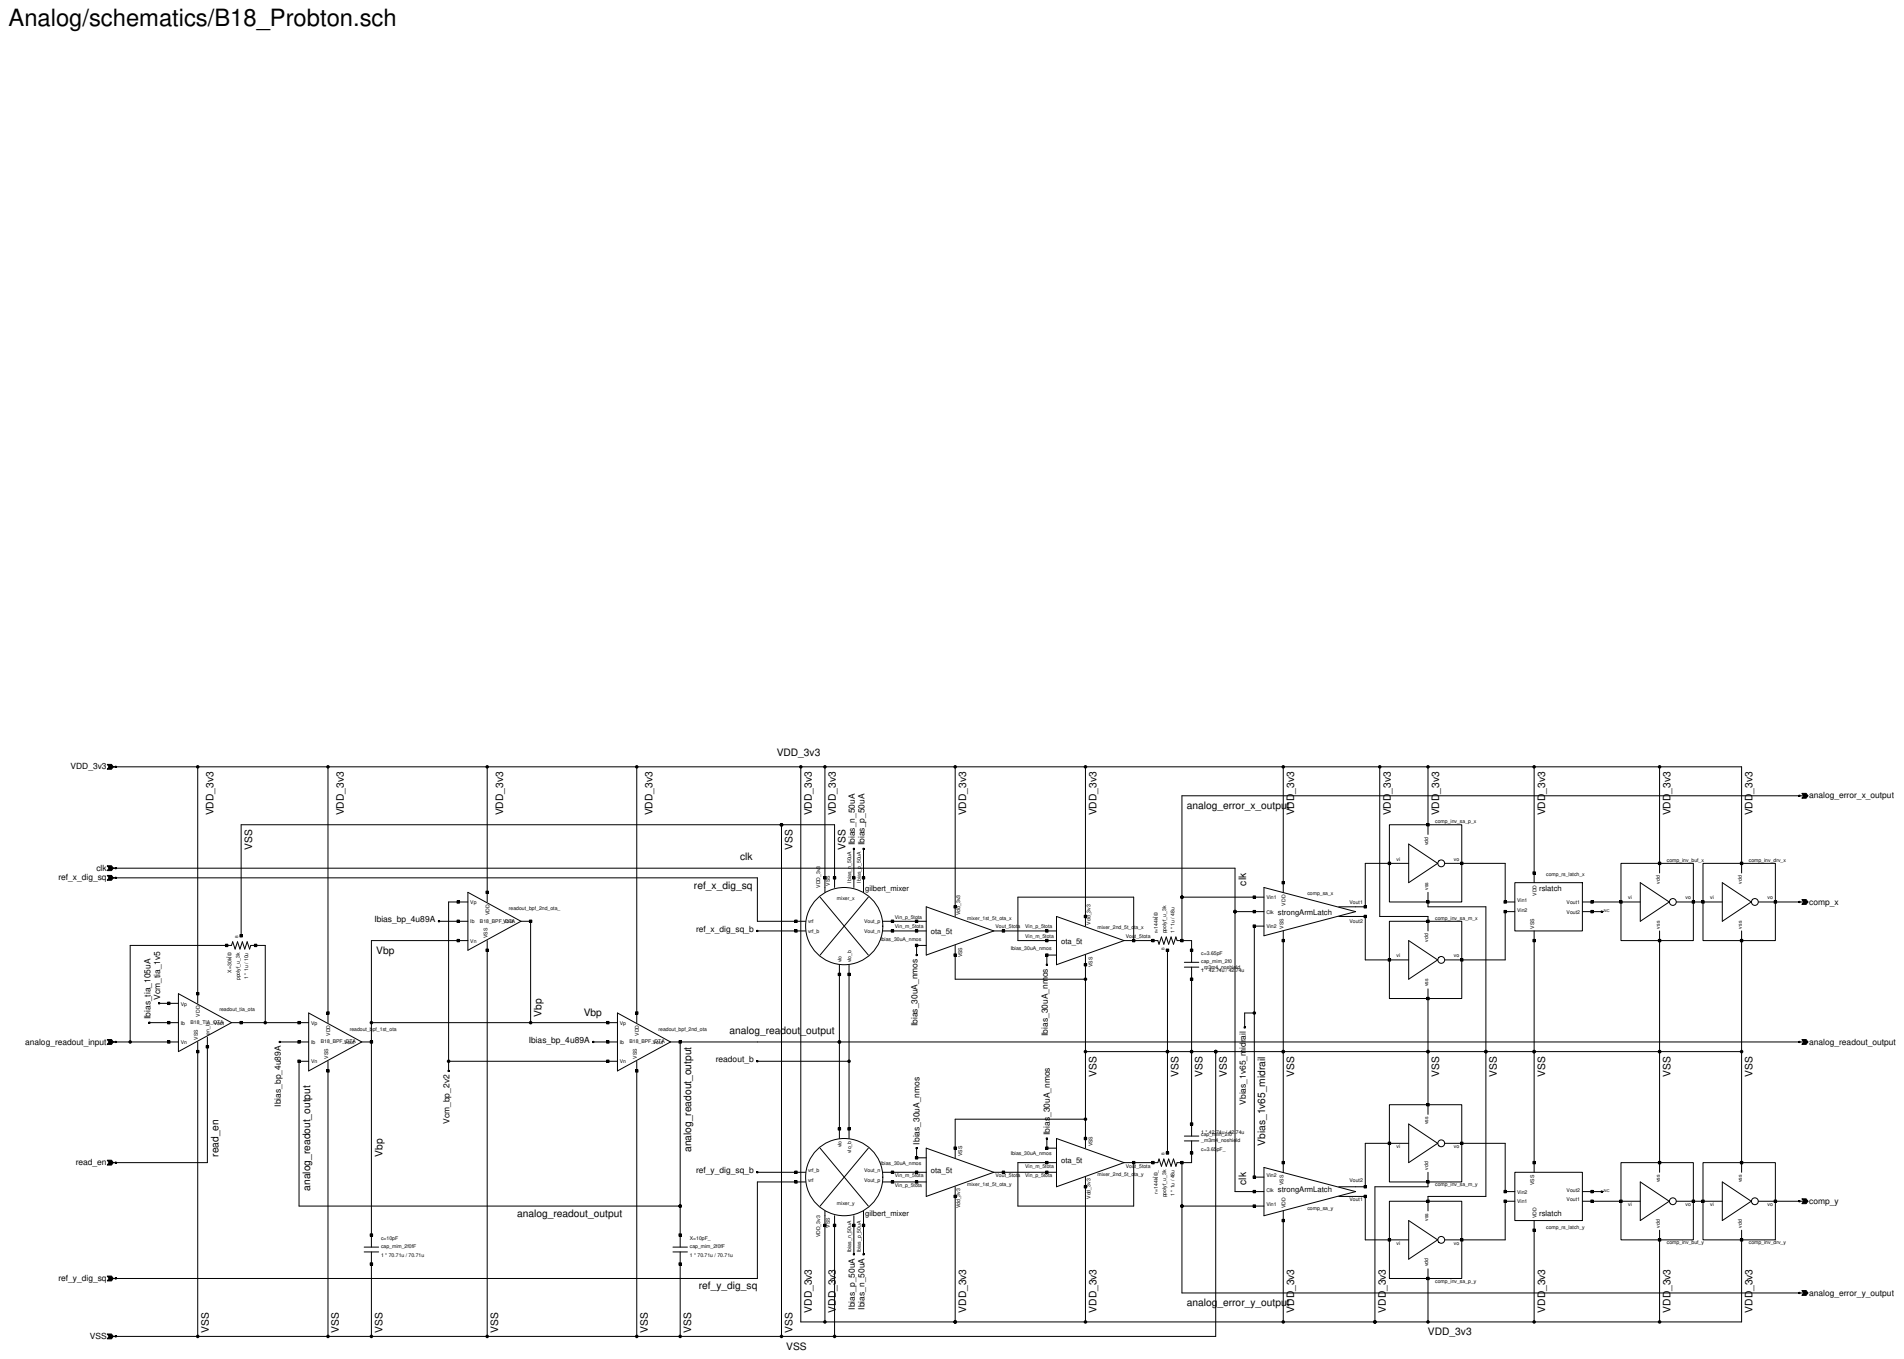
[picture p208: page 1]
gilbert_mixer; mixer_x; Vout_n; Vout_p; vlo; vlo_b; vrf; vrf_b; Ibias_n_50uA; Ibias_p_50uA; VSS; VDD_3v3; ota_5t; mixer_1st_5t_ota_x; Vdd_3v3; Vout_5tota; Vin_p_5tota; Vin_m_5tota; Ibias_30uA_nmos; mixer_2nd_5t_ota_x; strongArmLatch; comp_sa_x; Clk; Vin1; Vin2; VDD VSS; Vout1; Vout2; comp_inv_sa_p_x; vdd; vo vss; comp_inv_sa_m_x; rslatch; comp_rs_latch_x; VDD; comp_inv_buf_x; comp_inv_drv_x; ref_x_dig_sq_b; ppolyf_u_3k; cap_mim_2f0 _m3m4_noshield; readout_b; mixer_y; mixer_1st_5t_ota_y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
