llhtimlam/Probton/Media/Schematic/analog_schematic_mixer&comp_xy.pdf

# Analog/schematics/B18_Probton_mixer&comp_xy.sch

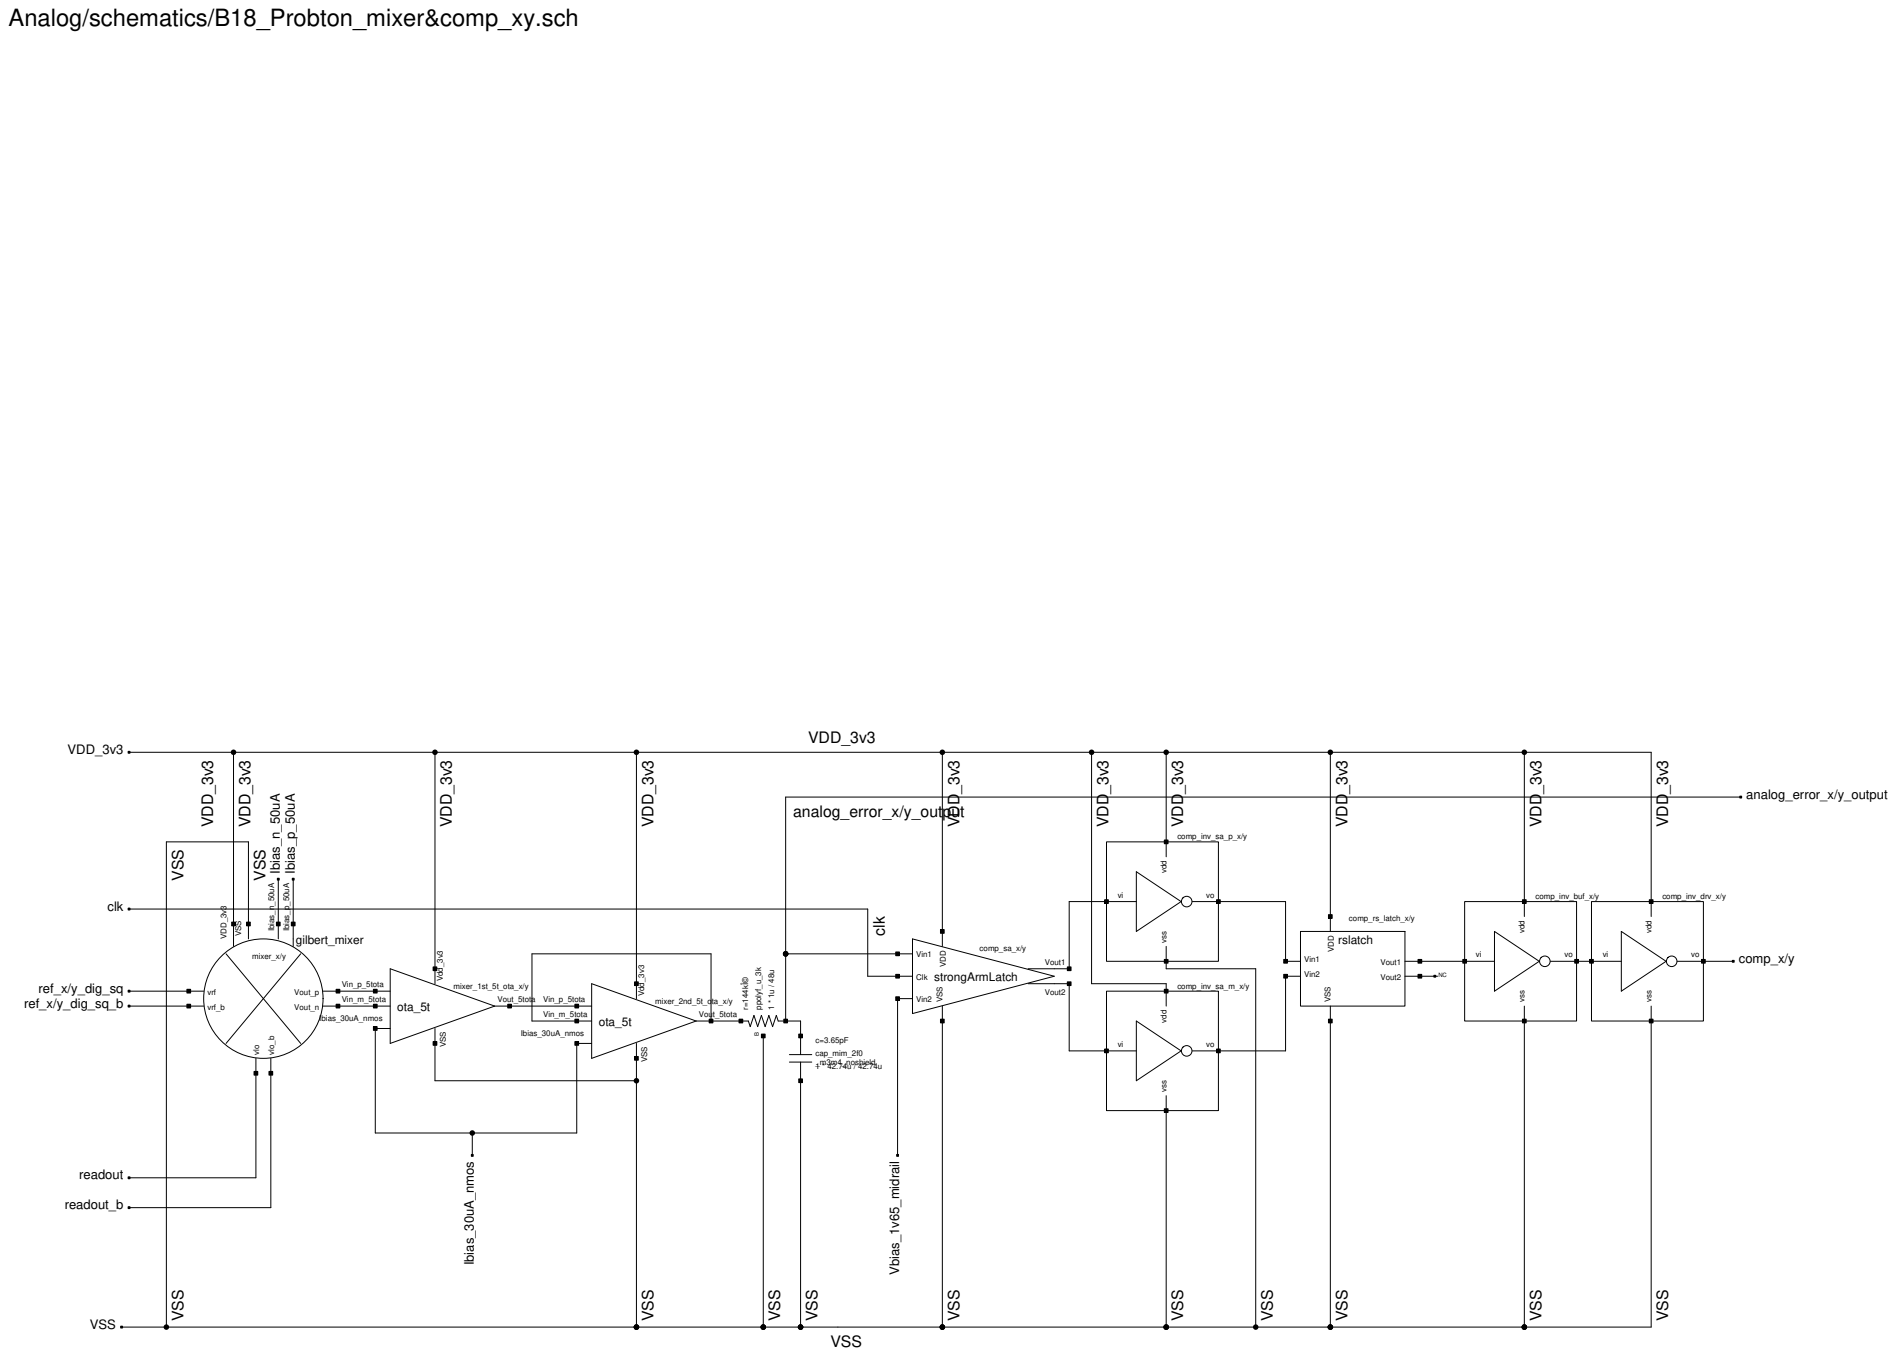
[picture p210: page 1]
gilbert_mixer; mixer_x/y; Vout_n; Vout_p; vlo; vlo_b; vrf; vrf_b; Ibias_n_50uA; Ibias_p_50uA; VSS; VDD_3v3; ota_5t; mixer_1st_5t_ota_x/y; Vdd_3v3; Vout_5tota; Vin_p_5tota; Vin_m_5tota; Ibias_30uA_nmos; mixer_2nd_5t_ota_x/y; strongArmLatch; comp_sa_x/y; Clk; Vin1; Vin2; VDD VSS; Vout1; Vout2; comp_inv_sa_p_x/y; vdd; vo vss; comp_inv_sa_m_x/y; rslatch; comp_rs_latch_x/y; VDD; comp_inv_buf_x/y; comp_inv_drv_x/y; ref_x/y_dig_sq ref_x/y_dig_sq_b; ppolyf_u_3k; cap_mim_2f0 _m3m4_noshield; comp_x/y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
