llhtimlam/Probton/librelane/Submodule/Digital_RTL_GDS_signal_processor/68-magic-spiceextraction/signal_processor.spice

* NGSPICE file created from signal_processor.ext - technology: gf180mcuD

* Black-box entry subcircuit for gf180mcu_fd_sc_mcu7t5v0__filltie abstract view
.subckt gf180mcu_fd_sc_mcu7t5v0__filltie VDD VSS
.ends

* Black-box entry subcircuit for gf180mcu_fd_sc_mcu7t5v0__fillcap_4 abstract view
.subckt gf180mcu_fd_sc_mcu7t5v0__fillcap_4 VDD VNW VPW VSS
.ends

* Black-box entry subcircuit for gf180mcu_fd_sc_mcu7t5v0__fill_2 abstract view
.subckt gf180mcu_fd_sc_mcu7t5v0__fill_2 VDD VNW VPW VSS
.ends

* Black-box entry subcircuit for gf180mcu_fd_sc_mcu7t5v0__fillcap_16 abstract view
.subckt gf180mcu_fd_sc_mcu7t5v0__fillcap_16 VDD VNW VPW VSS
.ends

* Black-box entry subcircuit for gf180mcu_fd_sc_mcu7t5v0__nor3_1 abstract view
.subckt gf180mcu_fd_sc_mcu7t5v0__nor3_1 A1 A2 A3 ZN VDD VNW VPW VSS
.ends

* Black-box entry subcircuit for gf180mcu_fd_sc_mcu7t5v0__nand3_1 abstract view
.subckt gf180mcu_fd_sc_mcu7t5v0__nand3_1 A1 A2 A3 ZN VDD VNW VPW VSS
.ends

* Black-box entry subcircuit for gf180mcu_fd_sc_mcu7t5v0__fill_1 abstract view
.subckt gf180mcu_fd_sc_mcu7t5v0__fill_1 VDD VNW VPW VSS
.ends

* Black-box entry subcircuit for gf180mcu_fd_sc_mcu7t5v0__clkinv_1 abstract view
.subckt gf180mcu_fd_sc_mcu7t5v0__clkinv_1 I ZN VDD VNW VPW VSS
.ends

* Black-box entry subcircuit for gf180mcu_fd_sc_mcu7t5v0__clkbuf_1 abstract view
.subckt gf180mcu_fd_sc_mcu7t5v0__clkbuf_1 I Z VDD VNW VPW VSS
.ends

* Black-box entry subcircuit for gf180mcu_fd_sc_mcu7t5v0__endcap abstract view
.subckt gf180mcu_fd_sc_mcu7t5v0__endcap VDD VSS
.ends

* Black-box entry subcircuit for gf180mcu_fd_sc_mcu7t5v0__buf_2 abstract view
.subckt gf180mcu_fd_sc_mcu7t5v0__buf_2 I Z VDD VNW VPW VSS
.ends

* Black-box entry subcircuit for gf180mcu_fd_sc_mcu7t5v0__clkbuf_16 abstract view
.subckt gf180mcu_fd_sc_mcu7t5v0__clkbuf_16 I Z VDD VNW VPW VSS
.ends

* Black-box entry subcircuit for gf180mcu_fd_sc_mcu7t5v0__nand2_2 abstract view
.subckt gf180mcu_fd_sc_mcu7t5v0__nand2_2 A1 A2 ZN VDD VNW VPW VSS
.ends

* Black-box entry subcircuit for gf180mcu_fd_sc_mcu7t5v0__fillcap_64 abstract view
.subckt gf180mcu_fd_sc_mcu7t5v0__fillcap_64 VDD VNW VPW VSS
.ends

* Black-box entry subcircuit for gf180mcu_fd_sc_mcu7t5v0__fillcap_8 abstract view
.subckt gf180mcu_fd_sc_mcu7t5v0__fillcap_8 VDD VNW VPW VSS
.ends

* Black-box entry subcircuit for gf180mcu_fd_sc_mcu7t5v0__clkbuf_2 abstract view
.subckt gf180mcu_fd_sc_mcu7t5v0__clkbuf_2 I Z VDD VNW VPW VSS
.ends

* Black-box entry subcircuit for gf180mcu_fd_sc_mcu7t5v0__fillcap_32 abstract view
.subckt gf180mcu_fd_sc_mcu7t5v0__fillcap_32 VDD VNW VPW VSS
.ends

* Black-box entry subcircuit for gf180mcu_fd_sc_mcu7t5v0__aoi22_1 abstract view
.subckt gf180mcu_fd_sc_mcu7t5v0__aoi22_1 A1 A2 B1 B2 ZN VDD VNW VPW VSS
.ends

* Black-box entry subcircuit for gf180mcu_fd_sc_mcu7t5v0__nand4_1 abstract view
.subckt gf180mcu_fd_sc_mcu7t5v0__nand4_1 A1 A2 A3 A4 ZN VDD VNW VPW VSS
.ends

* Black-box entry subcircuit for gf180mcu_fd_sc_mcu7t5v0__dffrnq_1 abstract view
.subckt gf180mcu_fd_sc_mcu7t5v0__dffrnq_1 D RN CLK Q VDD VNW VPW VSS
.ends

* Black-box entry subcircuit for gf180mcu_fd_sc_mcu7t5v0__oai21_1 abstract view
.subckt gf180mcu_fd_sc_mcu7t5v0__oai21_1 A1 A2 B ZN VDD VNW VPW VSS
.ends

* Black-box entry subcircuit for gf180mcu_fd_sc_mcu7t5v0__nand2_1 abstract view
.subckt gf180mcu_fd_sc_mcu7t5v0__nand2_1 A1 A2 ZN VDD VNW VPW VSS
.ends

* Black-box entry subcircuit for gf180mcu_fd_sc_mcu7t5v0__xor2_1 abstract view
.subckt gf180mcu_fd_sc_mcu7t5v0__xor2_1 A1 A2 Z VDD VNW VPW VSS
.ends

* Black-box entry subcircuit for gf180mcu_fd_sc_mcu7t5v0__nor2_1 abstract view
.subckt gf180mcu_fd_sc_mcu7t5v0__nor2_1 A1 A2 ZN VDD VNW VPW VSS
.ends

* Black-box entry subcircuit for gf180mcu_fd_sc_mcu7t5v0__xnor2_1 abstract view
.subckt gf180mcu_fd_sc_mcu7t5v0__xnor2_1 A1 A2 ZN VDD VNW VPW VSS
.ends

* Black-box entry subcircuit for gf180mcu_fd_sc_mcu7t5v0__oai22_1 abstract view
.subckt gf180mcu_fd_sc_mcu7t5v0__oai22_1 A1 A2 B1 B2 ZN VDD VNW VPW VSS
.ends

* Black-box entry subcircuit for gf180mcu_fd_sc_mcu7t5v0__dlyb_1 abstract view
.subckt gf180mcu_fd_sc_mcu7t5v0__dlyb_1 I Z VDD VNW VPW VSS
.ends

* Black-box entry subcircuit for gf180mcu_fd_sc_mcu7t5v0__and2_1 abstract view
.subckt gf180mcu_fd_sc_mcu7t5v0__and2_1 A1 A2 Z VDD VNW VPW VSS
.ends

* Black-box entry subcircuit for gf180mcu_fd_sc_mcu7t5v0__buf_1 abstract view
.subckt gf180mcu_fd_sc_mcu7t5v0__buf_1 I Z VDD VNW VPW VSS
.ends

* Black-box entry subcircuit for gf180mcu_fd_sc_mcu7t5v0__nor4_4 abstract view
.subckt gf180mcu_fd_sc_mcu7t5v0__nor4_4 A1 A2 A3 A4 ZN VDD VNW VPW VSS
.ends

* Black-box entry subcircuit for gf180mcu_fd_sc_mcu7t5v0__oai32_1 abstract view
.subckt gf180mcu_fd_sc_mcu7t5v0__oai32_1 A1 A2 A3 B1 B2 ZN VDD VNW VPW VSS
.ends

* Black-box entry subcircuit for gf180mcu_fd_sc_mcu7t5v0__aoi21_1 abstract view
.subckt gf180mcu_fd_sc_mcu7t5v0__aoi21_1 A1 A2 B ZN VDD VNW VPW VSS
.ends

* Black-box entry subcircuit for gf180mcu_fd_sc_mcu7t5v0__oai211_1 abstract view
.subckt gf180mcu_fd_sc_mcu7t5v0__oai211_1 A1 A2 B C ZN VDD VNW VPW VSS
.ends

* Black-box entry subcircuit for gf180mcu_fd_sc_mcu7t5v0__oai31_1 abstract view
.subckt gf180mcu_fd_sc_mcu7t5v0__oai31_1 A1 A2 A3 B ZN VDD VNW VPW VSS
.ends

* Black-box entry subcircuit for gf180mcu_fd_sc_mcu7t5v0__nor3_2 abstract view
.subckt gf180mcu_fd_sc_mcu7t5v0__nor3_2 A1 A2 A3 ZN VDD VNW VPW VSS
.ends

* Black-box entry subcircuit for gf180mcu_fd_sc_mcu7t5v0__or3_1 abstract view
.subckt gf180mcu_fd_sc_mcu7t5v0__or3_1 A1 A2 A3 Z VDD VNW VPW VSS
.ends

.subckt signal_processor VDD VSS clk comp_raw dir jitter_flag latch_phase270 latch_phase270_ack
+ latch_phase90 latch_phase90_ack move_en phase_state[0] phase_state[1] rst_n soft_rst_n
+ votes_in_phase[0] votes_in_phase[1] votes_in_phase[2] votes_in_phase[3] votes_out_phase[0]
+ votes_out_phase[1] votes_out_phase[2] votes_out_phase[3]
XTAP_TAPCELL_ROW_24_139 VDD VSS gf180mcu_fd_sc_mcu7t5v0__filltie
XFILLER_22_177 VDD VDD VSS VSS gf180mcu_fd_sc_mcu7t5v0__fillcap_4
XFILLER_18_214 VDD VDD VSS VSS gf180mcu_fd_sc_mcu7t5v0__fill_2
XFILLER_6_107 VDD VDD VSS VSS gf180mcu_fd_sc_mcu7t5v0__fillcap_4
XFILLER_10_125 VDD VDD VSS VSS gf180mcu_fd_sc_mcu7t5v0__fillcap_16
X_200_ _202_/A1 _200_/A2 _200_/A3 _218_/D VDD VDD VSS VSS gf180mcu_fd_sc_mcu7t5v0__nor3_1
X_131_ _240_/Q _241_/Q _242_/Q _132_/A3 VDD VDD VSS VSS gf180mcu_fd_sc_mcu7t5v0__nand3_1
XFILLER_21_209 VDD VDD VSS VSS gf180mcu_fd_sc_mcu7t5v0__fill_1
XFILLER_9_66 VDD VDD VSS VSS gf180mcu_fd_sc_mcu7t5v0__fillcap_4
X_114_ _220_/Q _203_/B2 VDD VDD VSS VSS gf180mcu_fd_sc_mcu7t5v0__clkinv_1
Xload_slew30 _188_/A1 _108_/I VDD VDD VSS VSS gf180mcu_fd_sc_mcu7t5v0__clkbuf_1
XFILLER_28_172 VDD VDD VSS VSS gf180mcu_fd_sc_mcu7t5v0__fill_2
XFILLER_19_183 VDD VDD VSS VSS gf180mcu_fd_sc_mcu7t5v0__fillcap_4
XFILLER_6_34 VDD VDD VSS VSS gf180mcu_fd_sc_mcu7t5v0__fill_1
XPHY_EDGE_ROW_16_Left_48 VDD VSS gf180mcu_fd_sc_mcu7t5v0__endcap
XTAP_TAPCELL_ROW_27_148 VDD VSS gf180mcu_fd_sc_mcu7t5v0__filltie
Xoutput20 _228_/Q votes_out_phase[3] VDD VDD VSS VSS gf180mcu_fd_sc_mcu7t5v0__buf_2
Xoutput7 _218_/Q jitter_flag VDD VDD VSS VSS gf180mcu_fd_sc_mcu7t5v0__buf_2
Xclkbuf_3_6__f_clk clkbuf_0_clk/Z _246_/CLK VDD VDD VSS VSS gf180mcu_fd_sc_mcu7t5v0__clkbuf_16
XFILLER_13_112 VDD VDD VSS VSS gf180mcu_fd_sc_mcu7t5v0__fillcap_4
XPHY_EDGE_ROW_19_Left_51 VDD VSS gf180mcu_fd_sc_mcu7t5v0__endcap
XPHY_EDGE_ROW_21_Right_21 VDD VSS gf180mcu_fd_sc_mcu7t5v0__endcap
X_130_ _230_/Q _256_/Q _203_/A1 VDD VDD VSS VSS gf180mcu_fd_sc_mcu7t5v0__nand2_2
XPHY_EDGE_ROW_4_Left_36 VDD VSS gf180mcu_fd_sc_mcu7t5v0__endcap
XPHY_EDGE_ROW_12_Right_12 VDD VSS gf180mcu_fd_sc_mcu7t5v0__endcap
XPHY_EDGE_ROW_30_Right_30 VDD VSS gf180mcu_fd_sc_mcu7t5v0__endcap
XFILLER_3_2 VDD VDD VSS VSS gf180mcu_fd_sc_mcu7t5v0__fillcap_64
XFILLER_0_36 VDD VDD VSS VSS gf180mcu_fd_sc_mcu7t5v0__fillcap_8
X_113_ _216_/Q _196_/A2 VDD VDD VSS VSS gf180mcu_fd_sc_mcu7t5v0__clkinv_1
Xload_slew42 _245_/RN _228_/RN VDD VDD VSS VSS gf180mcu_fd_sc_mcu7t5v0__clkbuf_2
Xload_slew31 wire32/Z _188_/A1 VDD VDD VSS VSS gf180mcu_fd_sc_mcu7t5v0__clkbuf_2
XTAP_TAPCELL_ROW_27_149 VDD VSS gf180mcu_fd_sc_mcu7t5v0__filltie
XFILLER_25_176 VDD VDD VSS VSS gf180mcu_fd_sc_mcu7t5v0__fillcap_8
XPHY_EDGE_ROW_6_Right_6 VDD VSS gf180mcu_fd_sc_mcu7t5v0__endcap
XFILLER_15_66 VDD VDD VSS VSS gf180mcu_fd_sc_mcu7t5v0__fillcap_4
Xoutput8 _244_/Q latch_phase270_ack VDD VDD VSS VSS gf180mcu_fd_sc_mcu7t5v0__buf_2
XFILLER_31_157 VDD VDD VSS VSS gf180mcu_fd_sc_mcu7t5v0__fillcap_4
XFILLER_31_146 VDD VDD VSS VSS gf180mcu_fd_sc_mcu7t5v0__fill_2
XFILLER_31_124 VDD VDD VSS VSS gf180mcu_fd_sc_mcu7t5v0__fillcap_8
Xoutput10 _217_/Q move_en VDD VDD VSS VSS gf180mcu_fd_sc_mcu7t5v0__buf_2
XFILLER_15_88 VDD VDD VSS VSS gf180mcu_fd_sc_mcu7t5v0__fillcap_8
XFILLER_22_102 VDD VDD VSS VSS gf180mcu_fd_sc_mcu7t5v0__fill_2
XFILLER_9_139 VDD VDD VSS VSS gf180mcu_fd_sc_mcu7t5v0__fill_1
XFILLER_8_150 VDD VDD VSS VSS gf180mcu_fd_sc_mcu7t5v0__fillcap_4
XFILLER_27_216 VDD VDD VSS VSS gf180mcu_fd_sc_mcu7t5v0__fill_1
XFILLER_12_34 VDD VDD VSS VSS gf180mcu_fd_sc_mcu7t5v0__fill_1
XFILLER_18_216 VDD VDD VSS VSS gf180mcu_fd_sc_mcu7t5v0__fill_1
XTAP_TAPCELL_ROW_11_100 VDD VSS gf180mcu_fd_sc_mcu7t5v0__filltie
XPHY_EDGE_ROW_20_Left_52 VDD VSS gf180mcu_fd_sc_mcu7t5v0__endcap
XFILLER_23_66 VDD VDD VSS VSS gf180mcu_fd_sc_mcu7t5v0__fillcap_4
XFILLER_23_88 VDD VDD VSS VSS gf180mcu_fd_sc_mcu7t5v0__fill_1
XFILLER_2_101 VDD VDD VSS VSS gf180mcu_fd_sc_mcu7t5v0__fillcap_4
XFILLER_0_48 VDD VDD VSS VSS gf180mcu_fd_sc_mcu7t5v0__fill_2
XFILLER_0_59 VDD VDD VSS VSS gf180mcu_fd_sc_mcu7t5v0__fillcap_8
XFILLER_29_2 VDD VDD VSS VSS gf180mcu_fd_sc_mcu7t5v0__fillcap_32
X_189_ _187_/B _189_/A2 _189_/B1 _189_/B2 _241_/D VDD VDD VSS VSS gf180mcu_fd_sc_mcu7t5v0__aoi22_1
X_112_ _241_/Q _189_/B2 VDD VDD VSS VSS gf180mcu_fd_sc_mcu7t5v0__clkinv_1
Xload_slew43 _256_/RN _248_/RN VDD VDD VSS VSS gf180mcu_fd_sc_mcu7t5v0__buf_2
XFILLER_20_34 VDD VDD VSS VSS gf180mcu_fd_sc_mcu7t5v0__fill_1
XFILLER_28_174 VDD VDD VSS VSS gf180mcu_fd_sc_mcu7t5v0__fill_1
XFILLER_6_69 VDD VDD VSS VSS gf180mcu_fd_sc_mcu7t5v0__fillcap_16
Xoutput9 _243_/Q latch_phase90_ack VDD VDD VSS VSS gf180mcu_fd_sc_mcu7t5v0__buf_2
Xoutput11 _219_/Q phase_state[0] VDD VDD VSS VSS gf180mcu_fd_sc_mcu7t5v0__buf_2
XFILLER_16_177 VDD VDD VSS VSS gf180mcu_fd_sc_mcu7t5v0__fill_2
XFILLER_11_2 VDD VDD VSS VSS gf180mcu_fd_sc_mcu7t5v0__fillcap_64
XFILLER_26_77 VDD VDD VSS VSS gf180mcu_fd_sc_mcu7t5v0__fillcap_4
XTAP_TAPCELL_ROW_11_101 VDD VSS gf180mcu_fd_sc_mcu7t5v0__filltie
XFILLER_15_209 VDD VDD VSS VSS gf180mcu_fd_sc_mcu7t5v0__fill_1
X_188_ _188_/A1 _239_/Q _240_/Q _129_/Z _189_/B1 VDD VDD VSS VSS gf180mcu_fd_sc_mcu7t5v0__nand4_1
XFILLER_18_34 VDD VDD VSS VSS gf180mcu_fd_sc_mcu7t5v0__fill_1
XFILLER_11_212 VDD VDD VSS VSS gf180mcu_fd_sc_mcu7t5v0__fillcap_4
Xload_slew44 _256_/RN _245_/RN VDD VDD VSS VSS gf180mcu_fd_sc_mcu7t5v0__buf_2
X_111_ _240_/Q _183_/A1 VDD VDD VSS VSS gf180mcu_fd_sc_mcu7t5v0__clkinv_1
XFILLER_6_37 VDD VDD VSS VSS gf180mcu_fd_sc_mcu7t5v0__fillcap_32
XFILLER_19_175 VDD VDD VSS VSS gf180mcu_fd_sc_mcu7t5v0__fillcap_8
XFILLER_19_142 VDD VDD VSS VSS gf180mcu_fd_sc_mcu7t5v0__fill_1
XFILLER_19_120 VDD VDD VSS VSS gf180mcu_fd_sc_mcu7t5v0__fill_2
XFILLER_31_67 VDD VDD VSS VSS gf180mcu_fd_sc_mcu7t5v0__fill_1
Xoutput12 _220_/Q phase_state[1] VDD VDD VSS VSS gf180mcu_fd_sc_mcu7t5v0__buf_2
XFILLER_31_148 VDD VDD VSS VSS gf180mcu_fd_sc_mcu7t5v0__fill_1
XFILLER_16_101 VDD VDD VSS VSS gf180mcu_fd_sc_mcu7t5v0__fillcap_4
XFILLER_26_34 VDD VDD VSS VSS gf180mcu_fd_sc_mcu7t5v0__fill_1
XFILLER_22_104 VDD VDD VSS VSS gf180mcu_fd_sc_mcu7t5v0__fill_1
XFILLER_13_104 VDD VDD VSS VSS gf180mcu_fd_sc_mcu7t5v0__fillcap_8
XTAP_TAPCELL_ROW_14_110 VDD VSS gf180mcu_fd_sc_mcu7t5v0__filltie
XFILLER_10_107 VDD VDD VSS VSS gf180mcu_fd_sc_mcu7t5v0__fillcap_4
XTAP_TAPCELL_ROW_11_102 VDD VSS gf180mcu_fd_sc_mcu7t5v0__filltie
X_256_ _256_/D _256_/RN _256_/CLK _256_/Q VDD VDD VSS VSS gf180mcu_fd_sc_mcu7t5v0__dffrnq_1
X_187_ _187_/A1 _187_/A2 _187_/B _190_/A2 VDD VDD VSS VSS gf180mcu_fd_sc_mcu7t5v0__oai21_1
Xload_slew23 wire22/I _197_/A2 VDD VDD VSS VSS gf180mcu_fd_sc_mcu7t5v0__buf_2
Xload_slew34 wire35/Z _220_/RN VDD VDD VSS VSS gf180mcu_fd_sc_mcu7t5v0__clkbuf_2
XFILLER_1_2 VDD VDD VSS VSS gf180mcu_fd_sc_mcu7t5v0__fillcap_64
X_110_ _229_/Q _161_/A2 VDD VDD VSS VSS gf180mcu_fd_sc_mcu7t5v0__clkinv_1
Xclkload0 _238_/CLK clkload0/Z VDD VDD VSS VSS gf180mcu_fd_sc_mcu7t5v0__clkbuf_2
X_239_ _239_/D _242_/RN _242_/CLK _239_/Q VDD VDD VSS VSS gf180mcu_fd_sc_mcu7t5v0__dffrnq_1
XFILLER_29_34 VDD VDD VSS VSS gf180mcu_fd_sc_mcu7t5v0__fillcap_16
XFILLER_19_198 VDD VDD VSS VSS gf180mcu_fd_sc_mcu7t5v0__fillcap_4
XFILLER_19_187 VDD VDD VSS VSS gf180mcu_fd_sc_mcu7t5v0__fill_2
Xoutput13 _221_/Q votes_in_phase[0] VDD VDD VSS VSS gf180mcu_fd_sc_mcu7t5v0__buf_2
XFILLER_31_138 VDD VDD VSS VSS gf180mcu_fd_sc_mcu7t5v0__fillcap_8
XPHY_EDGE_ROW_28_Right_28 VDD VSS gf180mcu_fd_sc_mcu7t5v0__endcap
XPHY_EDGE_ROW_19_Right_19 VDD VSS gf180mcu_fd_sc_mcu7t5v0__endcap
Xclkbuf_3_1__f_clk clkbuf_0_clk/Z _238_/CLK VDD VDD VSS VSS gf180mcu_fd_sc_mcu7t5v0__clkbuf_16
XFILLER_16_124 VDD VDD VSS VSS gf180mcu_fd_sc_mcu7t5v0__fill_1
XFILLER_8_142 VDD VDD VSS VSS gf180mcu_fd_sc_mcu7t5v0__fillcap_8
XTAP_TAPCELL_ROW_14_111 VDD VSS gf180mcu_fd_sc_mcu7t5v0__filltie
XFILLER_12_37 VDD VDD VSS VSS gf180mcu_fd_sc_mcu7t5v0__fillcap_64
X_255_ _255_/D _255_/RN _256_/CLK _255_/Q VDD VDD VSS VSS gf180mcu_fd_sc_mcu7t5v0__dffrnq_1
XPHY_EDGE_ROW_24_Left_56 VDD VSS gf180mcu_fd_sc_mcu7t5v0__endcap
X_186_ _197_/A2 _185_/I _189_/A2 VDD VDD VSS VSS gf180mcu_fd_sc_mcu7t5v0__nand2_1
XFILLER_14_211 VDD VDD VSS VSS gf180mcu_fd_sc_mcu7t5v0__fillcap_8
Xclkload1 _221_/CLK clkload1/Z VDD VDD VSS VSS gf180mcu_fd_sc_mcu7t5v0__clkbuf_2
XFILLER_27_2 VDD VDD VSS VSS gf180mcu_fd_sc_mcu7t5v0__fillcap_64
Xload_slew46 _251_/RN _252_/RN VDD VDD VSS VSS gf180mcu_fd_sc_mcu7t5v0__clkbuf_2
X_238_ _238_/D _248_/RN _238_/CLK _238_/Q VDD VDD VSS VSS gf180mcu_fd_sc_mcu7t5v0__dffrnq_1
XFILLER_1_72 VDD VDD VSS VSS gf180mcu_fd_sc_mcu7t5v0__fillcap_64
X_169_ _234_/Q _169_/A2 _169_/Z VDD VDD VSS VSS gf180mcu_fd_sc_mcu7t5v0__xor2_1
XFILLER_28_177 VDD VDD VSS VSS gf180mcu_fd_sc_mcu7t5v0__fillcap_4
XFILLER_20_37 VDD VDD VSS VSS gf180mcu_fd_sc_mcu7t5v0__fillcap_64
XFILLER_19_122 VDD VDD VSS VSS gf180mcu_fd_sc_mcu7t5v0__fill_1
XFILLER_31_47 VDD VDD VSS VSS gf180mcu_fd_sc_mcu7t5v0__fillcap_16
XFILLER_31_36 VDD VDD VSS VSS gf180mcu_fd_sc_mcu7t5v0__fillcap_4
XFILLER_25_136 VDD VDD VSS VSS gf180mcu_fd_sc_mcu7t5v0__fillcap_4
XPHY_EDGE_ROW_11_Left_43 VDD VSS gf180mcu_fd_sc_mcu7t5v0__endcap
Xoutput14 _222_/Q votes_in_phase[1] VDD VDD VSS VSS gf180mcu_fd_sc_mcu7t5v0__buf_2
XFILLER_22_139 VDD VDD VSS VSS gf180mcu_fd_sc_mcu7t5v0__fill_2
XTAP_TAPCELL_ROW_17_120 VDD VSS gf180mcu_fd_sc_mcu7t5v0__filltie
XFILLER_26_69 VDD VDD VSS VSS gf180mcu_fd_sc_mcu7t5v0__fillcap_8
XFILLER_13_139 VDD VDD VSS VSS gf180mcu_fd_sc_mcu7t5v0__fill_1
XFILLER_8_154 VDD VDD VSS VSS gf180mcu_fd_sc_mcu7t5v0__fill_1
XFILLER_17_220 VDD VDD VSS VSS gf180mcu_fd_sc_mcu7t5v0__fillcap_4
X_254_ _254_/D _254_/RN _256_/CLK _254_/Q VDD VDD VSS VSS gf180mcu_fd_sc_mcu7t5v0__dffrnq_1
X_185_ _185_/I _187_/A2 VDD VDD VSS VSS gf180mcu_fd_sc_mcu7t5v0__clkinv_1
XFILLER_14_223 VDD VDD VSS VSS gf180mcu_fd_sc_mcu7t5v0__fill_2
XFILLER_18_37 VDD VDD VSS VSS gf180mcu_fd_sc_mcu7t5v0__fillcap_64
Xclkload2 _234_/CLK clkload2/Z VDD VDD VSS VSS gf180mcu_fd_sc_mcu7t5v0__clkbuf_2
Xload_slew47 _254_/RN _251_/RN VDD VDD VSS VSS gf180mcu_fd_sc_mcu7t5v0__clkbuf_2
X_237_ _237_/D _248_/RN _248_/CLK _237_/Q VDD VDD VSS VSS gf180mcu_fd_sc_mcu7t5v0__dffrnq_1
X_168_ _178_/A1 _209_/A2 _233_/D VDD VDD VSS VSS gf180mcu_fd_sc_mcu7t5v0__nor2_1
Xload_slew25 _198_/A1 _215_/A1 VDD VDD VSS VSS gf180mcu_fd_sc_mcu7t5v0__buf_2
Xload_slew36 _232_/RN wire35/I VDD VDD VSS VSS gf180mcu_fd_sc_mcu7t5v0__buf_2
XFILLER_29_58 VDD VDD VSS VSS gf180mcu_fd_sc_mcu7t5v0__fillcap_4
XFILLER_28_123 VDD VDD VSS VSS gf180mcu_fd_sc_mcu7t5v0__fillcap_4
XFILLER_28_101 VDD VDD VSS VSS gf180mcu_fd_sc_mcu7t5v0__fillcap_4
XFILLER_19_189 VDD VDD VSS VSS gf180mcu_fd_sc_mcu7t5v0__fill_1
XFILLER_25_115 VDD VDD VSS VSS gf180mcu_fd_sc_mcu7t5v0__fillcap_4
XPHY_EDGE_ROW_1_Right_1 VDD VSS gf180mcu_fd_sc_mcu7t5v0__endcap
Xoutput15 _223_/Q votes_in_phase[2] VDD VDD VSS VSS gf180mcu_fd_sc_mcu7t5v0__buf_2
XFILLER_16_115 VDD VDD VSS VSS gf180mcu_fd_sc_mcu7t5v0__fill_2
XFILLER_30_173 VDD VDD VSS VSS gf180mcu_fd_sc_mcu7t5v0__fill_2
XFILLER_22_107 VDD VDD VSS VSS gf180mcu_fd_sc_mcu7t5v0__fillcap_32
XFILLER_7_72 VDD VDD VSS VSS gf180mcu_fd_sc_mcu7t5v0__fillcap_16
XFILLER_26_37 VDD VDD VSS VSS gf180mcu_fd_sc_mcu7t5v0__fillcap_32
XTAP_TAPCELL_ROW_20_127 VDD VSS gf180mcu_fd_sc_mcu7t5v0__filltie
XFILLER_5_125 VDD VDD VSS VSS gf180mcu_fd_sc_mcu7t5v0__fillcap_4
XFILLER_2_139 VDD VDD VSS VSS gf180mcu_fd_sc_mcu7t5v0__fill_2
Xclkbuf_3_7__f_clk clkbuf_0_clk/Z _248_/CLK VDD VDD VSS VSS gf180mcu_fd_sc_mcu7t5v0__clkbuf_16
X_253_ _253_/D _254_/RN _256_/CLK _253_/Q VDD VDD VSS VSS gf180mcu_fd_sc_mcu7t5v0__dffrnq_1
X_184_ _239_/Q _240_/Q _241_/Q _185_/I VDD VDD VSS VSS gf180mcu_fd_sc_mcu7t5v0__nand3_1
XTAP_TAPCELL_ROW_9_94 VDD VSS gf180mcu_fd_sc_mcu7t5v0__filltie
Xclkload3 _252_/CLK clkload3/Z VDD VDD VSS VSS gf180mcu_fd_sc_mcu7t5v0__clkbuf_2
XFILLER_11_216 VDD VDD VSS VSS gf180mcu_fd_sc_mcu7t5v0__fill_1
Xload_slew48 _255_/RN _254_/RN VDD VDD VSS VSS gf180mcu_fd_sc_mcu7t5v0__clkbuf_1
X_236_ _236_/D _252_/RN _252_/CLK _236_/Q VDD VDD VSS VSS gf180mcu_fd_sc_mcu7t5v0__dffrnq_1
Xload_slew26 _187_/A1 _178_/A1 VDD VDD VSS VSS gf180mcu_fd_sc_mcu7t5v0__buf_2
X_167_ _233_/Q _167_/A2 _209_/A2 VDD VDD VSS VSS gf180mcu_fd_sc_mcu7t5v0__xnor2_1
XFILLER_3_212 VDD VDD VSS VSS gf180mcu_fd_sc_mcu7t5v0__fillcap_4
XFILLER_19_135 VDD VDD VSS VSS gf180mcu_fd_sc_mcu7t5v0__fillcap_4
X_219_ _219_/D wire35/Z _221_/CLK _219_/Q VDD VDD VSS VSS gf180mcu_fd_sc_mcu7t5v0__dffrnq_1
Xoutput16 _224_/Q votes_in_phase[3] VDD VDD VSS VSS gf180mcu_fd_sc_mcu7t5v0__buf_2
Xclkbuf_0_clk clk clkbuf_0_clk/Z VDD VDD VSS VSS gf180mcu_fd_sc_mcu7t5v0__clkbuf_16
XPHY_EDGE_ROW_24_Right_24 VDD VSS gf180mcu_fd_sc_mcu7t5v0__endcap
XTAP_TAPCELL_ROW_23_136 VDD VSS gf180mcu_fd_sc_mcu7t5v0__filltie
XFILLER_21_174 VDD VDD VSS VSS gf180mcu_fd_sc_mcu7t5v0__fillcap_16
XPHY_EDGE_ROW_15_Right_15 VDD VSS gf180mcu_fd_sc_mcu7t5v0__endcap
XTAP_TAPCELL_ROW_20_128 VDD VSS gf180mcu_fd_sc_mcu7t5v0__filltie
XFILLER_26_222 VDD VDD VSS VSS gf180mcu_fd_sc_mcu7t5v0__fill_2
XFILLER_2_107 VDD VDD VSS VSS gf180mcu_fd_sc_mcu7t5v0__fillcap_32
X_252_ _252_/D _252_/RN _252_/CLK _252_/Q VDD VDD VSS VSS gf180mcu_fd_sc_mcu7t5v0__dffrnq_1
XFILLER_1_162 VDD VDD VSS VSS gf180mcu_fd_sc_mcu7t5v0__fill_2
XTAP_TAPCELL_ROW_0_64 VDD VSS gf180mcu_fd_sc_mcu7t5v0__filltie
X_183_ _183_/A1 _187_/B _191_/A2 _182_/Z _240_/D VDD VDD VSS VSS gf180mcu_fd_sc_mcu7t5v0__oai22_1
XTAP_TAPCELL_ROW_9_95 VDD VSS gf180mcu_fd_sc_mcu7t5v0__filltie
XFILLER_13_72 VDD VDD VSS VSS gf180mcu_fd_sc_mcu7t5v0__fillcap_32
Xclkload4 _256_/CLK clkload4/Z VDD VDD VSS VSS gf180mcu_fd_sc_mcu7t5v0__clkbuf_2
X_235_ _235_/D _252_/RN _238_/CLK _235_/Q VDD VDD VSS VSS gf180mcu_fd_sc_mcu7t5v0__dffrnq_1
Xload_slew38 _241_/RN _242_/RN VDD VDD VSS VSS gf180mcu_fd_sc_mcu7t5v0__clkbuf_2
X_166_ _233_/Q _167_/A2 _192_/B VDD VDD VSS VSS gf180mcu_fd_sc_mcu7t5v0__xor2_1
X_218_ _218_/D wire35/Z _221_/CLK _218_/Q VDD VDD VSS VSS gf180mcu_fd_sc_mcu7t5v0__dffrnq_1
XTAP_TAPCELL_ROW_6_85 VDD VSS gf180mcu_fd_sc_mcu7t5v0__filltie
X_149_ _252_/Q wire32/Z _248_/Q _151_/B VDD VDD VSS VSS gf180mcu_fd_sc_mcu7t5v0__nand3_1
XFILLER_25_128 VDD VDD VSS VSS gf180mcu_fd_sc_mcu7t5v0__fillcap_8
XFILLER_25_2 VDD VDD VSS VSS gf180mcu_fd_sc_mcu7t5v0__fillcap_64
Xoutput17 _225_/Q votes_out_phase[0] VDD VDD VSS VSS gf180mcu_fd_sc_mcu7t5v0__buf_2
XTAP_TAPCELL_ROW_26_145 VDD VSS gf180mcu_fd_sc_mcu7t5v0__filltie
XFILLER_21_72 VDD VDD VSS VSS gf180mcu_fd_sc_mcu7t5v0__fillcap_16
XFILLER_16_117 VDD VDD VSS VSS gf180mcu_fd_sc_mcu7t5v0__fill_1
XFILLER_30_153 VDD VDD VSS VSS gf180mcu_fd_sc_mcu7t5v0__fillcap_4
XPHY_EDGE_ROW_15_Left_47 VDD VSS gf180mcu_fd_sc_mcu7t5v0__endcap
XFILLER_29_220 VDD VDD VSS VSS gf180mcu_fd_sc_mcu7t5v0__fillcap_4
XTAP_TAPCELL_ROW_23_137 VDD VSS gf180mcu_fd_sc_mcu7t5v0__filltie
XFILLER_21_142 VDD VDD VSS VSS gf180mcu_fd_sc_mcu7t5v0__fill_1
XTAP_TAPCELL_ROW_20_129 VDD VSS gf180mcu_fd_sc_mcu7t5v0__filltie
XFILLER_17_212 VDD VDD VSS VSS gf180mcu_fd_sc_mcu7t5v0__fillcap_8
XPHY_EDGE_ROW_18_Left_50 VDD VSS gf180mcu_fd_sc_mcu7t5v0__endcap
Xfanout41 wire51/Z _256_/RN VDD VDD VSS VSS gf180mcu_fd_sc_mcu7t5v0__dlyb_1
X_251_ _251_/D _251_/RN _252_/CLK _251_/Q VDD VDD VSS VSS gf180mcu_fd_sc_mcu7t5v0__dffrnq_1
XTAP_TAPCELL_ROW_0_65 VDD VSS gf180mcu_fd_sc_mcu7t5v0__filltie
X_182_ _239_/Q _183_/A1 _182_/Z VDD VDD VSS VSS gf180mcu_fd_sc_mcu7t5v0__xor2_1
XTAP_TAPCELL_ROW_9_96 VDD VSS gf180mcu_fd_sc_mcu7t5v0__filltie
Xload_slew28 _124_/A1 _123_/A1 VDD VDD VSS VSS gf180mcu_fd_sc_mcu7t5v0__buf_2
Xclkload5 _246_/CLK clkload5/Z VDD VDD VSS VSS gf180mcu_fd_sc_mcu7t5v0__clkbuf_2
XPHY_EDGE_ROW_3_Left_35 VDD VSS gf180mcu_fd_sc_mcu7t5v0__endcap
Xload_slew39 _229_/RN _234_/RN VDD VDD VSS VSS gf180mcu_fd_sc_mcu7t5v0__clkbuf_2
X_165_ _233_/Q _167_/A2 _169_/A2 VDD VDD VSS VSS gf180mcu_fd_sc_mcu7t5v0__nand2_1
X_234_ _234_/D _234_/RN _234_/CLK _234_/Q VDD VDD VSS VSS gf180mcu_fd_sc_mcu7t5v0__dffrnq_1
XTAP_TAPCELL_ROW_29_154 VDD VSS gf180mcu_fd_sc_mcu7t5v0__filltie
X_148_ _215_/A1 _146_/Z _148_/B _228_/D VDD VDD VSS VSS gf180mcu_fd_sc_mcu7t5v0__oai21_1
XFILLER_19_72 VDD VDD VSS VSS gf180mcu_fd_sc_mcu7t5v0__fillcap_32
XFILLER_19_104 VDD VDD VSS VSS gf180mcu_fd_sc_mcu7t5v0__fillcap_16
XFILLER_3_203 VDD VDD VSS VSS gf180mcu_fd_sc_mcu7t5v0__fillcap_4
X_217_ _217_/D _220_/RN _221_/CLK _217_/Q VDD VDD VSS VSS gf180mcu_fd_sc_mcu7t5v0__dffrnq_1
XTAP_TAPCELL_ROW_6_86 VDD VSS gf180mcu_fd_sc_mcu7t5v0__filltie
Xoutput18 _226_/Q votes_out_phase[1] VDD VDD VSS VSS gf180mcu_fd_sc_mcu7t5v0__buf_2
XFILLER_18_2 VDD VDD VSS VSS gf180mcu_fd_sc_mcu7t5v0__fillcap_32
XFILLER_0_206 VDD VDD VSS VSS gf180mcu_fd_sc_mcu7t5v0__fill_2
XTAP_TAPCELL_ROW_26_146 VDD VSS gf180mcu_fd_sc_mcu7t5v0__filltie
XFILLER_24_140 VDD VDD VSS VSS gf180mcu_fd_sc_mcu7t5v0__fill_1
XFILLER_16_107 VDD VDD VSS VSS gf180mcu_fd_sc_mcu7t5v0__fillcap_8
XTAP_TAPCELL_ROW_31_160 VDD VSS gf180mcu_fd_sc_mcu7t5v0__filltie
XTAP_TAPCELL_ROW_23_138 VDD VSS gf180mcu_fd_sc_mcu7t5v0__filltie
XFILLER_21_198 VDD VDD VSS VSS gf180mcu_fd_sc_mcu7t5v0__fillcap_4
XFILLER_21_132 VDD VDD VSS VSS gf180mcu_fd_sc_mcu7t5v0__fillcap_8
XPHY_EDGE_ROW_5_Right_5 VDD VSS gf180mcu_fd_sc_mcu7t5v0__endcap
XTAP_TAPCELL_ROW_3_76 VDD VSS gf180mcu_fd_sc_mcu7t5v0__filltie
XFILLER_26_224 VDD VDD VSS VSS gf180mcu_fd_sc_mcu7t5v0__fill_1
XFILLER_17_224 VDD VDD VSS VSS gf180mcu_fd_sc_mcu7t5v0__fill_1
XFILLER_17_202 VDD VDD VSS VSS gf180mcu_fd_sc_mcu7t5v0__fill_2
X_250_ _250_/D _251_/RN _252_/CLK _250_/Q VDD VDD VSS VSS gf180mcu_fd_sc_mcu7t5v0__dffrnq_1
XFILLER_1_142 VDD VDD VSS VSS gf180mcu_fd_sc_mcu7t5v0__fillcap_16
X_181_ _239_/Q _191_/A2 _181_/B _239_/D VDD VDD VSS VSS gf180mcu_fd_sc_mcu7t5v0__oai21_1
XTAP_TAPCELL_ROW_0_66 VDD VSS gf180mcu_fd_sc_mcu7t5v0__filltie
XFILLER_9_220 VDD VDD VSS VSS gf180mcu_fd_sc_mcu7t5v0__fillcap_4
Xclkload6 _248_/CLK clkload6/Z VDD VDD VSS VSS gf180mcu_fd_sc_mcu7t5v0__clkbuf_2
XFILLER_1_66 VDD VDD VSS VSS gf180mcu_fd_sc_mcu7t5v0__fillcap_4
X_164_ _178_/A1 _163_/Z _232_/D VDD VDD VSS VSS gf180mcu_fd_sc_mcu7t5v0__nor2_1
X_233_ _233_/D _234_/RN _238_/CLK _233_/Q VDD VDD VSS VSS gf180mcu_fd_sc_mcu7t5v0__dffrnq_1
XFILLER_28_127 VDD VDD VSS VSS gf180mcu_fd_sc_mcu7t5v0__fill_2
XTAP_TAPCELL_ROW_10_97 VDD VSS gf180mcu_fd_sc_mcu7t5v0__filltie
XTAP_TAPCELL_ROW_29_155 VDD VSS gf180mcu_fd_sc_mcu7t5v0__filltie
XTAP_TAPCELL_ROW_6_87 VDD VSS gf180mcu_fd_sc_mcu7t5v0__filltie
X_147_ _228_/Q wire22/Z _148_/B VDD VDD VSS VSS gf180mcu_fd_sc_mcu7t5v0__nand2_1
XFILLER_25_119 VDD VDD VSS VSS gf180mcu_fd_sc_mcu7t5v0__fill_1
XFILLER_18_182 VDD VDD VSS VSS gf180mcu_fd_sc_mcu7t5v0__fillcap_32
X_216_ _216_/D _220_/RN _221_/CLK _216_/Q VDD VDD VSS VSS gf180mcu_fd_sc_mcu7t5v0__dffrnq_1
Xoutput19 _227_/Q votes_out_phase[2] VDD VDD VSS VSS gf180mcu_fd_sc_mcu7t5v0__buf_2
XTAP_TAPCELL_ROW_26_147 VDD VSS gf180mcu_fd_sc_mcu7t5v0__filltie
XFILLER_21_96 VDD VDD VSS VSS gf180mcu_fd_sc_mcu7t5v0__fill_2
XFILLER_30_2 VDD VDD VSS VSS gf180mcu_fd_sc_mcu7t5v0__fillcap_32
XTAP_TAPCELL_ROW_31_161 VDD VSS gf180mcu_fd_sc_mcu7t5v0__filltie
XFILLER_21_155 VDD VDD VSS VSS gf180mcu_fd_sc_mcu7t5v0__fill_1
XPHY_EDGE_ROW_20_Right_20 VDD VSS gf180mcu_fd_sc_mcu7t5v0__endcap
XTAP_TAPCELL_ROW_3_77 VDD VSS gf180mcu_fd_sc_mcu7t5v0__filltie
XFILLER_12_111 VDD VDD VSS VSS gf180mcu_fd_sc_mcu7t5v0__fill_2
XFILLER_12_177 VDD VDD VSS VSS gf180mcu_fd_sc_mcu7t5v0__fill_1
XPHY_EDGE_ROW_11_Right_11 VDD VSS gf180mcu_fd_sc_mcu7t5v0__endcap
XFILLER_5_129 VDD VDD VSS VSS gf180mcu_fd_sc_mcu7t5v0__fill_1
Xclkbuf_3_2__f_clk clkbuf_0_clk/Z _221_/CLK VDD VDD VSS VSS gf180mcu_fd_sc_mcu7t5v0__clkbuf_16
Xfanout21 wire24/I wire22/I VDD VDD VSS VSS gf180mcu_fd_sc_mcu7t5v0__dlyb_1
X_180_ _129_/Z _197_/A2 _191_/A2 VDD VDD VSS VSS gf180mcu_fd_sc_mcu7t5v0__nand2_1
XTAP_TAPCELL_ROW_0_67 VDD VSS gf180mcu_fd_sc_mcu7t5v0__filltie
XFILLER_8_2 VDD VDD VSS VSS gf180mcu_fd_sc_mcu7t5v0__fillcap_32
X_232_ _232_/D _232_/RN _242_/CLK _232_/Q VDD VDD VSS VSS gf180mcu_fd_sc_mcu7t5v0__dffrnq_1
X_163_ _232_/Q _163_/A2 _163_/Z VDD VDD VSS VSS gf180mcu_fd_sc_mcu7t5v0__xor2_1
XTAP_TAPCELL_ROW_29_156 VDD VSS gf180mcu_fd_sc_mcu7t5v0__filltie
XFILLER_19_139 VDD VDD VSS VSS gf180mcu_fd_sc_mcu7t5v0__fill_1
XFILLER_3_216 VDD VDD VSS VSS gf180mcu_fd_sc_mcu7t5v0__fill_1
XTAP_TAPCELL_ROW_10_98 VDD VSS gf180mcu_fd_sc_mcu7t5v0__filltie
X_146_ _238_/Q _146_/A2 _146_/Z VDD VDD VSS VSS gf180mcu_fd_sc_mcu7t5v0__xor2_1
X_215_ _215_/A1 _175_/Z _215_/B _226_/D VDD VDD VSS VSS gf180mcu_fd_sc_mcu7t5v0__oai21_1
XFILLER_0_208 VDD VDD VSS VSS gf180mcu_fd_sc_mcu7t5v0__fill_1
XFILLER_7_66 VDD VDD VSS VSS gf180mcu_fd_sc_mcu7t5v0__fillcap_4
XFILLER_7_88 VDD VDD VSS VSS gf180mcu_fd_sc_mcu7t5v0__fill_2
XTAP_TAPCELL_ROW_31_162 VDD VSS gf180mcu_fd_sc_mcu7t5v0__filltie
XFILLER_23_2 VDD VDD VSS VSS gf180mcu_fd_sc_mcu7t5v0__fillcap_64
X_129_ _230_/Q _256_/Q _129_/Z VDD VDD VSS VSS gf180mcu_fd_sc_mcu7t5v0__and2_1
XTAP_TAPCELL_ROW_3_78 VDD VSS gf180mcu_fd_sc_mcu7t5v0__filltie
XFILLER_12_101 VDD VDD VSS VSS gf180mcu_fd_sc_mcu7t5v0__fillcap_4
XFILLER_4_34 VDD VDD VSS VSS gf180mcu_fd_sc_mcu7t5v0__fill_1
Xfanout33 _234_/RN _232_/RN VDD VDD VSS VSS gf180mcu_fd_sc_mcu7t5v0__dlyb_1
XTAP_TAPCELL_ROW_0_68 VDD VSS gf180mcu_fd_sc_mcu7t5v0__filltie
X_231_ _231_/D _232_/RN _234_/CLK _231_/Q VDD VDD VSS VSS gf180mcu_fd_sc_mcu7t5v0__dffrnq_1
X_162_ _232_/Q _163_/A2 _192_/A2 VDD VDD VSS VSS gf180mcu_fd_sc_mcu7t5v0__xnor2_1
Xinput1 comp_raw input1/Z VDD VDD VSS VSS gf180mcu_fd_sc_mcu7t5v0__buf_1
XFILLER_28_129 VDD VDD VSS VSS gf180mcu_fd_sc_mcu7t5v0__fill_1
XPHY_EDGE_ROW_7_Left_39 VDD VSS gf180mcu_fd_sc_mcu7t5v0__endcap
XTAP_TAPCELL_ROW_10_99 VDD VSS gf180mcu_fd_sc_mcu7t5v0__filltie
X_145_ _215_/A1 _177_/A1 _145_/B _227_/D VDD VDD VSS VSS gf180mcu_fd_sc_mcu7t5v0__oai21_1
X_214_ _226_/Q wire24/Z _215_/B VDD VDD VSS VSS gf180mcu_fd_sc_mcu7t5v0__nand2_1
XFILLER_18_162 VDD VDD VSS VSS gf180mcu_fd_sc_mcu7t5v0__fill_1
XFILLER_24_187 VDD VDD VSS VSS gf180mcu_fd_sc_mcu7t5v0__fill_1
XFILLER_15_165 VDD VDD VSS VSS gf180mcu_fd_sc_mcu7t5v0__fill_2
X_128_ input5/Z _256_/Q _244_/D VDD VDD VSS VSS gf180mcu_fd_sc_mcu7t5v0__and2_1
XTAP_TAPCELL_ROW_31_163 VDD VSS gf180mcu_fd_sc_mcu7t5v0__filltie
XFILLER_16_2 VDD VDD VSS VSS gf180mcu_fd_sc_mcu7t5v0__fillcap_32
XFILLER_29_224 VDD VDD VSS VSS gf180mcu_fd_sc_mcu7t5v0__fill_1
XFILLER_12_113 VDD VDD VSS VSS gf180mcu_fd_sc_mcu7t5v0__fill_1
XFILLER_7_150 VDD VDD VSS VSS gf180mcu_fd_sc_mcu7t5v0__fillcap_4
XPHY_EDGE_ROW_9_Right_9 VDD VSS gf180mcu_fd_sc_mcu7t5v0__endcap
XFILLER_4_164 VDD VDD VSS VSS gf180mcu_fd_sc_mcu7t5v0__fill_2
Xfanout45 wire51/Z _255_/RN VDD VDD VSS VSS gf180mcu_fd_sc_mcu7t5v0__dlyb_1
XTAP_TAPCELL_ROW_0_69 VDD VSS gf180mcu_fd_sc_mcu7t5v0__filltie
XFILLER_13_66 VDD VDD VSS VSS gf180mcu_fd_sc_mcu7t5v0__fillcap_4
XFILLER_14_219 VDD VDD VSS VSS gf180mcu_fd_sc_mcu7t5v0__fillcap_4
XFILLER_9_212 VDD VDD VSS VSS gf180mcu_fd_sc_mcu7t5v0__fillcap_8
X_161_ _248_/Q _161_/A2 _203_/A1 _161_/A4 _167_/A2 VDD VDD VSS VSS gf180mcu_fd_sc_mcu7t5v0__nor4_4
X_230_ _230_/D _241_/RN _238_/CLK _230_/Q VDD VDD VSS VSS gf180mcu_fd_sc_mcu7t5v0__dffrnq_1
XPHY_EDGE_ROW_23_Left_55 VDD VSS gf180mcu_fd_sc_mcu7t5v0__endcap
Xinput2 latch_phase270 input2/Z VDD VDD VSS VSS gf180mcu_fd_sc_mcu7t5v0__buf_1
XFILLER_3_207 VDD VDD VSS VSS gf180mcu_fd_sc_mcu7t5v0__fill_2
XFILLER_10_34 VDD VDD VSS VSS gf180mcu_fd_sc_mcu7t5v0__fill_1
X_144_ _227_/Q wire22/Z _145_/B VDD VDD VSS VSS gf180mcu_fd_sc_mcu7t5v0__nand2_1
X_213_ _215_/A1 _213_/A2 _213_/B _225_/D VDD VDD VSS VSS gf180mcu_fd_sc_mcu7t5v0__oai21_1
XFILLER_24_177 VDD VDD VSS VSS gf180mcu_fd_sc_mcu7t5v0__fill_2
XFILLER_21_88 VDD VDD VSS VSS gf180mcu_fd_sc_mcu7t5v0__fillcap_8
XFILLER_21_66 VDD VDD VSS VSS gf180mcu_fd_sc_mcu7t5v0__fillcap_4
X_127_ input5/Z _247_/Q _248_/D VDD VDD VSS VSS gf180mcu_fd_sc_mcu7t5v0__and2_1
XTAP_TAPCELL_ROW_31_164 VDD VSS gf180mcu_fd_sc_mcu7t5v0__filltie
XPHY_EDGE_ROW_10_Left_42 VDD VSS gf180mcu_fd_sc_mcu7t5v0__endcap
XTAP_TAPCELL_ROW_14_109 VDD VSS gf180mcu_fd_sc_mcu7t5v0__filltie
XFILLER_9_224 VDD VDD VSS VSS gf180mcu_fd_sc_mcu7t5v0__fill_1
XFILLER_13_220 VDD VDD VSS VSS gf180mcu_fd_sc_mcu7t5v0__fillcap_4
XFILLER_5_90 VDD VDD VSS VSS gf180mcu_fd_sc_mcu7t5v0__fill_1
XFILLER_6_2 VDD VDD VSS VSS gf180mcu_fd_sc_mcu7t5v0__fillcap_32
X_160_ _231_/Q _232_/Q _161_/A4 VDD VDD VSS VSS gf180mcu_fd_sc_mcu7t5v0__nand2_1
Xinput3 latch_phase90 input3/Z VDD VDD VSS VSS gf180mcu_fd_sc_mcu7t5v0__buf_1
XPHY_EDGE_ROW_27_Right_27 VDD VSS gf180mcu_fd_sc_mcu7t5v0__endcap
XPHY_EDGE_ROW_18_Right_18 VDD VSS gf180mcu_fd_sc_mcu7t5v0__endcap
XFILLER_27_142 VDD VDD VSS VSS gf180mcu_fd_sc_mcu7t5v0__fillcap_8
X_212_ _225_/Q wire22/Z _213_/B VDD VDD VSS VSS gf180mcu_fd_sc_mcu7t5v0__nand2_1
XFILLER_19_66 VDD VDD VSS VSS gf180mcu_fd_sc_mcu7t5v0__fillcap_4
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
