llhtimlam/Probton/librelane/Submodule/Digital_RTL_GDS_spi/68-magic-spiceextraction/spi_regs.spice

* NGSPICE file created from spi_regs.ext - technology: gf180mcuD

* Black-box entry subcircuit for gf180mcu_fd_sc_mcu7t5v0__fillcap_4 abstract view
.subckt gf180mcu_fd_sc_mcu7t5v0__fillcap_4 VDD VNW VPW VSS
.ends

* Black-box entry subcircuit for gf180mcu_fd_sc_mcu7t5v0__fillcap_8 abstract view
.subckt gf180mcu_fd_sc_mcu7t5v0__fillcap_8 VDD VNW VPW VSS
.ends

* Black-box entry subcircuit for gf180mcu_fd_sc_mcu7t5v0__fill_1 abstract view
.subckt gf180mcu_fd_sc_mcu7t5v0__fill_1 VDD VNW VPW VSS
.ends

* Black-box entry subcircuit for gf180mcu_fd_sc_mcu7t5v0__filltie abstract view
.subckt gf180mcu_fd_sc_mcu7t5v0__filltie VDD VSS
.ends

* Black-box entry subcircuit for gf180mcu_fd_sc_mcu7t5v0__dlyb_1 abstract view
.subckt gf180mcu_fd_sc_mcu7t5v0__dlyb_1 I Z VDD VNW VPW VSS
.ends

* Black-box entry subcircuit for gf180mcu_fd_sc_mcu7t5v0__endcap abstract view
.subckt gf180mcu_fd_sc_mcu7t5v0__endcap VDD VSS
.ends

* Black-box entry subcircuit for gf180mcu_fd_sc_mcu7t5v0__nor3_4 abstract view
.subckt gf180mcu_fd_sc_mcu7t5v0__nor3_4 A1 A2 A3 ZN VDD VNW VPW VSS
.ends

* Black-box entry subcircuit for gf180mcu_fd_sc_mcu7t5v0__fillcap_32 abstract view
.subckt gf180mcu_fd_sc_mcu7t5v0__fillcap_32 VDD VNW VPW VSS
.ends

* Black-box entry subcircuit for gf180mcu_fd_sc_mcu7t5v0__nor3_2 abstract view
.subckt gf180mcu_fd_sc_mcu7t5v0__nor3_2 A1 A2 A3 ZN VDD VNW VPW VSS
.ends

* Black-box entry subcircuit for gf180mcu_fd_sc_mcu7t5v0__buf_2 abstract view
.subckt gf180mcu_fd_sc_mcu7t5v0__buf_2 I Z VDD VNW VPW VSS
.ends

* Black-box entry subcircuit for gf180mcu_fd_sc_mcu7t5v0__dffrnq_1 abstract view
.subckt gf180mcu_fd_sc_mcu7t5v0__dffrnq_1 D RN CLK Q VDD VNW VPW VSS
.ends

* Black-box entry subcircuit for gf180mcu_fd_sc_mcu7t5v0__mux2_2 abstract view
.subckt gf180mcu_fd_sc_mcu7t5v0__mux2_2 I0 I1 S Z VDD VNW VPW VSS
.ends

* Black-box entry subcircuit for gf180mcu_fd_sc_mcu7t5v0__fillcap_64 abstract view
.subckt gf180mcu_fd_sc_mcu7t5v0__fillcap_64 VDD VNW VPW VSS
.ends

* Black-box entry subcircuit for gf180mcu_fd_sc_mcu7t5v0__fill_2 abstract view
.subckt gf180mcu_fd_sc_mcu7t5v0__fill_2 VDD VNW VPW VSS
.ends

* Black-box entry subcircuit for gf180mcu_fd_sc_mcu7t5v0__nand2_1 abstract view
.subckt gf180mcu_fd_sc_mcu7t5v0__nand2_1 A1 A2 ZN VDD VNW VPW VSS
.ends

* Black-box entry subcircuit for gf180mcu_fd_sc_mcu7t5v0__nand2_4 abstract view
.subckt gf180mcu_fd_sc_mcu7t5v0__nand2_4 A1 A2 ZN VDD VNW VPW VSS
.ends

* Black-box entry subcircuit for gf180mcu_fd_sc_mcu7t5v0__nand4_4 abstract view
.subckt gf180mcu_fd_sc_mcu7t5v0__nand4_4 A1 A2 A3 A4 ZN VDD VNW VPW VSS
.ends

* Black-box entry subcircuit for gf180mcu_fd_sc_mcu7t5v0__oai211_1 abstract view
.subckt gf180mcu_fd_sc_mcu7t5v0__oai211_1 A1 A2 B C ZN VDD VNW VPW VSS
.ends

* Black-box entry subcircuit for gf180mcu_fd_sc_mcu7t5v0__nand3_4 abstract view
.subckt gf180mcu_fd_sc_mcu7t5v0__nand3_4 A1 A2 A3 ZN VDD VNW VPW VSS
.ends

* Black-box entry subcircuit for gf180mcu_fd_sc_mcu7t5v0__nand4_1 abstract view
.subckt gf180mcu_fd_sc_mcu7t5v0__nand4_1 A1 A2 A3 A4 ZN VDD VNW VPW VSS
.ends

* Black-box entry subcircuit for gf180mcu_fd_sc_mcu7t5v0__buf_1 abstract view
.subckt gf180mcu_fd_sc_mcu7t5v0__buf_1 I Z VDD VNW VPW VSS
.ends

* Black-box entry subcircuit for gf180mcu_fd_sc_mcu7t5v0__clkbuf_2 abstract view
.subckt gf180mcu_fd_sc_mcu7t5v0__clkbuf_2 I Z VDD VNW VPW VSS
.ends

* Black-box entry subcircuit for gf180mcu_fd_sc_mcu7t5v0__aoi222_2 abstract view
.subckt gf180mcu_fd_sc_mcu7t5v0__aoi222_2 A1 A2 B1 B2 C1 C2 ZN VDD VNW VPW VSS
.ends

* Black-box entry subcircuit for gf180mcu_fd_sc_mcu7t5v0__aoi222_4 abstract view
.subckt gf180mcu_fd_sc_mcu7t5v0__aoi222_4 A1 A2 B1 B2 C1 C2 ZN VDD VNW VPW VSS
.ends

* Black-box entry subcircuit for gf180mcu_fd_sc_mcu7t5v0__fillcap_16 abstract view
.subckt gf180mcu_fd_sc_mcu7t5v0__fillcap_16 VDD VNW VPW VSS
.ends

* Black-box entry subcircuit for gf180mcu_fd_sc_mcu7t5v0__aoi221_2 abstract view
.subckt gf180mcu_fd_sc_mcu7t5v0__aoi221_2 A1 A2 B1 B2 C ZN VDD VNW VPW VSS
.ends

* Black-box entry subcircuit for gf180mcu_fd_sc_mcu7t5v0__aoi21_1 abstract view
.subckt gf180mcu_fd_sc_mcu7t5v0__aoi21_1 A1 A2 B ZN VDD VNW VPW VSS
.ends

* Black-box entry subcircuit for gf180mcu_fd_sc_mcu7t5v0__clkinv_1 abstract view
.subckt gf180mcu_fd_sc_mcu7t5v0__clkinv_1 I ZN VDD VNW VPW VSS
.ends

* Black-box entry subcircuit for gf180mcu_fd_sc_mcu7t5v0__clkbuf_1 abstract view
.subckt gf180mcu_fd_sc_mcu7t5v0__clkbuf_1 I Z VDD VNW VPW VSS
.ends

* Black-box entry subcircuit for gf180mcu_fd_sc_mcu7t5v0__aoi22_1 abstract view
.subckt gf180mcu_fd_sc_mcu7t5v0__aoi22_1 A1 A2 B1 B2 ZN VDD VNW VPW VSS
.ends

* Black-box entry subcircuit for gf180mcu_fd_sc_mcu7t5v0__dffrnq_2 abstract view
.subckt gf180mcu_fd_sc_mcu7t5v0__dffrnq_2 D RN CLK Q VDD VNW VPW VSS
.ends

* Black-box entry subcircuit for gf180mcu_fd_sc_mcu7t5v0__oai21_1 abstract view
.subckt gf180mcu_fd_sc_mcu7t5v0__oai21_1 A1 A2 B ZN VDD VNW VPW VSS
.ends

* Black-box entry subcircuit for gf180mcu_fd_sc_mcu7t5v0__and3_4 abstract view
.subckt gf180mcu_fd_sc_mcu7t5v0__and3_4 A1 A2 A3 Z VDD VNW VPW VSS
.ends

* Black-box entry subcircuit for gf180mcu_fd_sc_mcu7t5v0__and2_2 abstract view
.subckt gf180mcu_fd_sc_mcu7t5v0__and2_2 A1 A2 Z VDD VNW VPW VSS
.ends

* Black-box entry subcircuit for gf180mcu_fd_sc_mcu7t5v0__nor2_4 abstract view
.subckt gf180mcu_fd_sc_mcu7t5v0__nor2_4 A1 A2 ZN VDD VNW VPW VSS
.ends

* Black-box entry subcircuit for gf180mcu_fd_sc_mcu7t5v0__nor3_1 abstract view
.subckt gf180mcu_fd_sc_mcu7t5v0__nor3_1 A1 A2 A3 ZN VDD VNW VPW VSS
.ends

* Black-box entry subcircuit for gf180mcu_fd_sc_mcu7t5v0__inv_1 abstract view
.subckt gf180mcu_fd_sc_mcu7t5v0__inv_1 I ZN VDD VNW VPW VSS
.ends

* Black-box entry subcircuit for gf180mcu_fd_sc_mcu7t5v0__nand4_2 abstract view
.subckt gf180mcu_fd_sc_mcu7t5v0__nand4_2 A1 A2 A3 A4 ZN VDD VNW VPW VSS
.ends

* Black-box entry subcircuit for gf180mcu_fd_sc_mcu7t5v0__aoi22_2 abstract view
.subckt gf180mcu_fd_sc_mcu7t5v0__aoi22_2 A1 A2 B1 B2 ZN VDD VNW VPW VSS
.ends

* Black-box entry subcircuit for gf180mcu_fd_sc_mcu7t5v0__oai31_1 abstract view
.subckt gf180mcu_fd_sc_mcu7t5v0__oai31_1 A1 A2 A3 B ZN VDD VNW VPW VSS
.ends

* Black-box entry subcircuit for gf180mcu_fd_sc_mcu7t5v0__nor2_2 abstract view
.subckt gf180mcu_fd_sc_mcu7t5v0__nor2_2 A1 A2 ZN VDD VNW VPW VSS
.ends

* Black-box entry subcircuit for gf180mcu_fd_sc_mcu7t5v0__oai221_1 abstract view
.subckt gf180mcu_fd_sc_mcu7t5v0__oai221_1 A1 A2 B1 B2 C ZN VDD VNW VPW VSS
.ends

* Black-box entry subcircuit for gf180mcu_fd_sc_mcu7t5v0__buf_4 abstract view
.subckt gf180mcu_fd_sc_mcu7t5v0__buf_4 I Z VDD VNW VPW VSS
.ends

* Black-box entry subcircuit for gf180mcu_fd_sc_mcu7t5v0__nor2_1 abstract view
.subckt gf180mcu_fd_sc_mcu7t5v0__nor2_1 A1 A2 ZN VDD VNW VPW VSS
.ends

* Black-box entry subcircuit for gf180mcu_fd_sc_mcu7t5v0__aoi22_4 abstract view
.subckt gf180mcu_fd_sc_mcu7t5v0__aoi22_4 A1 A2 B1 B2 ZN VDD VNW VPW VSS
.ends

* Black-box entry subcircuit for gf180mcu_fd_sc_mcu7t5v0__nor4_2 abstract view
.subckt gf180mcu_fd_sc_mcu7t5v0__nor4_2 A1 A2 A3 A4 ZN VDD VNW VPW VSS
.ends

* Black-box entry subcircuit for gf180mcu_fd_sc_mcu7t5v0__clkbuf_4 abstract view
.subckt gf180mcu_fd_sc_mcu7t5v0__clkbuf_4 I Z VDD VNW VPW VSS
.ends

* Black-box entry subcircuit for gf180mcu_fd_sc_mcu7t5v0__and4_1 abstract view
.subckt gf180mcu_fd_sc_mcu7t5v0__and4_1 A1 A2 A3 A4 Z VDD VNW VPW VSS
.ends

* Black-box entry subcircuit for gf180mcu_fd_sc_mcu7t5v0__or4_1 abstract view
.subckt gf180mcu_fd_sc_mcu7t5v0__or4_1 A1 A2 A3 A4 Z VDD VNW VPW VSS
.ends

* Black-box entry subcircuit for gf180mcu_fd_sc_mcu7t5v0__clkbuf_8 abstract view
.subckt gf180mcu_fd_sc_mcu7t5v0__clkbuf_8 I Z VDD VNW VPW VSS
.ends

* Black-box entry subcircuit for gf180mcu_fd_sc_mcu7t5v0__aoi221_1 abstract view
.subckt gf180mcu_fd_sc_mcu7t5v0__aoi221_1 A1 A2 B1 B2 C ZN VDD VNW VPW VSS
.ends

* Black-box entry subcircuit for gf180mcu_fd_sc_mcu7t5v0__clkinv_2 abstract view
.subckt gf180mcu_fd_sc_mcu7t5v0__clkinv_2 I ZN VDD VNW VPW VSS
.ends

* Black-box entry subcircuit for gf180mcu_fd_sc_mcu7t5v0__nand3_1 abstract view
.subckt gf180mcu_fd_sc_mcu7t5v0__nand3_1 A1 A2 A3 ZN VDD VNW VPW VSS
.ends

* Black-box entry subcircuit for gf180mcu_fd_sc_mcu7t5v0__and3_2 abstract view
.subckt gf180mcu_fd_sc_mcu7t5v0__and3_2 A1 A2 A3 Z VDD VNW VPW VSS
.ends

* Black-box entry subcircuit for gf180mcu_fd_sc_mcu7t5v0__inv_4 abstract view
.subckt gf180mcu_fd_sc_mcu7t5v0__inv_4 I ZN VDD VNW VPW VSS
.ends

* Black-box entry subcircuit for gf180mcu_fd_sc_mcu7t5v0__nand3_2 abstract view
.subckt gf180mcu_fd_sc_mcu7t5v0__nand3_2 A1 A2 A3 ZN VDD VNW VPW VSS
.ends

* Black-box entry subcircuit for gf180mcu_fd_sc_mcu7t5v0__clkbuf_16 abstract view
.subckt gf180mcu_fd_sc_mcu7t5v0__clkbuf_16 I Z VDD VNW VPW VSS
.ends

* Black-box entry subcircuit for gf180mcu_fd_sc_mcu7t5v0__nor4_4 abstract view
.subckt gf180mcu_fd_sc_mcu7t5v0__nor4_4 A1 A2 A3 A4 ZN VDD VNW VPW VSS
.ends

* Black-box entry subcircuit for gf180mcu_fd_sc_mcu7t5v0__xor2_1 abstract view
.subckt gf180mcu_fd_sc_mcu7t5v0__xor2_1 A1 A2 Z VDD VNW VPW VSS
.ends

* Black-box entry subcircuit for gf180mcu_fd_sc_mcu7t5v0__or3_1 abstract view
.subckt gf180mcu_fd_sc_mcu7t5v0__or3_1 A1 A2 A3 Z VDD VNW VPW VSS
.ends

* Black-box entry subcircuit for gf180mcu_fd_sc_mcu7t5v0__nand2_2 abstract view
.subckt gf180mcu_fd_sc_mcu7t5v0__nand2_2 A1 A2 ZN VDD VNW VPW VSS
.ends

* Black-box entry subcircuit for gf180mcu_fd_sc_mcu7t5v0__inv_3 abstract view
.subckt gf180mcu_fd_sc_mcu7t5v0__inv_3 I ZN VDD VNW VPW VSS
.ends

* Black-box entry subcircuit for gf180mcu_fd_sc_mcu7t5v0__aoi221_4 abstract view
.subckt gf180mcu_fd_sc_mcu7t5v0__aoi221_4 A1 A2 B1 B2 C ZN VDD VNW VPW VSS
.ends

* Black-box entry subcircuit for gf180mcu_fd_sc_mcu7t5v0__nor4_1 abstract view
.subckt gf180mcu_fd_sc_mcu7t5v0__nor4_1 A1 A2 A3 A4 ZN VDD VNW VPW VSS
.ends

* Black-box entry subcircuit for gf180mcu_fd_sc_mcu7t5v0__and3_1 abstract view
.subckt gf180mcu_fd_sc_mcu7t5v0__and3_1 A1 A2 A3 Z VDD VNW VPW VSS
.ends

* Black-box entry subcircuit for gf180mcu_fd_sc_mcu7t5v0__inv_2 abstract view
.subckt gf180mcu_fd_sc_mcu7t5v0__inv_2 I ZN VDD VNW VPW VSS
.ends

* Black-box entry subcircuit for gf180mcu_fd_sc_mcu7t5v0__aoi21_4 abstract view
.subckt gf180mcu_fd_sc_mcu7t5v0__aoi21_4 A1 A2 B ZN VDD VNW VPW VSS
.ends

* Black-box entry subcircuit for gf180mcu_fd_sc_mcu7t5v0__or2_1 abstract view
.subckt gf180mcu_fd_sc_mcu7t5v0__or2_1 A1 A2 Z VDD VNW VPW VSS
.ends

* Black-box entry subcircuit for gf180mcu_fd_sc_mcu7t5v0__aoi222_1 abstract view
.subckt gf180mcu_fd_sc_mcu7t5v0__aoi222_1 A1 A2 B1 B2 C1 C2 ZN VDD VNW VPW VSS
.ends

* Black-box entry subcircuit for gf180mcu_fd_sc_mcu7t5v0__dffsnq_1 abstract view
.subckt gf180mcu_fd_sc_mcu7t5v0__dffsnq_1 D SETN CLK Q VDD VNW VPW VSS
.ends

* Black-box entry subcircuit for gf180mcu_fd_sc_mcu7t5v0__dffrnq_4 abstract view
.subckt gf180mcu_fd_sc_mcu7t5v0__dffrnq_4 D RN CLK Q VDD VNW VPW VSS
.ends

* Black-box entry subcircuit for gf180mcu_fd_sc_mcu7t5v0__or3_2 abstract view
.subckt gf180mcu_fd_sc_mcu7t5v0__or3_2 A1 A2 A3 Z VDD VNW VPW VSS
.ends

.subckt spi_regs VDD VSS boot_complete cal_dir_x cal_dir_y cal_done_x cal_done_y cal_phase0_offset_x[0]
+ cal_phase0_offset_x[10] cal_phase0_offset_x[11] cal_phase0_offset_x[12] cal_phase0_offset_x[13]
+ cal_phase0_offset_x[14] cal_phase0_offset_x[15] cal_phase0_offset_x[16] cal_phase0_offset_x[17]
+ cal_phase0_offset_x[18] cal_phase0_offset_x[19] cal_phase0_offset_x[1] cal_phase0_offset_x[20]
+ cal_phase0_offset_x[2] cal_phase0_offset_x[3] cal_phase0_offset_x[4] cal_phase0_offset_x[5]
+ cal_phase0_offset_x[6] cal_phase0_offset_x[7] cal_phase0_offset_x[8] cal_phase0_offset_x[9]
+ cal_phase0_offset_y[0] cal_phase0_offset_y[10] cal_phase0_offset_y[11] cal_phase0_offset_y[12]
+ cal_phase0_offset_y[13] cal_phase0_offset_y[14] cal_phase0_offset_y[15] cal_phase0_offset_y[16]
+ cal_phase0_offset_y[17] cal_phase0_offset_y[18] cal_phase0_offset_y[19] cal_phase0_offset_y[1]
+ cal_phase0_offset_y[20] cal_phase0_offset_y[2] cal_phase0_offset_y[3] cal_phase0_offset_y[4]
+ cal_phase0_offset_y[5] cal_phase0_offset_y[6] cal_phase0_offset_y[7] cal_phase0_offset_y[8]
+ cal_phase0_offset_y[9] cal_phase270_offset_x[0] cal_phase270_offset_x[10] cal_phase270_offset_x[11]
+ cal_phase270_offset_x[12] cal_phase270_offset_x[13] cal_phase270_offset_x[14] cal_phase270_offset_x[15]
+ cal_phase270_offset_x[16] cal_phase270_offset_x[17] cal_phase270_offset_x[18] cal_phase270_offset_x[19]
+ cal_phase270_offset_x[1] cal_phase270_offset_x[20] cal_phase270_offset_x[2] cal_phase270_offset_x[3]
+ cal_phase270_offset_x[4] cal_phase270_offset_x[5] cal_phase270_offset_x[6] cal_phase270_offset_x[7]
+ cal_phase270_offset_x[8] cal_phase270_offset_x[9] cal_phase270_offset_y[0] cal_phase270_offset_y[10]
+ cal_phase270_offset_y[11] cal_phase270_offset_y[12] cal_phase270_offset_y[13] cal_phase270_offset_y[14]
+ cal_phase270_offset_y[15] cal_phase270_offset_y[16] cal_phase270_offset_y[17] cal_phase270_offset_y[18]
+ cal_phase270_offset_y[19] cal_phase270_offset_y[1] cal_phase270_offset_y[20] cal_phase270_offset_y[2]
+ cal_phase270_offset_y[3] cal_phase270_offset_y[4] cal_phase270_offset_y[5] cal_phase270_offset_y[6]
+ cal_phase270_offset_y[7] cal_phase270_offset_y[8] cal_phase270_offset_y[9] cal_phase90_offset_x[0]
+ cal_phase90_offset_x[10] cal_phase90_offset_x[11] cal_phase90_offset_x[12] cal_phase90_offset_x[13]
+ cal_phase90_offset_x[14] cal_phase90_offset_x[15] cal_phase90_offset_x[16] cal_phase90_offset_x[17]
+ cal_phase90_offset_x[18] cal_phase90_offset_x[19] cal_phase90_offset_x[1] cal_phase90_offset_x[20]
+ cal_phase90_offset_x[2] cal_phase90_offset_x[3] cal_phase90_offset_x[4] cal_phase90_offset_x[5]
+ cal_phase90_offset_x[6] cal_phase90_offset_x[7] cal_phase90_offset_x[8] cal_phase90_offset_x[9]
+ cal_phase90_offset_y[0] cal_phase90_offset_y[10] cal_phase90_offset_y[11] cal_phase90_offset_y[12]
+ cal_phase90_offset_y[13] cal_phase90_offset_y[14] cal_phase90_offset_y[15] cal_phase90_offset_y[16]
+ cal_phase90_offset_y[17] cal_phase90_offset_y[18] cal_phase90_offset_y[19] cal_phase90_offset_y[1]
+ cal_phase90_offset_y[20] cal_phase90_offset_y[2] cal_phase90_offset_y[3] cal_phase90_offset_y[4]
+ cal_phase90_offset_y[5] cal_phase90_offset_y[6] cal_phase90_offset_y[7] cal_phase90_offset_y[8]
+ cal_phase90_offset_y[9] cal_timeout_x cal_timeout_y cfg_done cfg_f_MEMS_fcw_x[0]
+ cfg_f_MEMS_fcw_x[10] cfg_f_MEMS_fcw_x[11] cfg_f_MEMS_fcw_x[12] cfg_f_MEMS_fcw_x[13]
+ cfg_f_MEMS_fcw_x[14] cfg_f_MEMS_fcw_x[15] cfg_f_MEMS_fcw_x[1] cfg_f_MEMS_fcw_x[2]
+ cfg_f_MEMS_fcw_x[3] cfg_f_MEMS_fcw_x[4] cfg_f_MEMS_fcw_x[5] cfg_f_MEMS_fcw_x[6]
+ cfg_f_MEMS_fcw_x[7] cfg_f_MEMS_fcw_x[8] cfg_f_MEMS_fcw_x[9] cfg_f_MEMS_fcw_y[0]
+ cfg_f_MEMS_fcw_y[10] cfg_f_MEMS_fcw_y[11] cfg_f_MEMS_fcw_y[12] cfg_f_MEMS_fcw_y[13]
+ cfg_f_MEMS_fcw_y[14] cfg_f_MEMS_fcw_y[15] cfg_f_MEMS_fcw_y[1] cfg_f_MEMS_fcw_y[2]
+ cfg_f_MEMS_fcw_y[3] cfg_f_MEMS_fcw_y[4] cfg_f_MEMS_fcw_y[5] cfg_f_MEMS_fcw_y[6]
+ cfg_f_MEMS_fcw_y[7] cfg_f_MEMS_fcw_y[8] cfg_f_MEMS_fcw_y[9] cfg_phase0_offset_x[0]
+ cfg_phase0_offset_x[10] cfg_phase0_offset_x[11] cfg_phase0_offset_x[12] cfg_phase0_offset_x[13]
+ cfg_phase0_offset_x[14] cfg_phase0_offset_x[15] cfg_phase0_offset_x[16] cfg_phase0_offset_x[17]
+ cfg_phase0_offset_x[18] cfg_phase0_offset_x[19] cfg_phase0_offset_x[1] cfg_phase0_offset_x[20]
+ cfg_phase0_offset_x[2] cfg_phase0_offset_x[3] cfg_phase0_offset_x[4] cfg_phase0_offset_x[5]
+ cfg_phase0_offset_x[6] cfg_phase0_offset_x[7] cfg_phase0_offset_x[8] cfg_phase0_offset_x[9]
+ cfg_phase0_offset_y[0] cfg_phase0_offset_y[10] cfg_phase0_offset_y[11] cfg_phase0_offset_y[12]
+ cfg_phase0_offset_y[13] cfg_phase0_offset_y[14] cfg_phase0_offset_y[15] cfg_phase0_offset_y[16]
+ cfg_phase0_offset_y[17] cfg_phase0_offset_y[18] cfg_phase0_offset_y[19] cfg_phase0_offset_y[1]
+ cfg_phase0_offset_y[20] cfg_phase0_offset_y[2] cfg_phase0_offset_y[3] cfg_phase0_offset_y[4]
+ cfg_phase0_offset_y[5] cfg_phase0_offset_y[6] cfg_phase0_offset_y[7] cfg_phase0_offset_y[8]
+ cfg_phase0_offset_y[9] cfg_phase270_offset_x[0] cfg_phase270_offset_x[10] cfg_phase270_offset_x[11]
+ cfg_phase270_offset_x[12] cfg_phase270_offset_x[13] cfg_phase270_offset_x[14] cfg_phase270_offset_x[15]
+ cfg_phase270_offset_x[16] cfg_phase270_offset_x[17] cfg_phase270_offset_x[18] cfg_phase270_offset_x[19]
+ cfg_phase270_offset_x[1] cfg_phase270_offset_x[20] cfg_phase270_offset_x[2] cfg_phase270_offset_x[3]
+ cfg_phase270_offset_x[4] cfg_phase270_offset_x[5] cfg_phase270_offset_x[6] cfg_phase270_offset_x[7]
+ cfg_phase270_offset_x[8] cfg_phase270_offset_x[9] cfg_phase270_offset_y[0] cfg_phase270_offset_y[10]
+ cfg_phase270_offset_y[11] cfg_phase270_offset_y[12] cfg_phase270_offset_y[13] cfg_phase270_offset_y[14]
+ cfg_phase270_offset_y[15] cfg_phase270_offset_y[16] cfg_phase270_offset_y[17] cfg_phase270_offset_y[18]
+ cfg_phase270_offset_y[19] cfg_phase270_offset_y[1] cfg_phase270_offset_y[20] cfg_phase270_offset_y[2]
+ cfg_phase270_offset_y[3] cfg_phase270_offset_y[4] cfg_phase270_offset_y[5] cfg_phase270_offset_y[6]
+ cfg_phase270_offset_y[7] cfg_phase270_offset_y[8] cfg_phase270_offset_y[9] cfg_phase90_offset_x[0]
+ cfg_phase90_offset_x[10] cfg_phase90_offset_x[11] cfg_phase90_offset_x[12] cfg_phase90_offset_x[13]
+ cfg_phase90_offset_x[14] cfg_phase90_offset_x[15] cfg_phase90_offset_x[16] cfg_phase90_offset_x[17]
+ cfg_phase90_offset_x[18] cfg_phase90_offset_x[19] cfg_phase90_offset_x[1] cfg_phase90_offset_x[20]
+ cfg_phase90_offset_x[2] cfg_phase90_offset_x[3] cfg_phase90_offset_x[4] cfg_phase90_offset_x[5]
+ cfg_phase90_offset_x[6] cfg_phase90_offset_x[7] cfg_phase90_offset_x[8] cfg_phase90_offset_x[9]
+ cfg_phase90_offset_y[0] cfg_phase90_offset_y[10] cfg_phase90_offset_y[11] cfg_phase90_offset_y[12]
+ cfg_phase90_offset_y[13] cfg_phase90_offset_y[14] cfg_phase90_offset_y[15] cfg_phase90_offset_y[16]
+ cfg_phase90_offset_y[17] cfg_phase90_offset_y[18] cfg_phase90_offset_y[19] cfg_phase90_offset_y[1]
+ cfg_phase90_offset_y[20] cfg_phase90_offset_y[2] cfg_phase90_offset_y[3] cfg_phase90_offset_y[4]
+ cfg_phase90_offset_y[5] cfg_phase90_offset_y[6] cfg_phase90_offset_y[7] cfg_phase90_offset_y[8]
+ cfg_phase90_offset_y[9] clk delay_wave_cycle_x[0] delay_wave_cycle_x[1] delay_wave_cycle_x[2]
+ delay_wave_cycle_x[3] delay_wave_cycle_x[4] delay_wave_cycle_x[5] delay_wave_cycle_x[6]
+ delay_wave_cycle_x[7] delay_wave_cycle_y[0] delay_wave_cycle_y[1] delay_wave_cycle_y[2]
+ delay_wave_cycle_y[3] delay_wave_cycle_y[4] delay_wave_cycle_y[5] delay_wave_cycle_y[6]
+ delay_wave_cycle_y[7] jitter_flag_x jitter_flag_y latch_error_x latch_error_y phase_offset_imported
+ phase_state_x[0] phase_state_x[1] phase_state_y[0] phase_state_y[1] raw_edge1_x[0]
+ raw_edge1_x[10] raw_edge1_x[11] raw_edge1_x[12] raw_edge1_x[13] raw_edge1_x[14]
+ raw_edge1_x[15] raw_edge1_x[16] raw_edge1_x[17] raw_edge1_x[18] raw_edge1_x[19]
+ raw_edge1_x[1] raw_edge1_x[20] raw_edge1_x[2] raw_edge1_x[3] raw_edge1_x[4] raw_edge1_x[5]
+ raw_edge1_x[6] raw_edge1_x[7] raw_edge1_x[8] raw_edge1_x[9] raw_edge1_y[0] raw_edge1_y[10]
+ raw_edge1_y[11] raw_edge1_y[12] raw_edge1_y[13] raw_edge1_y[14] raw_edge1_y[15]
+ raw_edge1_y[16] raw_edge1_y[17] raw_edge1_y[18] raw_edge1_y[19] raw_edge1_y[1] raw_edge1_y[20]
+ raw_edge1_y[2] raw_edge1_y[3] raw_edge1_y[4] raw_edge1_y[5] raw_edge1_y[6] raw_edge1_y[7]
+ raw_edge1_y[8] raw_edge1_y[9] raw_edge2_x[0] raw_edge2_x[10] raw_edge2_x[11] raw_edge2_x[12]
+ raw_edge2_x[13] raw_edge2_x[14] raw_edge2_x[15] raw_edge2_x[16] raw_edge2_x[17]
+ raw_edge2_x[18] raw_edge2_x[19] raw_edge2_x[1] raw_edge2_x[20] raw_edge2_x[2] raw_edge2_x[3]
+ raw_edge2_x[4] raw_edge2_x[5] raw_edge2_x[6] raw_edge2_x[7] raw_edge2_x[8] raw_edge2_x[9]
+ raw_edge2_y[0] raw_edge2_y[10] raw_edge2_y[11] raw_edge2_y[12] raw_edge2_y[13] raw_edge2_y[14]
+ raw_edge2_y[15] raw_edge2_y[16] raw_edge2_y[17] raw_edge2_y[18] raw_edge2_y[19]
+ raw_edge2_y[1] raw_edge2_y[20] raw_edge2_y[2] raw_edge2_y[3] raw_edge2_y[4] raw_edge2_y[5]
+ raw_edge2_y[6] raw_edge2_y[7] raw_edge2_y[8] raw_edge2_y[9] raw_edge3_x[0] raw_edge3_x[10]
+ raw_edge3_x[11] raw_edge3_x[12] raw_edge3_x[13] raw_edge3_x[14] raw_edge3_x[15]
+ raw_edge3_x[16] raw_edge3_x[17] raw_edge3_x[18] raw_edge3_x[19] raw_edge3_x[1] raw_edge3_x[20]
+ raw_edge3_x[2] raw_edge3_x[3] raw_edge3_x[4] raw_edge3_x[5] raw_edge3_x[6] raw_edge3_x[7]
+ raw_edge3_x[8] raw_edge3_x[9] raw_edge3_y[0] raw_edge3_y[10] raw_edge3_y[11] raw_edge3_y[12]
+ raw_edge3_y[13] raw_edge3_y[14] raw_edge3_y[15] raw_edge3_y[16] raw_edge3_y[17]
+ raw_edge3_y[18] raw_edge3_y[19] raw_edge3_y[1] raw_edge3_y[20] raw_edge3_y[2] raw_edge3_y[3]
+ raw_edge3_y[4] raw_edge3_y[5] raw_edge3_y[6] raw_edge3_y[7] raw_edge3_y[8] raw_edge3_y[9]
+ rst_n soft_rst spi_cs_n spi_miso spi_miso_oe spi_mosi spi_sclk state_o[0] state_o[1]
+ state_o[2] votes_in_phase_x[0] votes_in_phase_x[1] votes_in_phase_x[2] votes_in_phase_x[3]
+ votes_in_phase_y[0] votes_in_phase_y[1] votes_in_phase_y[2] votes_in_phase_y[3]
+ votes_out_phase_x[0] votes_out_phase_x[1] votes_out_phase_x[2] votes_out_phase_x[3]
+ votes_out_phase_y[0] votes_out_phase_y[1] votes_out_phase_y[2] votes_out_phase_y[3]
XFILLER_54_247 VDD VDD VSS VSS gf180mcu_fd_sc_mcu7t5v0__fillcap_4
XFILLER_54_225 VDD VDD VSS VSS gf180mcu_fd_sc_mcu7t5v0__fillcap_4
XFILLER_39_255 VDD VDD VSS VSS gf180mcu_fd_sc_mcu7t5v0__fillcap_8
XFILLER_35_483 VDD VDD VSS VSS gf180mcu_fd_sc_mcu7t5v0__fill_1
XFILLER_22_177 VDD VDD VSS VSS gf180mcu_fd_sc_mcu7t5v0__fillcap_4
XFILLER_2_527 VDD VDD VSS VSS gf180mcu_fd_sc_mcu7t5v0__fillcap_8
XTAP_TAPCELL_ROW_20_334 VDD VSS gf180mcu_fd_sc_mcu7t5v0__filltie
Xfanout864 _1582_/RN wire867/I VDD VDD VSS VSS gf180mcu_fd_sc_mcu7t5v0__dlyb_1
XTAP_TAPCELL_ROW_71_746 VDD VSS gf180mcu_fd_sc_mcu7t5v0__filltie
XFILLER_60_228 VDD VDD VSS VSS gf180mcu_fd_sc_mcu7t5v0__fillcap_8
XFILLER_45_258 VDD VDD VSS VSS gf180mcu_fd_sc_mcu7t5v0__fillcap_8
XFILLER_41_431 VDD VDD VSS VSS gf180mcu_fd_sc_mcu7t5v0__fillcap_4
XTAP_TAPCELL_ROW_28_401 VDD VSS gf180mcu_fd_sc_mcu7t5v0__filltie
XPHY_EDGE_ROW_39_Left_121 VDD VSS gf180mcu_fd_sc_mcu7t5v0__endcap
XPHY_EDGE_ROW_48_Left_130 VDD VSS gf180mcu_fd_sc_mcu7t5v0__endcap
X_1270_ _1581_/Q _1580_/Q _1582_/Q _1373_/A3 VDD VDD VSS VSS gf180mcu_fd_sc_mcu7t5v0__nor3_4
XFILLER_80_2 VDD VDD VSS VSS gf180mcu_fd_sc_mcu7t5v0__fillcap_32
XTAP_TAPCELL_ROW_34_448 VDD VSS gf180mcu_fd_sc_mcu7t5v0__filltie
X_0985_ _0985_/A1 _0985_/A2 _0985_/A3 wire470/I VDD VDD VSS VSS gf180mcu_fd_sc_mcu7t5v0__nor3_2
Xoutput401 _1475_/Q cfg_phase270_offset_x[8] VDD VDD VSS VSS gf180mcu_fd_sc_mcu7t5v0__buf_2
Xoutput423 _1534_/Q cfg_phase270_offset_y[9] VDD VDD VSS VSS gf180mcu_fd_sc_mcu7t5v0__buf_2
Xoutput412 _1543_/Q cfg_phase270_offset_y[18] VDD VDD VSS VSS gf180mcu_fd_sc_mcu7t5v0__buf_2
X_1606_ _1606_/D _1616_/RN _1674_/CLK _1606_/Q VDD VDD VSS VSS gf180mcu_fd_sc_mcu7t5v0__dffrnq_1
Xoutput434 _1657_/Q cfg_phase90_offset_x[19] VDD VDD VSS VSS gf180mcu_fd_sc_mcu7t5v0__buf_2
Xoutput467 _1591_/Q soft_rst VDD VDD VSS VSS gf180mcu_fd_sc_mcu7t5v0__buf_2
X_1537_ _1537_/D _1539_/RN _1587_/CLK _1537_/Q VDD VDD VSS VSS gf180mcu_fd_sc_mcu7t5v0__dffrnq_1
X_1399_ _1480_/Q _1399_/I1 _1400_/S _1480_/D VDD VDD VSS VSS gf180mcu_fd_sc_mcu7t5v0__mux2_2
X_1468_ _1468_/D wire794/I clkload1/I _1468_/Q VDD VDD VSS VSS gf180mcu_fd_sc_mcu7t5v0__dffrnq_1
Xoutput456 _1510_/Q cfg_phase90_offset_y[1] VDD VDD VSS VSS gf180mcu_fd_sc_mcu7t5v0__buf_2
Xoutput445 _1509_/Q cfg_phase90_offset_y[0] VDD VDD VSS VSS gf180mcu_fd_sc_mcu7t5v0__buf_2
XFILLER_42_239 VDD VDD VSS VSS gf180mcu_fd_sc_mcu7t5v0__fillcap_4
Xwire539 wire539/I wire539/Z VDD VDD VSS VSS gf180mcu_fd_sc_mcu7t5v0__buf_2
XFILLER_6_107 VDD VDD VSS VSS gf180mcu_fd_sc_mcu7t5v0__fillcap_64
XFILLER_10_169 VDD VDD VSS VSS gf180mcu_fd_sc_mcu7t5v0__fillcap_4
XFILLER_12_76 VDD VDD VSS VSS gf180mcu_fd_sc_mcu7t5v0__fillcap_8
XFILLER_77_136 VDD VDD VSS VSS gf180mcu_fd_sc_mcu7t5v0__fillcap_4
XFILLER_18_247 VDD VDD VSS VSS gf180mcu_fd_sc_mcu7t5v0__fillcap_4
X_0770_ _0770_/I0 _1540_/Q _1466_/S _1540_/D VDD VDD VSS VSS gf180mcu_fd_sc_mcu7t5v0__mux2_2
XFILLER_68_147 VDD VDD VSS VSS gf180mcu_fd_sc_mcu7t5v0__fill_2
X_1253_ _1579_/Q _0762_/I _1254_/B VDD VDD VSS VSS gf180mcu_fd_sc_mcu7t5v0__nand2_1
X_1322_ _1638_/Q _1364_/I1 _1330_/S _1638_/D VDD VDD VSS VSS gf180mcu_fd_sc_mcu7t5v0__mux2_2
X_1184_ input10/Z _1231_/A2 _1190_/A1 VDD VDD VSS VSS gf180mcu_fd_sc_mcu7t5v0__nand2_1
XFILLER_49_383 VDD VDD VSS VSS gf180mcu_fd_sc_mcu7t5v0__fill_1
XTAP_TAPCELL_ROW_47_551 VDD VSS gf180mcu_fd_sc_mcu7t5v0__filltie
X_0968_ _1549_/Q _0968_/A2 _1235_/B VDD VDD VSS VSS gf180mcu_fd_sc_mcu7t5v0__nand2_4
X_0899_ _1555_/Q _1248_/A1 _1252_/A1 _1557_/Q _0916_/A2 VDD VDD VSS VSS gf180mcu_fd_sc_mcu7t5v0__nand4_4
XFILLER_28_523 VDD VDD VSS VSS gf180mcu_fd_sc_mcu7t5v0__fill_2
XTAP_TAPCELL_ROW_81_830 VDD VSS gf180mcu_fd_sc_mcu7t5v0__filltie
XTAP_TAPCELL_ROW_53_598 VDD VSS gf180mcu_fd_sc_mcu7t5v0__filltie
XFILLER_43_515 VDD VDD VSS VSS gf180mcu_fd_sc_mcu7t5v0__fill_1
XFILLER_23_261 VDD VDD VSS VSS gf180mcu_fd_sc_mcu7t5v0__fill_1
XFILLER_7_416 VDD VDD VSS VSS gf180mcu_fd_sc_mcu7t5v0__fillcap_4
XFILLER_23_97 VDD VDD VSS VSS gf180mcu_fd_sc_mcu7t5v0__fillcap_32
XFILLER_61_334 VDD VDD VSS VSS gf180mcu_fd_sc_mcu7t5v0__fillcap_8
X_0822_ _1257_/A1 _0822_/A2 _0822_/B _1560_/Q _0826_/A1 VDD VDD VSS VSS gf180mcu_fd_sc_mcu7t5v0__oai211_1
XFILLER_9_88 VDD VDD VSS VSS gf180mcu_fd_sc_mcu7t5v0__fill_2
XFILLER_43_2 VDD VDD VSS VSS gf180mcu_fd_sc_mcu7t5v0__fillcap_4
X_0753_ _1578_/Q _0749_/Z _1428_/A3 _0781_/S VDD VDD VSS VSS gf180mcu_fd_sc_mcu7t5v0__nand3_4
Xload_slew875 wire876/Z _1564_/RN VDD VDD VSS VSS gf180mcu_fd_sc_mcu7t5v0__buf_2
Xload_slew886 wire887/Z fanout884/I VDD VDD VSS VSS gf180mcu_fd_sc_mcu7t5v0__buf_2
X_1236_ _1236_/A1 _1236_/A2 _1236_/A3 _1236_/A4 _1243_/A2 VDD VDD VSS VSS gf180mcu_fd_sc_mcu7t5v0__nand4_1
Xload_slew820 _1476_/RN _1677_/RN VDD VDD VSS VSS gf180mcu_fd_sc_mcu7t5v0__buf_1
Xload_slew831 _1508_/RN _1510_/RN VDD VDD VSS VSS gf180mcu_fd_sc_mcu7t5v0__clkbuf_2
X_1305_ _1409_/I1 _1625_/Q _1313_/S _1625_/D VDD VDD VSS VSS gf180mcu_fd_sc_mcu7t5v0__mux2_2
Xload_slew842 wire843/I _1621_/RN VDD VDD VSS VSS gf180mcu_fd_sc_mcu7t5v0__clkbuf_2
Xload_slew853 _1521_/RN _1515_/RN VDD VDD VSS VSS gf180mcu_fd_sc_mcu7t5v0__clkbuf_2
X_1167_ _1167_/A1 wire586/Z _1185_/B1 _1167_/B2 _1229_/B1 _1664_/Q _1171_/A1 VDD VDD
+ VSS VSS gf180mcu_fd_sc_mcu7t5v0__aoi222_2
X_1098_ _1098_/A1 wire573/Z _1205_/A2 _1499_/Q wire515/Z _1098_/C2 wire493/I VDD VDD
+ VSS VSS gf180mcu_fd_sc_mcu7t5v0__aoi222_4
XFILLER_37_397 VDD VDD VSS VSS gf180mcu_fd_sc_mcu7t5v0__fillcap_4
XFILLER_25_515 VDD VDD VSS VSS gf180mcu_fd_sc_mcu7t5v0__fill_1
XTAP_TAPCELL_ROW_50_579 VDD VSS gf180mcu_fd_sc_mcu7t5v0__filltie
XTAP_TAPCELL_ROW_7_235 VDD VSS gf180mcu_fd_sc_mcu7t5v0__filltie
XFILLER_55_150 VDD VDD VSS VSS gf180mcu_fd_sc_mcu7t5v0__fillcap_16
XFILLER_47_139 VDD VDD VSS VSS gf180mcu_fd_sc_mcu7t5v0__fill_1
XFILLER_18_53 VDD VDD VSS VSS gf180mcu_fd_sc_mcu7t5v0__fillcap_4
XTAP_TAPCELL_ROW_41_502 VDD VSS gf180mcu_fd_sc_mcu7t5v0__filltie
XFILLER_34_52 VDD VDD VSS VSS gf180mcu_fd_sc_mcu7t5v0__fillcap_4
XFILLER_50_73 VDD VDD VSS VSS gf180mcu_fd_sc_mcu7t5v0__fillcap_32
XFILLER_81_407 VDD VDD VSS VSS gf180mcu_fd_sc_mcu7t5v0__fill_1
XFILLER_61_153 VDD VDD VSS VSS gf180mcu_fd_sc_mcu7t5v0__fillcap_8
X_1021_ _1021_/A1 _1070_/B1 wire547/Z input60/Z _1177_/B _1022_/A2 VDD VDD VSS VSS
+ gf180mcu_fd_sc_mcu7t5v0__aoi221_2
XFILLER_15_570 VDD VDD VSS VSS gf180mcu_fd_sc_mcu7t5v0__fillcap_4
X_0805_ _1556_/Q _0806_/A2 _0805_/B _0806_/B VDD VDD VSS VSS gf180mcu_fd_sc_mcu7t5v0__aoi21_1
XTAP_TAPCELL_ROW_12_270 VDD VSS gf180mcu_fd_sc_mcu7t5v0__filltie
Xload_slew650 _0913_/A1 _0903_/A1 VDD VDD VSS VSS gf180mcu_fd_sc_mcu7t5v0__buf_2
X_0736_ _1586_/Q _0736_/ZN VDD VDD VSS VSS gf180mcu_fd_sc_mcu7t5v0__clkinv_1
XTAP_TAPCELL_ROW_4_205 VDD VSS gf180mcu_fd_sc_mcu7t5v0__filltie
Xload_slew683 _0907_/A2 _0866_/A1 VDD VDD VSS VSS gf180mcu_fd_sc_mcu7t5v0__buf_2
XFILLER_65_492 VDD VDD VSS VSS gf180mcu_fd_sc_mcu7t5v0__fillcap_4
Xload_slew661 _0878_/A2 _0874_/A1 VDD VDD VSS VSS gf180mcu_fd_sc_mcu7t5v0__buf_2
Xload_slew672 wire674/Z _0892_/A1 VDD VDD VSS VSS gf180mcu_fd_sc_mcu7t5v0__clkbuf_1
XTAP_TAPCELL_ROW_55_616 VDD VSS gf180mcu_fd_sc_mcu7t5v0__filltie
X_1219_ input74/Z _1219_/A2 _1219_/B1 _1503_/Q _1239_/A1 VDD VDD VSS VSS gf180mcu_fd_sc_mcu7t5v0__aoi22_1
Xload_slew694 _1460_/A1 fanout684/I VDD VDD VSS VSS gf180mcu_fd_sc_mcu7t5v0__buf_1
XTAP_TAPCELL_ROW_63_682 VDD VSS gf180mcu_fd_sc_mcu7t5v0__filltie
XFILLER_21_551 VDD VDD VSS VSS gf180mcu_fd_sc_mcu7t5v0__fill_1
XFILLER_21_562 VDD VDD VSS VSS gf180mcu_fd_sc_mcu7t5v0__fillcap_4
XFILLER_75_212 VDD VDD VSS VSS gf180mcu_fd_sc_mcu7t5v0__fillcap_64
Xinput301 votes_out_phase_x[3] _1099_/A1 VDD VDD VSS VSS gf180mcu_fd_sc_mcu7t5v0__buf_1
XFILLER_0_444 VDD VDD VSS VSS gf180mcu_fd_sc_mcu7t5v0__fillcap_32
XFILLER_71_440 VDD VDD VSS VSS gf180mcu_fd_sc_mcu7t5v0__fillcap_8
XFILLER_43_142 VDD VDD VSS VSS gf180mcu_fd_sc_mcu7t5v0__fillcap_4
XFILLER_43_120 VDD VDD VSS VSS gf180mcu_fd_sc_mcu7t5v0__fill_2
XFILLER_28_150 VDD VDD VSS VSS gf180mcu_fd_sc_mcu7t5v0__fillcap_4
XFILLER_16_312 VDD VDD VSS VSS gf180mcu_fd_sc_mcu7t5v0__fill_2
XTAP_TAPCELL_ROW_18_318 VDD VSS gf180mcu_fd_sc_mcu7t5v0__filltie
XFILLER_61_72 VDD VDD VSS VSS gf180mcu_fd_sc_mcu7t5v0__fillcap_64
XFILLER_6_34 VDD VDD VSS VSS gf180mcu_fd_sc_mcu7t5v0__fill_1
XPHY_EDGE_ROW_20_Left_102 VDD VSS gf180mcu_fd_sc_mcu7t5v0__endcap
XTAP_TAPCELL_ROW_26_384 VDD VSS gf180mcu_fd_sc_mcu7t5v0__filltie
X_1570_ _1570_/D _1571_/RN _1575_/CLK _1570_/Q VDD VDD VSS VSS gf180mcu_fd_sc_mcu7t5v0__dffrnq_1
XFILLER_6_45 VDD VDD VSS VSS gf180mcu_fd_sc_mcu7t5v0__fillcap_32
XFILLER_3_282 VDD VDD VSS VSS gf180mcu_fd_sc_mcu7t5v0__fillcap_64
XFILLER_81_237 VDD VDD VSS VSS gf180mcu_fd_sc_mcu7t5v0__fill_1
XFILLER_79_562 VDD VDD VSS VSS gf180mcu_fd_sc_mcu7t5v0__fillcap_8
XFILLER_47_492 VDD VDD VSS VSS gf180mcu_fd_sc_mcu7t5v0__fillcap_16
XFILLER_62_473 VDD VDD VSS VSS gf180mcu_fd_sc_mcu7t5v0__fill_2
XTAP_TAPCELL_ROW_60_652 VDD VSS gf180mcu_fd_sc_mcu7t5v0__filltie
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
