llhtimlam/Probton/librelane/Submodule/Digital_RTL_GDS_state_machine/35-openroad-cts/state_machine.pnl.v

module state_machine (boot_complete,
    cal_done,
    cal_start,
    cal_timeout,
    cfg_done,
    clk,
    phase_offset_imported,
    read_en,
    rst_n,
    soft_rst,
    VDD,
    VSS,
    state_o);
 input boot_complete;
 input cal_done;
 output cal_start;
 input cal_timeout;
 input cfg_done;
 input clk;
 input phase_offset_imported;
 output read_en;
 input rst_n;
 input soft_rst;
 inout VDD;
 inout VSS;
 output [2:0] state_o;

 wire _00_;
 wire _01_;
 wire _02_;
 wire _03_;
 wire _04_;
 wire _05_;
 wire _06_;
 wire _07_;
 wire _08_;
 wire _09_;
 wire _10_;
 wire _11_;
 wire _12_;
 wire _13_;
 wire _14_;
 wire _15_;
 wire _16_;
 wire _17_;
 wire net1;
 wire net2;
 wire net8;
 wire net3;
 wire net4;
 wire net5;
 wire net9;
 wire net6;
 wire net7;
 wire net10;
 wire net11;
 wire net12;
 wire net13;
 wire clknet_0_clk;
 wire clknet_1_0__leaf_clk;
 wire clknet_1_1__leaf_clk;

 gf180mcu_fd_sc_mcu7t5v0__endcap PHY_EDGE_ROW_0_Left_10 (.VDD(VDD),
    .VSS(VSS));
 gf180mcu_fd_sc_mcu7t5v0__endcap PHY_EDGE_ROW_0_Right_0 (.VDD(VDD),
    .VSS(VSS));
 gf180mcu_fd_sc_mcu7t5v0__endcap PHY_EDGE_ROW_1_Left_11 (.VDD(VDD),
    .VSS(VSS));
 gf180mcu_fd_sc_mcu7t5v0__endcap PHY_EDGE_ROW_1_Right_1 (.VDD(VDD),
    .VSS(VSS));
 gf180mcu_fd_sc_mcu7t5v0__endcap PHY_EDGE_ROW_2_Left_12 (.VDD(VDD),
    .VSS(VSS));
 gf180mcu_fd_sc_mcu7t5v0__endcap PHY_EDGE_ROW_2_Right_2 (.VDD(VDD),
    .VSS(VSS));
 gf180mcu_fd_sc_mcu7t5v0__endcap PHY_EDGE_ROW_3_Left_13 (.VDD(VDD),
    .VSS(VSS));
 gf180mcu_fd_sc_mcu7t5v0__endcap PHY_EDGE_ROW_3_Right_3 (.VDD(VDD),
    .VSS(VSS));
 gf180mcu_fd_sc_mcu7t5v0__endcap PHY_EDGE_ROW_4_Left_14 (.VDD(VDD),
    .VSS(VSS));
 gf180mcu_fd_sc_mcu7t5v0__endcap PHY_EDGE_ROW_4_Right_4 (.VDD(VDD),
    .VSS(VSS));
 gf180mcu_fd_sc_mcu7t5v0__endcap PHY_EDGE_ROW_5_Left_15 (.VDD(VDD),
    .VSS(VSS));
 gf180mcu_fd_sc_mcu7t5v0__endcap PHY_EDGE_ROW_5_Right_5 (.VDD(VDD),
    .VSS(VSS));
 gf180mcu_fd_sc_mcu7t5v0__endcap PHY_EDGE_ROW_6_Left_16 (.VDD(VDD),
    .VSS(VSS));
 gf180mcu_fd_sc_mcu7t5v0__endcap PHY_EDGE_ROW_6_Right_6 (.VDD(VDD),
    .VSS(VSS));
 gf180mcu_fd_sc_mcu7t5v0__endcap PHY_EDGE_ROW_7_Left_17 (.VDD(VDD),
    .VSS(VSS));
 gf180mcu_fd_sc_mcu7t5v0__endcap PHY_EDGE_ROW_7_Right_7 (.VDD(VDD),
    .VSS(VSS));
 gf180mcu_fd_sc_mcu7t5v0__endcap PHY_EDGE_ROW_8_Left_18 (.VDD(VDD),
    .VSS(VSS));
 gf180mcu_fd_sc_mcu7t5v0__endcap PHY_EDGE_ROW_8_Right_8 (.VDD(VDD),
    .VSS(VSS));
 gf180mcu_fd_sc_mcu7t5v0__endcap PHY_EDGE_ROW_9_Left_19 (.VDD(VDD),
    .VSS(VSS));
 gf180mcu_fd_sc_mcu7t5v0__endcap PHY_EDGE_ROW_9_Right_9 (.VDD(VDD),
    .VSS(VSS));
 gf180mcu_fd_sc_mcu7t5v0__filltie TAP_TAPCELL_ROW_0_20 (.VDD(VDD),
    .VSS(VSS));
 gf180mcu_fd_sc_mcu7t5v0__filltie TAP_TAPCELL_ROW_0_21 (.VDD(VDD),
    .VSS(VSS));
 gf180mcu_fd_sc_mcu7t5v0__filltie TAP_TAPCELL_ROW_1_22 (.VDD(VDD),
    .VSS(VSS));
 gf180mcu_fd_sc_mcu7t5v0__filltie TAP_TAPCELL_ROW_2_23 (.VDD(VDD),
    .VSS(VSS));
 gf180mcu_fd_sc_mcu7t5v0__filltie TAP_TAPCELL_ROW_3_24 (.VDD(VDD),
    .VSS(VSS));
 gf180mcu_fd_sc_mcu7t5v0__filltie TAP_TAPCELL_ROW_4_25 (.VDD(VDD),
    .VSS(VSS));
 gf180mcu_fd_sc_mcu7t5v0__filltie TAP_TAPCELL_ROW_5_26 (.VDD(VDD),
    .VSS(VSS));
 gf180mcu_fd_sc_mcu7t5v0__filltie TAP_TAPCELL_ROW_6_27 (.VDD(VDD),
    .VSS(VSS));
 gf180mcu_fd_sc_mcu7t5v0__filltie TAP_TAPCELL_ROW_7_28 (.VDD(VDD),
    .VSS(VSS));
 gf180mcu_fd_sc_mcu7t5v0__filltie TAP_TAPCELL_ROW_8_29 (.VDD(VDD),
    .VSS(VSS));
 gf180mcu_fd_sc_mcu7t5v0__filltie TAP_TAPCELL_ROW_9_30 (.VDD(VDD),
    .VSS(VSS));
 gf180mcu_fd_sc_mcu7t5v0__filltie TAP_TAPCELL_ROW_9_31 (.VDD(VDD),
    .VSS(VSS));
 gf180mcu_fd_sc_mcu7t5v0__clkinv_1 _18_ (.I(net7),
    .ZN(_03_),
    .VDD(VDD),
    .VNW(VDD),
    .VPW(VSS),
    .VSS(VSS));
 gf180mcu_fd_sc_mcu7t5v0__clkinv_1 _19_ (.I(net11),
    .ZN(_04_),
    .VDD(VDD),
    .VNW(VDD),
    .VPW(VSS),
    .VSS(VSS));
 gf180mcu_fd_sc_mcu7t5v0__clkinv_1 _20_ (.I(net4),
    .ZN(_05_),
    .VDD(VDD),
    .VNW(VDD),
    .VPW(VSS),
    .VSS(VSS));
 gf180mcu_fd_sc_mcu7t5v0__nor3_2 _21_ (.A1(net10),
    .A2(_04_),
    .A3(net12),
    .ZN(net8),
    .VDD(VDD),
    .VNW(VDD),
    .VPW(VSS),
    .VSS(VSS));
 gf180mcu_fd_sc_mcu7t5v0__and2_1 _22_ (.A1(net11),
    .A2(net12),
    .Z(_06_),
    .VDD(VDD),
    .VNW(VDD),
    .VPW(VSS),
    .VSS(VSS));
 gf180mcu_fd_sc_mcu7t5v0__nor2_1 _23_ (.A1(net11),
    .A2(net12),
    .ZN(_07_),
    .VDD(VDD),
    .VNW(VDD),
    .VPW(VSS),
    .VSS(VSS));
 gf180mcu_fd_sc_mcu7t5v0__nor3_1 _24_ (.A1(net10),
    .A2(_06_),
    .A3(_07_),
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
    .Z(net13),
    .VDD(VDD),
    .VNW(VDD),
    .VPW(VSS),
    .VSS(VSS));
 gf180mcu_fd_sc_mcu7t5v0__buf_2 output10 (.I(net10),
    .Z(state_o[0]),
    .VDD(VDD),
    .VNW(VDD),
    .VPW(VSS),
    .VSS(VSS));
 gf180mcu_fd_sc_mcu7t5v0__buf_2 output11 (.I(net11),
    .Z(state_o[1]),
    .VDD(VDD),
    .VNW(VDD),
    .VPW(VSS),
    .VSS(VSS));
 gf180mcu_fd_sc_mcu7t5v0__buf_2 output12 (.I(net12),
    .Z(state_o[2]),
    .VDD(VDD),
    .VNW(VDD),
    .VPW(VSS),
    .VSS(VSS));
 gf180mcu_fd_sc_mcu7t5v0__buf_2 output8 (.I(net8),
    .Z(cal_start),
    .VDD(VDD),
    .VNW(VDD),
    .VPW(VSS),
    .VSS(VSS));
 gf180mcu_fd_sc_mcu7t5v0__buf_2 output9 (.I(net9),
    .Z(read_en),
    .VDD(VDD),
    .VNW(VDD),
    .VPW(VSS),
    .VSS(VSS));
endmodule
