llhtimlam/Probton/librelane/Submodule/Digital_RTL_GDS_wave_controller/13-openroad-floorplan/wave_controller.nl.v

module wave_controller (cal_dir,
    cal_done,
    cal_start,
    cal_timeout,
    cfg_done,
    clk,
    comp,
    latch_error,
    latch_phase270,
    latch_phase270_ack,
    latch_phase90,
    latch_phase90_ack,
    mems_drv,
    ref_wave,
    rst_n,
    soft_rst_n,
    cal_phase0_offset,
    cal_phase270_offset,
    cal_phase90_offset,
    cfg_f_MEMS_fcw,
    cfg_phase0_offset,
    cfg_phase270_offset,
    cfg_phase90_offset,
    delay_wave_cycle,
    raw_edge1,
    raw_edge2,
    raw_edge3);
 output cal_dir;
 output cal_done;
 input cal_start;
 output cal_timeout;
 input cfg_done;
 input clk;
 input comp;
 output latch_error;
 output latch_phase270;
 input latch_phase270_ack;
 output latch_phase90;
 input latch_phase90_ack;
 output mems_drv;
 output ref_wave;
 input rst_n;
 input soft_rst_n;
 output [20:0] cal_phase0_offset;
 output [20:0] cal_phase270_offset;
 output [20:0] cal_phase90_offset;
 input [15:0] cfg_f_MEMS_fcw;
 input [20:0] cfg_phase0_offset;
 input [20:0] cfg_phase270_offset;
 input [20:0] cfg_phase90_offset;
 output [7:0] delay_wave_cycle;
 output [20:0] raw_edge1;
 output [20:0] raw_edge2;
 output [20:0] raw_edge3;

 wire _0000_;
 wire _0001_;
 wire _0002_;
 wire _0003_;
 wire _0004_;
 wire _0005_;
 wire _0006_;
 wire _0007_;
 wire _0008_;
 wire _0009_;
 wire _0010_;
 wire _0011_;
 wire _0012_;
 wire _0013_;
 wire _0014_;
 wire _0015_;
 wire _0016_;
 wire _0017_;
 wire _0018_;
 wire _0019_;
 wire _0020_;
 wire _0021_;
 wire _0022_;
 wire _0023_;
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
    .A2(\phase_acc[16] ),
    .A3(_0507_),
    .A4(_0735_),
    .ZN(_0794_));
 gf180mcu_fd_sc_mcu7t5v0__and3_1 _2445_ (.A1(soft_rst_n),
    .A2(_0792_),
    .A3(_0794_),
    .Z(_0053_));
 gf180mcu_fd_sc_mcu7t5v0__oai21_1 _2446_ (.A1(\phase_acc[18] ),
    .A2(_0793_),
    .B(soft_rst_n),
    .ZN(_0795_));
 gf180mcu_fd_sc_mcu7t5v0__aoi21_1 _2447_ (.A1(\phase_acc[18] ),
    .A2(_0793_),
    .B(_0795_),
    .ZN(_0054_));
 gf180mcu_fd_sc_mcu7t5v0__aoi21_1 _2448_ (.A1(\phase_acc[18] ),
    .A2(_0793_),
    .B(\phase_acc[19] ),
    .ZN(_0796_));
 gf180mcu_fd_sc_mcu7t5v0__nor2_1 _2449_ (.A1(_1492_),
    .A2(_0794_),
    .ZN(_0797_));
 gf180mcu_fd_sc_mcu7t5v0__nor3_1 _2450_ (.A1(_1291_),
    .A2(_0796_),
    .A3(_0797_),
    .ZN(_0055_));
 gf180mcu_fd_sc_mcu7t5v0__xor2_1 _2451_ (.A1(_1270_),
    .A2(_0797_),
    .Z(_0798_));
 gf180mcu_fd_sc_mcu7t5v0__nor2_1 _2452_ (.A1(_1291_),
    .A2(_0798_),
    .ZN(_0056_));
 gf180mcu_fd_sc_mcu7t5v0__nand2_1 _2453_ (.A1(cal_start),
    .A2(cfg_done),
    .ZN(_0799_));
 gf180mcu_fd_sc_mcu7t5v0__nand2_1 _2454_ (.A1(cal_burst_armed),
    .A2(_0738_),
    .ZN(_0800_));
 gf180mcu_fd_sc_mcu7t5v0__nand3_1 _2455_ (.A1(cal_start),
    .A2(cfg_done),
    .A3(_0800_),
    .ZN(_0057_));
 gf180mcu_fd_sc_mcu7t5v0__nand2_1 _2456_ (.A1(cal_burst_active),
    .A2(_0738_),
    .ZN(_0801_));
 gf180mcu_fd_sc_mcu7t5v0__nand2_1 _2457_ (.A1(\cal_burst_count[0] ),
    .A2(_1269_),
    .ZN(_0802_));
 gf180mcu_fd_sc_mcu7t5v0__aoi21_1 _2458_ (.A1(cal_burst_active),
    .A2(_0802_),
    .B(cal_burst_armed),
    .ZN(_0803_));
 gf180mcu_fd_sc_mcu7t5v0__or2_1 _2459_ (.A1(_0738_),
    .A2(_0803_),
    .Z(_0804_));
 gf180mcu_fd_sc_mcu7t5v0__aoi21_1 _2460_ (.A1(_0801_),
    .A2(_0804_),
    .B(_0799_),
    .ZN(_0058_));
 gf180mcu_fd_sc_mcu7t5v0__nor2_1 _2461_ (.A1(\cal_burst_count[0] ),
    .A2(cal_burst_armed),
    .ZN(_0805_));
 gf180mcu_fd_sc_mcu7t5v0__oai211_1 _2462_ (.A1(_0804_),
    .A2(_0805_),
    .B(cal_start),
    .C(cfg_done),
    .ZN(_0806_));
 gf180mcu_fd_sc_mcu7t5v0__aoi21_1 _2463_ (.A1(_1268_),
    .A2(_0804_),
    .B(_0806_),
    .ZN(_0059_));
 gf180mcu_fd_sc_mcu7t5v0__nor2_1 _2464_ (.A1(_1269_),
    .A2(_0806_),
    .ZN(_0060_));
 gf180mcu_fd_sc_mcu7t5v0__nand2_1 _2465_ (.A1(latch_phase270),
    .A2(latch_phase90),
    .ZN(_0807_));
 gf180mcu_fd_sc_mcu7t5v0__nand4_1 _2466_ (.A1(_1267_),
    .A2(cfg_done),
    .A3(soft_rst_n),
    .A4(_0807_),
    .ZN(_0808_));
 gf180mcu_fd_sc_mcu7t5v0__nand2_1 _2467_ (.A1(latch_phase90),
    .A2(_1355_),
    .ZN(_0809_));
 gf180mcu_fd_sc_mcu7t5v0__nand2_1 _2468_ (.A1(\phase_acc[15] ),
    .A2(_1293_),
    .ZN(_0810_));
 gf180mcu_fd_sc_mcu7t5v0__xor2_1 _2469_ (.A1(\phase_acc[14] ),
    .A2(cfg_phase90_offset[14]),
    .Z(_0811_));
 gf180mcu_fd_sc_mcu7t5v0__nor2_1 _2470_ (.A1(_1251_),
    .A2(cfg_phase90_offset[13]),
    .ZN(_0812_));
 gf180mcu_fd_sc_mcu7t5v0__nand2_1 _2471_ (.A1(_1251_),
    .A2(cfg_phase90_offset[13]),
    .ZN(_0813_));
 gf180mcu_fd_sc_mcu7t5v0__nand2_1 _2472_ (.A1(_1252_),
    .A2(cfg_phase90_offset[12]),
    .ZN(_0814_));
 gf180mcu_fd_sc_mcu7t5v0__xor2_1 _2473_ (.A1(\phase_acc[12] ),
    .A2(cfg_phase90_offset[12]),
    .Z(_0815_));
 gf180mcu_fd_sc_mcu7t5v0__clkinv_1 _2474_ (.I(_0815_),
    .ZN(_0816_));
 gf180mcu_fd_sc_mcu7t5v0__nor2_1 _2475_ (.A1(\phase_acc[9] ),
    .A2(_1297_),
    .ZN(_0817_));
 gf180mcu_fd_sc_mcu7t5v0__nand2_1 _2476_ (.A1(_1258_),
    .A2(cfg_phase90_offset[8]),
    .ZN(_0818_));
 gf180mcu_fd_sc_mcu7t5v0__nand2_1 _2477_ (.A1(\phase_acc[7] ),
    .A2(_1299_),
    .ZN(_0819_));
 gf180mcu_fd_sc_mcu7t5v0__nand2_1 _2478_ (.A1(_1260_),
    .A2(cfg_phase90_offset[6]),
    .ZN(_0820_));
 gf180mcu_fd_sc_mcu7t5v0__nor2_1 _2479_ (.A1(_1260_),
    .A2(cfg_phase90_offset[6]),
    .ZN(_0821_));
 gf180mcu_fd_sc_mcu7t5v0__nor2_1 _2480_ (.A1(\phase_acc[5] ),
    .A2(_1300_),
    .ZN(_0822_));
 gf180mcu_fd_sc_mcu7t5v0__nand2_1 _2481_ (.A1(\phase_acc[5] ),
    .A2(_1300_),
    .ZN(_0823_));
 gf180mcu_fd_sc_mcu7t5v0__and2_1 _2482_ (.A1(_1262_),
    .A2(cfg_phase90_offset[4]),
    .Z(_0824_));
 gf180mcu_fd_sc_mcu7t5v0__nand2_1 _2483_ (.A1(_1263_),
    .A2(cfg_phase90_offset[3]),
    .ZN(_0825_));
 gf180mcu_fd_sc_mcu7t5v0__nand2_1 _2484_ (.A1(_1264_),
    .A2(cfg_phase90_offset[2]),
    .ZN(_0826_));
 gf180mcu_fd_sc_mcu7t5v0__clkinv_1 _2485_ (.I(_0826_),
    .ZN(_0827_));
 gf180mcu_fd_sc_mcu7t5v0__and2_1 _2486_ (.A1(_1265_),
    .A2(cfg_phase90_offset[1]),
    .Z(_0828_));
 gf180mcu_fd_sc_mcu7t5v0__nand2_1 _2487_ (.A1(_1265_),
    .A2(cfg_phase90_offset[1]),
    .ZN(_0829_));
 gf180mcu_fd_sc_mcu7t5v0__xnor2_1 _2488_ (.A1(\phase_acc[1] ),
    .A2(cfg_phase90_offset[1]),
    .ZN(_0830_));
 gf180mcu_fd_sc_mcu7t5v0__xor2_1 _2489_ (.A1(\phase_acc[1] ),
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
    .ZN(_1005_));
 gf180mcu_fd_sc_mcu7t5v0__aoi22_1 _2665_ (.A1(_1248_),
    .A2(cfg_phase270_offset[15]),
    .B1(cfg_phase270_offset[14]),
    .B2(_1249_),
    .ZN(_1006_));
 gf180mcu_fd_sc_mcu7t5v0__oai31_1 _2666_ (.A1(_0954_),
    .A2(_0955_),
    .A3(_1004_),
    .B(_1006_),
    .ZN(_1007_));
 gf180mcu_fd_sc_mcu7t5v0__nand2_1 _2667_ (.A1(_0953_),
    .A2(_1007_),
    .ZN(_1008_));
 gf180mcu_fd_sc_mcu7t5v0__nor2_1 _2668_ (.A1(_1246_),
    .A2(cfg_phase270_offset[16]),
    .ZN(_1009_));
 gf180mcu_fd_sc_mcu7t5v0__nand2_1 _2669_ (.A1(_1245_),
    .A2(cfg_phase270_offset[17]),
    .ZN(_1010_));
 gf180mcu_fd_sc_mcu7t5v0__xor2_1 _2670_ (.A1(\phase_acc[17] ),
    .A2(cfg_phase270_offset[17]),
    .Z(_1011_));
 gf180mcu_fd_sc_mcu7t5v0__xor2_1 _2671_ (.A1(_1246_),
    .A2(cfg_phase270_offset[16]),
    .Z(_1012_));
 gf180mcu_fd_sc_mcu7t5v0__clkinv_1 _2672_ (.I(_1012_),
    .ZN(_1013_));
 gf180mcu_fd_sc_mcu7t5v0__nor2_1 _2673_ (.A1(_1011_),
    .A2(_1013_),
    .ZN(_1014_));
 gf180mcu_fd_sc_mcu7t5v0__nand3_1 _2674_ (.A1(_0953_),
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
