llhtimlam/Probton/librelane/Submodule/Digital_RTL_GDS_wave_controller/19-openroad-tapendcapinsertion/wave_controller.pnl.v

module wave_controller (cal_dir,
    cal_done,
    cal_start,
    cal_timeout,
    cfg_done,
    clk,
    comp,
    latch_error,
    latch_phase270,
    latch_phase270_ack,
    latch_phase90,
    latch_phase90_ack,
    mems_drv,
    ref_wave,
    rst_n,
    soft_rst_n,
    cal_phase0_offset,
    cal_phase270_offset,
    cal_phase90_offset,
    cfg_f_MEMS_fcw,
    cfg_phase0_offset,
    cfg_phase270_offset,
    cfg_phase90_offset,
    delay_wave_cycle,
    raw_edge1,
    raw_edge2,
    raw_edge3);
 output cal_dir;
 output cal_done;
 input cal_start;
 output cal_timeout;
 input cfg_done;
 input clk;
 input comp;
 output latch_error;
 output latch_phase270;
 input latch_phase270_ack;
 output latch_phase90;
 input latch_phase90_ack;
 output mems_drv;
 output ref_wave;
 input rst_n;
 input soft_rst_n;
 output [20:0] cal_phase0_offset;
 output [20:0] cal_phase270_offset;
 output [20:0] cal_phase90_offset;
 input [15:0] cfg_f_MEMS_fcw;
 input [20:0] cfg_phase0_offset;
 input [20:0] cfg_phase270_offset;
 input [20:0] cfg_phase90_offset;
 output [7:0] delay_wave_cycle;
 output [20:0] raw_edge1;
 output [20:0] raw_edge2;
 output [20:0] raw_edge3;

 wire _0000_;
 wire _0001_;
 wire _0002_;
 wire _0003_;
 wire _0004_;
 wire _0005_;
 wire _0006_;
 wire _0007_;
 wire _0008_;
 wire _0009_;
 wire _0010_;
 wire _0011_;
 wire _0012_;
 wire _0013_;
 wire _0014_;
 wire _0015_;
 wire _0016_;
 wire _0017_;
 wire _0018_;
 wire _0019_;
 wire _0020_;
 wire _0021_;
 wire _0022_;
 wire _0023_;
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
    .VSS(VSS));
 gf180mcu_fd_sc_mcu7t5v0__filltie TAP_TAPCELL_ROW_92_1082 (.VDD(VDD),
    .VSS(VSS));
 gf180mcu_fd_sc_mcu7t5v0__filltie TAP_TAPCELL_ROW_92_1083 (.VDD(VDD),
    .VSS(VSS));
 gf180mcu_fd_sc_mcu7t5v0__filltie TAP_TAPCELL_ROW_92_1084 (.VDD(VDD),
    .VSS(VSS));
 gf180mcu_fd_sc_mcu7t5v0__filltie TAP_TAPCELL_ROW_92_1085 (.VDD(VDD),
    .VSS(VSS));
 gf180mcu_fd_sc_mcu7t5v0__filltie TAP_TAPCELL_ROW_92_1086 (.VDD(VDD),
    .VSS(VSS));
 gf180mcu_fd_sc_mcu7t5v0__filltie TAP_TAPCELL_ROW_93_1087 (.VDD(VDD),
    .VSS(VSS));
 gf180mcu_fd_sc_mcu7t5v0__filltie TAP_TAPCELL_ROW_93_1088 (.VDD(VDD),
    .VSS(VSS));
 gf180mcu_fd_sc_mcu7t5v0__filltie TAP_TAPCELL_ROW_93_1089 (.VDD(VDD),
    .VSS(VSS));
 gf180mcu_fd_sc_mcu7t5v0__filltie TAP_TAPCELL_ROW_93_1090 (.VDD(VDD),
    .VSS(VSS));
 gf180mcu_fd_sc_mcu7t5v0__filltie TAP_TAPCELL_ROW_93_1091 (.VDD(VDD),
    .VSS(VSS));
 gf180mcu_fd_sc_mcu7t5v0__filltie TAP_TAPCELL_ROW_93_1092 (.VDD(VDD),
    .VSS(VSS));
 gf180mcu_fd_sc_mcu7t5v0__filltie TAP_TAPCELL_ROW_93_1093 (.VDD(VDD),
    .VSS(VSS));
 gf180mcu_fd_sc_mcu7t5v0__filltie TAP_TAPCELL_ROW_93_1094 (.VDD(VDD),
    .VSS(VSS));
 gf180mcu_fd_sc_mcu7t5v0__filltie TAP_TAPCELL_ROW_93_1095 (.VDD(VDD),
    .VSS(VSS));
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
