llhtimlam/Probton/def/A/B18_A_padring.v

module B18_A_padring (
    N01,
    N02,
    N03,
    N04,
    N05,
    N06,
    N07,
    N08,
    N09,
    N10,
    N11,
    N12,
    N13,
    N14,
    N15,
    N16,
    N17,
    N18,
    N19,
    N20,
    N21,
    N22,
    E01,
    E02,
    E03,
    E04,
    E05,
    E06,
    E07,
    E08,
    E09,
    E10,
    E11,
    E12,
    E13,
    E14,
    E15,
    E16,
    E17,
    E18,
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
    W13_PU,
    W13_PD,
    W13_Y,
    W14_PU,
    W14_PD,
    W14_Y,
    W15_PU,
    W15_PD,
    W15_Y,
    W16_PU,
    W16_PD,
    W16_Y,
    W17_CS,
    W17_SL,
    W17_IE,
    W17_OE,
    W17_PU,
    W17_PD,
    W17_A,
    W17_PDRV0,
    W17_PDRV1,
    W17_Y,
    W18_PU,
    W18_PD,
    W18_Y,
    W19_CS,
    W19_SL,
    W19_IE,
    W19_OE,
    W19_PU,
    W19_PD,
    W19_A,
    W19_PDRV0,
    W19_PDRV1,
    W19_Y,
    W20_CS,
    W20_SL,
    W20_IE,
    W20_OE,
    W20_PU,
    W20_PD,
    W20_A,
    W20_PDRV0,
    W20_PDRV1,
    W20_Y,
    W21_CS,
    W21_SL,
    W21_IE,
    W21_OE,
    W21_PU,
    W21_PD,
    W21_A,
    W21_PDRV0,
    W21_PDRV1,
    W21_Y,
    W22_CS,
    W22_SL,
    W22_IE,
    W22_OE,
    W22_PU,
    W22_PD,
    W22_A,
    W22_PDRV0,
    W22_PDRV1,
    W22_Y,
    N01_CS,
    N01_SL,
    N01_IE,
    N01_OE,
    N01_PU,
    N01_PD,
    N01_A,
    N01_PDRV0,
    N01_PDRV1,
    N01_Y,
    N02_CS,
    N02_SL,
    N02_IE,
    N02_OE,
    N02_PU,
    N02_PD,
    N02_A,
    N02_PDRV0,
    N02_PDRV1,
    N02_Y,
    N03_CS,
    N03_SL,
    N03_IE,
    N03_OE,
    N03_PU,
    N03_PD,
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
  output N04_Y;
  input N05_PU;
  input N05_PD;
  output N05_Y;
  input N06_CS;
  input N06_SL;
  input N06_IE;
  input N06_OE;
  input N06_PU;
  input N06_PD;
  input N06_A;
  input N06_PDRV0;
  input N06_PDRV1;
  output N06_Y;
  input N07_PU;
  input N07_PD;
  output N07_Y;
  wire FLOAT_VDD_1;


  gf180mcu_fd_io__bi_t N01 (.CS(N01_CS), .SL(N01_SL), .IE(N01_IE), .OE(N01_OE), .PU(N01_PU), .PD(N01_PD), .A(N01_A), .PDRV0(N01_PDRV0), .PDRV1(N01_PDRV1), .Y(N01_Y), .PAD(N01), .VSS(W12), .DVSS(W12), .VDD(N08), .DVDD(N08));
  gf180mcu_fd_io__bi_t N02 (.CS(N02_CS), .SL(N02_SL), .IE(N02_IE), .OE(N02_OE), .PU(N02_PU), .PD(N02_PD), .A(N02_A), .PDRV0(N02_PDRV0), .PDRV1(N02_PDRV1), .Y(N02_Y), .PAD(N02), .VSS(W12), .DVSS(W12), .VDD(N08), .DVDD(N08));
  gf180mcu_fd_io__bi_t N03 (.CS(N03_CS), .SL(N03_SL), .IE(N03_IE), .OE(N03_OE), .PU(N03_PU), .PD(N03_PD), .A(N03_A), .PDRV0(N03_PDRV0), .PDRV1(N03_PDRV1), .Y(N03_Y), .PAD(N03), .VSS(W12), .DVSS(W12), .VDD(N08), .DVDD(N08));
  gf180mcu_fd_io__bi_t N04 (.CS(N04_CS), .SL(N04_SL), .IE(N04_IE), .OE(N04_OE), .PU(N04_PU), .PD(N04_PD), .A(N04_A), .PDRV0(N04_PDRV0), .PDRV1(N04_PDRV1), .Y(N04_Y), .PAD(N04), .VSS(W12), .DVSS(W12), .VDD(N08), .DVDD(N08));
  gf180mcu_fd_io__in_c N05 (.PU(N05_PU), .PD(N05_PD), .Y(N05_Y), .PAD(N05), .VSS(W12), .DVSS(W12), .VDD(N08), .DVDD(N08));
  gf180mcu_fd_io__bi_t N06 (.CS(N06_CS), .SL(N06_SL), .IE(N06_IE), .OE(N06_OE), .PU(N06_PU), .PD(N06_PD), .A(N06_A), .PDRV0(N06_PDRV0), .PDRV1(N06_PDRV1), .Y(N06_Y), .PAD(N06), .VSS(W12), .DVSS(W12), .VDD(N08), .DVDD(N08));
  gf180mcu_fd_io__in_c N07 (.PU(N07_PU), .PD(N07_PD), .Y(N07_Y), .PAD(N07), .VSS(W12), .DVSS(W12), .VDD(N08), .DVDD(N08));
  gf180mcu_fd_io__dvdd N08 (.DVDD(N08), .VSS(W12), .DVSS(W12));
  gf180mcu_fd_io__asig_5p0 N09 (.ASIG5V(N09), .VSS(W12), .DVSS(W12), .VDD(FLOAT_VDD_1), .DVDD(FLOAT_VDD_1));
  gf180mcu_fd_io__asig_5p0 N10 (.ASIG5V(N10), .VSS(W12), .DVSS(W12), .VDD(FLOAT_VDD_1), .DVDD(FLOAT_VDD_1));
  gf180mcu_fd_io__asig_5p0 N11 (.ASIG5V(N11), .VSS(W12), .DVSS(W12), .VDD(FLOAT_VDD_1), .DVDD(FLOAT_VDD_1));
  gf180mcu_fd_io__asig_5p0 N12 (.ASIG5V(N12), .VSS(W12), .DVSS(W12), .VDD(FLOAT_VDD_1), .DVDD(FLOAT_VDD_1));
  gf180mcu_fd_io__asig_5p0 N13 (.ASIG5V(N13), .VSS(W12), .DVSS(W12), .VDD(FLOAT_VDD_1), .DVDD(FLOAT_VDD_1));
  gf180mcu_fd_io__asig_5p0 N14 (.ASIG5V(N14), .VSS(W12), .DVSS(W12), .VDD(FLOAT_VDD_1), .DVDD(FLOAT_VDD_1));
  gf180mcu_fd_io__asig_5p0 N15 (.ASIG5V(N15), .VSS(W12), .DVSS(W12), .VDD(FLOAT_VDD_1), .DVDD(FLOAT_VDD_1));
  gf180mcu_fd_io__asig_5p0 N16 (.ASIG5V(N16), .VSS(W12), .DVSS(W12), .VDD(FLOAT_VDD_1), .DVDD(FLOAT_VDD_1));
  gf180mcu_fd_io__asig_5p0 N17 (.ASIG5V(N17), .VSS(W12), .DVSS(W12), .VDD(FLOAT_VDD_1), .DVDD(FLOAT_VDD_1));
  gf180mcu_fd_io__asig_5p0 N18 (.ASIG5V(N18), .VSS(W12), .DVSS(W12), .VDD(FLOAT_VDD_1), .DVDD(FLOAT_VDD_1));
  gf180mcu_fd_io__asig_5p0 N19 (.ASIG5V(N19), .VSS(W12), .DVSS(W12), .VDD(FLOAT_VDD_1), .DVDD(FLOAT_VDD_1));
  gf180mcu_fd_io__asig_5p0 N20 (.ASIG5V(N20), .VSS(W12), .DVSS(W12), .VDD(FLOAT_VDD_1), .DVDD(FLOAT_VDD_1));
  gf180mcu_fd_io__asig_5p0 N21 (.ASIG5V(N21), .VSS(W12), .DVSS(W12), .VDD(FLOAT_VDD_1), .DVDD(FLOAT_VDD_1));
  gf180mcu_fd_io__asig_5p0 N22 (.ASIG5V(N22), .VSS(W12), .DVSS(W12), .VDD(FLOAT_VDD_1), .DVDD(FLOAT_VDD_1));
  gf180mcu_fd_io__asig_5p0 S01 (.ASIG5V(S01), .VSS(W12), .DVSS(W12), .VDD(FLOAT_VDD_1), .DVDD(FLOAT_VDD_1));
  gf180mcu_fd_io__asig_5p0 S02 (.ASIG5V(S02), .VSS(W12), .DVSS(W12), .VDD(FLOAT_VDD_1), .DVDD(FLOAT_VDD_1));
  gf180mcu_fd_io__asig_5p0 S03 (.ASIG5V(S03), .VSS(W12), .DVSS(W12), .VDD(FLOAT_VDD_1), .DVDD(FLOAT_VDD_1));
  gf180mcu_fd_io__asig_5p0 S04 (.ASIG5V(S04), .VSS(W12), .DVSS(W12), .VDD(FLOAT_VDD_1), .DVDD(FLOAT_VDD_1));
  gf180mcu_fd_io__asig_5p0 S05 (.ASIG5V(S05), .VSS(W12), .DVSS(W12), .VDD(FLOAT_VDD_1), .DVDD(FLOAT_VDD_1));
  gf180mcu_fd_io__asig_5p0 S06 (.ASIG5V(S06), .VSS(W12), .DVSS(W12), .VDD(FLOAT_VDD_1), .DVDD(FLOAT_VDD_1));
  gf180mcu_fd_io__asig_5p0 S07 (.ASIG5V(S07), .VSS(W12), .DVSS(W12), .VDD(FLOAT_VDD_1), .DVDD(FLOAT_VDD_1));
  gf180mcu_fd_io__asig_5p0 S08 (.ASIG5V(S08), .VSS(W12), .DVSS(W12), .VDD(FLOAT_VDD_1), .DVDD(FLOAT_VDD_1));
  gf180mcu_fd_io__asig_5p0 S09 (.ASIG5V(S09), .VSS(W12), .DVSS(W12), .VDD(FLOAT_VDD_1), .DVDD(FLOAT_VDD_1));
  gf180mcu_fd_io__asig_5p0 S10 (.ASIG5V(S10), .VSS(W12), .DVSS(W12), .VDD(FLOAT_VDD_1), .DVDD(FLOAT_VDD_1));
  gf180mcu_fd_io__asig_5p0 S11 (.ASIG5V(S11), .VSS(W12), .DVSS(W12), .VDD(FLOAT_VDD_1), .DVDD(FLOAT_VDD_1));
  gf180mcu_fd_io__asig_5p0 S12 (.ASIG5V(S12), .VSS(W12), .DVSS(W12), .VDD(FLOAT_VDD_1), .DVDD(FLOAT_VDD_1));
  gf180mcu_fd_io__asig_5p0 S13 (.ASIG5V(S13), .VSS(W12), .DVSS(W12), .VDD(FLOAT_VDD_1), .DVDD(FLOAT_VDD_1));
  gf180mcu_fd_io__asig_5p0 S14 (.ASIG5V(S14), .VSS(W12), .DVSS(W12), .VDD(FLOAT_VDD_1), .DVDD(FLOAT_VDD_1));
  gf180mcu_fd_io__asig_5p0 S15 (.ASIG5V(S15), .VSS(W12), .DVSS(W12), .VDD(FLOAT_VDD_1), .DVDD(FLOAT_VDD_1));
  gf180mcu_fd_io__asig_5p0 S16 (.ASIG5V(S16), .VSS(W12), .DVSS(W12), .VDD(FLOAT_VDD_1), .DVDD(FLOAT_VDD_1));
  gf180mcu_fd_io__asig_5p0 S17 (.ASIG5V(S17), .VSS(W12), .DVSS(W12), .VDD(FLOAT_VDD_1), .DVDD(FLOAT_VDD_1));
  gf180mcu_fd_io__asig_5p0 S18 (.ASIG5V(S18), .VSS(W12), .DVSS(W12), .VDD(FLOAT_VDD_1), .DVDD(FLOAT_VDD_1));
  gf180mcu_fd_io__asig_5p0 S19 (.ASIG5V(S19), .VSS(W12), .DVSS(W12), .VDD(FLOAT_VDD_1), .DVDD(FLOAT_VDD_1));
  gf180mcu_fd_io__asig_5p0 S20 (.ASIG5V(S20), .VSS(W12), .DVSS(W12), .VDD(FLOAT_VDD_1), .DVDD(FLOAT_VDD_1));
  gf180mcu_fd_io__asig_5p0 S21 (.ASIG5V(S21), .VSS(W12), .DVSS(W12), .VDD(FLOAT_VDD_1), .DVDD(FLOAT_VDD_1));
  gf180mcu_fd_io__asig_5p0 S22 (.ASIG5V(S22), .VSS(W12), .DVSS(W12), .VDD(FLOAT_VDD_1), .DVDD(FLOAT_VDD_1));
  gf180mcu_fd_io__asig_5p0 W01 (.ASIG5V(W01), .VSS(W12), .DVSS(W12), .VDD(FLOAT_VDD_1), .DVDD(FLOAT_VDD_1));
  gf180mcu_fd_io__asig_5p0 W02 (.ASIG5V(W02), .VSS(W12), .DVSS(W12), .VDD(FLOAT_VDD_1), .DVDD(FLOAT_VDD_1));
  gf180mcu_fd_io__asig_5p0 W03 (.ASIG5V(W03), .VSS(W12), .DVSS(W12), .VDD(FLOAT_VDD_1), .DVDD(FLOAT_VDD_1));
  gf180mcu_fd_io__asig_5p0 W04 (.ASIG5V(W04), .VSS(W12), .DVSS(W12), .VDD(FLOAT_VDD_1), .DVDD(FLOAT_VDD_1));
  gf180mcu_fd_io__asig_5p0 W05 (.ASIG5V(W05), .VSS(W12), .DVSS(W12), .VDD(FLOAT_VDD_1), .DVDD(FLOAT_VDD_1));
  gf180mcu_fd_io__asig_5p0 W06 (.ASIG5V(W06), .VSS(W12), .DVSS(W12), .VDD(FLOAT_VDD_1), .DVDD(FLOAT_VDD_1));
  gf180mcu_fd_io__asig_5p0 W07 (.ASIG5V(W07), .VSS(W12), .DVSS(W12), .VDD(FLOAT_VDD_1), .DVDD(FLOAT_VDD_1));
  gf180mcu_fd_io__asig_5p0 W08 (.ASIG5V(W08), .VSS(W12), .DVSS(W12), .VDD(FLOAT_VDD_1), .DVDD(FLOAT_VDD_1));
  gf180mcu_fd_io__asig_5p0 W09 (.ASIG5V(W09), .VSS(W12), .DVSS(W12), .VDD(FLOAT_VDD_1), .DVDD(FLOAT_VDD_1));
  gf180mcu_fd_io__asig_5p0 W10 (.ASIG5V(W10), .VSS(W12), .DVSS(W12), .VDD(FLOAT_VDD_1), .DVDD(FLOAT_VDD_1));
  gf180mcu_fd_io__asig_5p0 W11 (.ASIG5V(W11), .VSS(W12), .DVSS(W12), .VDD(FLOAT_VDD_1), .DVDD(FLOAT_VDD_1));
  gf180mcu_fd_io__dvss W12 (.DVSS(W12), .VDD(N08), .DVDD(N08));
  gf180mcu_fd_io__in_s W13 (.PU(W13_PU), .PD(W13_PD), .Y(W13_Y), .PAD(W13), .VSS(W12), .DVSS(W12), .VDD(N08), .DVDD(N08));
  gf180mcu_fd_io__in_s W14 (.PU(W14_PU), .PD(W14_PD), .Y(W14_Y), .PAD(W14), .VSS(W12), .DVSS(W12), .VDD(N08), .DVDD(N08));
  gf180mcu_fd_io__in_c W15 (.PU(W15_PU), .PD(W15_PD), .Y(W15_Y), .PAD(W15), .VSS(W12), .DVSS(W12), .VDD(N08), .DVDD(N08));
  gf180mcu_fd_io__in_s W16 (.PU(W16_PU), .PD(W16_PD), .Y(W16_Y), .PAD(W16), .VSS(W12), .DVSS(W12), .VDD(N08), .DVDD(N08));
  gf180mcu_fd_io__bi_t W17 (.CS(W17_CS), .SL(W17_SL), .IE(W17_IE), .OE(W17_OE), .PU(W17_PU), .PD(W17_PD), .A(W17_A), .PDRV0(W17_PDRV0), .PDRV1(W17_PDRV1), .Y(W17_Y), .PAD(W17), .VSS(W12), .DVSS(W12), .VDD(N08), .DVDD(N08));
  gf180mcu_fd_io__in_c W18 (.PU(W18_PU), .PD(W18_PD), .Y(W18_Y), .PAD(W18), .VSS(W12), .DVSS(W12), .VDD(N08), .DVDD(N08));
  gf180mcu_fd_io__bi_t W19 (.CS(W19_CS), .SL(W19_SL), .IE(W19_IE), .OE(W19_OE), .PU(W19_PU), .PD(W19_PD), .A(W19_A), .PDRV0(W19_PDRV0), .PDRV1(W19_PDRV1), .Y(W19_Y), .PAD(W19), .VSS(W12), .DVSS(W12), .VDD(N08), .DVDD(N08));
  gf180mcu_fd_io__bi_t W20 (.CS(W20_CS), .SL(W20_SL), .IE(W20_IE), .OE(W20_OE), .PU(W20_PU), .PD(W20_PD), .A(W20_A), .PDRV0(W20_PDRV0), .PDRV1(W20_PDRV1), .Y(W20_Y), .PAD(W20), .VSS(W12), .DVSS(W12), .VDD(N08), .DVDD(N08));
  gf180mcu_fd_io__bi_t W21 (.CS(W21_CS), .SL(W21_SL), .IE(W21_IE), .OE(W21_OE), .PU(W21_PU), .PD(W21_PD), .A(W21_A), .PDRV0(W21_PDRV0), .PDRV1(W21_PDRV1), .Y(W21_Y), .PAD(W21), .VSS(W12), .DVSS(W12), .VDD(N08), .DVDD(N08));
  gf180mcu_fd_io__bi_t W22 (.CS(W22_CS), .SL(W22_SL), .IE(W22_IE), .OE(W22_OE), .PU(W22_PU), .PD(W22_PD), .A(W22_A), .PDRV0(W22_PDRV0), .PDRV1(W22_PDRV1), .Y(W22_Y), .PAD(W22), .VSS(W12), .DVSS(W12), .VDD(N08), .DVDD(N08));
  gf180mcu_fd_io__asig_5p0 E01 (.ASIG5V(E01), .VSS(W12), .DVSS(W12), .VDD(FLOAT_VDD_1), .DVDD(FLOAT_VDD_1));
  gf180mcu_fd_io__asig_5p0 E02 (.ASIG5V(E02), .VSS(W12), .DVSS(W12), .VDD(FLOAT_VDD_1), .DVDD(FLOAT_VDD_1));
  gf180mcu_fd_io__asig_5p0 E03 (.ASIG5V(E03), .VSS(W12), .DVSS(W12), .VDD(FLOAT_VDD_1), .DVDD(FLOAT_VDD_1));
  gf180mcu_fd_io__asig_5p0 E04 (.ASIG5V(E04), .VSS(W12), .DVSS(W12), .VDD(FLOAT_VDD_1), .DVDD(FLOAT_VDD_1));
  gf180mcu_fd_io__asig_5p0 E05 (.ASIG5V(E05), .VSS(W12), .DVSS(W12), .VDD(FLOAT_VDD_1), .DVDD(FLOAT_VDD_1));
  gf180mcu_fd_io__asig_5p0 E06 (.ASIG5V(E06), .VSS(W12), .DVSS(W12), .VDD(FLOAT_VDD_1), .DVDD(FLOAT_VDD_1));
  gf180mcu_fd_io__asig_5p0 E07 (.ASIG5V(E07), .VSS(W12), .DVSS(W12), .VDD(FLOAT_VDD_1), .DVDD(FLOAT_VDD_1));
  gf180mcu_fd_io__asig_5p0 E08 (.ASIG5V(E08), .VSS(W12), .DVSS(W12), .VDD(FLOAT_VDD_1), .DVDD(FLOAT_VDD_1));
  gf180mcu_fd_io__asig_5p0 E09 (.ASIG5V(E09), .VSS(W12), .DVSS(W12), .VDD(FLOAT_VDD_1), .DVDD(FLOAT_VDD_1));
  gf180mcu_fd_io__asig_5p0 E10 (.ASIG5V(E10), .VSS(W12), .DVSS(W12), .VDD(FLOAT_VDD_1), .DVDD(FLOAT_VDD_1));
  gf180mcu_fd_io__asig_5p0 E11 (.ASIG5V(E11), .VSS(W12), .DVSS(W12), .VDD(FLOAT_VDD_1), .DVDD(FLOAT_VDD_1));
  gf180mcu_fd_io__asig_5p0 E12 (.ASIG5V(E12), .VSS(W12), .DVSS(W12), .VDD(FLOAT_VDD_1), .DVDD(FLOAT_VDD_1));
  gf180mcu_fd_io__asig_5p0 E13 (.ASIG5V(E13), .VSS(W12), .DVSS(W12), .VDD(FLOAT_VDD_1), .DVDD(FLOAT_VDD_1));
  gf180mcu_fd_io__asig_5p0 E14 (.ASIG5V(E14), .VSS(W12), .DVSS(W12), .VDD(FLOAT_VDD_1), .DVDD(FLOAT_VDD_1));
  gf180mcu_fd_io__asig_5p0 E15 (.ASIG5V(E15), .VSS(W12), .DVSS(W12), .VDD(FLOAT_VDD_1), .DVDD(FLOAT_VDD_1));
  gf180mcu_fd_io__asig_5p0 E16 (.ASIG5V(E16), .VSS(W12), .DVSS(W12), .VDD(FLOAT_VDD_1), .DVDD(FLOAT_VDD_1));
  gf180mcu_fd_io__asig_5p0 E17 (.ASIG5V(E17), .VSS(W12), .DVSS(W12), .VDD(FLOAT_VDD_1), .DVDD(FLOAT_VDD_1));
  gf180mcu_fd_io__asig_5p0 E18 (.ASIG5V(E18), .VSS(W12), .DVSS(W12), .VDD(FLOAT_VDD_1), .DVDD(FLOAT_VDD_1));
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
  gf180mcu_fd_io__fill5 FILL_E22_4 (.VSS(W12), .DVSS(W12), .VDD(FLOAT_VDD_1), .DVDD(FLOAT_VDD_1));
  gf180mcu_fd_io__fill5 FILL_E22_5 (.VSS(W12), .DVSS(W12), .VDD(FLOAT_VDD_1), .DVDD(FLOAT_VDD_1));
endmodule
