llhtimlam/Probton/src/chip_core.sv

// SPDX-FileCopyrightText: 2026 Chipathon 2026 workshop
// SPDX-License-Identifier: Apache-2.0
//
// Minimal chip_core for the Chipathon 2026 workshop padring slot.
// The emphasis of this slot is the padring itself (60 analog + 20
// bidir + 4/4 power + clk/rst_n); the core is intentionally trivial:
// a free-running counter whose state drives the 20 bidir pads. The
// 60 analog pads are routed straight through to analog[] and stay
// unconnected at the core level (the intent is that a downstream
// design wires them to custom analog IP later).

`default_nettype none

`include "slot_defines.svh" // Remove if include chip_top.sv

`include "spi.sv"
`include "state_machine.sv"
`include "wave_controller.sv"
`include "signal_processor.sv"
`include "analog_macro.sv"

module chip_core #(
    parameter NUM_INPUT_PADS = 1,   // Added = 1 from default for verilator quick test
    parameter NUM_BIDIR_PADS = 10,  // Added = 20 from default for verilator quick test
    parameter NUM_ANALOG_PADS = 4  // Added = 60 from default for verilator quick test
    )(
    `ifdef USE_POWER_PINS
    inout  wire VDD,
    inout  wire VSS,
    `endif

    input  wire clk,       // clock
    input  wire rst_n,     // reset (active low)

    input  wire [NUM_INPUT_PADS-1:0] input_in,   // Input value
    // Changed from default wire → logic (Start)
    output logic [NUM_INPUT_PADS-1:0] input_pu,   // Pull-up
    output logic [NUM_INPUT_PADS-1:0] input_pd,   // Pull-down

    input  logic [NUM_BIDIR_PADS-1:0] bidir_in,   // Input value
    output logic [NUM_BIDIR_PADS-1:0] bidir_out,  // Output value
    output logic [NUM_BIDIR_PADS-1:0] bidir_oe,   // Output enable
    output logic [NUM_BIDIR_PADS-1:0] bidir_cs,   // Input type (0=CMOS, 1=Schmitt)
    output logic [NUM_BIDIR_PADS-1:0] bidir_sl,   // Slew rate (0=fast, 1=slow)
    output logic [NUM_BIDIR_PADS-1:0] bidir_ie,   // Input enable
    output logic [NUM_BIDIR_PADS-1:0] bidir_pu,   // Pull-up
    output logic [NUM_BIDIR_PADS-1:0] bidir_pd,   // Pull-down
    // Changed from default wire → logic (End)

    inout  wire [NUM_ANALOG_PADS-1:0] analog    // Analog
);
    
    // Template Stuff, I dont know what it is about
    logic _unused;
    assign _unused = &bidir_in;

    logic [NUM_BIDIR_PADS-1:0] count;

    always_ff @(posedge clk) begin
        if (!rst_n) begin
            count <= '0;
        end else begin
            if (&input_in) begin
                count <= count + 1;
            end
        end
    end

    // logic [7:0] sram_0_out;

    //`gf180mcu_xxx_ip_sram__sram512x8m8wm1 sram_0 (
    //    `ifdef USE_POWER_PINS
    //    .VDD  (VDD),
    //    .VSS  (VSS),
    //    `endif

    //    .CLK  (clk),
    //    .CEN  (1'b1),
    //    .GWEN (1'b0),
    //    .WEN  (8'b0),
    //    .A    ('0),
    //    .D    ('0),
    //    .Q    (sram_0_out)
    //);

    // logic [7:0] sram_1_out;

    //`gf180mcu_xxx_ip_sram__sram512x8m8wm1 sram_1 (
    //    `ifdef USE_POWER_PINS
    //    .VDD  (VDD),
    //    .VSS  (VSS),
    //    `endif

    //    .CLK  (clk),
    //    .CEN  (1'b1),
    //    .GWEN (1'b0),
    //    .WEN  (8'b0),
    //    .A    ('0),
    //    .D    ('0),
    //    .Q    (sram_1_out)
    //);

    // assign bidir_out = count ^ {24'd0, sram_0_out, sram_1_out};
    // Disable pull-up and pull-down on any discrete input pads.
    assign input_pu = '0;
    assign input_pd = '0;

    // Drive the bidir pads as outputs (CMOS buffer, fast slew).
    // assign bidir_oe = '1;
    // assign bidir_cs = '0;
    // assign bidir_sl = '0;
    // assign bidir_ie = ~bidir_oe;
    // assign bidir_pu = '0;
    // assign bidir_pd = '0;





    // ANALOG IO

    // (ANALOG) Readout Pin Definition
    (* keep *) wire analog_readout_input = analog[0];

    // (ANALOG) Output Pin Definition
    (* keep *) wire analog_readout_output, analog_error_x_output, analog_error_y_output;
    assign analog[1] = analog_readout_output;
    assign analog[2] = analog_error_x_output;
    assign analog[3] = analog_error_y_output;



    // DIGITAL IO

    // (DIGITAL Input) SPI Pin Definition
    wire spi_cs_n = bidir_in[0];
    wire spi_sclk = bidir_in[1];
    wire spi_mosi = bidir_in[2];
    wire spi_miso, spi_miso_oe;

    // (DIGITAL Output) Movement (X/Y) Pin Definition
    (* keep *) wire move_en_x, dir_x, move_en_y, dir_y;

    // (DIGITAL Output) MEMS (X/Y) Driver Pin Definition
    (* keep *) wire mems_drv_x, mems_drv_y;

    always_comb begin // Replace top duplicated with bottom
        // Default behavior for the remaining pins [NUM_BIDIR_PADS-1] (CMOS buffer, fast slew).
        bidir_oe  = '1;         // output by default
        bidir_cs  = '0; 
        bidir_sl  = '0; 
        bidir_ie  = ~bidir_oe;  // input on when not output
        bidir_pu  = '0; 
        bidir_pd  = '0; 

        // Override Configuration for Pin 0 (CS_N Input)
        bidir_oe[0] = 1'b0; // Input
        bidir_cs[0] = 1'b1; // Schmitt Trigger
        bidir_ie[0] = 1'b1; // Input buffer ON
        bidir_pu[0] = 1'b1; // Pull-up enabled (prevents accidental activation if line floats)
        bidir_pd[0] = 1'b0; // No pull-down

        // Override Configuration for Pin 1 (SCLK Input)
        bidir_oe[1] = 1'b0; // Input
        bidir_cs[1] = 1'b1; // Schmitt Trigger for external line noise
        bidir_ie[1] = 1'b1; // Input buffer ON
        bidir_pu[1] = 1'b0; // No pull-up
        bidir_pd[1] = 1'b0; // No pull-down

        // Override Configuration for Pin 2 (MOSI Input)
        bidir_oe[2] = 1'b0; // Input
        bidir_cs[2] = 1'b1; // Schmitt Trigger
        bidir_ie[2] = 1'b1; // Input buffer ON
        bidir_pu[2] = 1'b0; // No pull-up
        bidir_pd[2] = 1'b0; // No pull-down

        // Override Configuration for Pin 3 (MISO Dynamic Output)
        bidir_oe[3] = spi_miso_oe; // (from SPI) Dynamic Tristate: Output only when CS_N is active low
        bidir_cs[3] = 1'b0;      // CMOS output threshold
        bidir_ie[3] = 1'b0;      // Input buffer OFF (saves power and blocks feedback noise)
        bidir_sl[3] = 1'b1;      // SLOW slew rate to protect the analog domain from digital noise
        bidir_pu[3] = 1'b0;      // No pull-up
        bidir_pd[3] = 1'b0;      // No pull-down

        // Override Configuration for Pin 4 (move_en_x Output)
        bidir_oe[4] = 1'b1;      // Output by default
        bidir_cs[4] = 1'b0;      // CMOS output threshold
        bidir_ie[4] = 1'b0;      // Input buffer OFF (saves power and blocks feedback noise)
        bidir_sl[4] = 1'b0;      // Fast slew
        bidir_pu[4] = 1'b0;      // No pull-up
        bidir_pd[4] = 1'b0;      // No pull-down

        // Override Configuration for Pin 5 (dir_x Output)
        bidir_oe[5] = 1'b1;      // Output by default
        bidir_cs[5] = 1'b0;      // CMOS output threshold
        bidir_ie[5] = 1'b0;      // Input buffer OFF (saves power and blocks feedback noise)
        bidir_sl[5] = 1'b0;      // Fast slew
        bidir_pu[5] = 1'b0;      // No pull-up
        bidir_pd[5] = 1'b0;      // No pull-down

        // Override Configuration for Pin 6 (move_en_y Output)
        bidir_oe[6] = 1'b1;      // Output by default
        bidir_cs[6] = 1'b0;      // CMOS output threshold
        bidir_ie[6] = 1'b0;      // Input buffer OFF (saves power and blocks feedback noise)
        bidir_sl[6] = 1'b0;      // Fast slew
        bidir_pu[6] = 1'b0;      // No pull-up
        bidir_pd[6] = 1'b0;      // No pull-down

        // Override Configuration for Pin 7 (dir_y Output)
        bidir_oe[7] = 1'b1;      // Output by default
        bidir_cs[7] = 1'b0;      // CMOS output threshold
        bidir_ie[7] = 1'b0;      // Input buffer OFF (saves power and blocks feedback noise)
        bidir_sl[7] = 1'b0;      // Fast slew
        bidir_pu[7] = 1'b0;      // No pull-up
        bidir_pd[7] = 1'b0;      // No pull-down

        // Override Configuration for Pin 8 (mems_drv_x Output)
        bidir_oe[8] = 1'b1;      // Output by default
        bidir_cs[8] = 1'b0;      // CMOS output threshold
        bidir_ie[8] = 1'b0;      // Input buffer OFF (saves power and blocks feedback noise)
        bidir_sl[8] = 1'b0;      // Fast slew
        bidir_pu[8] = 1'b0;      // No pull-up
        bidir_pd[8] = 1'b0;      // No pull-down

        // Override Configuration for Pin 9 (mems_drv_y Output)
        bidir_oe[9] = 1'b1;      // Output by default
        bidir_cs[9] = 1'b0;      // CMOS output threshold
        bidir_ie[9] = 1'b0;      // Input buffer OFF (saves power and blocks feedback noise)
        bidir_sl[9] = 1'b0;      // Fast slew
        bidir_pu[9] = 1'b0;      // No pull-up
        bidir_pd[9] = 1'b0;      // No pull-down



        // Default: counter/SRAM drives all bidir pads (Template Stuff, I dont know what it is about)
        //bidir_out = count ^ {24'd0, sram_0_out, sram_1_out};
        bidir_out = count;  // count matches NUM_BIDIR_PADS (20 bits)



        // Digital IO
        // (DIGITAL Output) SPI Pin Definition
        bidir_out[3] = spi_miso;

        // (DIGITAL Output) Movement (X/Y) Pin Definition
        bidir_out[4] = move_en_x;
        bidir_out[5] = dir_x;
        bidir_out[6] = move_en_y;
        bidir_out[7] = dir_y;

        // (DIGITAL Output) MEMS (X/Y) Driver Pin Definition
        bidir_out[8] = mems_drv_x;
        bidir_out[9] = mems_drv_y;

    end



    // Intermediate Wire
    // ----- SPI → Config/Control Signal -----
    wire [15:0] cfg_f_MEMS_fcw_x, cfg_f_MEMS_fcw_y;
    wire [20:0] cfg_phase0_offset_x, cfg_phase90_offset_x, cfg_phase270_offset_x;
    wire [20:0] cfg_phase0_offset_y, cfg_phase90_offset_y, cfg_phase270_offset_y;
    wire        boot_complete, cfg_done, phase_offset_imported;

    // Soft reset: SPI drives an active high one clk pulse, the datapath
    // modules take active low, so invert it here (single driver each).
    wire        soft_rst;
    wire        soft_rst_n = ~soft_rst;

    // ----- Amplitude Ratio Adjuster - not implemented this tapeout -----
    // wire        amp_ratio_en, amp_update_done, write_amp_ratio_en;

    // ----- Wave Controller → SPI (Calibration) -----
    wire [7:0]  delay_wave_cycle_x, delay_wave_cycle_y;
    wire [20:0] raw_edge1_x, raw_edge2_x, raw_edge3_x;
    wire [20:0] raw_edge1_y, raw_edge2_y, raw_edge3_y;
    wire        cal_dir_x, cal_dir_y;
    wire [20:0] cal_phase0_offset_x, cal_phase90_offset_x, cal_phase270_offset_x;
    wire [20:0] cal_phase0_offset_y, cal_phase90_offset_y, cal_phase270_offset_y;

    // ----- Signal Processor Debug → SPI -----
    wire        latch_error_x, latch_error_y;
    wire        jitter_flag_x, jitter_flag_y;
    wire [1:0]  phase_state_x, phase_state_y;
    wire [3:0]  votes_in_phase_x, votes_out_phase_x;
    wire [3:0]  votes_in_phase_y, votes_out_phase_y;

    // ----- State Machine Status → SPI -----
    wire [2:0]  state_o;

    // ----- Signal Processor → Control Signal -----
    wire        move_en_x_internal, move_en_y_internal;
    assign move_en_x = move_en_x_internal && (state_o == 3'd4);
    assign move_en_y = move_en_y_internal && (state_o == 3'd4);

    // ----- Control Signal → State Machine -----
    wire        cal_done_x, cal_done_y;
    wire        cal_timeout_x, cal_timeout_y;
    wire        cal_start, cal_done, cal_timeout, read_en;
    // AND on done: leave calibration only when BOTH axes have finished.
    // OR on timeout: if either axis gives up, calibration is over.
    assign cal_done    = cal_done_x    & cal_done_y;
    assign cal_timeout = cal_timeout_x | cal_timeout_y;

    // ----- Comparator → Wave controller -----
    (* keep *) wire comp_x, comp_y;

    // ----- Wave controller ↔ signal processor handshake -----
    wire        latch_phase90_x, latch_phase270_x;
    wire        latch_phase90_ack_x, latch_phase270_ack_x;
    wire        latch_phase90_y, latch_phase270_y;
    wire        latch_phase90_ack_y, latch_phase270_ack_y;

    // ----- Wave controller → Wave Mixer -----
    wire        ref_wave_x, ref_wave_y;





    (* keep_hierarchy *)
     analog_block analog_block_inst (
        .clk                   (clk),
        .read_en               (read_en),
        .comp_x                (comp_x),
        .comp_y                (comp_y),
        .ref_wave_x            (ref_wave_x),
        .ref_wave_y            (ref_wave_y),
        .analog_readout_input  (analog_readout_input),
        .analog_readout_output (analog_readout_output),
        .analog_error_x_output (analog_error_x_output),
        .analog_error_y_output (analog_error_y_output)
    );



    // Digital
    // SPI
    (* keep_hierarchy *)
    spi_regs spi_regs_inst (
        .clk(clk), .rst_n(rst_n),
        .spi_cs_n(spi_cs_n), .spi_sclk(spi_sclk), .spi_mosi(spi_mosi),
        .spi_miso(spi_miso), .spi_miso_oe(spi_miso_oe),
        .cfg_f_MEMS_fcw_x(cfg_f_MEMS_fcw_x), .cfg_f_MEMS_fcw_y(cfg_f_MEMS_fcw_y),
        .cfg_phase0_offset_x(cfg_phase0_offset_x), .cfg_phase90_offset_x(cfg_phase90_offset_x), .cfg_phase270_offset_x(cfg_phase270_offset_x),
        .cfg_phase0_offset_y(cfg_phase0_offset_y), .cfg_phase90_offset_y(cfg_phase90_offset_y), .cfg_phase270_offset_y(cfg_phase270_offset_y),
        .boot_complete(boot_complete), .cfg_done(cfg_done), .phase_offset_imported(phase_offset_imported),
        .soft_rst(soft_rst),
        .delay_wave_cycle_x(delay_wave_cycle_x), .delay_wave_cycle_y(delay_wave_cycle_y),
        .raw_edge1_x(raw_edge1_x), .raw_edge2_x(raw_edge2_x), .raw_edge3_x(raw_edge3_x),
        .raw_edge1_y(raw_edge1_y), .raw_edge2_y(raw_edge2_y), .raw_edge3_y(raw_edge3_y),
        .cal_dir_x(cal_dir_x), .cal_dir_y(cal_dir_y),
        .cal_phase0_offset_x(cal_phase0_offset_x), .cal_phase90_offset_x(cal_phase90_offset_x), .cal_phase270_offset_x(cal_phase270_offset_x),
        .cal_phase0_offset_y(cal_phase0_offset_y), .cal_phase90_offset_y(cal_phase90_offset_y), .cal_phase270_offset_y(cal_phase270_offset_y),
        .cal_done_x(cal_done_x), .cal_done_y(cal_done_y),
        .cal_timeout_x(cal_timeout_x), .cal_timeout_y(cal_timeout_y),
        .latch_error_x(latch_error_x), .latch_error_y(latch_error_y),
        .jitter_flag_x(jitter_flag_x), .jitter_flag_y(jitter_flag_y),
        .phase_state_x(phase_state_x), .phase_state_y(phase_state_y),
        .votes_in_phase_x(votes_in_phase_x), .votes_out_phase_x(votes_out_phase_x),
        .votes_in_phase_y(votes_in_phase_y), .votes_out_phase_y(votes_out_phase_y),
        .state_o(state_o)
    );

    // State Machine
    (* keep_hierarchy *)
    state_machine state_machine_inst (
        .clk(clk), .rst_n(rst_n),
        .boot_complete(boot_complete), .cfg_done(cfg_done), .phase_offset_imported(phase_offset_imported),
        .cal_start(cal_start), .cal_done(cal_done), .cal_timeout(cal_timeout),
        .read_en(read_en),
        .soft_rst(soft_rst),
        .state_o(state_o)
    );

    // Wave Controller (X/Y)
    (* keep_hierarchy *)
    wave_controller wave_controller_x_inst (
        .clk(clk), .rst_n(rst_n), .soft_rst_n(soft_rst_n),
        .cfg_f_MEMS_fcw(cfg_f_MEMS_fcw_x),
        .cfg_phase0_offset(cfg_phase0_offset_x), .cfg_phase90_offset(cfg_phase90_offset_x), .cfg_phase270_offset(cfg_phase270_offset_x),
        .cfg_done(cfg_done), .cal_done(cal_done_x), .cal_timeout(cal_timeout_x),
        .cal_start(cal_start),
        .comp(comp_x),
        .latch_phase90(latch_phase90_x), .latch_phase270(latch_phase270_x),
        .latch_phase90_ack(latch_phase90_ack_x), .latch_phase270_ack(latch_phase270_ack_x),
        .mems_drv(mems_drv_x), .ref_wave(ref_wave_x),
        .delay_wave_cycle(delay_wave_cycle_x),
        .raw_edge1(raw_edge1_x), .raw_edge2(raw_edge2_x), .raw_edge3(raw_edge3_x),
        .cal_dir(cal_dir_x),
        .cal_phase0_offset(cal_phase0_offset_x), .cal_phase90_offset(cal_phase90_offset_x), .cal_phase270_offset(cal_phase270_offset_x),
        .latch_error(latch_error_x)
    );

    (* keep_hierarchy *)
    wave_controller wave_controller_y_inst (
        .clk(clk), .rst_n(rst_n), .soft_rst_n(soft_rst_n),
        .cfg_f_MEMS_fcw(cfg_f_MEMS_fcw_y),
        .cfg_phase0_offset(cfg_phase0_offset_y), .cfg_phase90_offset(cfg_phase90_offset_y), .cfg_phase270_offset(cfg_phase270_offset_y),
        .cfg_done(cfg_done), .cal_done(cal_done_y), .cal_timeout(cal_timeout_y),
        .cal_start(cal_start & cal_done_x),   // sequential cal: Y starts only after X's cal_done
        .comp(comp_y),
        .latch_phase90(latch_phase90_y), .latch_phase270(latch_phase270_y),
        .latch_phase90_ack(latch_phase90_ack_y), .latch_phase270_ack(latch_phase270_ack_y),
        .mems_drv(mems_drv_y), .ref_wave(ref_wave_y),
        .delay_wave_cycle(delay_wave_cycle_y),
        .raw_edge1(raw_edge1_y), .raw_edge2(raw_edge2_y), .raw_edge3(raw_edge3_y),
        .cal_dir(cal_dir_y),
        .cal_phase0_offset(cal_phase0_offset_y), .cal_phase90_offset(cal_phase90_offset_y), .cal_phase270_offset(cal_phase270_offset_y),
        .latch_error(latch_error_y)
    );

    // Signal Processor (X/Y)
    (* keep_hierarchy *)
    signal_processor signal_processor_x_inst (
        .clk(clk), .rst_n(rst_n), .soft_rst_n(soft_rst_n),
        .comp_raw(comp_x),
        .latch_phase90(latch_phase90_x), .latch_phase270(latch_phase270_x),
        .latch_phase90_ack(latch_phase90_ack_x), .latch_phase270_ack(latch_phase270_ack_x),
        .dir(dir_x), .move_en(move_en_x_internal),
        .jitter_flag(jitter_flag_x),
        .phase_state(phase_state_x),
        .votes_in_phase(votes_in_phase_x), .votes_out_phase(votes_out_phase_x)    
    );

    (* keep_hierarchy *)
    signal_processor signal_processor_y_inst (
        .clk(clk), .rst_n(rst_n), .soft_rst_n(soft_rst_n),
        .comp_raw(comp_y),
        .latch_phase90(latch_phase90_y), .latch_phase270(latch_phase270_y),
        .latch_phase90_ack(latch_phase90_ack_y), .latch_phase270_ack(latch_phase270_ack_y),
        .dir(dir_y), .move_en(move_en_y_internal),
        .jitter_flag(jitter_flag_y),
        .phase_state(phase_state_y),
        .votes_in_phase(votes_in_phase_y), .votes_out_phase(votes_out_phase_y)  
    );


endmodule

`default_nettype wire
