llhtimlam/Probton/(commit log)

2025-11-20 feat: pin the PDK version
2025-11-21 fix: reduce PDN macro halo
    [config.yaml]
2025-11-26 feat: Implement different slot sizes
    slot_1x1, slot_0p5x1, slot_1x0p5 and slot_0p5x0p5
2025-12-01 fix: keep hierarchy when using slang
    [config.yaml]
2025-12-01 fix: add flatglob for sram128x8
    [config.yaml]
2025-12-04 feat: enable antenna checks, update PDK to 1.3.1
2025-12-10 fix: keep fill as dummy metal, but ignore rules for Metal2
    [config.yaml]
2025-12-11 feat: do not error on magic DRC violations
    [config.yaml]
2026-03-11 chore: update to LibreLane dev (#55)
    * chore: update to LibreLane dev
    * chore: update PDK, save to final folder
    * fix: pin KLayout to 0.30.4
    [config.yaml]
2026-04-24 Add chipathon-2026 workshop padring slot
    Mirrors JuanMoya's workshop_padring.cfg (standalone padring tool) as
    a native LibreLane slot for the chipathon 2026 workshop.
    Die 2935x2935 um, 60 analog (asig_5p0) + 20 bidir (bi_24t) + 4 dvdd +
    4 dvss + clk_pad + rst_n_pad + one input_pad to sidestep a Yosys
    zero-width-vector quirk. PAD_NORTH / PAD_WEST are reversed vs JuanMoya's
    listing because LibreLane reads pad lists clockwise from the SW corner.
    - src/slot_defines.svh: SLOT_WORKSHOP block (NUM_INPUT=1, BIDIR=20, ANALOG=60)
    - src/chip_core.sv: 20-bit counter driving bidir pads, analog floating
    - librelane/slots/slot_workshop.yaml: new slot, 2935x2935 / CORE 2051x2051
    - librelane/config.yaml: d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
    [chip_core.sv, config.yaml]
2026-04-24 Add chipathon-2026 fork docs and credits
    - README.md rewritten to centre on the chipathon-2026 workshop slot,
    with upstream + JuanMoya credits prominent.
    - NOTICE: Apache-2.0 third-party attribution for Leo Moser (upstream
    template) and Juan Moya (reference pad layout).
    - CREDITS.md: per-artifact attribution, including which parts of the
    workshop slot came from JuanMoya's padring_gf180 and which are
    LibreLane-specific adaptations (PAD_NORTH/WEST reversal, bi_24t
    vs bi_t, dvdd/dvss flavour, Yosys zero-width workaround).
    - AUTHORS.md: keep Leo Moser, add JuanMoya pointer + fork author.
    - docs/workshop-slot-spec.md: full pad-by-pad mapping (die, cells,
    indices, edge ordering, 'why N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
2026-04-24 Add tooling and walkthrough notebook
    - scripts/verify_workshop_slot.sh: pragmatic end-to-end check that
    byte-compares the six tracked files against a known-good reference
    tree (the 2026-04-23 DRC/LVS/antenna/STA-clean build). No DRC
    re-run; the reference is the source of truth for 'clean'.
    - scripts/run_native.sh: thin wrapper around nix-shell +
    make clone-pdk + SLOT=workshop make librelane.
    - scripts/run_docker_iic.sh: launcher for hpretl/iic-osic-tools with
    this repo mounted at /workspace, X11 forwarding, runs interactive
    shell or a one-shot command.
    - examples/rtl2gds_chipathon_padring.ipynb: historical walkthrough of
    how the workshop slot was originally constructed. Copied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
2026-06-13 Updated information
    [Photodetector_Sourcing_Options.xlsx, XY_Stage_Sourcing_Options.xlsx]
2026-06-28 initialize io pin in chip_core.sv
2026-07-01 Added spi protocol
2026-07-05 Schematic Review
    [Mixer.sch]
2026-07-11 Completed Calibration and Wave Controller, missing NCO wave generator
    [spi.sv, wave_controller.sv]
2026-07-11 Completed Calibration and Wave Controller, missing NCO wave generator, f_clk 5MHz
    [spi.sv, wave_controller.sv]
2026-07-12 Wave Controller update with new Comparator logic (2->1), baseline 3.3V/2
2026-07-12 Added Wave controller/signal processor handshake and error report
    [spi.sv, wave_controller.sv]
2026-07-13 Added calibration and MEMS wave controller; Added TB and LUT for MEMS wave
2026-07-15 Minor fix on wave controller, ready for review
    [wave_controller.sv, wave_controller_tb.py]
2026-07-15 Fixed state_machine.sv and Added Progress Tracker and README.md Instruction for Digital Simulation
    [state_machine.sv]
2026-07-16 Added wave_controller_calibration_tb.py and implemented soft_rst_n, Missing latch test for main readout loop
    [wave_controller.sv, wave_controller_calibration_tb.py]
2026-07-18 added comparator and mixer designs and sims
    [5tota.sch, 5tota_tb.sch, gilbert_mixer.sch, inv.sch, mixer_tb.sch, rslatch.sch, strongArmLatch.sch, tb_comparator_slowmo.sch]
2026-07-18 Changed spi.sv according to spi_apb.sv
2026-07-19 Modified spi and spi_tb
2026-07-20 added ota and bandpass filter schematics and testbench
    [Gmc_bp.sch, ota5t_en.sch, ota5t_en_tb.sch]
2026-07-20 Update README.md on GF180 pdk and organized anaolg/schematic, missing BPF
    [5tota.sch, 5tota_tb.sch, 5totawithfeedbackresistor-4.sch, Gmc_bp.sch, Mixer.sch, gilbert_mixer.sch, inv.sch, mixer_tb.sch]
2026-07-20 Added .gtkw in cocotb/sim_build and fixed spi_tb.py
    [cocotb_iverilog_dump.v, spi_tb.py, wave_controller_calibration_tb.py, wave_controller_tb.py]
2026-07-21 Upload Presentation Slide for Simulation Review SPI tb failed missing bpf for proceed to integration
2026-07-22 analog file all uploaded, not following template format
    [5totawithfeedbackresistor-4.sch, Gmc_bp.sch, Transimpedance_AmplifierwBandFilter.sch, ota5t_en.sch, ota5t_en_tb.sch, ota_5t.sch, tb_ota_5t.sch]
2026-07-25 modified spi f
2026-07-25 added spi readme
2026-07-28 Fixed mixer and 5t_ota testbenches and xschem graphs. Had to remove mixer_tb raw simulation file since it is 1Gb and too big.
    [5tota.sch, 5tota_tb.sch, mixer_tb.sch]
2026-07-29 added simulation files for comparator testbenches
    [tb_comparator_slowmo.sch, tb_speedtest.sch]
2026-08-02 Completed chip_core.sv, ready to harden, minor issue with spi report and soft rst_n
2026-08-03 Ran librelane but fail, log in librelane\runs\RUN_2026-08-03_00-34-52
    [analog_macro.sv, chip_core.sv, wave_controller.sv]
2026-08-03 Added librelane log, Ran librelane but fail, log in librelane\runs\RUN_2026-08-03_00-34-52
    [chip_top__max_ff_n40C_5v50.sdf, chip_top__max_ss_125C_4v50.sdf, chip_top__max_tt_025C_5v00.sdf, chip_top__min_ff_n40C_5v50.sdf, chip_top__min_ss_125C_4v50.sdf, chip_top__min_tt_025C_5v00.sdf, chip_top__nom_ff_n40C_5v50.sdf, chip_top__nom_ss_125C_4v50.sdf]
2026-08-03 Added RTL to GDS for digital domain without padframe. Updated chip_core.sv and fix spi and state machine soft_rst_n
    [chip_core__max_ff_n40C_5v50.sdf, chip_core__max_ss_125C_4v50.sdf, chip_core__max_tt_025C_5v00.sdf, chip_core__min_ff_n40C_5v50.sdf, chip_core__min_ss_125C_4v50.sdf, chip_core__min_tt_025C_5v00.sdf, chip_core__nom_ff_n40C_5v50.sdf, chip_core__nom_ss_125C_4v50.sdf]
2026-08-06 made integrator along with testbench and updated spi testbench
2026-08-06 added chip core tb and updated spi tb
2026-08-06 Partially fixed chip_core.tb, need detail implementation of wave controller and signal processor tb and test on timing
    [chip_core_tb.py, cocotb_iverilog_dump.v]
2026-08-07 Organized gds folder and added unfinished 5t-ota layout to analog/schematic/mixer
2026-08-07 Fixed soft_rst and updated testbench
    [chip_core.sv, chip_core_tb.py, spi.sv, spi_tb.py, state_machine.sv]
2026-08-08 Added low pass filter in analog/schematic/2_mixer, need review before layout
    [low_pass_filter_tb.sch, mixer_tb_without_lpf.sch]
2026-08-08 fixed merge conflict in chip_core_yb.py, need to remove change amp ratio logic
    [chip_core_tb.py]
2026-08-08 fixed comparator and rslatch gds
    [low_pass_filter_tb.sch, mixer_tb.sch]
2026-08-08 fix naming (spice have problem with starting name with number) and ran lvs partially for ota_5t in analog/schematic/2_mixer/layout
    [low_pass_filter_tb.sch, mixer_tb.sch, mixer_tb_without_lpf.sch, ota_5t.sch, ota_5t_tb.sch]
2026-08-09 attempt to generate area reserve for analog and fail
    [chip_core__max_ss_125C_3v00.sdf, chip_core__min_ff_n40C_3v60.sdf, chip_core__nom_tt_025C_3v30.sdf, pin_order.cfg, placement.cfg]
2026-08-09 obstruction test run
    [chip_core__max_ff_n40C_5v50.sdf, chip_core__max_ss_125C_3v00.sdf, chip_core__max_ss_125C_4v50.sdf, chip_core__max_tt_025C_5v00.sdf, chip_core__min_ff_n40C_3v60.sdf, chip_core__min_ff_n40C_5v50.sdf, chip_core__min_ss_125C_4v50.sdf, chip_core__min_tt_025C_5v00.sdf]
2026-08-09 minimum run with macro, with and without IO_PIN_ORDER_CFG
    [chip_core__max_ss_125C_3v00.sdf, chip_core__min_ff_n40C_3v60.sdf, chip_core__nom_tt_025C_3v30.sdf, net-VDD.csv, net-VSS.csv, pin_order.cfg, placement.cfg, wire_lengths.csv]
2026-08-09 minimum run with macro, pass without IO_PIN_ORDER_CFG, fail with IO_PIN_ORDER_CFG
    [chip_core__max_ss_125C_3v00.sdf, chip_core__min_ff_n40C_3v60.sdf, chip_core__nom_tt_025C_3v30.sdf, net-VDD.csv, net-VSS.csv, wire_lengths.csv]
2026-08-10 Completed digital_domain and add digital submodule for gds file
    [chip_core__max_ff_n40C_5v50.sdf, chip_core__max_ss_125C_3v00.sdf, chip_core__max_ss_125C_4v50.sdf, chip_core__max_tt_025C_5v00.sdf, chip_core__min_ff_n40C_3v60.sdf, chip_core__min_ff_n40C_5v50.sdf, chip_core__min_ss_125C_4v50.sdf, chip_core__min_tt_025C_5v00.sdf]
2026-08-10 checkpoint for digital_domain, success wrap with macro, need optimization
    [net-VDD.csv, net-VSS.csv, ota_5t_lvs.sch, pin_order.cfg, placement.cfg, wire_lengths.csv, wrapper__max_ss_125C_3v00.sdf, wrapper__min_ff_n40C_3v60.sdf]
2026-08-10 Completed pre-integration, 7 Density and ESD DRC Violation for pre-integration
    [chip_core__max_ff_n40C_5v50.sdf, chip_core__max_ss_125C_3v00.sdf, chip_core__max_ss_125C_4v50.sdf, chip_core__max_tt_025C_5v00.sdf, chip_core__min_ff_n40C_3v60.sdf, chip_core__min_ff_n40C_5v50.sdf, chip_core__min_ss_125C_4v50.sdf, chip_core__min_tt_025C_5v00.sdf]
2026-08-10 Updated readout
    [B18_BPF_OTA.sch, B18_BPF_OTA_tb.sch, B18_TIA_OTA.sch, B18_TIA_OTA_tb.sch, B18_readout_tb.sch, Gmc_bp.sch, mixer_tb.sch, ota5t_en.sch]
2026-08-10 Integrated schematic and added charts to README.md
    [B18_Probton.sch, B18_Probton_mixer&comp.sch, B18_Probton_mixer&comp_xy.sch]
2026-08-10 Fix pathing for analog/schematic/1_readout
    [B18_BPF_OTA_tb.sch, B18_TIA_OTA_tb.sch, B18_readout_tb.sch]
2026-08-11 Fixed pre-integration gds and finished analog_schematic
    [B18_Probton.sch, B18_Probton_mixer&comp.sch, B18_Probton_mixer&comp_xy.sch, B18_Probton_readout.sch]
2026-08-11 Fixed pre-integration gds and fixed analog_schematic
    [B18_Probton.sch, B18_Probton_readout.sch]
2026-08-11 fixed analog_schematic
    [B18_Probton.sch, B18_Probton_readout.sch]
2026-08-11 fixed analog_schematics, waiting for readout gds file for layout review
    [B18_Probton.sch, B18_Probton_readout.sch]
2026-08-11 Layout Review: Missing Analog Readout Layout
    [B18_Probton.sch, mixer_tb.sch]
2026-08-11 Updated filter OTA w/o enable switch
    [B18_BPF_OTA.sch, B18_BPF_OTA_tb.sch, B18_readout_tb.sch]
2026-08-13 inverter and rslatch LVS clean, strongarmlatch LVS errors still debugging
    [comparator.sch, inv.sch, rslatch.sch, strongArmLatch.sch, tb_speedtest.sch]
2026-08-13 Added B18_Probton_tb.sch and mixer ota_5t LVS clean
    [B18_Probton_tb.sch, ota_5t.sch, rslatch.sch]
2026-08-13 fixed inverter.gds and update B18_Probton.sch and layout review slide
    [B18_Probton.sch, B18_Probton_mixer&comp.sch, B18_Probton_mixer&comp_xy.sch, B18_Probton_readout.sch, B18_Probton_tb.sch]
2026-08-14 fixed LVS of comparator completely
    [comparator.sch, strongArmLatch.sch]
2026-08-14 started working through the mixer LVS
    [gilbert_mixer.sch, mixer_tb.sch]
2026-08-14 Layout Review Updated
    [mixer_tb.sch, mixer_tb_with lpf.sch]
2026-08-14 DRC & LVS clean ota, DRC clean TIA with some errors left in LVS
    [B18_TIA.sch]
2026-08-14 finished mixer LVS clean
    [gilbert_mixer.sch]
2026-08-16 Preparing for padring integration
    [ota_5t_lvs.sch]
2026-08-17 Layout Review Updated for padframe def file preparation
    [net-VDD.csv, net-VSS.csv, pin_order.cfg, placement.cfg, wire_lengths.csv, wrapper__max_ss_125C_3v00.sdf, wrapper__min_ff_n40C_3v60.sdf, wrapper__nom_tt_025C_3v30.sdf]
2026-08-19 trying to fix the readout chain slope detector and comparison
    [asc_NAND.sch, asc_XNOR.sch, dff_rising.sch, dffrs.sch, inv1u05u.sch, mixer_tb.sch, nand3.sch, pass1u05u.sch]
2026-08-20 Deleted bpf, waiting for full simulation loop
    [B18_Probton_tb_with_bpf.sch, B18_readout_tb.sch]
2026-08-20 quick and dirty sim for wave mixer
    [full_sim_quickdirty_tb.sch]
2026-08-20 added 2 stage op amp and tested differentiator
    [mixer_tb.sch, opamp_n_input.sch, opamp_n_tb.sch, ota_5t_tb.sch, slopedetector.sch]
2026-08-20 quick and dirty sim for wave mixer only
    [wavemixer_quickdirty_tb.sch]
2026-08-20 testing wave mixer for full loop
    [wavemixer_quickdirty_pwm_tb.sch, wavemixer_quickdirty_sine_tb.sch]
2026-08-24 Fix ref wave issue
    [cocotb_iverilog_dump.v, wave_controller.sv, wave_controller_tb.py]
2026-08-24 Add separate calibration process for X and Y
2026-08-24 Ready for def file generation
    [digital_domain__max_ss_125C_3v00.sdf, digital_domain__min_ff_n40C_3v60.sdf, digital_domain__nom_tt_025C_3v30.sdf, net-VDD.csv, net-VSS.csv, pin_order.cfg, placement.cfg, wire_lengths.csv]
2026-08-25 Change power and ground pin in info.yaml
2026-08-25 Implement feedback on move_en and change pin type to bidirectional
    [net-VDD.csv, net-VSS.csv, wire_lengths.csv, wrapper__max_ss_125C_3v00.sdf, wrapper__min_ff_n40C_3v60.sdf, wrapper__nom_tt_025C_3v30.sdf]
2026-08-26 Setting before with def librelane generation
    [B18_A_padring.cfg]
2026-08-26 Layout integration completed, ready for top level integration
    [net-VDD.csv, net-VSS.csv, wire_lengths.csv, wrapper_top__max_ss_125C_3v00.sdf, wrapper_top__min_ff_n40C_3v60.sdf, wrapper_top__nom_tt_025C_3v30.sdf]
2026-08-29 Layout integration completed, ready for mpw top level integration
    [B18_Probton__max_ss_125C_3v00.sdf, B18_Probton__min_ff_n40C_3v60.sdf, B18_Probton__nom_tt_025C_3v30.sdf, net-VDD.csv, net-VSS.csv, wrapper_top__max_ss_125C_3v00.sdf, wrapper_top__min_ff_n40C_3v60.sdf, wrapper_top__nom_tt_025C_3v30.sdf]
2026-09-01 Updated with mpw and ran drc check, m5 bond pad and m2 width violated
    [SSCS_2026_01_pins.csv]
2026-09-02 Fixed DRC issue for power pin for mpw
2026-09-06 Final Submission for LVS Tapeout Check
    [B18_Probton__max_ss_125C_3v00.sdf, B18_Probton__min_ff_n40C_3v60.sdf, B18_Probton__nom_tt_025C_3v30.sdf, SSCS_2026_01_pins.csv]
